khanji254/FYP_2025_Recovery/project_proposal/data/README.txt

DATA FOLDER
===========

Store research-related data and supporting materials:
- Survey data
- Experimental results
- Datasets (CSV, Excel files)
- Raw data files
- Analysis results
- Supporting documents

This folder helps keep your project organized and separate from the LaTeX source files.
