khanji254/FYP_2025_Recovery/interim_report/Files/Appendices.tex

% ============================================================
%  APPENDICES -- N4 Recovery System Final Report
% ============================================================
\appendix

% ------------------------------------------------------------
\section{CAD Drawings with Title Blocks}
\label{app:cad}

The engineering drawings below were produced in SolidWorks and include the
institution title block, part number, material specification, and revision level
required for fabrication. All dimensions are in millimetres.

\begin{figure}[H]
\centering

\caption{18650 battery case cover -- 2D manufacturing drawing with title block}
\label{fig:app_cad_case_cover}
\end{figure}

\begin{figure}[H]
\centering

\caption{18650 battery case body -- 2D manufacturing drawing with title block}
\label{fig:app_cad_case_body}
\end{figure}

\begin{figure}[H]
\centering

\caption{Edge battery support bracket -- 2D manufacturing drawing with title block}
\label{fig:app_cad_edge_batt}
\end{figure}

\begin{figure}[H]
\centering

\caption{Mid battery support bracket -- 2D manufacturing drawing with title block}
\label{fig:app_cad_mid_batt}
\end{figure}

% ------------------------------------------------------------
\section{Flight Computer and Base Station Circuit Design Reference}
\label{app:fc_schematic}

Figures~\ref{fig:app_fc_easyeda} and~\ref{fig:app_bs_easyeda} present the complete
EasyEDA schematics used as design references for PCB layout, component placement,
and trace routing.

\begin{figure}[H]
\centering

\caption{Flight computer EasyEDA schematic with ESP32, XBee, MOSFETs, and
  ADS1115 monitoring circuit.}
\label{fig:app_fc_easyeda}
\end{figure}

\begin{figure}[H]
\centering

\caption{Base station EasyEDA schematic with XBee UART and Bluetooth interface.}
\label{fig:app_bs_easyeda}
\end{figure}

% ------------------------------------------------------------
\section{Project Budget}
\label{app:budget}

\begin{table}[H]
\centering
\caption{Project Budget Breakdown}
\small
\begin{tabular}{@{}p{5.5cm}|c|c|p{2cm}|c@{}}
\toprule
\rowcolor{gray!22}\textbf{Item} & \textbf{Qty} & \textbf{Unit Cost (KES)} & \textbf{Total (KES)} & \textbf{Status} \\ \midrule
ESP32-WROOM-32              & 2  & 1{,}800 & 3{,}600  & Received    \\
XBee-PRO 900HP              & 2  & 4{,}500 & 9{,}000  & Received    \\
4S Lithium-ion batteries (30{,}000\,mAh) & 4 & 500 & 2{,}000 & Received \\
BMS Board (4S)              & 3  & 650     & 1{,}950  & Received    \\
IRLZ44N MOSFET              & 10 & 45      & 450      & Received    \\
Nichrome Wire (10\,m)       & 1  & 500     & 500      & Received    \\
PCB Fabrication (5\,pcs)    & 1  & 4{,}500 & 4{,}500  & Fabricated  \\
PCB Components (R, C, etc.) & 1  & 2{,}000 & 2{,}000  & Partial     \\
PETG Filament (1\,kg)       & 1  & 1{,}800 & 1{,}800  & Received    \\
Crimson Powder (100\,g)     & 1  & 500     & 500      & Pending     \\
Connectors (XT60, JST, etc.)& 1  & 1{,}200 & 1{,}200  & Received    \\
Fasteners and Hardware      & 1  & 800     & 800      & Partial     \\
Miscellaneous               & 1  & 1{,}500 & 1{,}500  & ---         \\ \midrule
\multicolumn{2}{r|}{\textbf{Total Estimated Cost:}} & & \textbf{29{,}800} & --- \\ \bottomrule
\end{tabular}
\end{table}

% ------------------------------------------------------------
\section{Production Plan}
\label{app:production_plan}

Table~\ref{tab:production_plan} presents the Semester~2 production plan for
the N-4 recovery system, covering all fabrication, integration, testing, and
documentation activities from March 2026 to June 2026.

\begin{longtable}{p{1cm}p{4.5cm}p{3cm}p{2.5cm}p{2.5cm}p{1.5cm}}
  \caption{Production Plan --- Final Year Project 2025/2026 (Semester 2: March--June 2026)}
  \label{tab:production_plan}\\
  \toprule
  \textbf{Wk} & \textbf{Tasks / Activities} & \textbf{Materials Required} & \textbf{Special Equipment} & \textbf{Sequential / Concurrent} & \textbf{Status}\\
  \midrule
  \endfirsthead
  \multicolumn{6}{l}{\small\textit{(Table~\ref{tab:production_plan} continued)}}\\
  \toprule
  \textbf{Wk} & \textbf{Tasks / Activities} & \textbf{Materials Required} & \textbf{Special Equipment} & \textbf{Sequential / Concurrent} & \textbf{Status}\\
  \midrule
  \endhead
  \midrule
  \multicolumn{6}{r}{\small\textit{Continued on next page}}\\
  \endfoot
  \bottomrule
  \endlastfoot

  1 &
  \textbf{1.\ FC Circuit Update:} Review FC PCB; source replacement components; re-etch board; re-solder and retest.
  \textbf{2.\ Software --- Battery/Chute Monitoring:} Merge ADS1115 monitoring FreeRTOS task into main FC firmware; confirm 14.9\,V nominal detection; confirm launch-inhibit triggers at $<$14.0\,V. &
  PCB copper clad; HCl + H$_2$O$_2$; solder, flux &
  Laptop + serial monitor; soldering iron; multimeter &
  Circuit update concurrent with SW integration &
  Done\\[4pt]

  2 &
  \textbf{1.\ 3D Printing --- FC Sled Holder:} Slice in Prusa Slicer (PETG, 0.2\,mm layer, 40\% infill); print; test-fit with FC PCB and brass column mounts.
  \textbf{2.\ Base Station Circuit --- Soldering:} Transfer schematic to perfboard; solder all components; test power rails and XBee UART. &
  PETG filament; perfboard; solder, flux; header pins &
  Prusa 3D printer; Prusa Slicer; callipers; soldering iron; multimeter; laptop &
  FC sled print after printer available; base station soldering concurrent &
  Done\\[4pt]

  3 &
  \textbf{1.\ Base Station 3D Print and Housing.}
  \textbf{2.\ Ejection Caps Reprint:} Revised geometry; test-fit nichrome wire and seal.
  \textbf{3.\ Dual Deployment Pop Test:} Safety clearance; load caps; trigger drogue at 70\% PWM; trigger main at 70\% PWM; confirm sequence; iterate if needed. &
  PETG filament; perfboard; solder; black powder; nichrome wire; all-weather container &
  Prusa 3D printer; soldering iron; multimeter; laptop; safety PPE; fire extinguisher &
  Sled print + BS solder concurrent; pop test after cap fit confirmed &
  Done\\[4pt]

  4 &
  \textbf{1.\ Full Avionics Integration --- Bench Test:} Mount FC PCB into PETG sled; connect battery, XBee, and deployment circuit; run FreeRTOS firmware; confirm launch inhibit, continuity detection, and fire logic.
  \textbf{2.\ Base Station Final Assembly.} &
  4S 18650 battery pack; full avionics assembly &
  Laptop + serial monitor; multimeter; soldering iron &
  Bench integration after FC sled + SW done; BS assembly concurrent &
  Done\\[4pt]

  5 &
  \textbf{Dual Deployment Pop Test} (repeat): Safety clearance; trigger drogue at 70\% PWM; trigger main at 70\% PWM; confirm sequence. &
  4S 18650 battery pack; full avionics assembly &
  Laptop + serial monitor; multimeter; soldering iron &
  BS assembly concurrent with bench integration &
  Done\\[4pt]

  6 &
  \textbf{Dual Deployment Pop Test} (verification): Confirm drogue and main fire at 70\% PWM; record results. &
  4S 18650 battery pack; full avionics assembly &
  Laptop + serial monitor; multimeter; soldering iron &
  After all bench integration passes &
  Done\\[4pt]

  7 &
  \textbf{1.\ XBee Range Test (Field):} Set up FC transmitter at ground level; walk base station to 1\,km, 3\,km, 5\,km; record RSSI vs.\ distance via XCTU; validate $\geq$5\,km link margin.
  \textbf{2.\ System Integration Refinement.}
  \textbf{3.\ Report \& Documentation Update.} &
  Both XBee modules; laptops; transport &
  Laptop + XCTU software &
  Range test after full bench integration; documentation concurrent &
  Done\\[4pt]

  8 &
  \textbf{1.\ Drone Test (Simulated Flight):} Mount integrated avionics onto drone; tethered low-altitude flight; verify XBee telemetry active during flight; confirm apogee detection and deployment sequence logic; record all telemetry.
  \textbf{2.\ Pre-Launch System Validation.} &
  Full avionics assembly; drone platform; tether line &
  Laptop + serial monitor; multimeter; drone &
  Drone test after Wk 7 refinement; system validation concurrent &
  Incomplete\\[4pt]

  9 &
  \textbf{1.\ Demonstration:} Prepare demonstration script and safety checklist; conduct supervised ground demonstration; document results.
  \textbf{2.\ Final Report:} Write Chapter 4 (fabrication, test results, discussion); write Chapter 5 (conclusions); compile appendices; supervisor review and submission.
  \textbf{3.\ Final Presentation:} Prepare and rehearse final slide deck; deliver to panel. &
  Full system assembly; test fixtures &
  Laptop; camera/recorder &
  Demonstration after system validation sign-off; final report concurrent; presentation concurrent with report &
  Pending\\
\end{longtable}

% ------------------------------------------------------------
\section{Labelled Assembly Reference Photographs}
\label{app:labeled}

The labelled images below serve as fabrication and assembly references,
identifying all physical components and their spatial relationships.

\begin{figure}[H]
\centering

\caption{Labelled cross-sectional avionics bay with component stacking and clearances}
\label{fig:app_cross_section}
\end{figure}

\begin{figure}[H]
\centering

\caption{Labelled assembly parts list with component identifications}
\label{fig:app_parts_list}
\end{figure}

\begin{figure}[H]
\centering
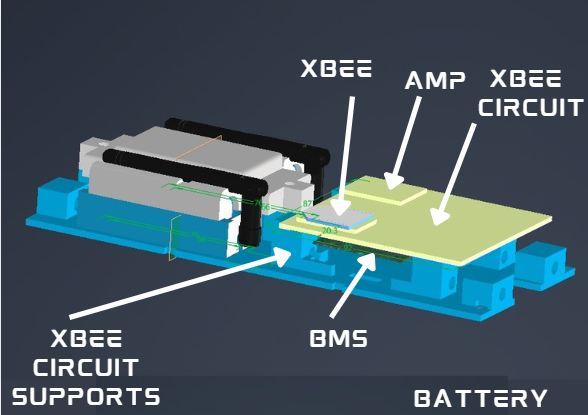
[picture p16: interim_report/images/Labeled/Avionics_Bay.PNG]

\caption{Labelled avionics bay showing battery pack, sled, and connectors}
\label{fig:app_avionics_bay}
\end{figure}

\begin{figure}[H]
\centering

\caption{Labelled flight-computer PCB with integrated electronic components}
\label{fig:app_soldered_fc}
\end{figure}

% ------------------------------------------------------------
\section{Firmware Code Snippets and Repository}
\label{app:firmware}

The N-4 flight software is version-controlled and publicly available at:
\begin{center}
  \url{https://github.com/nakujaproject/N4-Flight-Software} \cite{n4_github}
\end{center}

\subsection*{F.1\quad XBee UART Initialisation Task}
\begin{lstlisting}[language=C, caption={XBee UART initialisation and AT-command configuration (excerpt from \texttt{xbee\_task.c}) \cite{n4_github}}]
void xbee_init_task(void *pvParameters) {
    uart_config_t uart_cfg = {
        .baud_rate  = 115200,
        .data_bits  = UART_DATA_8_BITS,
        .parity     = UART_PARITY_DISABLE,
        .stop_bits  = UART_STOP_BITS_1,
        .flow_ctrl  = UART_HW_FLOWCTRL_DISABLE,
    };
    uart_param_config(UART_NUM_2, &uart_cfg);
    uart_set_pin(UART_NUM_2, TX2_PIN, RX2_PIN,
                 UART_PIN_NO_CHANGE, UART_PIN_NO_CHANGE);
    uart_driver_install(UART_NUM_2, BUF_SIZE, 0, 0, NULL, 0);

    /* Enter AT command mode and set destination address */
    xbee_send_at("+++");          vTaskDelay(pdMS_TO_TICKS(1200));
    xbee_send_at("ATDH 0013A200"); vTaskDelay(pdMS_TO_TICKS(100));
    xbee_send_at("ATDL 41B5C2F3"); vTaskDelay(pdMS_TO_TICKS(100));
    xbee_send_at("ATWR");         vTaskDelay(pdMS_TO_TICKS(200));
    xbee_send_at("ATCN");         /* Exit command mode */
    vTaskDelete(NULL);
}
\end{lstlisting}

\subsection*{F.2\quad ADS1115 Battery Monitoring Task}
\begin{lstlisting}[language=C, caption={ADS1115 I\textsuperscript{2}C voltage monitoring and launch-inhibit logic (excerpt from \texttt{power\_monitor.c}) \cite{n4_github}}]
void power_monitor_task(void *pvParameters) {
    ads1115_t ads = ads1115_init(I2C_NUM_0, ADS1115_ADDR_GND);
    while (1) {
        int16_t raw = ads1115_read_channel(&ads, ADS1115_MUX_AIN0);
        /* Reconstruct: Vbus = raw * (4.096/32768) * (R1+R2)/R2 */
        float v_sense = raw * (4.096f / 32768.0f);
        float v_bus   = v_sense * ((47000.0f + 10000.0f) / 10000.0f);

        if (v_bus < VBUS_MIN_V) {
            launch_inhibit_set(INHIBIT_LOW_BATT);
        } else {
            launch_inhibit_clear(INHIBIT_LOW_BATT);
        }
        telemetry_packet.battery_mv = (uint16_t)(v_bus * 1000.0f);
        vTaskDelay(pdMS_TO_TICKS(500));
    }
}
\end{lstlisting}

\subsection*{F.3\quad PWM Deployment Task}
\begin{lstlisting}[language=C, caption={IRLZ44N MOSFET PWM deployment channel control (excerpt from \texttt{pyro\_task.c}) \cite{n4_github}}]
#define LEDC_CHANNEL_DROGUE  LEDC_CHANNEL_0
#define LEDC_CHANNEL_MAIN    LEDC_CHANNEL_1
#define PWM_FREQ_HZ          1000
#define PWM_DUTY_PCT         70   /* 70% validated duty cycle */

void pyro_task(void *pvParameters) {
    ledc_timer_config_t timer = {
        .speed_mode      = LEDC_LOW_SPEED_MODE,
        .duty_resolution = LEDC_TIMER_8_BIT,
        .timer_num       = LEDC_TIMER_0,
        .freq_hz         = PWM_FREQ_HZ,
    };
    ledc_timer_config(&timer);
    uint32_t duty = (PWM_DUTY_PCT * 255) / 100;  /* = 178 */
    while (1) {
        EventBits_t ev = xEventGroupWaitBits(deploy_event_group,
            DEPLOY_DROGUE_BIT | DEPLOY_MAIN_BIT,
            pdFALSE, pdFALSE, portMAX_DELAY);
        if (ev & DEPLOY_DROGUE_BIT)
            ledc_set_duty_and_update(LEDC_LOW_SPEED_MODE,
                                     LEDC_CHANNEL_DROGUE, duty, 0);
        if (ev & DEPLOY_MAIN_BIT)
            ledc_set_duty_and_update(LEDC_LOW_SPEED_MODE,
                                     LEDC_CHANNEL_MAIN, duty, 0);
        vTaskDelay(pdMS_TO_TICKS(3000));  /* fire window */
        ledc_set_duty_and_update(LEDC_LOW_SPEED_MODE,
                                 LEDC_CHANNEL_DROGUE, 0, 0);
        ledc_set_duty_and_update(LEDC_LOW_SPEED_MODE,
                                 LEDC_CHANNEL_MAIN, 0, 0);
    }
}
\end{lstlisting}

\subsection*{F.4\quad Finite-State Machine Transition Logic}
\begin{lstlisting}[language=C, caption={FSM state transition logic for flight phase detection (excerpt from \texttt{state\_machine.c}) \cite{n4_github}}]
typedef enum {
    STATE_PAD, STATE_ARMED, STATE_BOOST,
    STATE_APOGEE, STATE_DROGUE, STATE_MAIN, STATE_LANDED
} flight_state_t;

flight_state_t fsm_update(flight_state_t current, sensor_data_t *s) {
    switch (current) {
        case STATE_PAD:
            return (s->armed_flag) ? STATE_ARMED : STATE_PAD;
        case STATE_ARMED:
            return (s->accel_z > LAUNCH_THRESH_G) ? STATE_BOOST
                                                   : STATE_ARMED;
        case STATE_BOOST:
            return (s->accel_z < BURNOUT_THRESH_G) ? STATE_APOGEE
                                                    : STATE_BOOST;
        case STATE_APOGEE:
            xEventGroupSetBits(deploy_event_group, DEPLOY_DROGUE_BIT);
            return STATE_DROGUE;
        case STATE_DROGUE:
            return (s->altitude_m < MAIN_DEPLOY_ALT_M) ? STATE_MAIN
                                                        : STATE_DROGUE;
        case STATE_MAIN:
            xEventGroupSetBits(deploy_event_group, DEPLOY_MAIN_BIT);
            return STATE_LANDED;
        default: return STATE_LANDED;
    }
}
\end{lstlisting}

\subsection*{F.5\quad Supporting Figures and Diagrams}

\begin{figure}[htbp]
\centering
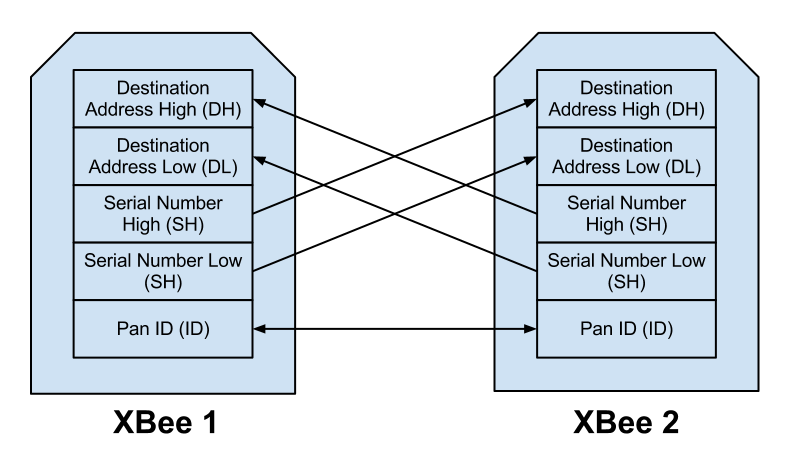
[picture p17: interim_report/images/XBeeDiagram.png]

\caption{N-4 XBee telemetry architecture for rocket-to-ground communication \cite{n4_xbee_integration,n4_comm_architecture}}
\label{fig:app_intro_xbee_architecture}
\end{figure}

\begin{figure}[htbp]
\centering
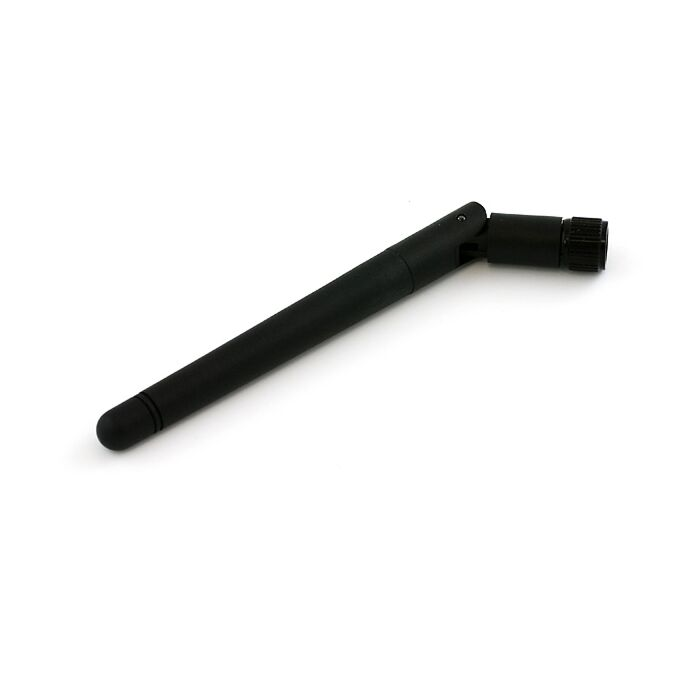
[picture p18: interim_report/images/duck_antenna.jpg]

\caption{900\,MHz duck antenna used in the N-4 telemetry configuration}
\label{fig:app_duck_antenna}
\end{figure}

\begin{figure}[htbp]
\centering
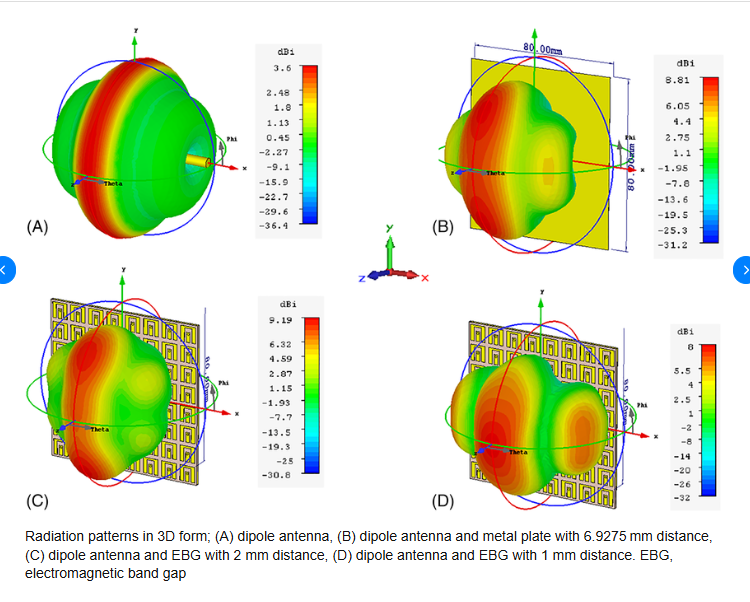
[picture p19: interim_report/images/donut_pattern.png]

\caption{Dipole radiation ``donut'' pattern illustrating nulls along the antenna axis}
\label{fig:app_donut_pattern}
\end{figure}

\begin{figure}[htbp]
\centering
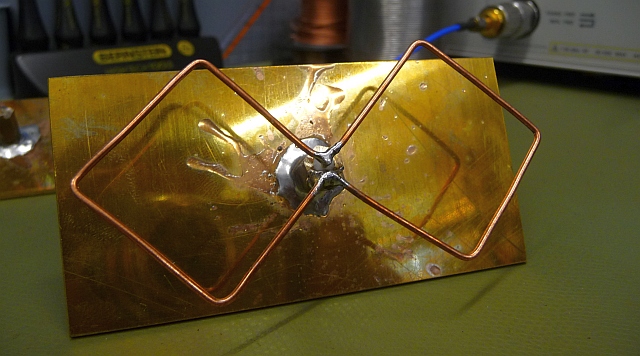
[picture p20: interim_report/images/BiQuadPic.jpg]

\caption{900\,MHz Bi-Quad ground-station antenna option}
\label{fig:app_biquad}
\end{figure}

\begin{figure}[htbp]
\centering
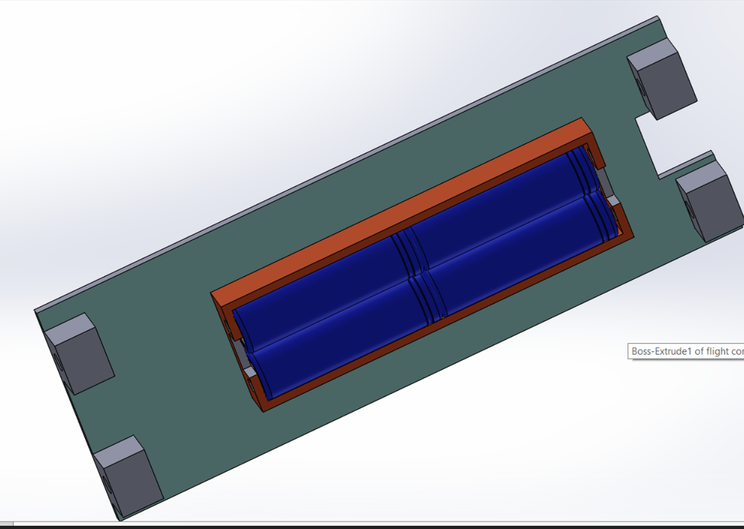
[picture p21: interim_report/images/Old_FC_Holder.png]

\caption{Old flight-computer holder failure after pop tests}
\label{fig:app_old_fc_holder_design}
\end{figure}

\begin{figure}[htbp]
\centering

\caption{Base-station interconnect layout (Fritzing schematic)}
\label{fig:app_fritzing_base}
\end{figure}

\begin{figure}[htbp]
\centering

\caption{Rocket XBee extension wiring layout (Fritzing schematic)}
\label{fig:app_fritzing_rocket}
\end{figure}

\begin{figure}[htbp]
\centering
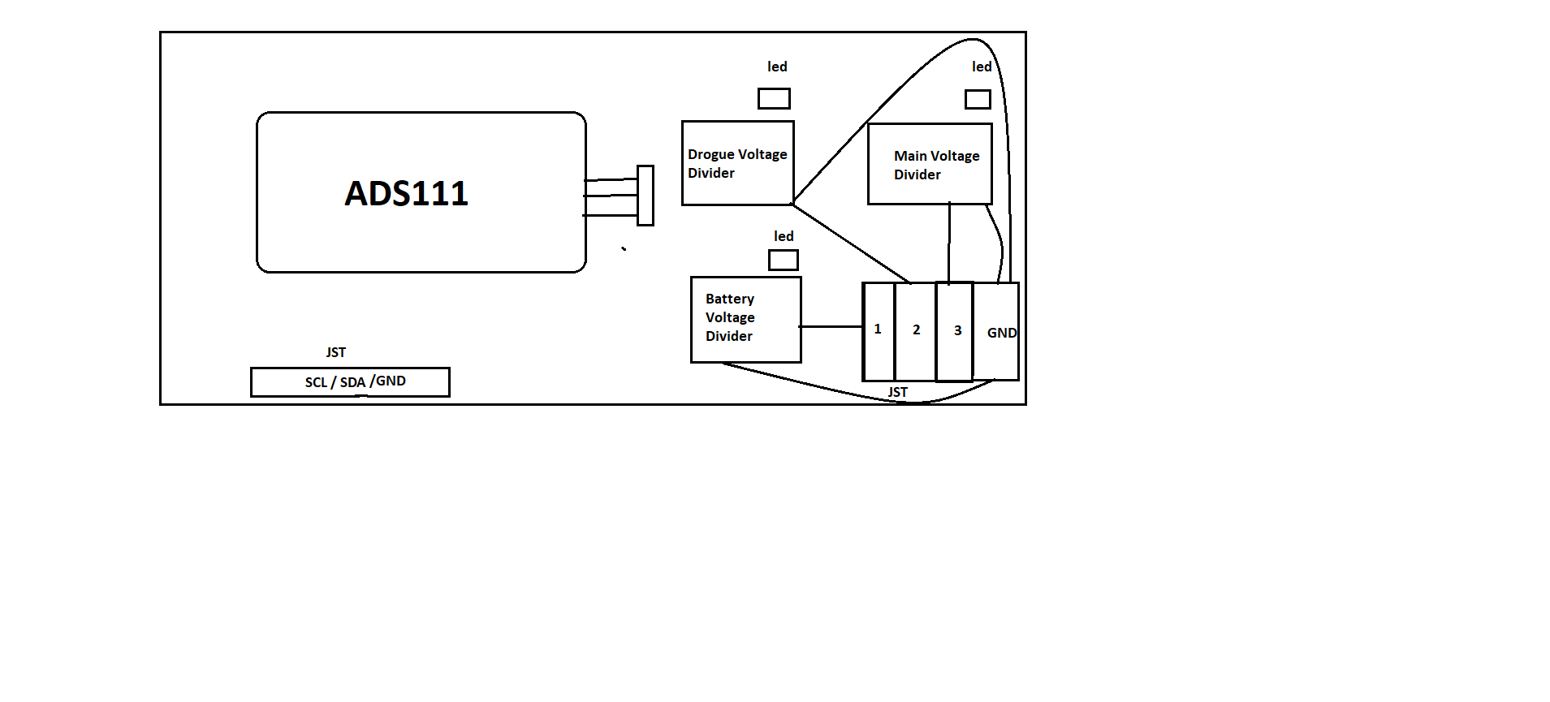
[picture p22: interim_report/images/Power_Monitoring_Design_Concept.png]

\caption{Power monitoring hardware concept with ADS1115 divider and launch inhibit path}
\label{fig:app_sw_power_concept}
\end{figure}

\begin{figure}[htbp]
\centering
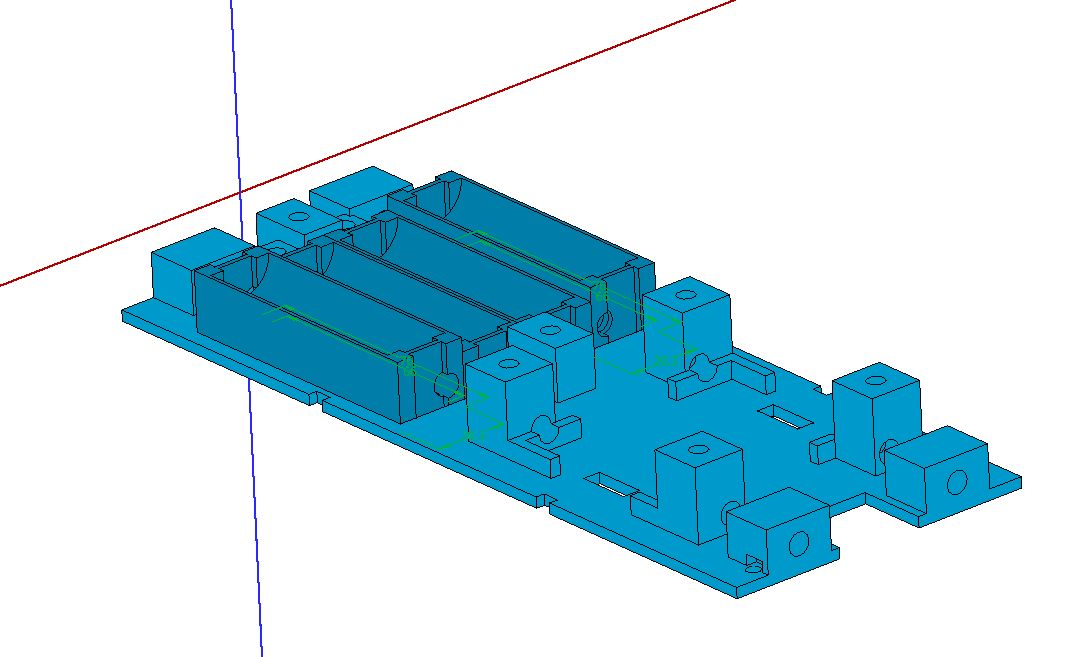
[picture p23: interim_report/images/mechanical/FC_Holder Cad.jpeg]
}
\caption{Flight-computer holder sled 3D CAD model}
\label{fig:app_res_fc_holder_3d}
\end{figure}

\begin{figure}[htbp]
\centering
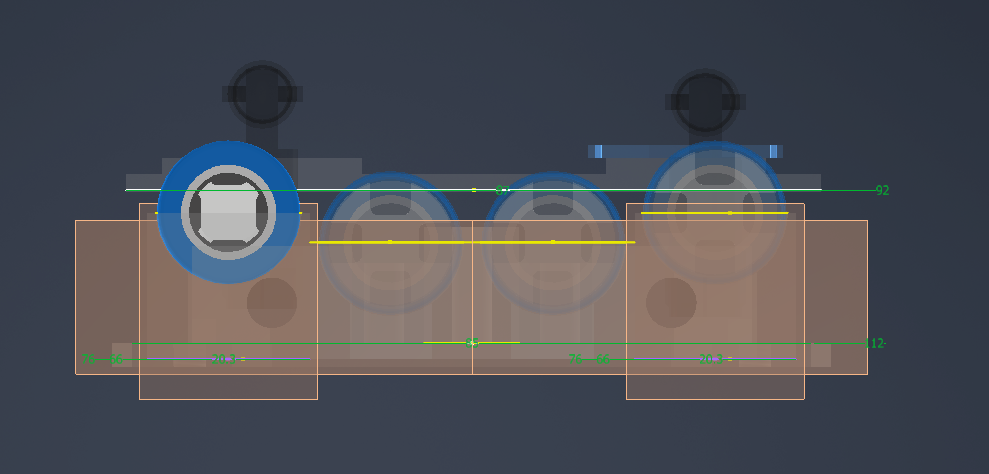
[picture p24: interim_report/images/mechanical/Threaded_Rod_Integration_showing raised battery cells to give way to threaded rods.PNG]
}
\caption{Threaded-rod integration showing raised battery cell clearance}
\label{fig:app_res_rod_integration}
\end{figure}

\begin{figure}[htbp]
\centering
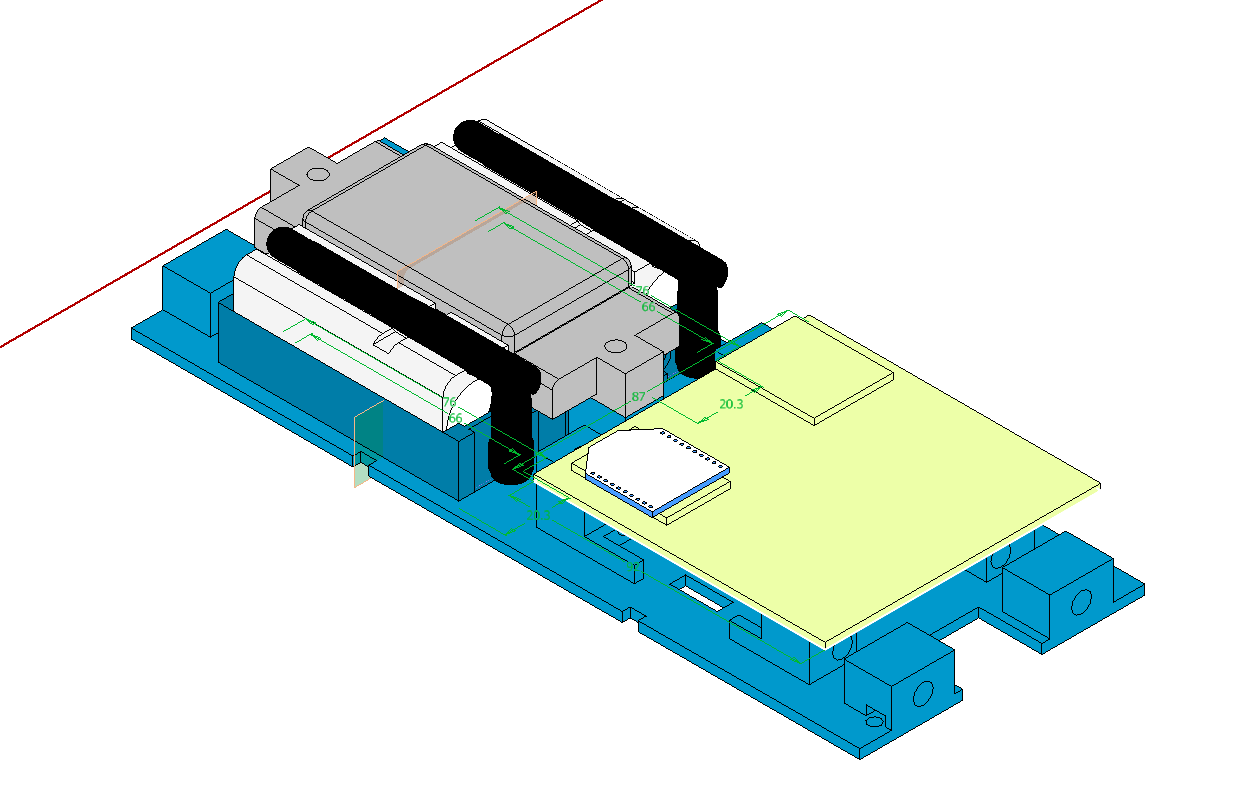
[picture p25: interim_report/images/mechanical/Avionics assembly.jpeg]
}
\caption{Avionics bay assembly showing battery, holder, and electronics integration}
\label{fig:app_res_avionics_assembly}
\end{figure}

% ============================================================
%  END OF APPENDICES
% ============================================================
