khanji254/FYP_2025_Recovery/interim_report/Files/Chapter2_LiteratureReview.tex

\section{Literature Review}
\label{sec:review}

\subsection{Recovery Systems in Student Rocketry}

Recovery systems preserve flight hardware and flight data and are therefore mission-critical in high-power student rocketry \cite{sutton_rocket, parachute_deployment}. A common practice is dual deployment: a drogue parachute at apogee for stability and reduced drift, then a main parachute at lower altitude for lower landing energy. Literature consistently shows that this staged strategy improves recovery reliability compared with single-deployment approaches in high-altitude missions \cite{parachute_deployment}.

The Nakuja Project's own mission progression illustrates this trend directly. N-1 (2021) and N-2 (2022) used basic single-deployment parachute ejection. N-3 (January 2024) introduced on-board flight logging and improved parachute reliability but retained a single-deployment architecture. N-3.5 (May 2024) advanced to a piston-based pyrotechnic ejection system but still deployed only a main parachute, with telemetry relying on a WiFi/MQTT link via a Ubiquiti NanoStation \cite{nakuja_website, n3p5_recovery_report}. The N-3.5 post-flight analysis documented thermal damage to the charge holder, nichrome wire burnout after repeated ground pop tests, and effective telemetry range constrained to WiFi coverage---all of which define requirements for the N-4 system \cite{n3p5_recovery_report, n4_poptest_internal}. Figures~\ref{fig:dual_deploy} and~\ref{fig:dual_deploy_flight} show the N-3 dual-deployment context.

\begin{figure}[htbp]
\centering

\caption{Nakuja N3 rocket with dual-deployment recovery configuration \cite{nakuja_website}}
\label{fig:dual_deploy}
\end{figure}

\begin{figure}[htbp]
\centering

\caption{Nakuja dual-deployment flight during ascent \cite{nakuja_website}}
\label{fig:dual_deploy_flight}
\end{figure}

\textbf{Gap 1 --- Dual-deployment adoption:} Prior Nakuja missions did not implement staged dual deployment. N-3.5 documented that single-deployment piston ejection provides no redundancy at apogee, and that the absence of a drogue parachute increases drift and descent-rate uncertainty at high altitudes. No mission-specific data linking charge mass, ejection effectiveness, and dual-deployment sequencing for the N-4 airframe geometry exists in the Nakuja record.

\subsection{Telemetry Systems Analysis}

Table~\ref{tab:telemetry} compares telemetry options reported in student rocketry and related field systems.

\begin{table}[htbp]
\centering
\caption{Telemetry System Comparison for Student Rocketry Applications}
\label{tab:telemetry}
\small
\renewcommand{\arraystretch}{1.1}
\begin{tabular}{@{}p{2.1cm}|p{1.8cm}|p{1.8cm}|p{2.8cm}|p{2.9cm}@{}}
\toprule
\rowcolor{gray!22}\textbf{Technology} & \textbf{Range} & \textbf{Data Cap} & \textbf{Strength} & \textbf{Limitation} \\ \midrule
433 MHz RF & 5--10 km & Very low & Simple, long range & No ACKs \\
Beacon & 4 km/0.8 km & Low--Med & Simple & Range drops \\
LoRa SX1278 & 2--15 km & Low & Low power & Low BW \\
XBee 2.4 GHz & $<$2 km & Medium & Easy integration & Short range \\
\textbf{XBee-PRO 900HP} & \textbf{5--28 km} & \textbf{Med--High} & \textbf{Reliable, ACKs} & \textbf{Higher power} \\
ESP-NOW & $<$1 km & Medium & Low latency & Not long-range \\
WiFi/MQTT & $<$0.8 km & High & Easy integration & Network dep.\ \\
Cellular LTE & Global & High & Unlimited range & Network dep.\ \\ \bottomrule
\end{tabular}
\end{table}

The N-3.5 system used WiFi/MQTT, which provides high data bandwidth but is limited to sub-kilometre range in open-field conditions without network infrastructure \cite{n3p5_recovery_report}. Range tests conducted during N-3.5 pre-flight preparations confirmed RSSI degradation beyond the NanoStation's effective beam, with intermittent packet loss at distances consistent with the N-4 expected recovery footprint \cite{n3p5_recovery_report}. Comparative studies show a tradeoff between range, bandwidth, protocol reliability, and implementation complexity \cite{telemetry_reliability}. 900~MHz-class links are favoured for long-range recovery because of better propagation under non-ideal field conditions compared with higher-frequency links \cite{xbee_manual}. Figures~\ref{fig:xbee_module} and~\ref{fig:rssi_decay} summarise representative hardware and field RSSI behaviour.

\begin{figure}[htbp]
\centering

\caption{XBee radio module used as the long-range telemetry transceiver platform \cite{xbee_manual}}
\label{fig:xbee_module}
\end{figure}

\begin{figure}[htbp]
\centering
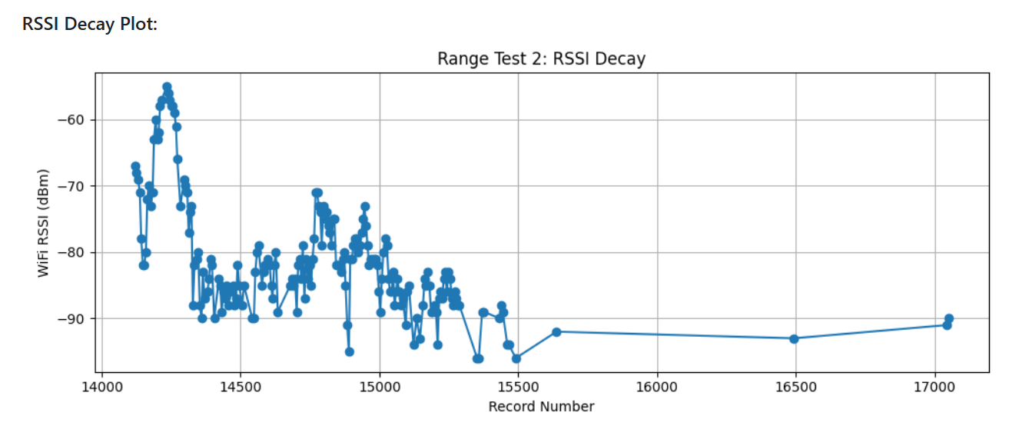
[picture p26: interim_report/images/Beacon_RSSI_Decay_Plot.PNG]

\caption{Beacon RSSI decay analysis showing signal degradation with distance and altitude. Project data.}
\label{fig:rssi_decay}
\end{figure}

\textbf{Gap 2 --- Telemetry range:} The N-3.5 WiFi/MQTT architecture achieved sub-kilometre effective range, which is insufficient for the N-4 competition mission requiring reliable data recovery beyond 5~km. No Nakuja mission has yet validated a 900~MHz long-range link (XBee-PRO 900HP) for rocket telemetry.

\subsubsection{Antenna Options in Recovery Telemetry}

Literature and field practice identify several antenna families for rocket telemetry ground/air links: dipole and whip (omnidirectional, low complexity), patch and Bi-Quad (moderate gain, directional), and Yagi arrays (higher gain, tighter pointing requirement) \cite{pozar_microwave, arrl_antenna_book}. For dynamic flight profiles, antenna pattern behaviour and polarisation stability are as important as nominal gain. See Appendix~\ref{app:firmware} for representative antenna hardware (Figures~\ref{fig:app_duck_antenna} and~\ref{fig:app_biquad}) and dipole radiation pattern (Figure~\ref{fig:app_donut_pattern}).

Published antenna fundamentals highlight two recurring operational issues in flight telemetry links: axis nulls in dipole-like radiation patterns and polarisation mismatch during vehicle attitude change \cite{arrl_antenna_book}. These effects can dominate link performance even when radio modules have adequate power margins.

\subsubsection{Comparative Review of XBee Antenna Form Factors}
The selection of an appropriate antenna form factor for the airborne XBee-PRO 900HP transceiver module is governed by mechanical volume constraints inside the avionics bay, structural shielding from the airframe, and RF radiation patterns \cite{xbee_manual, arrl_antenna_book}. Digi International offers four primary standard antenna configurations for the 900HP modules, outlined below:

\begin{enumerate}
    \item \textbf{Wire/Whip Antenna:} Consists of a pre-cut quarter-wave omnidirectional wire extending directly from the module PCB. It provides an isotropic, toroidal radiation pattern with a nominal gain of approximately 1.5 dBi to 2.1 dBi. Mechanically, it is lightweight but susceptible to bending or structural interference within tight airframe compartments, which can severely alter its matching impedance and resonance frequency \cite{xbee_manual}.
    
    \item \textbf{U.FL RF Connector:} A ultra-miniature surface-mount coaxial connector that allows an external coaxial pigtail cable to route the RF signal to an airframe-mounted external antenna (such as a ruggedized dipole or patch). This setup allows the transceiver to remain isolated inside a metallic or carbon shielding bay while routing radiation externally, minimizing insertion loss if high-quality, low-loss cables are used \cite{pozar_microwave}.
    
    \item \textbf{RPSMA Connector:} A reverse-polarity SMA female connector bulkhead integrated onto the module edge. It allows direct, threaded mechanical coupling of heavy-duty, external rubber-duck dipole antennas. While it offers excellent mechanical robustness and consistent impedance characteristics ($50\,\Omega$), its mass and physical volume are large, creating localized structural loading on 3D-printed avionics sleds during high-G launch acceleration \cite{high_g_electronics, xbee_manual}.
    
    \item \textbf{Chip Antenna:} Utilizes a high-permittivity surface-mount ceramic dielectric chip layout on the PCB. It offers the most compact mechanical footprint and zero vulnerability to shock or vibration. However, it exhibits a highly constrained, non-uniform radiation pattern with lower gain (typically $< 0\,\mathrm{dBi}$), rendering it highly sensitive to the surrounding PCB ground plane layout and insufficient for long-range, multi-kilometer telemetry applications \cite{pozar_microwave, xbee_manual}.
\end{enumerate}

\textbf{Gap 3 --- Antenna selection guidance:} Limited evidence-based antenna selection and orientation guidance exists for student recovery missions with dynamic vehicle attitude. No Nakuja documentation quantifies the performance difference between omnidirectional and directional ground antennas under real recovery descent scenarios, nor addresses polarisation mismatch during spin or tumble.

\subsection{Inter-Integrated Circuit (I2C) Communication Protocols}
Modern modular avionics bays rely heavily on synchronous, short-distance multi-master/multi-slave serial buses to interface master flight controllers with specialized telemetry nodes, environmental sensors, and external analog-to-digital converters \cite{esp32_datasheet, ads1115_datasheet}. The Inter-Integrated Circuit (I2C) protocol utilizes two bidirectional open-drain lines pulled up to the system logic voltage rail ($V_{DD}$): the Serial Data line (SDA) and the Serial Clock line (SCL) \cite{voltage_divider_theory}. 

In the N-4 recovery framework, the I2C bus acts as the primary hardware path linking the master ESP32 microcontroller to the 16-bit ADS1115 diagnostic ADC. Because I2C uses open-drain architecture, devices can only pull the lines down to a logic low state ($V_{SS}$); returning lines to a logic high state relies completely on external pull-up resistors ($R_P$). The selection of $R_P$ dictates a direct engineering tradeoff between bus speed, power consumption, and signal rise-time constraints, governed by total bus capacitance ($C_B$), which is a function of trace lengths, connector footprints, and pin capacitances \cite{voltage_divider_theory}. The maximum allowable rise time ($t_r$) for Standard Mode ($100\,\mathrm{kbps}$) is $1000\,\mathrm{ns}$, and for Fast Mode ($400\,\mathrm{kbps}$) is $3000\,\mathrm{ns}$, bounding the resistor limits via:
\begin{equation}
R_{P(\text{max})} = \frac{t_r}{0.8473 \cdot C_B}
\end{equation}
Conversely, the minimum resistor value is bounded by the maximum sink current capability of the driving microcontrollers (typically $3\,\mathrm{mA}$) to prevent logic-low voltage thresholds ($V_{OL}$) from creeping above acceptable noise margins ($0.4\,\mathrm{V}$), expressed as:
\begin{equation}
R_{P(\text{max})} = \frac{V_{DD} - V_{OL}}{I_{OL}}
\end{equation}

In rocket environments, high-G mechanical vibrations and thermal transitions can induce minor variations in bus capacitance and pull-up impedance, causing signal distortion, clock-stretching errors, or total I2C bus locks (where a device holds SDA low indefinitely) \cite{high_g_electronics, freertos_manual}. In a critical recovery architecture, I2C firmware implementations require non-blocking timeouts and hardware reset routines to prevent a bus lock from freezing flight-critical parachute deployment tasks.

\subsection{Pyrotechnic Deployment and Ignition Control}

Black-powder and crimson-powder deployment remain common separation/ejection methods in student rocketry, but reliability depends on predictable charge energy, containment, venting, and material thermal tolerance \cite{sutton_rocket, black_powder_characterization}. Literature distinguishes between commercial e-match igniters and custom nichrome approaches, with tradeoffs in repeatability, cost, and field test convenience \cite{nichrome_ignition}. Figures~\ref{fig:excessive_pop}--\ref{fig:cut_nichrome_wire} show recurring deployment and igniter issues documented in Nakuja N-3.5 pop tests.

\begin{figure}[htbp]
\centering
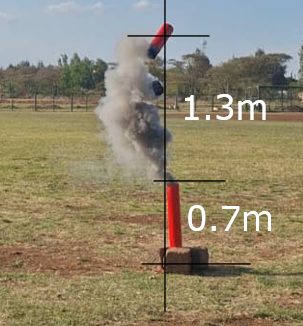
[picture p27: interim_report/images/The Crimson Powder Problem_Excessive_Pop.PNG]

\caption{Excessive crimson powder deployment during N-3.5 field pop test \cite{n4_poptest_internal}}
\label{fig:excessive_pop}
\end{figure}

\begin{figure}[htbp]
\centering

\caption{Thermal damage on charge holder after N-3.5 pop test \cite{n4_poptest_internal}}
\label{fig:thermal_damage}
\end{figure}

\begin{figure}[htbp]
\centering
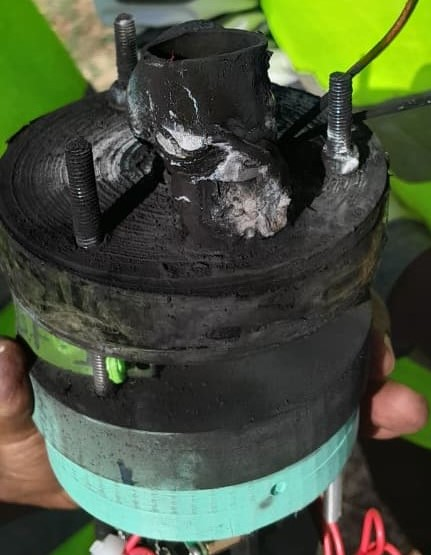
[picture p28: interim_report/images/Post_PopTest_Charring_And_Leak_Image.jpeg]

\caption{Post-deployment charring from containment leakage during N-3.5 ground test \cite{n4_poptest_internal}}
\label{fig:post_test_charring}
\end{figure}

\begin{figure}[htbp]
\centering

\caption{Cut nichrome wire after repeated pop tests, confirming single-use behaviour \cite{n4_poptest_internal}}
\label{fig:cut_nichrome_wire}
\end{figure}

The N-3.5 recovery report confirms that nichrome wire was consumed in each firing, requiring replacement before every test iteration \cite{n3p5_recovery_report}. For resistive igniters, literature reports that uncontrolled energy delivery causes premature wire failure or inconsistent ignition, while controlled-energy strategies---including PWM duty-cycle regulation---improve repeatability \cite{nichrome_ignition, pwm_heating, barr_pwm}.

Combustion literature shows that short-duration pyrotechnic events are modelled as near-adiabatic transients for first-order chamber estimates, making thermodynamic pressure-volume curves essential for validating containment assumptions and charge-holder thermal boundaries \cite{turns_combustion, glassman_combustion}. Figure~\ref{fig:adiabatic_curve} illustrates this relationship.

\begin{figure}[htbp]
\centering
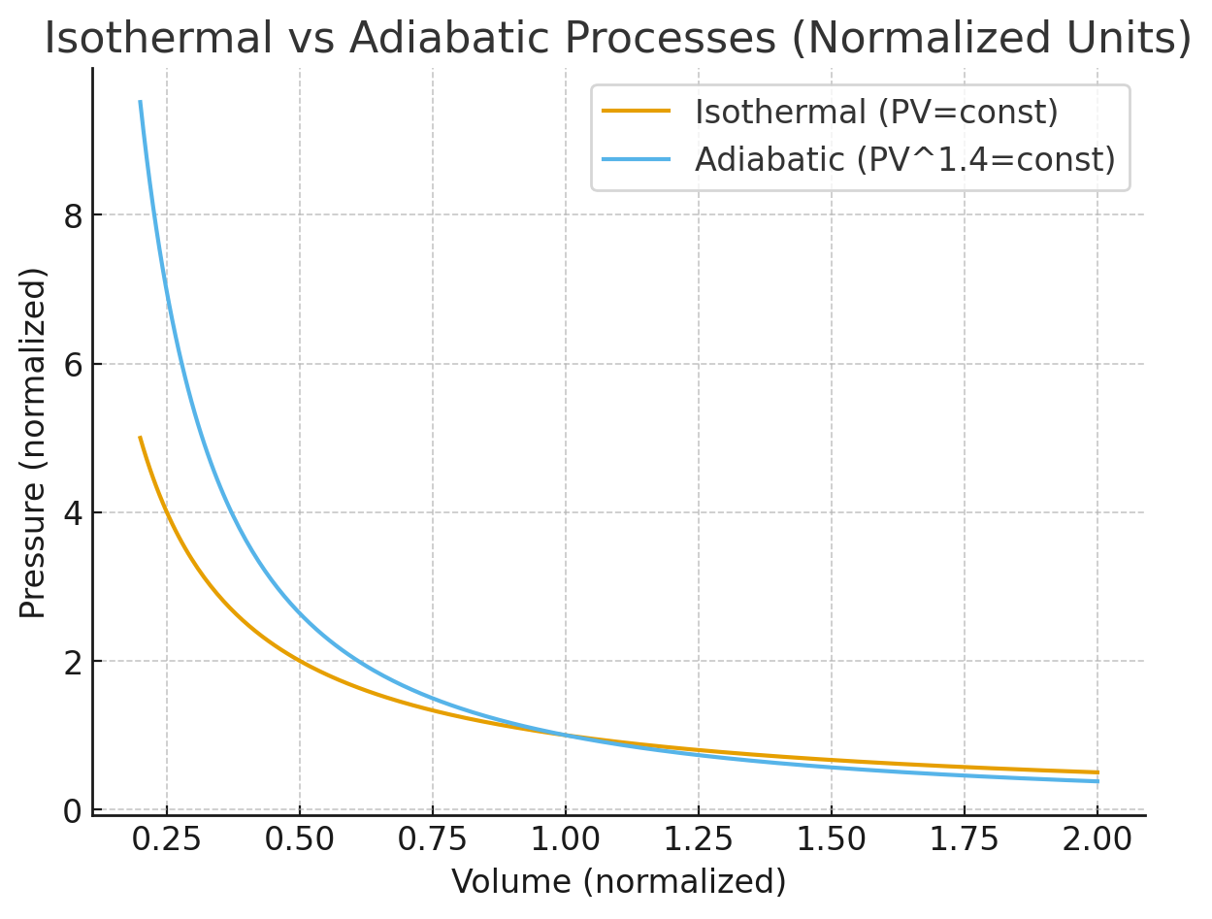
[picture p29: interim_report/images/adiabatic_curve.png]

\caption{Isothermal and adiabatic pressure-volume comparison \cite{turns_combustion, glassman_combustion}}
\label{fig:adiabatic_curve}
\end{figure}

\textbf{Gap 4 --- Pyrotechnic predictability:} Limited mission-specific data links crimson powder charge mass, chamber pressure behaviour, and repeatable ejection outcomes for the N-4 airframe geometry. No standardised chamber-seal verification procedure exists in the Nakuja record before live deployment tests.

\textbf{Gap 5 --- Ignition repeatability:} Limited comparative data exists on e-match versus nichrome-based systems under repeated pre-flight ground-test cycles. N-3.5 confirmed nichrome single-use behaviour but did not quantify ignition-energy thresholds or controlled-duty-cycle strategies.

\textbf{Gap 6 --- Containment validation:} Limited use of thermochemical adiabatic-curve evidence to justify contained explosion-cap deployment designs in Nakuja workflows. N-3.5 recorded a pressure transient consistent with 188~kPa during pop tests, but no charge holder was designed or validated against a derived burst/yield criterion \cite{n4_poptest_internal}.

\subsection{Power and Structural Integrity in High-G Flight}

Avionics for high-power rockets must survive sustained acceleration and impulsive shock during separation and deployment. Reported failure modes include connector intermittency, battery disconnect, solder fatigue, and sensor-noise coupling \cite{high_g_electronics, vibration_isolation}. Launch-load analysis for amateur rockets is framed from thrust-generated net force, where motor characteristics directly set structural loading during boost \cite{nakka_thrust, nakka_eqns}.

The N-3.5 avionics bay transitioned from a wood-and-zip-tie N-3 design to a laser-cut perspex enclosure with 3D-printed battery supports \cite{n3p5_recovery_report}. This iteration improved compactness and component retention but was designed for the N-3.5 aluminium airframe with a 78.6~mm outer diameter; it does not fit the N-4 fiberglass airframe with a 109~mm outer diameter. Post-pop-test records documented pressure transients on the order of 188~kPa, reinforcing the need for mechanically robust holder designs and distributed fastening during deployment events \cite{n4_poptest_internal}. Figure~\ref{fig:avionics_bay} shows the N-4 integrated avionics bay arrangement.

\begin{figure}[htbp]
\centering
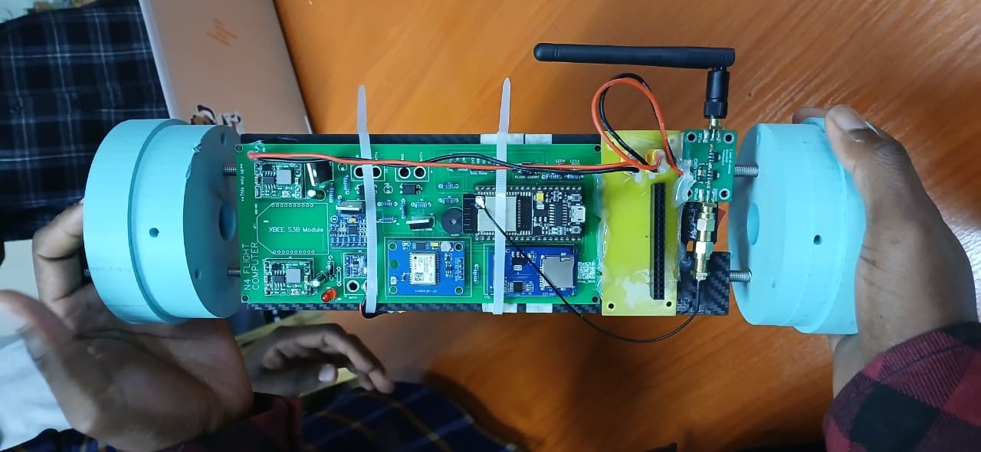
[picture p30: interim_report/images/Assembled_Avionics_Bay.jpeg]

\caption{Assembled N-4 avionics bay with integrated battery retention and vibration isolation. Project fabrication.}
\label{fig:avionics_bay}
\end{figure}

\subsubsection{PETG for Flight-Structure Components}

Recent additive-manufacturing studies show PETG as a practical compromise for functional aerospace support parts because it offers improved ductility and impact tolerance relative to more brittle alternatives while retaining practical printability \cite{petg_mechanical, petg_review_2020, petg_fdm_impact, petg_process_structure}. Structural integrity is strongly influenced by print orientation, infill strategy, and inter-layer bonding quality. This implies that material choice alone is insufficient; process quality and test validation are essential for reliable flight-support structures.

Battery-pack integration for common 18650-class cells contributes non-negligible mass at the module level, which increases inertial loading during launch and shock events and must therefore be included in holder-force calculations and mounting strategy design \cite{panasonic_cgr18650da_datasheet}.

\subsubsection{Flight-Computer Holder Design Progression}

Literature and project practice emphasise iterative fixture refinement for avionics survivability in high-shock environments \cite{high_g_electronics, vibration_isolation}. The N-3.5 perspex bay offered improved retention over the N-3 wood design, but the shift to N-4's larger-diameter fiberglass airframe and 18650-based battery pack requires a full redesign. See Appendix~\ref{app:firmware} (Figure~\ref{fig:app_old_fc_holder_design}) for the earlier holder failure observed after pop tests, which confirms the need for shock-tolerant fixture geometry.

\textbf{Gap 7 --- Structural verification:} PETG support structures and avionics sleds are commonly used in student rocketry but often lack launch and deployment shock validation for mission-specific loads. No validated PETG avionics holder exists for the N-4 109~mm airframe, 18650 battery configuration, or the 188~kPa pop-test pressure environment.

\subsection{Pre-flight Monitoring and System Diagnostics}

The N-3.5 flight computer included a buzzer that confirmed ESP32 WiFi connectivity and sensor detection at startup, but no real-time battery voltage or igniter-continuity telemetry was transmitted to the ground station \cite{n3p5_recovery_report}. Absence of such monitoring means operators cannot verify battery state-of-charge or continuity of the nichrome-wire circuit before committing to launch, introducing a direct path to deployment failure.

Industry guidance for high-power rocketry consistently recommends pre-launch continuity verification and launch-inhibit logic tied to power supply health as mandatory safety gates \cite{high_g_electronics}. The N-3.5 documentation acknowledges this gap in its recommendations section and explicitly calls for addition of battery voltage monitoring in the next flight computer iteration \cite{n3p5_recovery_report}.

\textbf{Gap 8 --- Pre-flight system monitoring:} No Nakuja mission has implemented real-time ground-visible battery voltage or igniter-continuity telemetry with automated launch-inhibit logic. This gap is explicitly identified in the N-3.5 recovery report recommendations.

\subsection{Summary of Research Gaps}

Table~\ref{tab:gaps} consolidates the eight gaps identified across the preceding subsections. Each gap is linked to the literature or project evidence from which it was derived and to the specific N-4 objective it motivates.

\begin{table}[htbp]
\centering
\caption{Summary of Research Gaps Identified from Literature and Nakuja Mission Evidence}
\label{tab:gaps}
\small
\renewcommand{\arraystretch}{1.2}
\begin{tabular}{@{}p{0.4cm}|p{3.4cm}|p{4.2cm}|p{3.6cm}@{}}
\toprule
\rowcolor{gray!22}\textbf{\#} & \textbf{Gap} & \textbf{Evidence Base} & \textbf{N-4 Objective Addressed} \\ \midrule
1 & Dual-deployment adoption & N-3.5 used single-deployment piston; no dual-stage data for Nakuja airframes \cite{n3p5_recovery_report} & Specific Objective 1 (dual deployment) \\ \hline
2 & Telemetry range & N-3.5 WiFi/MQTT limited to sub-km range; insufficient for 5~km+ competition recovery \cite{n3p5_recovery_report} & Specific Objective 1 (XBee 900HP link) \\ \hline
3 & Antenna selection guidance & No evidence-based antenna selection for dynamic vehicle attitude in Nakuja missions \cite{arrl_antenna_book} & Specific Objective 1 (antenna design) \\ \hline
4 & Pyrotechnic predictability & No mission-specific charge-mass vs.\ ejection-effectiveness data for N-4 geometry \cite{n4_poptest_internal} & Specific Objective 2 (controlled ignition) \\ \hline
5 & Ignition repeatability & N-3.5 confirmed nichrome single-use burnout; no controlled-duty-cycle evaluation \cite{n3p5_recovery_report, nichrome_ignition} & Specific Objective 2 (PWM ignition) \\ \hline
6 & Containment validation & No burst/yield analysis for charge holder; 188~kPa transient undocumented against material limit \cite{n4_poptest_internal} & Specific Objective 2 (holder design) \\ \hline
7 & Structural verification & No shock-validated PETG avionics holder for N-4 109~mm airframe and 18650 pack \cite{petg_mechanical, n4_poptest_internal} & Specific Objective 3 (avionics holder) \\ \hline
8 & Pre-flight monitoring & N-3.5 lacked battery voltage and continuity telemetry; explicitly flagged for N-4 \cite{n3p5_recovery_report} & Specific Objective 3 (system diagnostics) \\ \bottomrule
\end{tabular}
\end{table}
