khanji254/FYP_2025_Recovery/interim_report/Files/Declaration.tex

\section*{Declaration}
\addcontentsline{toc}{section}{Declaration}

We declare that this final report is our original work and has not been presented
for examination in any other institution.
We confirm that all sources of information, data, and published material used
in preparing this report have been appropriately acknowledged and referenced in
accordance with university academic standards.
We further affirm that this report reflects the complete work carried out in our
Final Year Project and is a true account of all activities completed.

\vspace{1.5cm}
\noindent\textbf{Students:}

\vspace{1cm}
\noindent Name: Glenn Gatiba \hfill Date: \underline{\hspace{4cm}}\\
Registration Number: ENM221-0149/2021

\vspace{0.8cm}
\noindent Name: Ian Joseph \hfill Date: \underline{\hspace{4cm}}\\
Registration Number: ENM221-0249/2021

\vspace{1.2cm}
\noindent\textbf{Supervisors:}

\vspace{0.8cm}
\noindent Name: Dr Shohei Aoki \hfill Date: \underline{\hspace{4cm}}\\
Department of Mechatronic Engineering
