khanji254/FYP_2025_Recovery/interim_report/Files/title_page.tex

\begin{titlepage}
	\begin{center}
			\vspace*{-4.0cm}
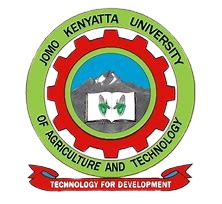
[picture p31: interim_report/Figures/logo.png]
		\\[0.5cm]
	 \large{Jomo Kenyatta University of Agriculture and Technology}\\
		\large{College of Engineering and Technology}\\
		\large{School of Mechanical, Materials, and Manufacturing Engineering}\\
	 \large{Department of Mechatronic Engineering}\\

		------------------------------------------------------------------------------------------------\\[0.5cm]
			\LARGE{\textbf{Design and Fabrication of a Reliable Dual Recovery System for the N4 Rocket with Extended Telemetry Range}}\\[0.3cm]
			\large{(FYP22-4)}\\[0.6cm]
  
				\large{ Project Report}\\[1.0cm]

	 \textbf{Glenn Gatiba (ENM221-0149/2021)
						}\\
		\textbf{Ian Joseph (ENM221-0249/2021)
						}\\[0.6cm]
		 \large{\textbf{Supervisors}}\\
		\large{Dr Shohei Aoki}\\
		\large{\today}\\
		------------------------------------------------------------------------------------------------\\[0.5cm]
	\end{center}
\end{titlepage}
