khanji254/FYP_2025_Recovery/project_proposal/Files/Declaration.tex

\section*{Declaration}
\addcontentsline{toc}{section}{Declaration}

We declare that this project proposal is our original work and has not been presented for examination in any other institution.

\vspace{2cm}

\textbf{Students:}

\vspace{1cm}

\noindent
\rule{5cm}{0.4pt} \hfill \rule{3cm}{0.4pt}\\
Name: Glenn Gatiba \hfill Date\\
Registration Number: ENM221-0149/2021\\

\vspace{1cm}

\noindent
\rule{5cm}{0.4pt} \hfill \rule{3cm}{0.4pt}\\
Name: Ian Joseph \hfill Date\\
Registration Number: ENM221-0249/2021\\

\vspace{2cm}
