khanji254/FYP_2025_Recovery/project_proposal/Files/Chapter5.tex

\section{Expected Outcomes}
\label{sec:outcomes}

\subsection{Technical Performance}

\begin{itemize}
    \item \textbf{Telemetry}: Continuous data up to 5 km altitude, <5\% packet loss \cite{xbee_pro_datasheet}
    \item \textbf{Recovery}: Zero thermal damage to parachute, controlled descent (<5 m/s landing) \cite{descent_dynamics}
    \item \textbf{Electronics}: Reliable PCB withstanding 15G+ vibration \cite{avionics_vibration}
    \item \textbf{Mechanical}: Vibration-proof avionics holder, no component displacement
    \item \textbf{Safety}: Launch inhibit at <14.0V, dual-redundant ignition circuits
\end{itemize}

\subsection{Project Timeline}

15-week implementation: Planning/Design (Weeks 1-5), Procurement/Fabrication (Weeks 4-8), Integration/Testing (Weeks 9-12), Validation (Weeks 13-15). Detailed timeline in Appendix B.

\subsection{Knowledge Contribution}

Project documentation will provide:
\begin{itemize}
    \item XBee-PRO 900HP performance validation in African high-altitude context
    \item PWM ignition characterization for student rockets
    \item Explosion cap design specifications
    \item Lessons learned for Nakuja Project and broader community
\end{itemize}
