khanji254/FYP_2025_Recovery/project_proposal/context/Latex_Template-2022/Latex_Template/Files/app1.tex

\section*{Time plan}
Insert Gantt chart here
\newpage
\section*{Budget}
Insert table here
