khanji254/FYP_2025_Recovery/project_proposal/context/Latex_Template-2022/Latex_Template/Files/Declaration.tex

\addcontentsline{toc}{section}{Declaration}
\section*{Declaration}

We hereby declare that the work contained in this report is original; researched and documented by the undersigned students. It has not been used or presented elsewhere in any form for award of any academic qualification or otherwise. Any material obtained from other parties have been duly acknowledged. We have ensured that no violation of copyright or intellectual property rights have been committed.
\begin{enumerate}
	\item Theodore Kamau\vspace*{.2cm}\\
	Signature\ldots\ldots\ldots\ldots\ldots\ldots\ldots\ldots\ldots\ldots Date\ldots\ldots\ldots\ldots\ldots\ldots\ldots\ldots\ldots\ldots
	\item Lisa Kimondo\vspace*{.2cm}\\
	Signature\ldots\ldots\ldots\ldots\ldots\ldots\ldots\ldots\ldots\ldots Date\ldots\ldots\ldots\ldots\ldots\ldots\ldots\ldots\ldots\ldots
\end{enumerate}

\vspace*{.5cm}
Approved by supervisors:
\begin{enumerate}
	\item Dr.-Ing. Jackson G. Njiri\vspace*{.2cm}\\
	Signature\ldots\ldots\ldots\ldots\ldots\ldots\ldots\ldots\ldots\ldots Date\ldots\ldots\ldots\ldots\ldots\ldots\ldots\ldots\ldots\ldots
	\item Prof. George N. Nyakoe\vspace*{.2cm}\\
	Signature\ldots\ldots\ldots\ldots\ldots\ldots\ldots\ldots\ldots\ldots Date\ldots\ldots\ldots\ldots\ldots\ldots\ldots\ldots\ldots\ldots
	\item Ms. Lucy W. Kariuki\vspace*{.2cm}\\
	Signature\ldots\ldots\ldots\ldots\ldots\ldots\ldots\ldots\ldots\ldots Date\ldots\ldots\ldots\ldots\ldots\ldots\ldots\ldots\ldots\ldots
\end{enumerate}
