khanji254/FYP_2025_Recovery/project_proposal/context/Latex_Template-2022/Latex_Template/Files/title_page.tex

\begin{titlepage}
  \begin{center}
      \vspace*{-4.0cm}
    \begin{figure}[!h]
\centering

\end{figure}
   \large{Jomo Kenyatta University of Agriculture and Technology}\\
    \large{College of Engineering and Technology}\\
    \large{School of Mechanical, Materials, and Manufacturing Engineering}\\
   \large{Department of Mechatronic Engineering}\\

    ------------------------------------------------------------------------------------------------\\[0.5cm]
      \LARGE{\textbf{Design and Fabrication of a Digital Stethoscope\\(FYP 17-11)}}\\[0.6cm]
    %\large{by}\\[0.6cm
  
		\large{Project Proposal 
        }\\[1.0cm]

   \textbf{Theodore Kamau (EN292-9123/2012)
            }\\
    \textbf{Lisa Kimondo~(EN292-9456/2012)
            }\\[0.6cm]
     \large{\textbf{Supervisors}}\\
    \large{Dr.-Ing.~Jackson G. Njiri}\\
    \large{Prof. George N. Nyakoe}\\ [0.2cm]\vfill
    \large{May 2021}\\
    ------------------------------------------------------------------------------------------------\\[0.5cm]
  \end{center}
\end{titlepage}
