khanji254/FYP_2025_Recovery/project_proposal/context/recovery _Report.pptx

## Slide 2

Presentation Outline

- Background of Study
- Problem Statement
- Objectives
- Key Literature Review
- Proposed Methodology
- (Mechanical & Electrical)
- Expected Outcomes
- Project Time Plan
- Budget


## Slide 3

Background

- Rocket Recovery: The most critical subsystem for preserving flight data and hardware.
- Evolution of Systems:
- Single Deployment: Parachute at apogee. Risk:
High drift radius.
- Dual Deployment: Drogue at apogee (stability), Main at low altitude (soft landing). Standard for high-power rocketry .
- Nakuja Context:
- Previous N3.5 mission used a basic
single-deployment piston based system.
- Current Uses Dual Deployment
- Challenges faced: Reliability of ejection and
telemetry signal loss .

[http://www.effectofglobalwarming.com/]

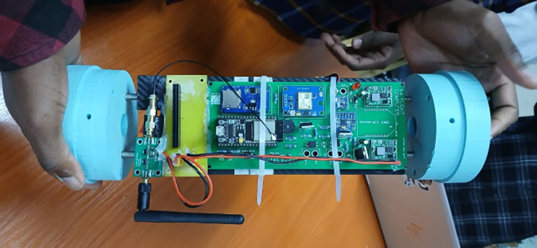
[picture p44: figure]

[http://www.iea.org/]

Image of N4 Recovery tsaken by student

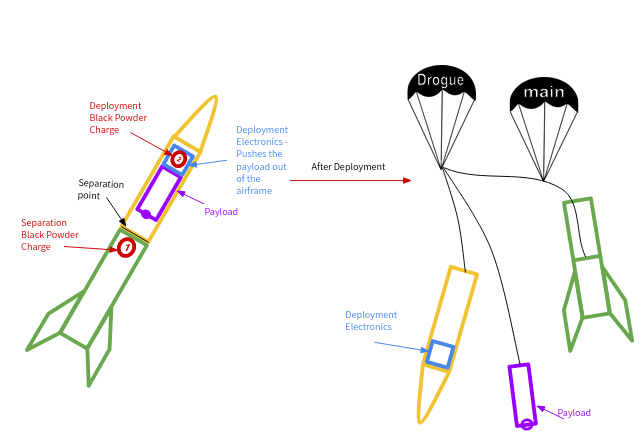
[picture p45: figure]

Dual recovery system from

## Slide 4

Problem Statement

The N4 mission faces three critical reliability challenges. First, the telemetry system's current protocol suffers from significant range limitations, leading to signal loss and high risk of vehicle loss. Second, the "DC dump" ignition method for nichrome wire generates uncontrolled heat 1000 degrees, which makes the deployment a one use case. Finally, the lack of real-time pre-flight feedback on battery voltage and igniter continuity leaves ground operators blind to potential power failures, increasing the risk of aborts or deployment malfunctions.

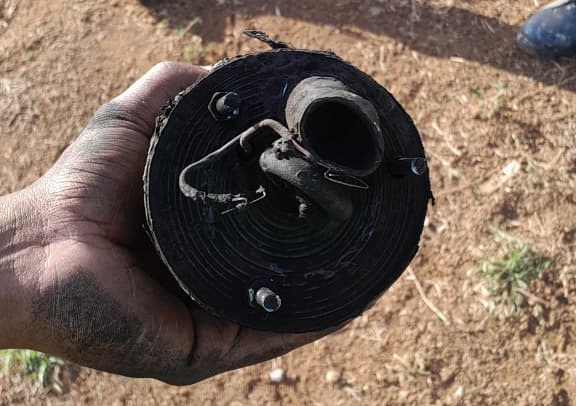
[picture p46: figure]

Image of N4 charge holder taken by student


RSSI data from range test

## Slide 5

Objectives

Main Objective: To design and fabricate a reliable dual recovery system for the N4 rocket with extended telemetry range.
Specific Objectives:
- To implement the Digi XBee-PRO 900HP telemetry system for robust long-range data transmission (>5km).
- To design a PWM-controlled ignition system to regulate Nichrome wire temperature and prevent burnout and one shot use.
- To develop a feedback monitoring system that transmits real-time battery percentage and deployment pin continuity to the ground station.
- To implement an Explosion cup reliably so as to have consistent and reliable deployment.

## Slide 6

Literature Review: Telemetry

Technology | Typical Use | Range (LOS) | Data Capability | Key Strength | Key Limitation
433 MHz RF Beacons | DIY recovery | 5–10 km* | Very low | Simple, long theoretical range | No reliability, no ACKs
Beacon Telemetry (This Work) | N4 Recovery | 4 km (75 B) 0.8 km (207 B) | Low–Medium | Simple, no infrastructure | Range drops with packet size
LoRa (SX1278) | Student rockets, CanSat | 2–15 km | Low | High sensitivity, low power | Low bandwidth, high latency
XBee 2.4 GHz | UAVs, small rockets | <2 km | Medium | Easy integration | Short range, interference
XBee-PRO 900HP | Advanced student rockets | 5–15 km | Medium–High | High power, reliable protocol | Higher power usage
ESP-NOW | Command & control | <1 km | Medium | Very low latency | Not long-range
Cellular (LTE / NB-IoT) | High-budget projects | Global | High | Unlimited range | Network dependent

## Slide 7

Literature Review: Deployment

Igniter Types:
- Commercial E-Matches: Reliable and fast, but expensive and single-use.
- Nichrome Wire (DIY): Reusable and cheap. Used by Nakuja.
Nakuja N4 Analysis:
- Method: Direct DC Drive (14.8V dumped into wire)⁴.
- Failure Mode: Wire reached 1000+ degrees instantly. Result: "Popped" wires
Gap:
- No Reusability of the nichrome deployment system making it difficult for tests and adds risks in deployment.
- No Battery Monitoring or Continuity Feedback to ground control.

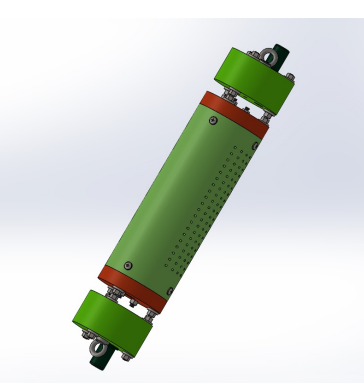
[picture p47: figure]

Avionics bay from FYP-20-1

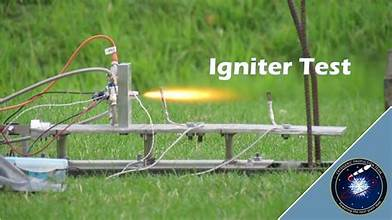
[picture p48: figure]

Commercial E-Match igniter Test

## Slide 8

Literature Review: The Crimson Powder Problem

From pop tests it was observed that there is unpredictable pressurization of the explosion chamber leading to unforeseen issues.

- Structural & Power Failures:
  - Battery Holders: Standard spring-loaded holders suffer mechanical resonance and breakage under high shock loads, leading to momentary power loss (MCU Reset).
  - FC Mounting: Rigid mounting transmits high-frequency vibrations directly to the PCB, causing solder fatigue and sensor noise.
- Identified Research Gaps:
  1. Quantifiable Charge Energy: Lack of empirical data correlating Charge Mass (g) to Ejection Force (N) for the N4 airframe volume.
  2. Ruggedized Avionics Structure: Absence of a shock-isolated Flight Computer (FC) Holder designed specifically to withstand the high-impact forces of pyrotechnic deployment.

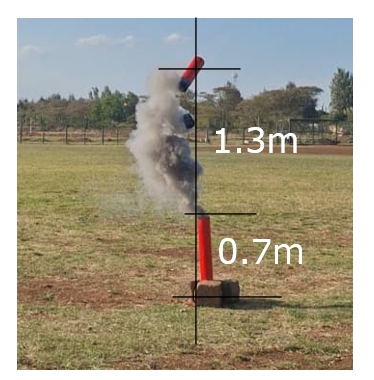
[picture p49: figure]

First N4 Poptest Image

## Slide 9

Methodology

Mechanical

Deployment Mechanism (The "Explosion Cap"):
- Implementation of a Sealed Explosion Cap to house the Crimson Powder charge.
- Function: Contains the combustion flame to prevent parachute burning while directing the pressure wave to shear pins for reliable ejection.
Avionics Bay Structure:
- Design of a custom 3D-printed Sled/Holder to secure the Flight Computer, LiPo Batteries, and BMS.
- Key Feature: Engineered to provide mechanical isolation and vibration dampening against high-G launch forces ¹.

## Slide 10

Methodology

Electrical

Hardware Architecture:
- MCU: ESP32 (Selected for high processing speed).
- Telemetry: Integration of Digi XBee-PRO 900HP for robust long-range communication (>5km).
- Fabrication: Custom PCB Design and Fabrication to miniaturize the circuit and eliminate loose wire failures.
Smart Ignition Control (PWM):
- Driver: Low-side MOSFET controlled by Pulse Width Modulation (PWM).
- Logic: precise heating profile
Power & Feedback:
- BMS Integration: Active battery management for safety.
- Feedback Loop: Real-time monitoring of Battery Voltage and Igniter Continuity transmitted to Ground Station.

## Slide 11

Expected Outcomes

Operational Reliability:
Telemetry: Continuous data stream up to 5 km altitude with <5% packet loss using XBee-PRO 900HP.
Safe Recovery: Successful parachute deployment with zero thermal damage to the canopy, achieved via the Sealed Explosion Cap and PWM Ignition.
System Integrity:
Electronics: A custom-fabricated PCB that eliminates wire fatigue and ensures reliable connections under vibration.
Mechanical: A vibration-proof, 3D-printed avionics holder that maintains Center of Gravity (CG) stability.
User Feedback (Ground Station):
Real-time monitoring of Battery Voltage, Igniter Continuity, and GPS Position.
Automatic "Launch Inhibit" safety protocol if main battery voltage drops below 14.0V.

## Slide 12

Expected Outcomes

Budget

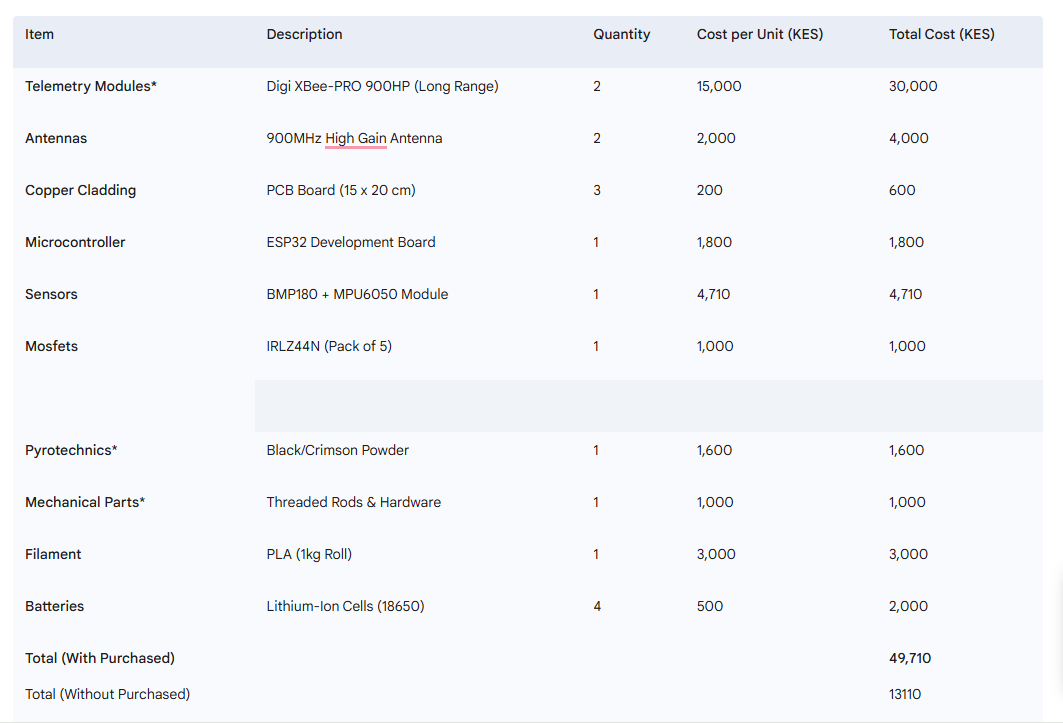
[picture p50: figure]

Items with * Are already Purchased

## Slide 13

Expected Outcomes

Time plan


## Slide 14

Thank you for your attention.
