khanji254/FYP_2025_Recovery/interim_report/Nakuja_N4_Presentation.pdf

## N4 Rocket Recovery System

Continuous Assessment Presentation

Glenn Omondi

March 2026

Nakuja Project — Final Year Project

Outline

1. Introduction & Background
2. Problem Statement
3. Objectives
4. Literature Review (tabulated)
5. Gaps & Proposed Approach
6. Methodology

Design Approach (4 modules) Telemetry Module
Pyrotechnic Module
Mechanical / Structural
Electronics & Circuit Design Firmware Architecture
7. Results

Mechanical design outputs Electronics & integration

8. Budget
9. Conclusion & Way Forward
10. Time Plan

Introduction & Background

Context:

The Nakuja Project is JKUAT’s student rocketry programme, targeting altitude records with successive N-series rockets.

The N4 rocket uses a dual-deployment recovery system â¿” a drogue parachute at apogee stabilises descent; a main parachute deploys at low altitude for safe landing.

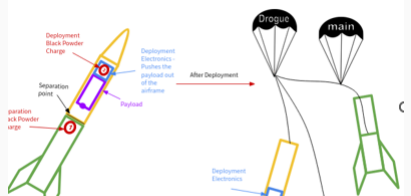
[picture p75: figure]

Recovery depends on three tightly coupled systems: telemetry (track the rocket after separation), pyrotechnic deployment (eject the parachutes reliably), and pre-flight monitoring

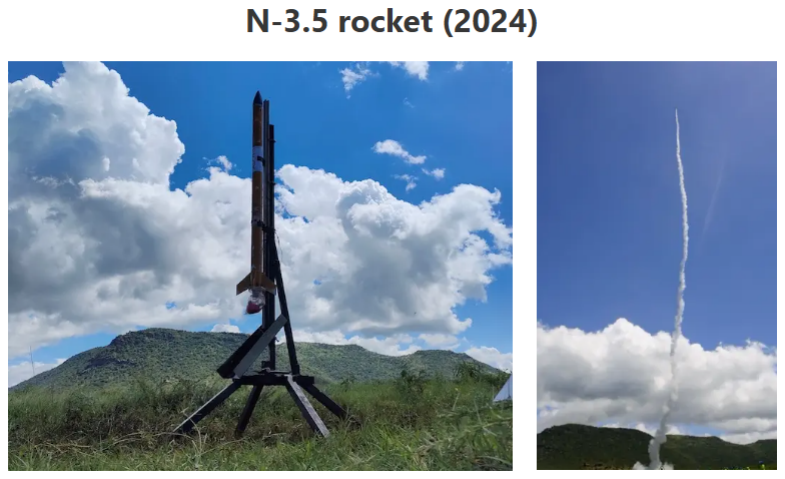
[picture p76: figure]

Nakuja N3 rocket â¿” dual-deployment

configuration

Problem Statement

Three failure modes identified from N3 field experience:

Problem Area | Consequence

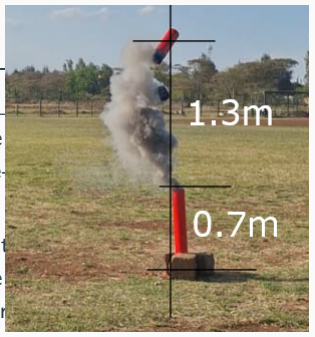
[picture p77: figure]

Short telemetry range | Signal lost after apogee;
rocket unrecoverable beyond ≈1 km

DC pyro dump (no control) Nichrome wire burns out in ∼2 s; reuse impossible; thermal damage to holder

No pre-flight diagnostics | Battery state and igniter
continuity | unknown | at
launch; deployment failure undetectable
| | Excessive crimson powder deployment
from uncontrolled charge

Objectives

Main Objective
To design, fabricate, and validate a reliable dual-deployment recovery system for the N4 rocket, achieving telemetry coverage beyond 5 km, controlled pyrotechnic deployment, and real-time pre-flight system diagnostics.

Specific Objectives:

1. Telemetry range: Design and configure a 900 MHz XBee-PRO 900HP radio link with a verified link margin ≥20 dB at 5 km range to ensure post-apogee rocket tracking and telemetry reception.
2. Controlled deployment: Implement a PWM-based ignition controller driving an IRLZ44N MOSFET at a calibrated duty cycle to eliminate nichrome burnout and provide safe, repeatable pyrotechnic ejection charge activation.
3. Structural design & in-flight monitoring: Design a 3D-printed PETG avionics holder satisfying the 95 mm bay envelope constraint; integrate an ADS1115 16-bit

Literature Review â¿” Telemetry, Deployment & Monitoring

Source | Key Contribution | Limitation / Gap
Digi International (2019) â¿” XBee- PRO 900HP User Guide | 900 MHz FHSS, +24 dBm Tx, −110 dBm Rx sensitivity; trans-
| parent UART mode for direct microcontroller integration | No application-level link- budget study for rocket at- titude variation
Pozar | (2011);
ARRL | Antenna
Book (2019) | Free-space path loss model; dipole radiation pattern â¿”
| omnidirectional main lobe with axis nulls | Null zones along dipole axis require tilt margin allocation

Nakka, R. (2021)
â¿” | Pyrotechnic
igniter design | PWM duty-cycle control lim- its peak current and prevents nichrome burnout; repeatability validated | Study uses bench test only; no in-rocket deployment validation
Martinez & Chen (2018) â¿” PWM for resistive heating | Confirmed PWM at 1 kHz as effective thermal control for nichrome wire | Focus on industrial heaters; not validated for pyrotech- nic ignition pulses

Literature Review â¿” Structures, Firmware & Recovery

Source | Key Contribution | Limitation / Gap

Santana & Alves
(2021) â¿” PETG
FDM properties
PETG | tensile | strength
≈50 MPa, | chemical resis-
tance, low warping vs PLA; viable for avionics enclosures
High-shock | load | data
(>20 g) absent; vibration
fatigue not characterised

Real Time Engineers Ltd (2023)
â¿” FreeRTOS
Manual

Task scheduling, priority inversion, and inter-task communication for embedded systems

No | rocket-specific | FSM
reference | architecture
provided
Knacke, | T.W.
(1991) | â¿”
Parachute Recovery Systems
Drogue | + | main | dual-
deployment | principles; | de-
ployment force and timing
criteria

Pre-digital; no embedded
trigger logic or apogee-
detection | algorithms
discussed

Rodriguez, C.
(2020) â¿” MOS-FET Gate Drive

IRLZ44N logic-level enhancement at 3.3 V; RDS(on) =
22 mΩ; 40 µs turn-on

Switching characterisation at low-side solenoid load; ignition-specific testing

Gaps Identified & Proposed Approach

Gaps in existing solutions:

No verified 5 km link budget for N4 attitude uncertainty â¿” literature gives theory only; no field-proven margin for this specific flight profile.

DC pyrotechnic dump is single-use and thermally destructive â¿” no study combines PWM ignition with a logic-level MOSFET on an ESP32 platform.

No integrated launch-inhibit system combining battery voltage monitoring and continuity detection on a single flight computer.

Proposed approach:

1. XBee-PRO 900HP â¿” 900 MHz, +24 dBm; calculated link margin +32 dB at 5 km.
2. PWM ignition at 1 kHz, D = 0.40; IRLZ44N MOSFET driven directly from 3.3 V ESP32 GPIO.
3. ADS1115 I²C ADC â¿”

47 kΩ/10 kΩ divider; launch inhibit if Vbat < 14.0 V or continuity absent.

4. Stepped PETG battery carrier â¿” raised edge cells clear threaded rods; dual-rod retention for

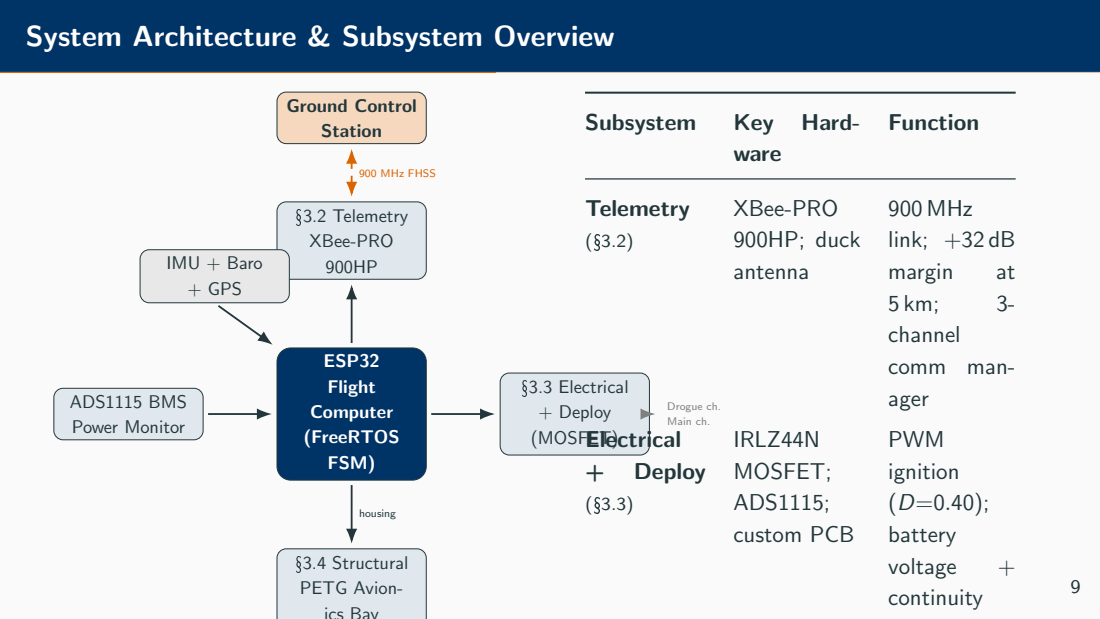
[picture p78: page 9]
ESP32; Flight; Computer; (FreeRTOS; FSM); §3.2 Telemetry; XBee-PRO; §3.3 Electrical; + Deploy; (MOSFET); §3.4 Structural; PETG Avion-; ics Bay; ADS1115 BMS; Power Monitor; IMU + Baro; + GPS; Ground Control; Station; 900 MHz FHSS; housing; Drogue ch.; Main ch.; Subsystem; Key; Hard-; ware; Function; Telemetry; 900HP; duck; antenna; 900 MHz; link; +32 dB; margin; channel; comm man-; ager; Electrical; Deploy; IRLZ44N; MOSFET;; ADS1115;; custom PCB; PWM; ignition (D=0.40);; battery; voltage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

System Architecture & Subsystem Overview

Methodology â¿” Design Approach

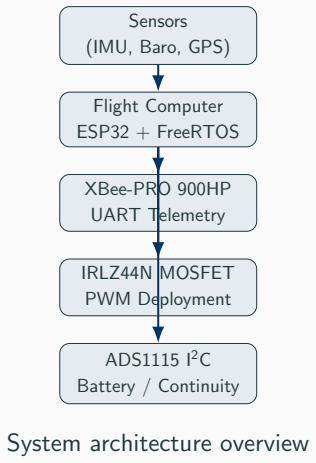
[picture p79: figure]
Sensors; (IMU, Baro, GPS); Flight Computer; ESP32 + FreeRTOS; XBee-PRO 900HP; UART Telemetry; IRLZ44N; MOSFET; PWM Deployment; ADS1115 I²C; Battery / Continuity; System architecture overview

4-module design structure:

# | Module | Purpose

1 | Telemetry | Long-range | rocket
tracking & data downlink post-apogee
2 | Pyrotechnic | Controlled | ejection
charge activation for
dual deployment
3 | Power Monitor | Pre-flight safety: bat-
tery state + igniter
| | continuity
4 | Mechanical | Structural | contain-
ment within 95 mm
bay; vibration isolation

Methodology â¿” Telemetry Module

Design Considerations:

Must maintain link over 5 km with rocket tumbling (attitude variation ±60Â°)

Must survive 20 g launch shock without connector failure

Direct UART to ESP32 (no packet overhead)

Options evaluated:

Option | Freq. | Margin@5km

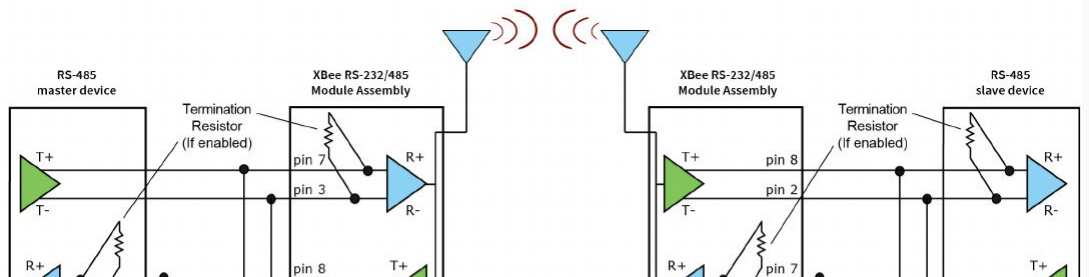
[picture p80: figure]

LoRa SX1276 | 433 MHz | +8 dB
433 MHz OOK | 433 MHz | −2 dB (fail)
XBee-PRO 900HP | 900 MHz | +32 dB


XBee-PRO 900HP module

Methodology â¿” Pyrotechnic Deployment Module

Design Considerations:

Must fire reliably, but not burn out the
igniter

Logic-level control from 3.3 V ESP32 GPIO

Inductive flyback protection for solenoid-type loads

DC dump vs PWM trade study:

Criterion | DC Dump | PWM
Wire re-use | No | Yes
Current con- trol | None | ✓
Holder dam- | High risk | Mitigated


Cut nichrome wire after DC-dump burn-out — single use


Charring from uncontrolled pop test â¿”

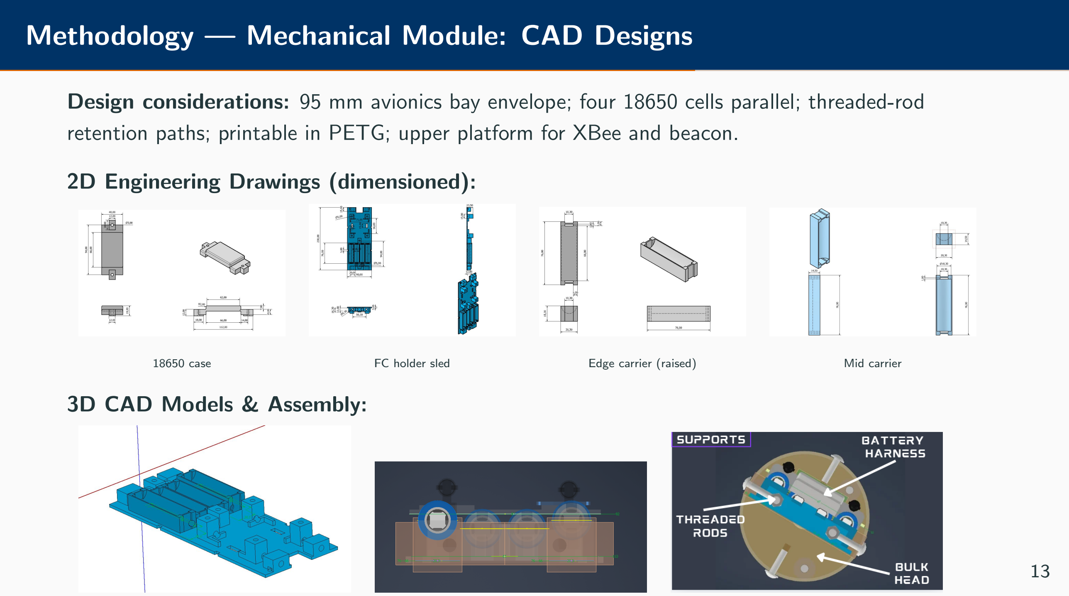
[picture p81: page 13]

Methodology — Mechanical Module: CAD Designs

Design considerations: 95 mm avionics bay envelope; four 18650 cells parallel; threaded-rod retention paths; printable in PETG; upper platform for XBee and beacon.

2D Engineering Drawings (dimensioned):

18650 case | FC holder sled | Edge carrier (raised) | Mid carrier

3D CAD Models & Assembly:

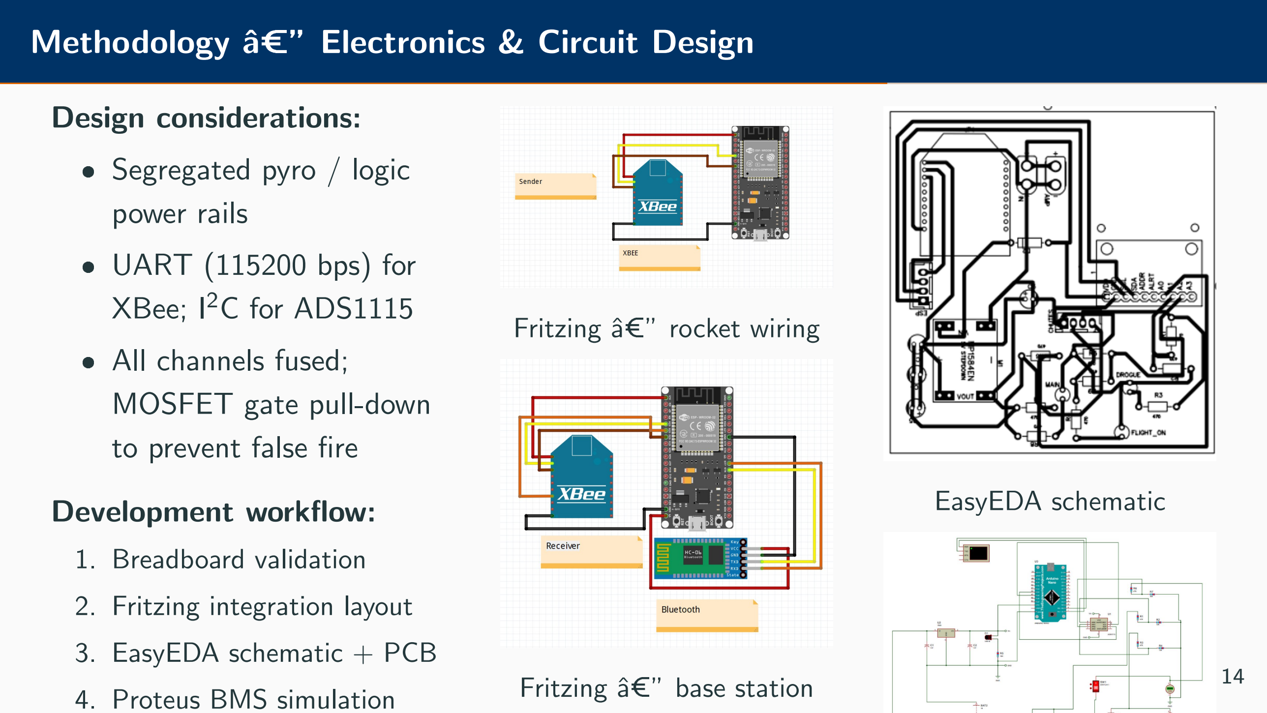
[picture p82: page 14]

Methodology â¿” Electronics & Circuit Design

Design considerations:

Segregated pyro / logic
power rails

UART (115200 bps) for
XBee; I²C for ADS1115

All channels fused;
MOSFET gate pull-down
to prevent false fire

Development workflow:

1. Breadboard validation
2. Fritzing integration layout
3. EasyEDA schematic + PCB
4. Proteus BMS simulation

Fritzing â¿” rocket wiring

Fritzing â¿” base station

EasyEDA schematic

Methodology â¿” Firmware & Software Architecture

FreeRTOS task structure:
Task | Rate
Sensor fusion (IMU, baro) | 10 Hz
XBee UART telemetry TX | 10 Hz
FSM state machine | 20 Hz
ADS1115 voltage monitor | 1 Hz
Deployment (event-driven) ISR

Deployment arm conditions:

Battery >14.0 V AND continuity >1000 counts

FSM state = APOGEE or
RECOVERY

Inhibit flag clear

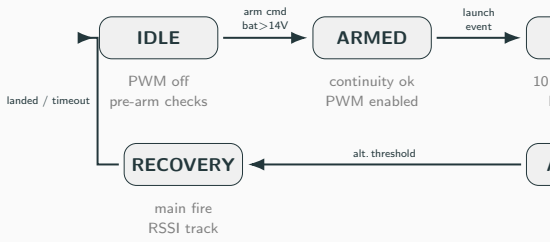
[picture p83: figure]
IDLE; ARMED; FLIGHT; RECOVERY; APOGEE; arm cmd bat>14V; launch event; alt. threshold; landed / timeout; PWM off; pre-arm checks; continuity ok; PWM enabled; 10 Hz telemetry; IMU + baro; main fire; RSSI track

N4 firmware state machine

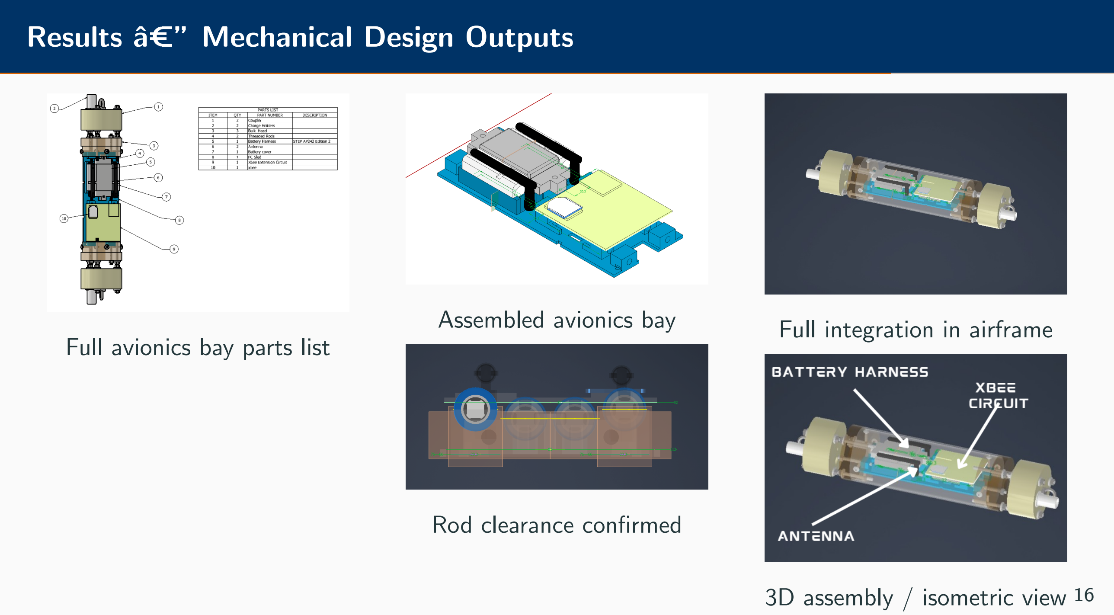
[picture p84: page 16]

Results â¿” Mechanical Design Outputs

Full avionics bay parts list

Assembled avionics bay

Rod clearance confirmed

Full integration in airframe

3D assembly / isometric view 16

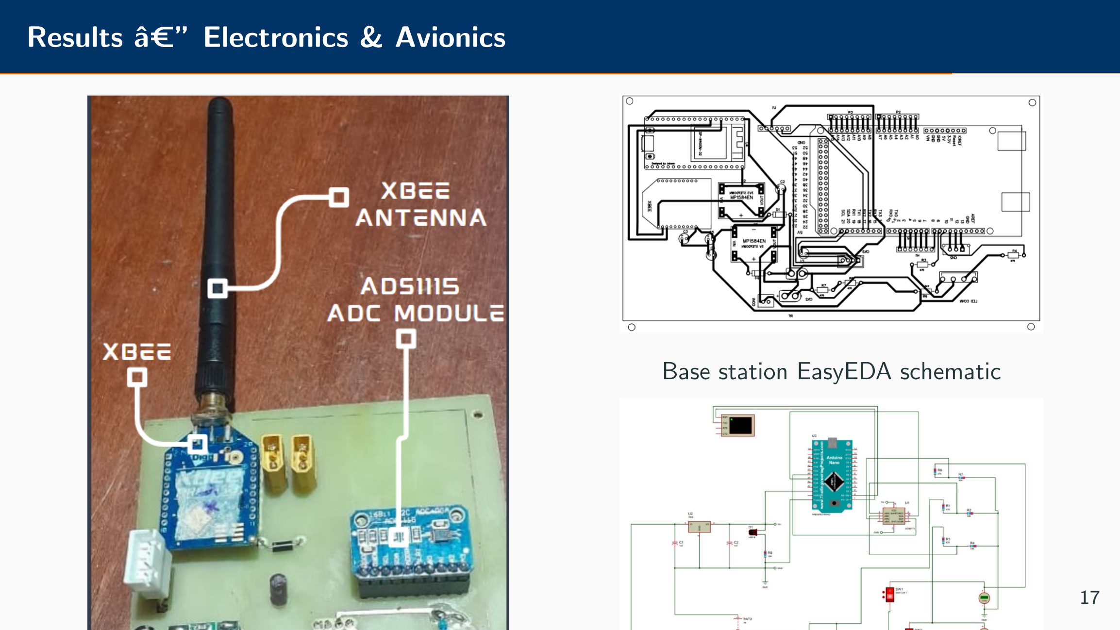
[picture p85: page 17]

Results â¿” Electronics & Avionics

Base station EasyEDA schematic

Budget

Item | Qty | Est. Cost (KES)
XBee-PRO | 900HP | modules
(A—2) ˜
2 | 12,000
ESP32 DevKit (flight + GCS) | 2 | 1,200
PCB fabrication (chemical etch) | 1 | 800
IRLZ44N MOSFETs + passives | – | 400
ADS1115 ADC module | 1 | 300
18650 battery cells (A—4) | 4 | 2,400 ˜
PETG filament (structural parts) | – | 1,500
900 MHz duck antennas (A—2) | 2 | 800 ˜
Nichrome wire + connectors | – | 600
Pop-test black powder charges | – | 1,500
Miscellaneous (solder, PCB stock) | – | 1,000
Total | 22,500

All costs in Kenyan Shillings (KES). Procurement partially complete.

Conclusion & Way Forward

Progress summary:

XBee-PRO 900HP configured; link budget verified (+32 dB at 5 km)

PWM ignition validated: controlled firing without burnout at D = 0.40

ADS1115 Proteus simulation confirms distinct ADC codes for launch-inhibit logic

PETG structural CAD complete; stepped battery carrier resolves rod interference

Custom PCB chemically etched and soldered (88 mm × 93 mm)

FreeRTOS firmware modules bench-integrated; FSM tested

Objective Progress:

Objective | Status | %
Telemetry range | In progress | 70%
PWM deployment | In progress | 65%
BMS / structural | In progress | 60%
System integration | Planned | 0%

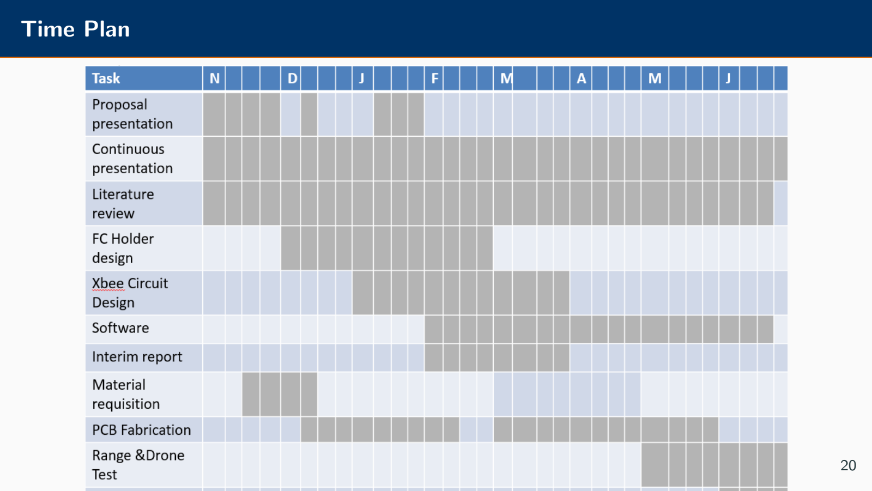
[picture p86: page 20]

Time Plan

## Thank you

Questions?
