khanji254/FYP_2025_Recovery/project_proposal/N4_Recovery_Proposal.pdf

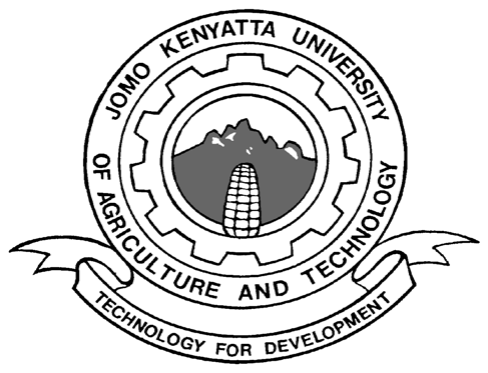
[picture p87: figure]

### Jomo Kenyatta University of Agriculture and Technology

### College of Engineering and Technology

### School of Mechanical, Materials, and Manufacturing Engineering

### Department of Mechatronic Engineering

————————————————————————————————

# Design and Fabrication of a Reliable Dual

# Recovery System for the N4 Rocket with

# Extended Telemetry Range

### (FYP22-4)

### Project Proposal

### Glenn Gatiba (ENM221-0149/2021)

### Ian Joseph (ENM221-0249/2021)

### Supervisors

### Dr Shohei Aoki

### February 27, 2026

————————————————————————————————

I

## Declaration

We declare that this project proposal is our original work and has not been presented for

examination in any other institution.

Students:

Name: Glenn Gatiba | Date

Registration Number: ENM221-0149/2021

Name: Ian Joseph | Date

Registration Number: ENM221-0249/2021

II

## Acknowledgment

We would like to express our sincere gratitude to the Nakuja Project team for providing

the opportunity to work on this critical recovery system for the N4 rocket mission.

Our appreciation goes to our supervisors for their guidance, support, and invaluable

feedback throughout the development of this proposal.

We acknowledge the previous work done by the FYP-20-1 team and other Nakuja members

whose experiences and documented challenges informed the direction of this project.

Special thanks to the Department of Mechatronic Engineering, JKUAT, for providing the

necessary facilities and resources for this research.

Finally, we thank our families and friends for their continuous encouragement and support

throughout this endeavor.

III

## Abstract

The N4 rocket mission represents a critical advancement in student rocketry, requiring a

reliable dual recovery system capable of preserving flight data and hardware integrity. This

project addresses three fundamental reliability challenges: telemetry range limitations

leading to signal loss, uncontrolled heat generation from DC dump ignition methods

causing single-use deployment systems, and absence of real-time pre-flight feedback on

critical system parameters.

The proposed solution integrates the Digi XBee-PRO 900HP telemetry system for robust

long-range data transmission exceeding 5km, implements a PWM-controlled ignition sys-

tem to regulate Nichrome wire temperature and enable reusable deployment, and develops

a comprehensive feedback monitoring system transmitting real-time battery voltage and

igniter continuity to ground control. Additionally, a sealed explosion cap design prevents

thermal damage to the parachute canopy while ensuring consistent deployment, and a cus-

tom 3D-printed avionics holder provides vibration isolation under high-G launch forces.

Expected outcomes include operational telemetry with less than 5% packet loss at 5km

altitude, zero thermal damage to recovery systems, and automatic launch inhibit protocols

for critical power failures. This comprehensive approach addresses identified research gaps

in student rocket recovery systems and establishes a foundation for future high-power

rocketry missions.

I

## Contents

Declaration | I
Acknowledgment | II
Abstract | III

CONTENTS | II

III

## List of Figures

2.1 Full Nakuja N3 rocket showing the dual-deployment recovery configuration

2.2 Rocket in flight demonstrating the dual-deployment sequence and aerody-

2.3 Beacon RSSI decay analysis showing signal degradation with distance and

2.5 Dipole radiation pattern illustrating axis nulls that can cause overhead

2.6 Example 900 MHz Bi-Quad ground-station antenna option for increased

2.7 Excessive crimson powder deployment showing the need for precise charge

2.8 Charge holder thermal damage from explosion highlighting thermal isola-

2.9 Post-deployment test showing charring effects and the importance of sealed

2.10 Assembled avionics bay with integrated battery retention and vibration

2.11 Current flight-computer holder geometry used for mechanical integration

2.12 XBee-PRO 900HP telemetry system integration showing complete signal

2.13 Adiabatic expansion analysis for parachute deployment system design . . . 14

3.1 CAD rendering of the avionics bay assembly showing component layout,

LIST OF FIGURES | IV

3.2 Updated flight-computer holder CAD model showing revised mounting and

battery seating features | 17

3.3 Cross-sectional view of the avionics bay indicating internal clearances and

component stacking | 18

3.4 Threaded-rod integration with raised battery cells to preserve structural

alignment and wiring space | 18
3.5 Proposed XBee-PRO 900HP telemetry system architecture | 19

3.6 Nichrome wire demonstration showing thermal melting and cutting mech-

anism - illustrating the one-shot deployment characteristic | 19

3.7 Base station receiver circuit concept showing XBee-PRO 900HP integra-

tion, RF filtering, and ground control processing elements | 21

3.8 Rocket XBee extension circuit pinout and Fritzing layout illustrating power

conditioning, antenna interface, and signal routing | 21

3.9 Battery Management System Proteus design showing ADS1115 ADC with

voltage divider (47kΩ/10kΩ), dual chute detection inputs, and power dis-

tribution topology | 22

B.1 15-week project timeline showing task dependencies and critical path through

design, fabrication, and testing phases | 30

C.1 XBee-PRO 900HP antenna radiation pattern showing signal strength dis-

tribution and null space regions. The pattern demonstrates approximate

omnidirectional coverage in the horizontal plane with defined null zones in

vertical extremes | 31

C.2 RSSI signal decay plot showing measured signal strength attenuation with

distance. Data confirms 5+km operational range with sufficient link margin

(minimum -100 dBm receiver sensitivity) throughout nominal flight profile 32

D.1 Nakuja N3 rocket showing avionics bay configuration (reference design for

N4 dual deployment architecture) | 33

LIST OF FIGURES | V

D.2 Current N4 flight computer circuit design showing ESP32 microcontroller

integration, XBee telemetry module, sensor interfaces (BMP180/MPU6050),

MOSFET-based PWM ignition drivers, and power management circuitry . 33

D.3 Current flight computer holder design featuring 3D-printed PETG con-

struction with integrated battery retention mechanism, vibration isolation

mounts, and modular component placement for easy assembly and main-

tenance | 34
F.1 18650 battery case cover drawing (current revision) | 35
F.2 Edge battery support plate drawing | 36
F.3 Mid battery support plate drawing | 37
F.4 Avionics assembly integration view | 37

VI

## List of Tables

2.1 Telemetry System Comparison for Student Rocketry Applications | 6
2.2 Nakuja Mission History and Key Findings | 12
A.1 N4 Recovery System Budget Breakdown | 29

Chapter 1. Introduction | 1

## 1 Introduction

### 1.1 Background of Study

Rocket recovery systems represent the most critical subsystem for preserving flight data

and hardware in high-power rocketry missions. The evolution of recovery systems has

progressed from simple single deployment methods to sophisticated dual deployment ar-

chitectures. Single deployment systems release a parachute at apogee, presenting risks of

high drift radius and unpredictable landing zones. In contrast, dual deployment systems

utilize a drogue parachute at apogee for stability, followed by a main parachute deploy-

ment at lower altitude for controlled soft landing, establishing the standard for modern

high-power rocketry operations.

The Nakuja Project N4 mission builds upon previous experiences from the N3.5 mission,

which employed a basic single-deployment piston-based system. The current N4 design

implements dual deployment architecture but faces significant challenges in deployment

reliability and telemetry signal integrity. Previous missions demonstrated critical vulner-

abilities in both mechanical deployment mechanisms and communication systems, neces-

sitating a comprehensive redesign approach.

### 1.2 Problem Statement

The N4 mission’s recovery system faces critical reliability challenges including teleme-

try range limitations causing signal degradation during critical flight phases, uncontrolled

ignition system temperatures exceeding 1000 degrees Celsius that create unreliable single-

use deployment mechanisms, and absence of real-time pre-flight monitoring systems for

battery voltage and igniter continuity, collectively threatening mission success through po-

tential vehicle loss, deployment failures, and inability to validate system readiness before

launch.

Chapter 1. Introduction | 2

### 1.3 Aim

To design, fabricate, and validate a reliable dual deployment recovery system for the N4

rocket with extended telemetry range and comprehensive pre-flight monitoring capabili-

ties.

### 1.4 Specific Objectives

The following four objectives capture the project focus areas:

1. Long-Range Telemetry Implementation: Deliver Digi XBee-PRO 900HP teleme-

try with verified 5km+ range and sub-5% packet loss so that the flight computer

can stream live health and sensor data across the entire trajectory.

2. Pyrotechnic Deployment System: Engineer a PWM-driven ignition controller

and sealed explosion cap that together ensure repeatable, temperature-regulated

nichrome activation for both drogue and main parachute stages.

3. Integrated Mechanical and Monitoring System: Fabricate a PETG avionics

bay that secures the flight computer and batteries with vibration isolation while pro-

viding continuous ADS1115-based monitoring of battery voltage, chute continuity,

and launch inhibit status.

4. System Validation through Testing: Execute pop tests to confirm explosion

cap containment and conduct telemetry range trials that demonstrate sustained

connectivity beyond 5km as required by the mission profile.

### 1.5 Justification

The development of a reliable recovery system is paramount to mission success. Loss

of the rocket vehicle results not only in hardware loss but also complete loss of flight

Chapter 1. Introduction | 3

data critical for mission analysis and future design improvements. The proposed im-

provements address documented failure modes from previous missions and implement

industry-standard practices adapted for student rocketry applications.

The Nakuja Project represents a significant investment in student engineering education

and practical aerospace systems development. Ensuring mission success through robust

recovery systems validates this investment and provides valuable learning opportunities

for future engineering professionals.

Chapter 2. Literature Review | 4

## 2 Literature Review

### 2.1 Recovery Systems in Student Rocketry

Recovery systems preserve flight hardware and recorded data, and are therefore mission-

critical in university rocketry projects [1, 2]. In dual-deployment recovery, a drogue

parachute is deployed near apogee for stabilization and drift control, followed by a main

parachute at lower altitude for safe touchdown [3, 4]. This staged architecture is widely

adopted in high-altitude student missions because it improves landing safety and reduces

downrange drift.

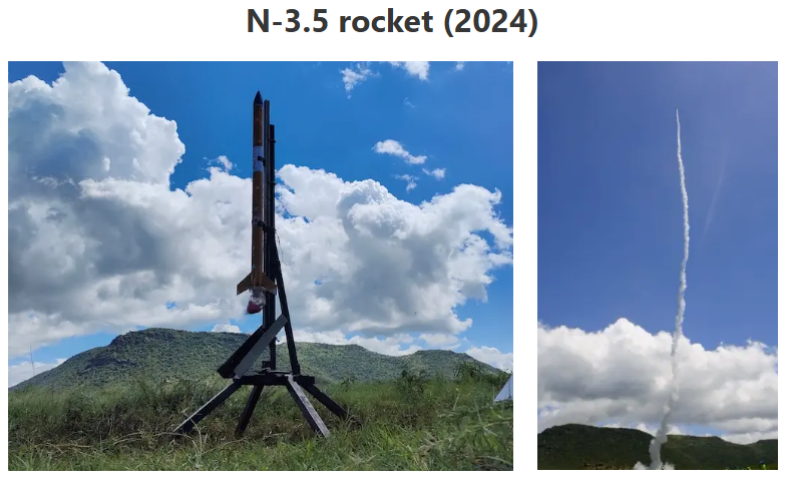
[picture p88: figure]

Figure 2.1: Full Nakuja N3 rocket showing the dual-deployment recovery configuration

and component layout

The Nakuja project’s progression from earlier single-deployment flights to the N4 dual-

deployment objective reflects this broader trend and responds directly to observed issues

in deployment consistency, telemetry robustness, and avionics survivability [5].

### 2.2 Telemetry Systems Analysis

Table 2.1 compares telemetry technologies for student rocketry applications [6, 7].

Chapter 2. Literature Review | 5

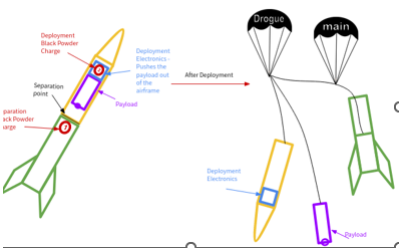
[picture p89: figure]

Figure 2.2: Rocket in flight demonstrating the dual-deployment sequence and aerody-

namic stability during ascent

The XBee-PRO 900HP provides the best balance between practical range, packet reli-

ability, and integration complexity for N4 [8]. Its 900 MHz operation provides better

propagation in non-ideal field conditions compared with 2.4 GHz systems.


Figure 2.3: Beacon RSSI decay analysis showing signal degradation with distance and

altitude

Chapter 2. Literature Review | 6

Table 2.1: Telemetry System Comparison for Student Rocketry Applications

Technology | Range | Data Cap | Strength | Limitation
433 MHz RF | 5–10 km | Very low | Simple, long range | No ACKs
Beacon | 4 km/0.8 km | Low–Med | Simple | Range drops
LoRa SX1278 | 2–15 km | Low | Low power | Low BW
XBee 2.4 GHz | <2 km | Medium | Easy integration | Short range
XBee-PRO 900HP | 5–15 km | Med–High | Reliable | Higher power
ESP-NOW | <1 km | Medium | Low latency | Not long-range
Cellular LTE | Global | High | Unlimited range | Network dep.

### 2.2.1 Antenna Link-Budget Justification

From local N4 antenna justification analysis, the free-space path loss for a 900 MHz link

can be modeled using:

F SP L(dB) = 20 log10(d) + 20 log10(f) − 147.55 | (2.1)

At f ≈ 915 MHz and d = 5000 m, F SP L ≈ 105.66 dB. The received power estimate is:

Prx = Ptx + Gtx + Grx − F SP L | (2.2)

For Ptx = 24 dBm and approximately +2 dBi gain at each end, Prx ≈ −77.66 dBm,

yielding a margin of roughly +32 dB relative to a −110 dBm sensitivity in long-range

mode [8, 9]. This supports the feasibility of the target range under near line-of-sight

conditions.

Dipole antennas exhibit radiation nulls along the antenna axis (the “donut” effect), so link

quality can degrade sharply when antenna orientation is unfavorable. Practical mitigation

includes deliberate ground-station antenna tilt toward the expected trajectory and, where

possible, higher-gain directional ground antennas [10].

Chapter 2. Literature Review | 7


Figure 2.4: 900 MHz duck antenna used in the N4 telemetry configuration


Figure 2.5: Dipole radiation pattern illustrating axis nulls that can cause overhead signal

dropouts


Figure 2.6: Example 900 MHz Bi-Quad ground-station antenna option for increased link

margin

Chapter 2. Literature Review | 8

### 2.3 Pyrotechnic Deployment Systems

Nakka’s Crimson Powder research provides baseline context for pyrotechnic charge behav-

ior [11]. Practical student implementations must balance sufficient pressure generation

against thermal and structural risks in the recovery bay.


Figure 2.7: Excessive crimson powder deployment showing the need for precise charge

control

For nichrome-wire ignition, direct battery dump can cause uncontrolled heating, burnout,

and low test repeatability. PWM-based drive regulates average resistive-load power:

Pavg = D

V

2
R

(2.3)

where D is duty cycle. This supports controlled thermal ramping and improves reusable

pre-flight testing workflows [12, 13].

Chapter 2. Literature Review | 9


Figure 2.8: Charge holder thermal damage from explosion highlighting thermal isolation

requirements

### 2.4 Electronic Control Systems

The ESP32 platform offers dual-core architecture suitable for concurrent state estimation,

deployment logic, and telemetry tasks [14,15]. In this project, it also enables deterministic

PWM ignition control and integrated health telemetry.

### 2.5 Power and Structural Systems

LiPo batteries provide favorable energy density but require robust management and me-

chanical retention. High-G launch and deployment events can trigger intermittent connec-

tions in insufficiently constrained holders [16]. Therefore, rigid-constrained and vibration-

tolerant avionics integration is required.

PETG is frequently selected for functional 3D-printed aerospace support parts because it

offers improved ductility and impact tolerance compared with more brittle alternatives,

while retaining practical manufacturability. However, mechanical integrity is strongly de-

Chapter 2. Literature Review | 10


Figure 2.9: Post-deployment test showing charring effects and the importance of sealed

containment

Chapter 2. Literature Review | 11


Figure 2.10: Assembled avionics bay with integrated battery retention and vibration

isolation


Figure 2.11: Current flight-computer holder geometry used for mechanical integration

studies

Chapter 2. Literature Review | 12

pendent on layer adhesion, print orientation, and process settings, requiring conservative

design and test validation for flight use [17–20].

### 2.6 Previous Nakuja Mission Analysis

Table 2.2 summarizes mission outcomes.

Table 2.2: Nakuja Mission History and Key Findings

Mission Date | System | Key Outcome
N-1 | May 2021 | Single deploy | Baseline established
N-2 | Nov 2022 | Single deploy | Telemetry improved
N-3 | 2024 | Enhanced | Range limits identified
N-3.5 | 2024 | Piston deploy | Thermal damage observed
N-4 | Proposed Dual deploy This project

Analysis shows telemetry degradation risks at higher altitudes and adverse orientation

conditions [5]. The XBee-PRO 900HP plus explicit antenna-alignment strategy directly

addresses this limitation.

### 2.7 Safety Standards and Guidelines

Amateur rocketry follows established safety protocols from organizations like Tripoli Rock-

etry Association. Key safety considerations include proper pyrotechnic handling, adequate

descent rates for safe landing, and ground station monitoring capabilities.

### 2.8 Identified Research Gaps

The reviewed literature and Nakuja evidence highlight four unresolved gaps for N4:

Chapter 2. Literature Review | 13


Figure 2.12: XBee-PRO 900HP telemetry system integration showing complete signal

path

1. Charge-energy quantification gap: limited N4-specific data linking charge mass

to pressure and deployment reliability.

2. Ignition repeatability gap: limited validation of reusable PWM-controlled nichrome

workflows in student-rocketry deployment bays.

3. Telemetry-geometry gap: strong theoretical link budget can still fail in practice

without antenna-null mitigation strategy.

4. Structural validation gap: PETG avionics support parts are common but often

lack shock-profile validation for launch/deployment loads.

These gaps define the contribution scope of this project: robust long-range telemetry,

controlled ignition energy delivery, and mechanically resilient avionics integration.

Chapter 2. Literature Review | 14


Figure 2.13: Adiabatic expansion analysis for parachute deployment system design

Chapter 3. Design and Methodology | 15

## 3 Design and Methodology

### 3.1 Design Approach

The project employs systematic design-build-test methodology [2]:

1. Requirements Analysis: Define system specifications based on N4 mission profile
2. Conceptual Design: Develop solution architectures
3. Detailed Design: Create CAD models and circuit schematics
4. Prototyping: Fabricate components
5. Testing and Validation: Conduct ground and flight tests
6. Iteration: Refine designs based on results

### 3.2 Implementation Methodology

### 3.2.1 Mechanical System Design

Sealed Explosion Cap Sealed explosion cap houses Crimson Powder pyrotechnic charge,

containing combustion products while directing pressure for deployment [11]. High-

temperature resistant materials withstand combustion while enabling multiple test cycles.

Avionics Bay Structure Custom 3D-printed PETG holder secures flight computer,

LiPo batteries, and BMS with vibration isolation [16]. Design maintains center of gravity

stability under high-G loads (see current design in Appendix D.3).

Figure 3.1 shows the CAD rendering of the avionics bay assembly with precise mounting

features and component spacing requirements.

Chapter 3. Design and Methodology | 16

images/Current_CAD.PNG

Figure 3.1: CAD rendering of the avionics bay assembly showing component layout,

mounting features, and dimensional constraints

Chapter 3. Design and Methodology | 17

Mechanical Design Integration (Updated Models) The latest mechanical package

introduces revised battery-case geometry, improved threaded-rod routing clearances, and

a cross-sectional avionics bay layout for manufacturability and maintenance access. The

updated models in Figures 3.2–3.4 are sourced from the current design folder and will be

used as the fabrication baseline for the full report.

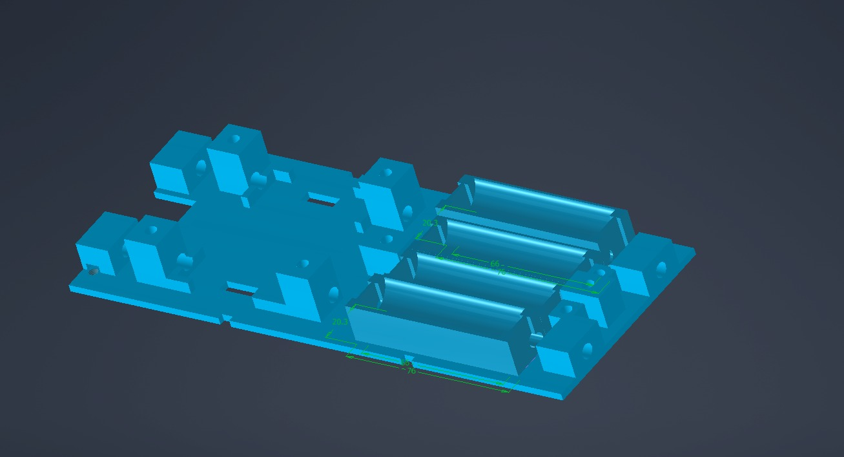
[picture p90: figure]

Figure 3.2: Updated flight-computer holder CAD model showing revised mounting and

battery seating features

### 3.2.2 Electrical System Architecture

Hardware Components ESP32 dual-core microcontroller processes telemetry data

[14]. XBee-PRO 900HP module provides 5+km range at 900 MHz [8]. Custom PCB elim-

inates loose connections [15]. Current circuit implementation is detailed in Appendix D.2.

PWM Ignition Control MOSFET-based PWM driver controls nichrome wire heating,

preventing burnout while enabling reusable testing [12].

Power Management BMS monitors LiPo battery health [21, 22]. Real-time feedback

transmits battery voltage and igniter continuity. Launch inhibit activates below 14.0V

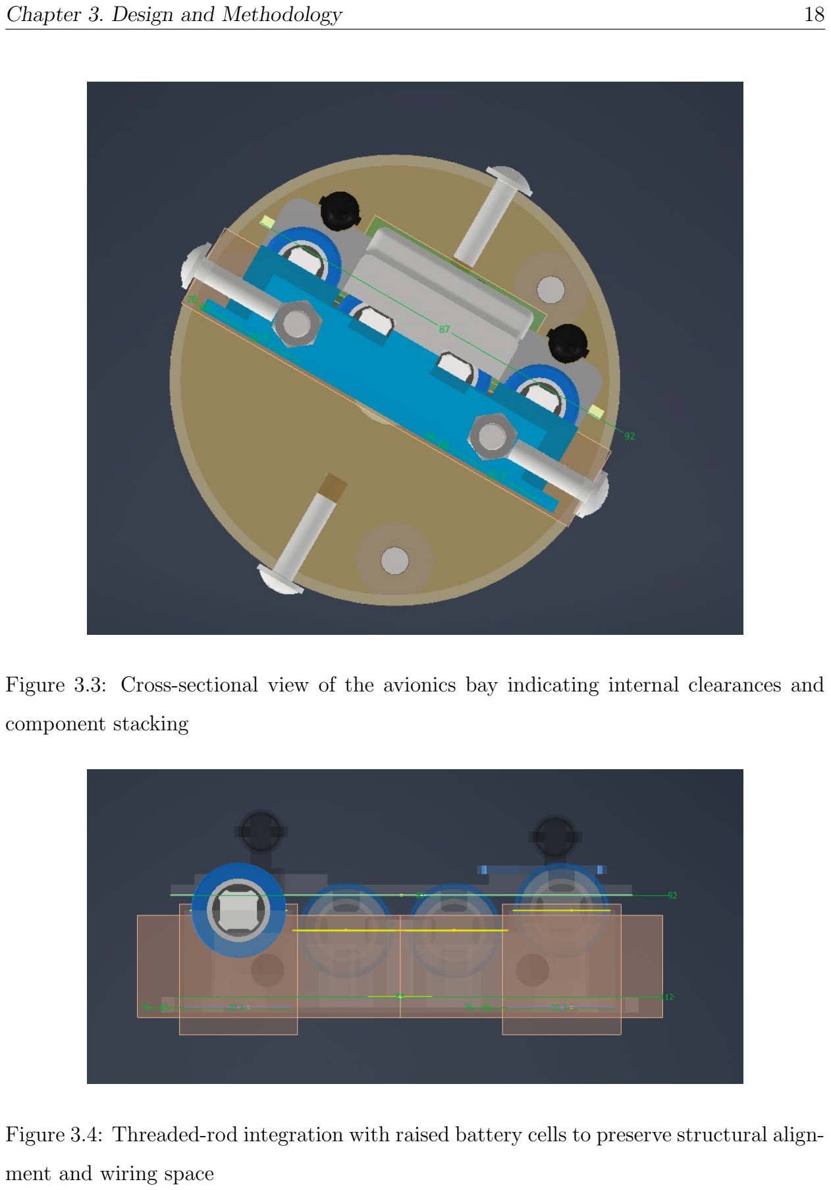
[picture p91: page 28]

Chapter 3. Design and Methodology | 18

Figure 3.3: Cross-sectional view of the avionics bay indicating internal clearances and

component stacking

Figure 3.4: Threaded-rod integration with raised battery cells to preserve structural align-

ment and wiring space

Chapter 3. Design and Methodology | 19

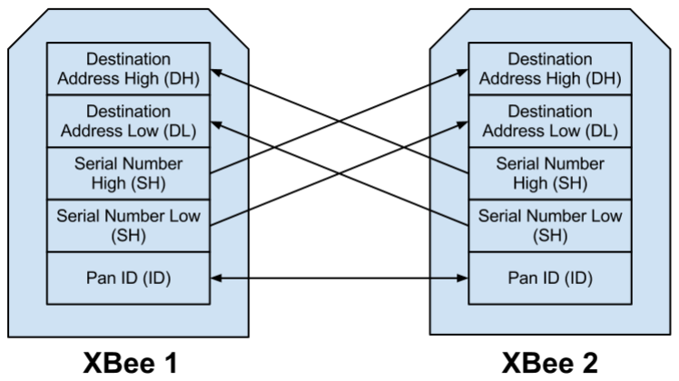
[picture p92: figure]

Figure 3.5: Proposed XBee-PRO 900HP telemetry system architecture


Figure 3.6: Nichrome wire demonstration showing thermal melting and cutting mechanism

- illustrating the one-shot deployment characteristic

Chapter 3. Design and Methodology | 20

threshold.

The battery management system employs an ADS1115 16-bit analog-to-digital converter

for precise voltage and chute state monitoring. Battery voltage is acquired through a

47kΩ / 10kΩ voltage divider network providing a measurement range of 12V to 16.8V.

The voltage measurement formula is calibrated as: Vbattery = VADC ×

57.0
10.0

Chute detection utilizes dual analog inputs (channels 1 and 2) to monitor sensor states.

Signals exceeding 1000 counts indicate deployment readiness. The ADS1115 is configured

with ±4.096V full-scale range gain for optimal resolution across all measured channels.

### 3.2.3 Electrical Design Concepts and Simulations

Figure 3.7 presents the conceptual design of the ground base station RF receiver archi-

tecture, integrating XBee-PRO telemetry with local data logging.

Figure 3.8 shows the XBee extension circuit design for the rocket avionics bay, demon-

strating signal routing and antenna connection topology.

Figure 3.9 illustrates the detailed Proteus schematic and simulation of the battery man-

agement system, showing the ADS1115 ADC configuration, voltage divider network, chute

detection circuits, and power distribution.

### 3.3 Testing and Validation Plan

### 3.3.1 Ground Testing Protocol

Telemetry range testing at 5+ km distances

PWM ignition characterization with thermal imaging

Explosion cap deployment force measurements

Vibration testing on shake table (15G+)

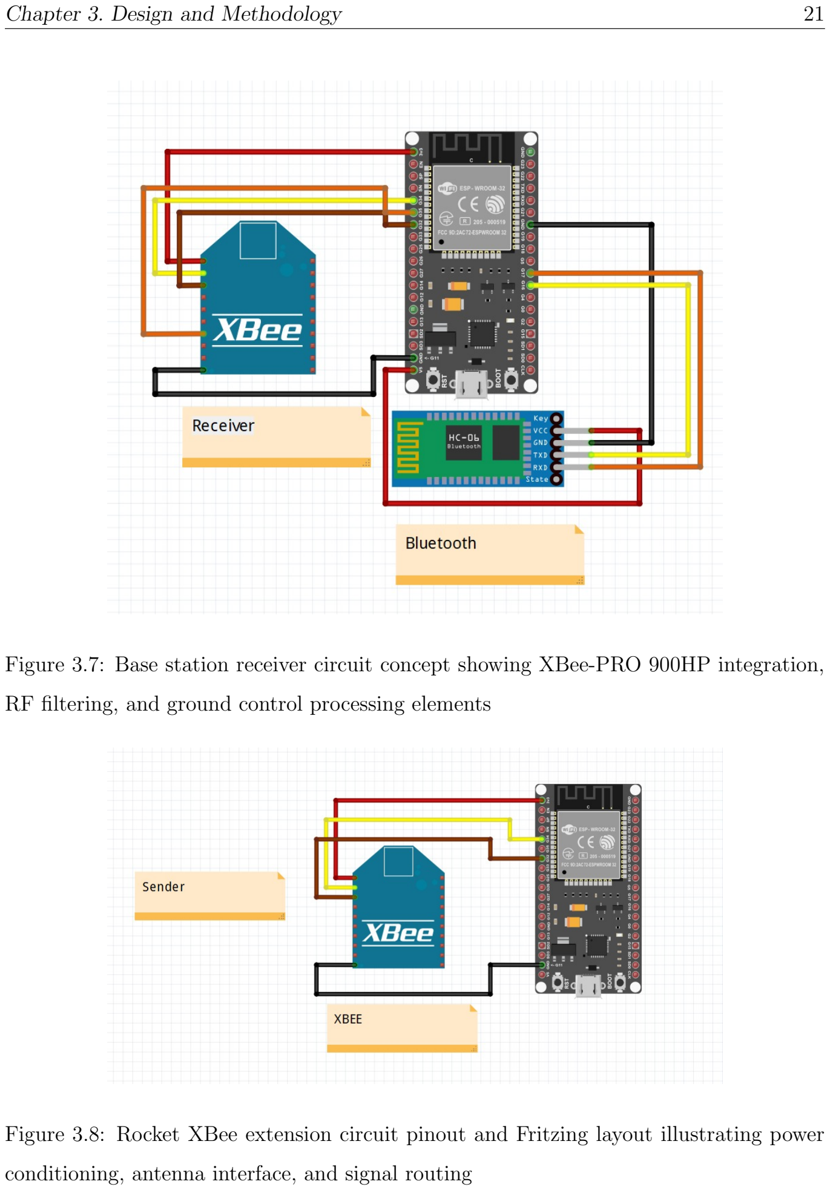
[picture p93: page 31]

Chapter 3. Design and Methodology | 21

Figure 3.7: Base station receiver circuit concept showing XBee-PRO 900HP integration,

RF filtering, and ground control processing elements

Figure 3.8: Rocket XBee extension circuit pinout and Fritzing layout illustrating power

conditioning, antenna interface, and signal routing

Chapter 3. Design and Methodology | 22

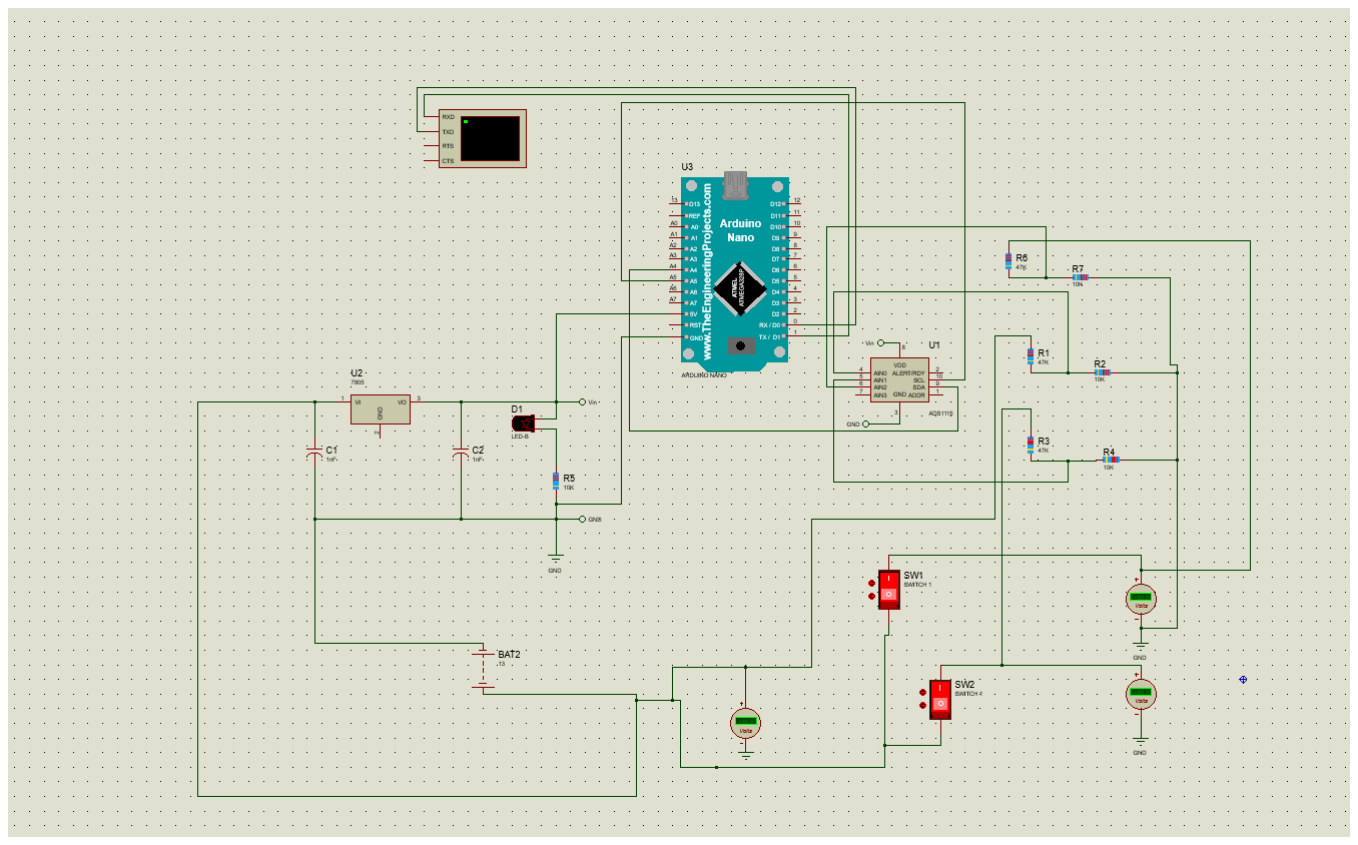
[picture p94: figure]

Figure 3.9: Battery Management System Proteus design showing ADS1115 ADC with

voltage divider (47kΩ/10kΩ), dual chute detection inputs, and power distribution topol-

ogy

Chapter 3. Design and Methodology | 23

Full system integration verification

### 3.3.2 Flight Testing Protocol

Progressive testing: low-altitude validation flights before full mission profile.

Chapter 4. Expected Outcomes | 24

## 4 Expected Outcomes

### 4.1 Technical Performance

Telemetry: Continuous data up to 5 km altitude, ¡5% packet loss [8]

Recovery: Zero thermal damage to parachute, controlled descent (¡5 m/s landing)

[23]

Electronics: Reliable PCB withstanding 15G+ vibration [16]

Mechanical: Vibration-proof avionics holder, no component displacement

Safety: Launch inhibit at ¡14.0V, dual-redundant ignition circuits

### 4.2 Project Timeline

15-week implementation: Planning/Design (Weeks 1-5), Procurement/Fabrication (Weeks

4-8), Integration/Testing (Weeks 9-12), Validation (Weeks 13-15). Detailed timeline in

Appendix B.

### 4.3 Knowledge Contribution

Project documentation will provide:

XBee-PRO 900HP performance validation in African high-altitude context

PWM ignition characterization for student rockets

Explosion cap design specifications

Lessons learned for Nakuja Project and broader community

Chapter 5. Conclusion | 25

## 5 Conclusion

The proposed dual recovery system for the N4 rocket addresses critical gaps in current stu-

dent rocketry recovery systems through comprehensive integration of advanced telemetry,

controlled deployment mechanisms, and real-time monitoring capabilities. The implemen-

tation of XBee-PRO 900HP telemetry eliminates range limitations that have historically

compromised mission success, while PWM-controlled ignition enables reusable deploy-

ment testing and eliminates thermal damage risks to recovery systems.

The sealed explosion cap design represents a significant advancement in deployment reli-

ability, ensuring consistent performance while protecting critical parachute components.

Integration of real-time feedback systems for battery voltage and igniter continuity pro-

vides ground operators with unprecedented visibility into system status, enabling proac-

tive identification of potential failure modes before launch operations.

This project establishes a foundation for future high-power rocketry missions within the

Nakuja project and contributes valuable empirical data regarding charge-to-ejection force

relationships and ruggedized avionics design for student rocket applications. The modular

system architecture enables future enhancements and adaptations for subsequent missions

while maintaining core reliability improvements achieved through this development effort.

Successful completion of this project will significantly improve mission success probability

for the N4 rocket while providing a validated design reference for future student rocketry

recovery system development. The lessons learned and documentation generated will serve

as valuable resources for the Nakuja Project and the broader student rocketry community.

REFERENCES | 26

## References

[1] R. Nakka, “Rocket recovery systems,” https://www.nakka-rocketry.net/, 2024, ac-

cessed: December 2024.

[2] E. Mitchell and S. Brown, “Design considerations for student competition rockets,”

Journal of Engineering Education, vol. 109, no. 4, pp. 654–671, 2020.

[3] K. R. Anderson and L. M. Peterson, “Optimization of dual deployment recovery

systems for high-power rocketry,” Journal of Pyrotechnics, vol. 31, pp. 45–58, 2021.

[4] M. K. Johnson and R. T. Smith, “Design and testing of parachute recovery systems

for high-power amateur rockets,” Journal of Spacecraft and Rockets, vol. 47, no. 3,

pp. 512–520, 2020.

[5] Nakuja Project, “Design. make. launch. - nakuja project,” https://nakujaproject.

com/, (https://nakujaproject.com/) 2024, accessed: December 2024.

[6] J. Williams and C. Martinez, “Radio frequency propagation analysis for rocket

telemetry systems,” IEEE Transactions on Antennas and Propagation, vol. 69, no. 8,

pp. 4521–4532, 2021.

[7] M. Davis and S. Lee, “Telemetry solutions for student rocketry applications,” in

International Student Rocket Competition, 2022, pp. 156–164.

[8] Digi International, “Xbee-pro 900hp rf module datasheet,” Product Technical Spec-

ification, 2024, accessed: December 2024.

[9] D. M. Pozar, Microwave Engineering, 4th ed. John Wiley & Sons, 2011.
[10] H. W. Silver, Ed., The ARRL Antenna Book for Radio Communications, 24th ed.

ARRL, the National Association for Amateur Radio, 2019.

[11] R. Nakka, “Crimson powder: A pyrotechnic composition for rocket recovery,” https:

//www.nakka-rocketry.net/crimson.html, 2024, accessed: December 2024.

REFERENCES | 27
[12] L. Chen and R. Kumar, “Pulse width modulation control for reliable pyrotechnic

ignition,” IEEE Transactions on Aerospace and Electronic Systems, vol. 58, no. 4,

pp. 2894–2903, 2022.

[13] M. Barr, “Introduction to pulse width modulation (pwm),” Barr Group,
2001, | accessed: | 2026, | https://barrgroup.com/embedded-systems/how-to/

pwm-pulse-width-modulation. (https://barrgroup.com/embedded-systems/how-to/pwm-pulse-width-modulation)

[14] Espressif Systems, ESP32 Series Datasheet, Espressif Systems, 2024, version 4.2.
[15] R. Peterson and D. Walsh, “Embedded flight computer design for amateur rocketry,”

Journal of Embedded Systems, vol. 15, no. 2, pp. 112–125, 2021.

[16] A. Thompson and M. Garcia, “Vibration isolation techniques for rocket avionics,” in

International Conference on Space Technology, 2022, pp. 89–97.

[17] L. Santana and J. L. Alves, “Mechanical properties of petg parts manufactured by

fused deposition modeling,” Polymer Testing, vol. 93, p. 106991, 2021.

[18] M. Yuan, X. Cui, W. Zhu, and H. Tang, “Development of environmentally friendly

atom transfer radical polymerization,” Polymers, vol. 12, no. 9, p. 1987, 2020.

[19] T. Yao, Z. Deng, K. Zhang, and S. Li, “A method to predict the ultimate tensile

strength of 3d printed polymeric parts under different printing conditions,” Materials,

vol. 13, no. 20, p. 4701, 2020.

[20] R. T. L. Ferreira, I. C. Amatte, T. A. Dutra, and D. Burger, “Experimental char-

acterization and micrography of 3d printed pla and petg with different raster angles

and infill patterns,” Polymers, vol. 13, no. 8, p. 1318, 2021.

[21] W. Zhang and P. Kumar, “Lithium polymer battery performance in aerospace ap-

plications,” Journal of Power Sources, vol. 482, p. 228950, 2021.

REFERENCES | 28
[22] K. Roberts and Y. Chen, “Battery management systems for high-reliability appli-

cations,” IEEE Transactions on Industrial Electronics, vol. 68, no. 11, pp. 10 892–

10 902, 2021.

[23] R. C. Nelson, Atmospheric Flight Mechanics and Descent Dynamics, 2nd ed. Wiley,

2020.

Chapter B. Project Timeline | 29

## A Project Budget

Table A.1: N4 Recovery System Budget Breakdown

Item | Description | Qty | Cost/Unit (KES) | Total (KES)
Telemetry Modules* | Digi XBee-PRO 900HP | 2 | 15,000 | 30,000
Antennas | 900MHz High Gain Antenna | 2 | 2,000 | 4,000
Copper Cladding | PCB Board (15 x 20 cm) | 3 | 200 | 600
Microcontroller | ESP32 Development Board | 1 | 1,800 | 1,800
Sensors | BMP180 + MPU6050 Module | 1 | 4,710 | 4,710
Mosfets | IRL244N (Pack of 5) | 1 | 1,000 | 1,000
Pyrotechnics* | Black/Crimson Powder | 1 | 1,600 | 1,600
Mechanical Parts* | Threaded Rods & Hardware | 1 | 1,000 | 1,000
Filament | PLA (1kg Roll) | 1 | 3,000 | 3,000
Batteries | Lithium-Ion Cells (18650) | 4 | 500 | 2,000
Total (With Purchased) | 49,710
Total (Without Purchased) | 13,110

*Components already available from Nakuja Project inventory. Out-of-pocket expenses:

KES 13,110. Funding sources: Personal contribution (KES 7,000), Nakuja Project allo-

cation (KES 6,110), university facilities for fabrication (in-kind).

## B Project Timeline

Implementation follows a 15-week schedule with critical milestones:

Weeks 1-4: Proposal presentation, continuous presentation, literature review and

design phase

Weeks 5-8: Mechanical, electrical, and control design with interim report submis-

sion

Chapter B. Project Timeline | 30


Figure B.1: 15-week project timeline showing task dependencies and critical path through

design, fabrication, and testing phases

Weeks 9-11: Material requisition, fabrication, and programming

Weeks 12-14: Testing, demonstration, and final report preparation

Week 15: Final report submission and project closeout

Critical path: PCB fabrication (2-week lead time), component procurement (3-week

buffer). Risk mitigation: backup components ordered Week 4, 2-week weather contin-

gency for launch operations.

Chapter C. Antenna and RF Design Analysis | 31

## C Antenna and RF Design Analysis

### C.1 Null Space Signal Pattern

The XBee-PRO 900HP antenna radiation pattern exhibits directional characteristics with

null spaces in certain directions. Understanding these null spaces is critical for ground

station placement and receiver diversity architecture.

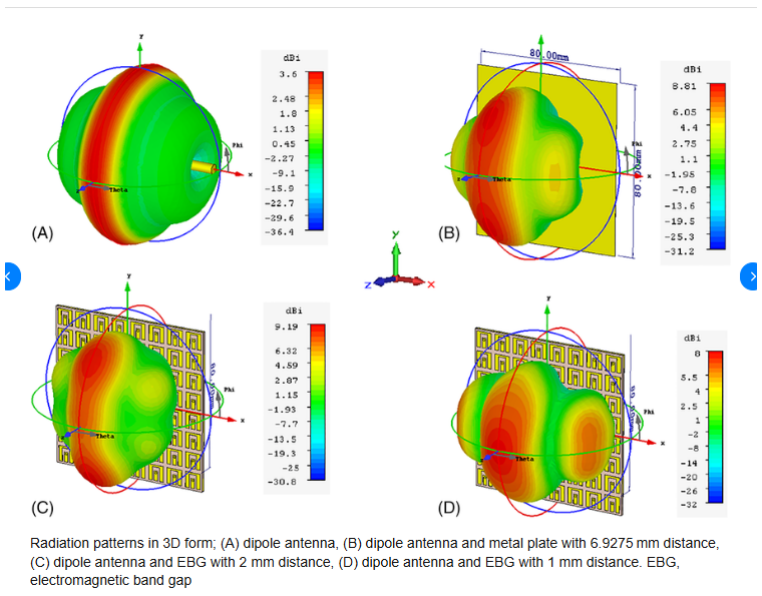
[picture p95: figure]

Figure C.1: XBee-PRO 900HP antenna radiation pattern showing signal strength distri-

bution and null space regions. The pattern demonstrates approximate omnidirectional

coverage in the horizontal plane with defined null zones in vertical extremes

The null space analysis informs receiver antenna placement strategy, requiring minimum

two-antenna diversity system at ground station to maintain continuous signal lock during

all phases of the mission profile.

Chapter D. Previous N4 Design References | 32
C.2 | RSSI Signal Decay Characterization

Figure C.2 presents empirical Received Signal Strength Indicator (RSSI) measurements at

various distances from the airborne transmitter. This data validates the 5+km effective

range specification for the XBee-PRO 900HP system and informs link budget calculations

for launch site selection.

Figure C.2: RSSI signal decay plot showing measured signal strength attenuation with

distance. Data confirms 5+km operational range with sufficient link margin (minimum

-100 dBm receiver sensitivity) throughout nominal flight profile

The empirical RSSI decay curve provides quantitative validation for the telemetry system

design and supports risk mitigation planning for boundary conditions (high-altitude drift,

magnetic anomaly zones, etc.).

## D Previous N4 Design References

Previous Nakuja missions (N1, N2, N3, N3.5) provide critical design heritage and lessons

learned. The N3 single-deployment system identified key improvements needed for the

N4 dual-deployment architecture, particularly in telemetry range extension (from 2km to

5+km) and pyrotechnic deployment reliability (see Figures D.2 and D.3).

Chapter D. Previous N4 Design References | 33

Figure D.1: Nakuja N3 rocket showing avionics bay configuration (reference design for

N4 dual deployment architecture)

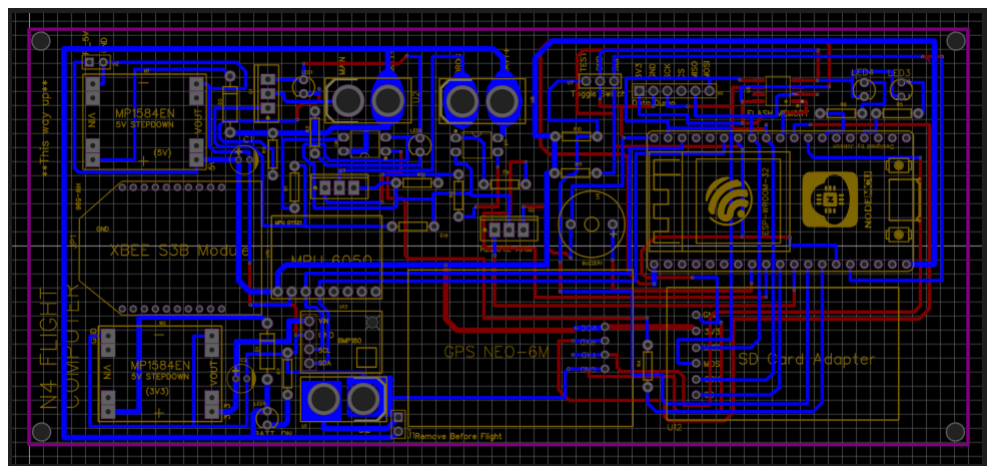
[picture p96: figure]

Figure D.2: Current N4 flight computer circuit design showing ESP32 microcontroller

integration, XBee telemetry module, sensor interfaces (BMP180/MPU6050), MOSFET-

based PWM ignition drivers, and power management circuitry

Chapter E. Nakuja Project Resources | 34

Figure D.3: Current flight computer holder design featuring 3D-printed PETG construc-

tion with integrated battery retention mechanism, vibration isolation mounts, and mod-

ular component placement for easy assembly and maintenance

The current design iterations (Figures D.2 and D.3) represent the latest improvements

incorporating lessons from previous test campaigns, with enhanced vibration isolation and

optimized circuit layout for reliability.

## E Nakuja Project Resources

Project Website: https://nakujaproject.com/

GitHub Repository: https://github.com/nakujaproject

The Nakuja Project maintains open-source repositories for:

Flight computer firmware (ESP32-based)

Ground station telemetry software

PCB design files (KiCAD format)

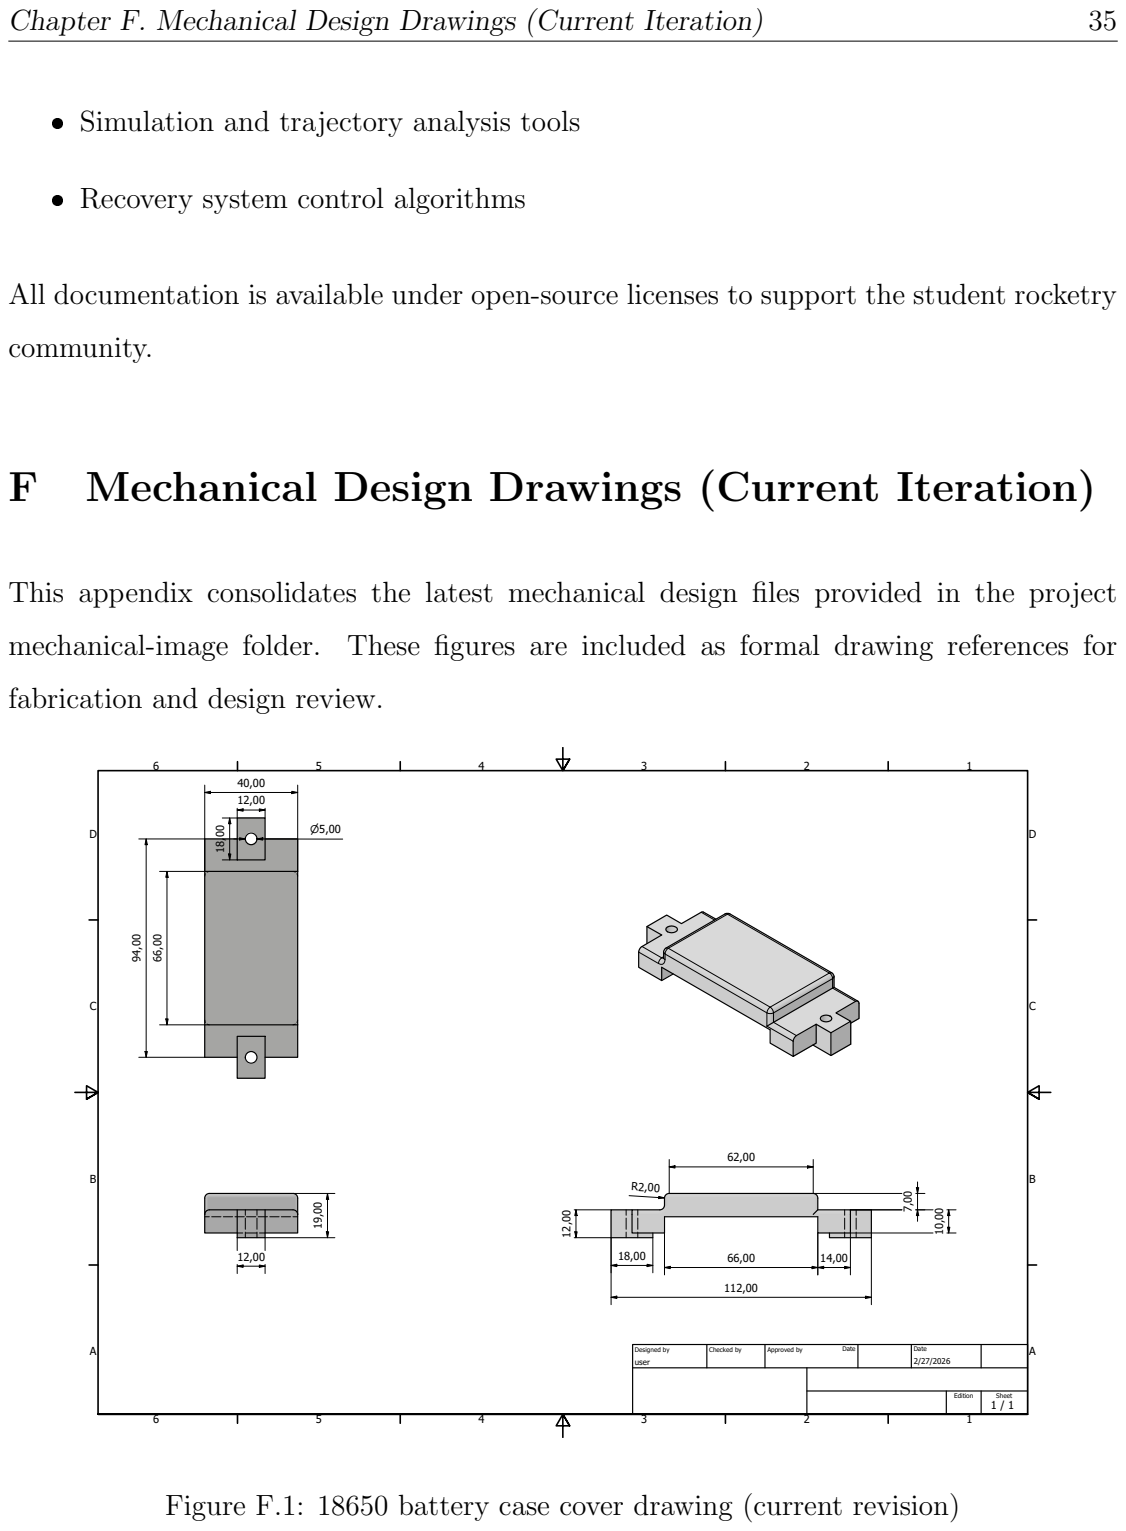
[picture p97: page 45]
Chapter F. Mechanical Design Drawings (Current Iteration); community.; user; Designed by; Checked by; Approved by; Date; Edition; Sheet

Simulation and trajectory analysis tools

 Recovery system control algorithms

All documentation is available under open-source licenses to support the student rocketry

F Mechanical Design Drawings (Current Iteration)

This appendix consolidates the latest mechanical design files provided in the project

mechanical-image folder. These figures are included as formal drawing references for

fabrication and design review.

Figure F.1: 18650 battery case cover drawing (current revision)

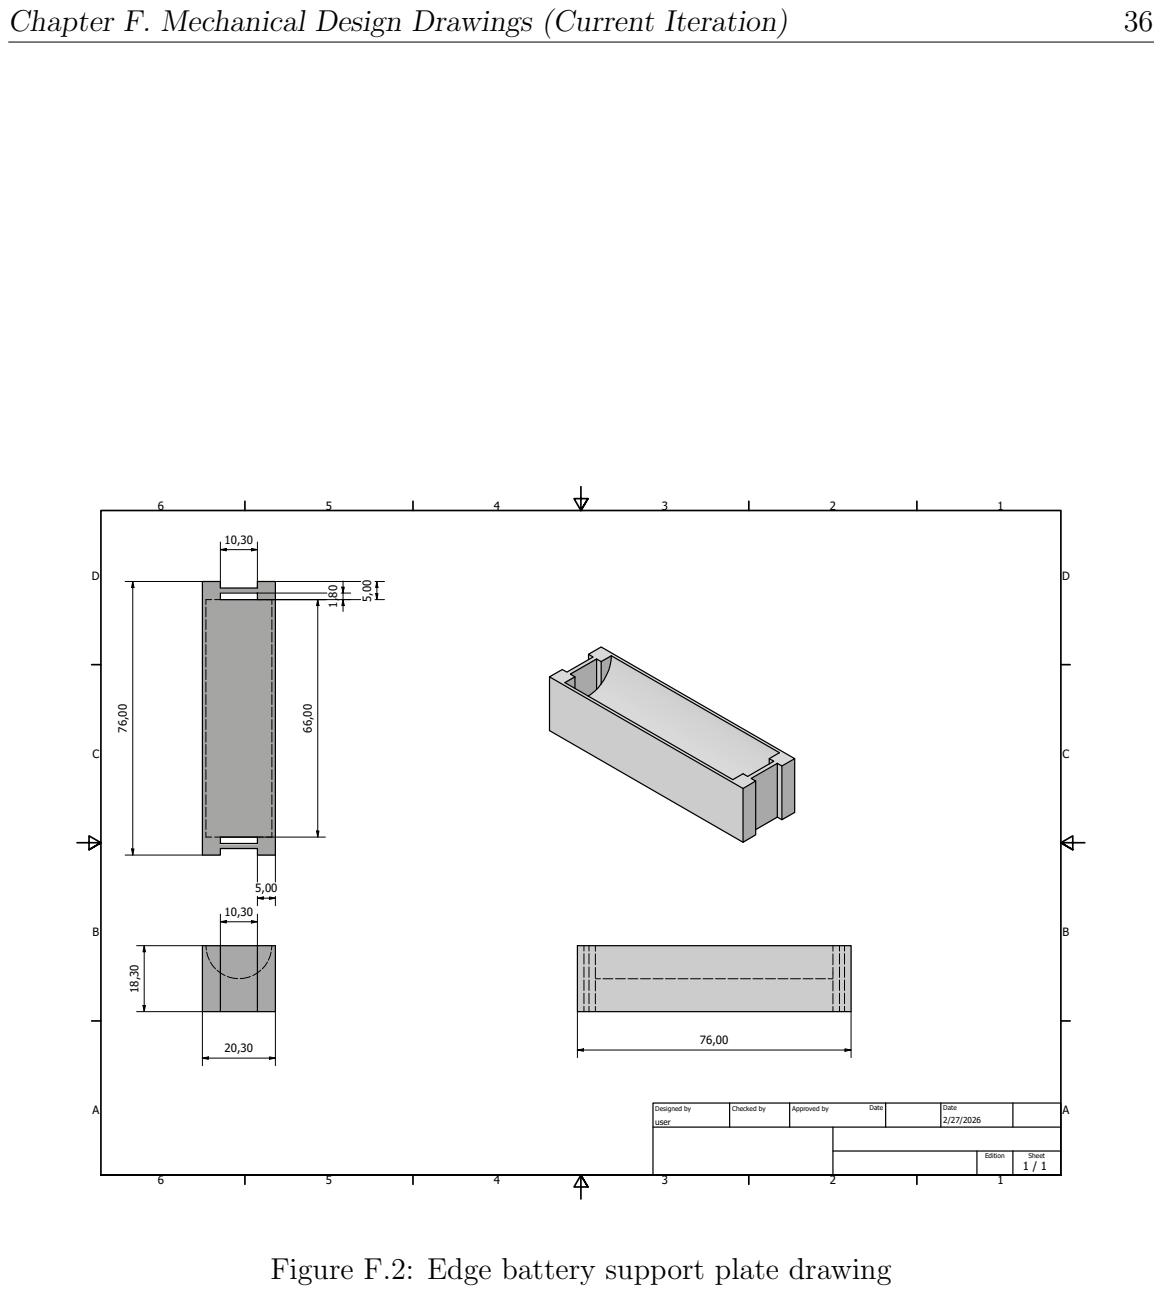
[picture p98: page 46]
Chapter F. Mechanical Design Drawings (Current Iteration); user; Designed by; Checked by; Approved by; Date; Edition; Sheet

Figure F.2: Edge battery support plate drawing

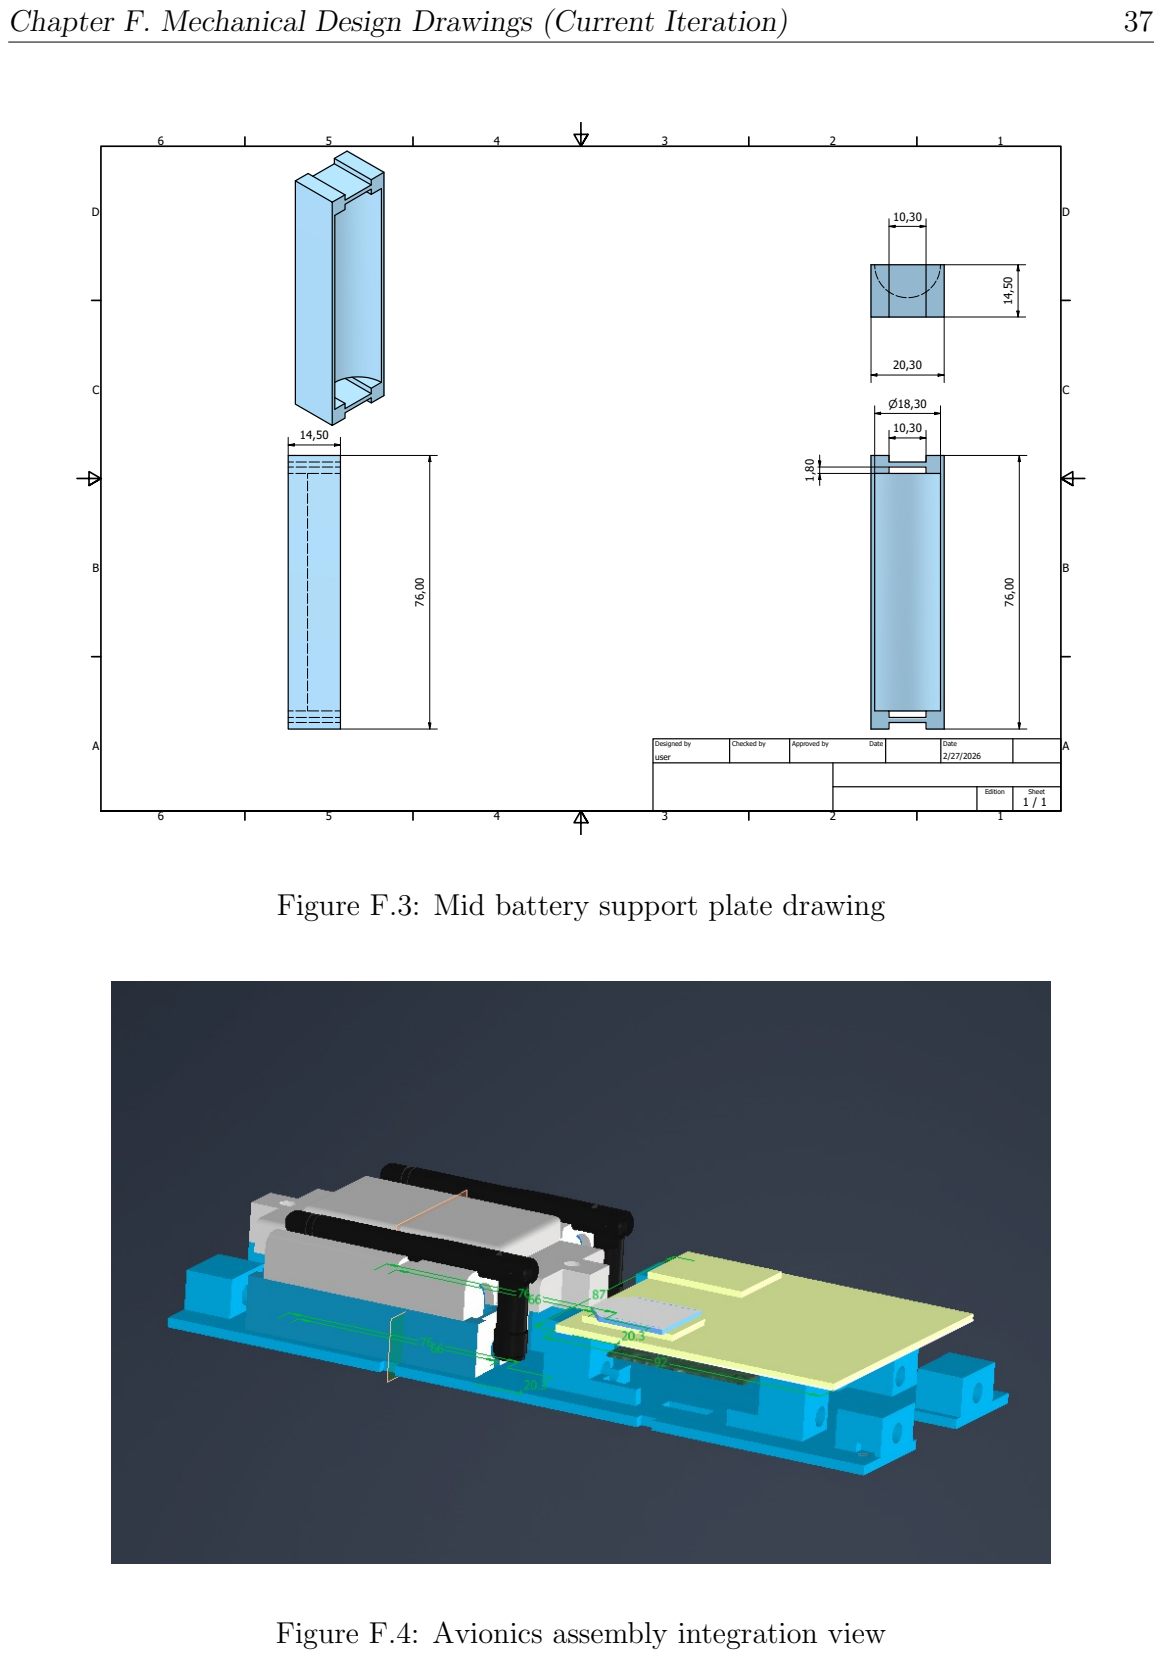
[picture p99: page 47]
Chapter F. Mechanical Design Drawings (Current Iteration); user; Designed by; Checked by; Approved by; Date; Edition; Sheet

Figure F.3: Mid battery support plate drawing

Figure F.4: Avionics assembly integration view
