khanji254/FYP_2025_Recovery/interim_report/context/Interim_Report_Main.pdf

### Jomo Kenyatta University of Agriculture and Technology

### College of Engineering and Technology

### School of Mechanical, Materials, and Manufacturing Engineering

### Department of Mechatronic Engineering

# Modification and Improvement of a Coffee

# Berry Sorting Machine

### (FYP 22-22)

## Interim Report

Joe Annel | (ENM221-0051/2021)
Prosper Muuo | (ENM221-0218/2021)

## Supervisor

### Ms Maureen Andanje

### February 27, 2026

I

## Declaration

We, the undersigned, declare that this Interim Report is our original work undertaken in

partial fulfillment of the requirements for the award of the Bachelor of Science degree in

Mechatronic Engineering from Jomo Kenyatta University of Agriculture and Technology.

This report has not been submitted for any degree or examination in any other institution.

Joe Annel | ENM221-0051/2021
Signature: | Date:
Prosper Muuo | ENM221-0218/2021
Signature: | Date:

This Interim Report has been submitted with my approval as University Supervisor:

Ms Maureen Andanje

Department of Mechatronic Engineering

Jomo Kenyatta University of Agriculture and Technology

Signature: | Date:

II

## Acknowledgments

We would like to express our sincere gratitude to our supervisor, Ms Maureen Andanje, for

her invaluable guidance, encouragement, and technical insights throughout this project.

Her constructive feedback has been instrumental in shaping both the direction and quality

of this work.

We also extend our appreciation to the Department of Mechatronic Engineering at Jomo

Kenyatta University of Agriculture and Technology for providing the resources and facil-

ities necessary for conducting this research.

Special thanks to the previous group whose foundational work on the coffee berry sorting

machine provided the starting point for our modifications and improvements.

Finally, we acknowledge the support of our families and colleagues who provided encour-

agement throughout the course of this project.

III

## Abstract

Automated coffee berry sorting is a critical step in improving the quality and efficiency

of coffee processing, particularly for small- and medium-scale producers in Kenya. This

project addresses the limitations of an existing image-based sorting machine developed by

fifth-year mechatronics students at JKUAT, which employed a Raspberry Pi vision system

and air-ejection actuation. Key challenges identified include processing latency, motion

blur under dynamic conveyor conditions, and insufficient classification throughput.

This interim report presents the work completed to date, covering a review of relevant lit-

erature on computer vision-based sorting systems, the proposed methodology for improv-

ing the system, and progress achieved. A custom YOLOv11 object detection model has

been trained on a dataset of harvested coffee berry images, targeting four ripeness classes:

unripe, semi-ripe, ripe, and overripe. Initial evaluation results demonstrate promising de-

tection performance, with the model achieving competitive mean average precision (mAP)

values at moderate inference speeds.

The remaining work focuses on integrating the trained model with the physical sorting

machine, validating real-time performance on the conveyor, and optimizing the detection-

to-actuation pipeline for improved throughput and reduced latency. A detailed work plan

for the completion of remaining objectives is also presented.

Keywords: Coffee berry sorting, YOLOv11, computer vision, conveyor, real-time detec-

tion, Raspberry Pi, mechatronics

IV

## Contents

Declaration | I
Acknowledgments | II
Abstract | III

CONTENTS | V
3.4.4 | Transistor Technology Selection: BJT vs. Logic-Level MOSFET . . 35

CONTENTS | VI

VII

## List of Figures

1.1 Harvested coffee berry variation showing visual diversity in colour, size,

and surface texture | | 2
2.1 Ripe coffee berries showing colour variation from green to deep red . . . . | 6

2.2 Reference model validation predictions showing four-class classification (un-

ripe, semi-ripe, ripe, overripe) with visible confusion between visually sim-

ilar categories | 9

2.3 Reference model F1-score performance across the four ripeness categories,

highlighting the classification difficulty at the semi-ripe/ripe boundary . . . 10

2.4 Comparison of manual and electronic coffee sorting methods | 11

2.5 Fully fabricated mechanical assembly from the reference implementation

[1], showing integrated hopper, vibrating feeder, chute, and frame structure.

This mechanical subsystem forms the foundation upon which the improved

imaging and control systems are built | 12

2.6 CAD drawing of the air-ejector nozzle assembly from the reference sorting

machine showing solenoid valve, nozzle orientation, and berry deflection

trajectory [1] | 13

2.7 Image processing pipeline for YOLOv11-based sorter on Raspberry Pi 4:

frame capture (global shutter) → pre-processing → YOLOv11 inference →

classification (accept/reject) → ejection control | 16

2.8 Overview of classification approaches considered: classical machine learn-

ing, CNN-based models, and single-stage detectors (YOLO family) | 17

2.9 Visual comparison of ripe (accept) and unripe/semi-ripe (reject) coffee

berries. The binary classification boundary maps to the deep-red colour

transition | 18

2.10 Proposed co-processing architecture: Raspberry Pi 4 handles inference;

ESP32-WROOM-32 manages all hard real-time actuation via UART. . . . 20

LIST OF FIGURES | VIII

3.1 Overall architecture of the improved coffee berry sorting machine: global-

shutter camera, Raspberry Pi 4 inference engine, ESP32 real-time co-

processor, and MOSFET solenoid driver stages | 22

3.2 Co-processing architecture: Raspberry Pi 4 handles image processing and

YOLOv11 classification; ESP32 handles motor control, actuator interfac-

ing, and timing | 28

3.3 System control flow: task distribution between Raspberry Pi 4 (inference

and tracking) and ESP32 (actuation, timing, and PWM control) | 29

3.4 Image processing pipeline for the YOLOv11-based sorter: frame capture

(global shutter) → pre-processing → YOLOv11 inference on Raspberry

Pi 4 → tracking → UART command to ESP32 | 31

3.5 UART communication and data flow between Raspberry Pi and ESP32 . . 32

3.6 Fritzing circuit diagram of the ESP32 solenoid driver implementation: IRLZ44N

MOSFET switching stages, flyback diodes, gate resistors, and Raspberry

Pi UART connection | 37

4.1 Electrical schematic: power distribution, processor connections, actuator

outputs, and communication links | 42

4.2 System block diagram: processor hierarchy, communication links, and ac-

tuator outputs with power distribution | 43

4.3 Complete Proteus ISIS simulation: ESP32 with four IRLZ44N solenoid

driver channels, vibrating motor PWM, LED strip driver, 2-channel opto-

coupler relay, and UART virtual terminal | 44

4.4 Proteus oscilloscope: MOSFET turn-ON — gate rises to 3.3 V and drain

falls from 12 V to ≈0 V with no ringing (IRLZ44N, 220 Ω gate resistor,

100 kΩ pull-down) | 45

4.5 Proteus oscilloscope: MOSFET turn-OFF — drain recovers to 12 V; 1N5819

clamps inductive kickback spike within 0.5 V of the supply rail | 45

4.6 YOLOv11n comprehensive training metrics over 100 epochs showing con-

vergence of loss, precision, recall, and mAP on the binary coffee berry dataset 47

LIST OF FIGURES | IX

4.7 F1-score vs. confidence threshold curve for the YOLOv11n binary classifier,

showing optimal operating point for accept/reject classification | 48

4.8 Precision-Recall curve demonstrating the trade-off between precision and

recall across confidence thresholds for both accept and reject classes . . . . 49

4.9 Normalised confusion matrix on the test split showing classification accu-

racy for accept (ripe) and reject (unripe/semi-ripe/overripe) categories . . 50

4.10 Ground truth label distribution visualisation showing the spatial distribu-

tion and class balance of accept and reject instances across the training

dataset | 51

4.11 Validation batch 0 with ground-truth bounding box annotations for accept

(ripe) and reject (unripe/semi-ripe) berries | 52

4.12 YOLOv11n inference output on validation batch 0: predicted accept/reject

bounding boxes with confidence scores demonstrating the model’s classifi-

cation performance on unseen test images | 53

4.13 System control flow: Pi 4 handles image processing and YOLOv11 infer-

ence; ESP32 handles motor control, timing, and actuation | 55
A.1 Electrical schematic | 61
A.2 ESP32 pin mapping schematic | 62
A.3 Circuit implementation layout (Fritzing) | 63
A.4 Proteus full-circuit simulation | 63
B.1 Project schedule from the approved proposal | 64
B.2 Project budget from the approved proposal | 64
C.1 Reference model F1 curve | 65
C.2 Reference model validation batch labels | 66
D.1 Bottom plate technical drawing with dimensions and specifications | 67

D.2 Chute assembly technical drawing with dimensions and specifications . . . 68

D.3 Chute mounting bracket technical drawing with dimensions and specifications 69

D.4 Vibrating feeder trough technical drawing with dimensions and specifications 70

D.5 Hopper assembly technical drawing with dimensions and specifications . . 71

X

## List of Tables

2.1 Literature gaps and corresponding improvements in this project | 21
3.1 Binary coffee berry classification scheme | 25
3.2 YOLOv11 training hyperparameters | 26
3.3 Raspberry Pi, ESP32, and Peripheral Wiring Assignment | 34

3.4 BJT (PN2222A) vs. Logic-Level MOSFET (IRLZ44N) switching comparison 35

4.1 Measured baseline performance of existing sorting machine | 40
4.2 Dataset split summary (2,000-image binary dataset) | 47
4.3 YOLOv11n evaluation results on test split | 50
4.4 Progress summary against specific objectives | 56

Chapter 1. Introduction | 1

## 1 Introduction

## 1.1 Background of Study

The global coffee industry remains a significant contributor to the economies of many

developing countries, supporting millions of smallholder farmers worldwide. Coffee pro-

duction involves several critical stages, from cultivation and harvesting to processing and

packaging. Among these stages, the sorting of coffee berries is one of the most labor-

intensive and quality-sensitive processes. Traditionally, coffee berry sorting has relied

heavily on manual visual inspection, where workers separate berries based on ripeness,

size, and visible defects. This approach is time-consuming, inconsistent, and costly, often

leading to variations in coffee quality and increased operational expenses.

Manual sorting methods are highly susceptible to human error and fatigue, which can

result in misclassification of berries and reduced overall product quality. Furthermore,

the labor-intensive nature of manual sorting limits scalability and efficiency, particularly

during peak harvest periods when labor shortages are common. These challenges highlight

the need for automated sorting solutions capable of performing classification tasks with

higher accuracy, consistency, and throughput.

Recent advancements in computer vision, machine learning, and embedded systems have

enabled the development of automated coffee berry sorting machines that utilize image-

based detection and real-time classification techniques. Previous work by fifth-year mecha-

tronics engineering students resulted in the development of an image-based coffee berry

sorting machine incorporating a vibrating conveyor system, optical detection, and air-

ejection mechanisms controlled by a Raspberry Pi-based processing unit. While the sys-

tem successfully demonstrated automated sorting, practical challenges were identified

during real-time operation, particularly related to motion blur, processing latency, and

limited computational throughput.

Chapter 1. Introduction | 2

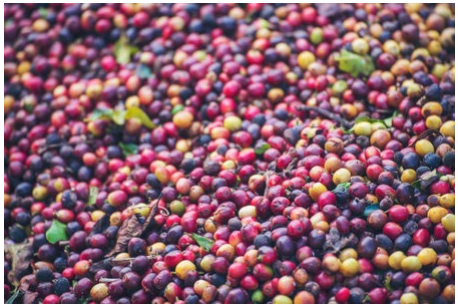
[picture p100: figure]

Figure 1.1: Harvested coffee berry variation showing visual diversity in colour, size, and

surface texture

The visual diversity in harvested coffee berries—including variations in colour, size, and

surface texture, as illustrated in Figure 1.1—presents a significant challenge for accurate

automated classification.

This project proposes the modification and improvement of the existing coffee berry sort-

ing machine by addressing the identified limitations in image acquisition, processing speed,

and real-time classification performance. By enhancing the vision processing pipeline,

optimizing algorithms, and evaluating alternative hardware or processing architectures,

the project aims to improve sorting accuracy and throughput while maintaining a cost-

effective and scalable design.

## 1.2 Problem Statement

The quality of coffee berries at the processing stage directly determines the final product

grade, market value, and competitiveness in both local and international markets. Despite

Chapter 1. Introduction | 3

the successful demonstration of automated sorting in the previous system, it exhibits

several critical technical limitations:

1. Motion blur and illumination inconsistency: Dynamic motion of berries on

the conveyor and variable ambient lighting introduce image degradation, reducing

classification accuracy.

2. Processing latency: The limited computational capacity of the Raspberry Pi 3

causes delays across the frame acquisition, preprocessing, inference, and actuation

pipeline, constraining throughput.

3. Model accuracy and class confusion: The original four-class model confused vi-

sually similar semi-ripe and ripe berries, causing commercially acceptable red berries

to be rejected and semi-ripe berries to pass into the accept stream, reducing eco-

nomic yield.

There is a clear need to improve the vision system, processing architecture, and real-time

control strategy to achieve higher throughput, lower latency, and improved classification

accuracy.

## 1.3 Objectives

### 1.3.1 Main Objective

To modify and improve an existing automated coffee berry sorting machine.

### 1.3.2 Specific Objectives

1. To analyse the performance limitations of the existing image-based coffee berry

sorting system, with emphasis on motion blur, processing latency, and classification

accuracy.

Chapter 1. Introduction | 4
2. To improve on the sorting mechanism.
3. To evaluate alternative or upgraded processing hardware capable of supporting

higher frame rates and faster inference.

## 1.4 Justification

Coffee remains one of Kenya’s most valuable agricultural exports, and quality grading

plays a major role in determining its economic value. Automated sorting systems offer

a practical solution for improving quality consistency and reducing labour dependency.

Improving the existing image-based system provides a cost-effective pathway by building

upon already validated concepts while addressing observed technical shortcomings.

The proposed improvements are expected to:

1. Enhance accuracy and throughput in coffee berry sorting.
2. Enable better utilisation of affordable embedded vision technologies.
3. Increase the feasibility of locally developed agri-tech solutions.
4. Contribute practical learning and innovation in mechatronics system integration.

## 1.5 Scope of the Project

This project is limited to the modification and improvement of the existing coffee berry

sorting machine. Specifically:

The mechanical conveyor and air-ejection hardware remain unchanged from the

original design unless critical faults are identified.

Focus is placed on the vision and control sub-systems: camera selection, lighting,

model training, inference pipeline, and microcontroller–Pi communication.

Chapter 1. Introduction | 5

Classification uses a binary ACCEPT/REJECT scheme: the accept class covers

uniform deep-red ripe berries; the reject class covers unripe (green), semi-ripe

(yellow/orange), overripe (dark/black), and physically damaged berries. This aligns

with Kenyan cooperative grading practice.

Deployment targets the Raspberry Pi 4 or equivalent single-board computer for

embedded inference.

## 1.6 Expected Outcomes

Upon completion of this project, the following outcomes are expected:

1. A YOLOv11-based coffee berry detection model achieving binary classification ac-

curacy >90% (mAP@0.5) on the accept/reject scheme, replacing the existing

MobileNetV2 classifier.

2. An end-to-end sorting pipeline latency of less than 100 ms (detection to solenoid

trigger), achieved through the Pi 4 + ESP32 co-processing architecture.

3. Sorting throughput exceeding 150 berries per minute, an improvement over the

baseline of approximately 35 berries per minute.

4. A validated Proteus circuit simulation of the ESP32 control circuit prior to physical

implementation, confirming correct solenoid switching, UART timing, and motor

PWM behaviour.

5. A fully characterised and validated sorting system with documented design draw-

ings, test results, and a reproducible codebase.

Note: These expected outcomes are defined here, prior to system implementation. Actual

results and performance comparisons are presented in Chapter 4.

Chapter 2. Literature Review | 6

## 2 Literature Review

The global coffee industry plays a critical role in the economies of many developing coun-

tries, including Kenya, where it provides livelihoods to millions of smallholder farmers.

Coffee processing involves several critical stages, among which the sorting of coffee berries

determines final product quality and market value. The presence of unripe, overripe, or

defective berries significantly degrades cup quality, leading to price penalties and rejection

by premium buyers [2].

Automated sorting systems based on machine vision offer a path to consistent, high-

throughput grading. A previous fifth-year project at this institution developed an image-

based coffee berry sorting machine that demonstrated the feasibility of automated sorting

but revealed significant technical gaps in real-time performance. This review surveys

the relevant literature, documents the previous system and its known limitations, and

identifies the specific gaps addressed by this work.

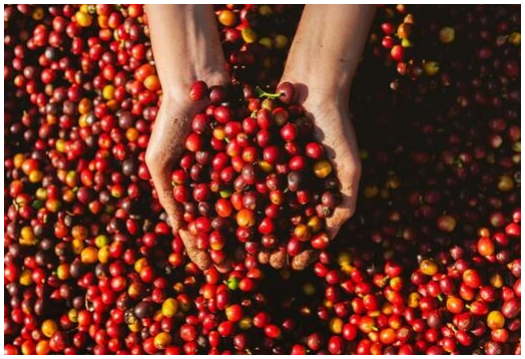
[picture p101: figure]

Figure 2.1: Ripe coffee berries showing colour variation from green to deep red

Chapter 2. Literature Review | 7

## 2.1 The Reference Project: Previous Coffee Berry Sorting Ma-

## chine

The foundation of this work is a fifth-year mechatronics engineering project that devel-

oped an automated coffee berry sorting machine [1]. That system established the core

mechanical and electronic architecture on which this project builds.

### 2.1.1 System Architecture of the Reference Machine

The reference system integrated four main subsystems:

1. Mechanical handling: A vibrating eccentric-motor tray singulated berries from

a hopper onto an inclined chute. Gravity and vibration aligned berries into a near-

single-file stream before the imaging zone.

2. Image acquisition: A Raspberry Pi Camera Module V2 (rolling shutter, 8 MP

Sony IMX219) captured frames above the chute at fixed intervals.

3. Classification: A MobileNetV2-derived model [3], deployed as a TensorFlow Lite

INT8 quantised file on the Raspberry Pi 3B+, performed per-frame berry classifi-

cation.

4. Actuation: Compressed-air solenoid jets, triggered by the Pi’s GPIO pins, de-

flected reject-class berries into separate chutes; accepted berries continued to the

accept bin under gravity.

The mechanical chute and vibrating feeder proved robust and reliable in field testing. This

project retains that mechanical subsystem unchanged, focusing improvements exclusively

on the electronics, vision, and software layers.

Chapter 2. Literature Review | 8

### 2.1.2 Identified Limitations of the Reference Machine

Post-build evaluation of the reference machine identified three critical performance bot-

tlenecks [1]:

1. Motion blur: The rolling-shutter sensor read out rows sequentially over a ∼30 ms

window. At operating chute speeds of 0.4–0.6 m s⁻¹
, berries translated 12–18 mm

per frame, producing visible smearing that degraded classification confidence, par-

ticularly at the semi-ripe/ripe colour boundary.

2. Processing latency: Running MobileNetV2 inference, GPIO triggering, and cam-

era I/O on a single Raspberry Pi 3B+ core produced end-to-end latency of 280–

400 ms per berry. This limited practical throughput to approximately 35 berries per

minute—far below the commercial target of >150 per minute.

3. Fine-grained class confusion: The four-class model (unripe, semi-ripe, ripe,

overripe) struggled with the visually similar semi-ripe and ripe classes. This confu-

sion produced mis-ejections: commercially acceptable red berries were rejected and

semi-ripe berries were accepted into the output stream, reducing economic yield.

Figures 2.2 and 2.3 illustrate the performance characteristics of the reference four-class

MobileNetV2 model, showing the classification challenges across the four categories.

Chapter 2. Literature Review | 9

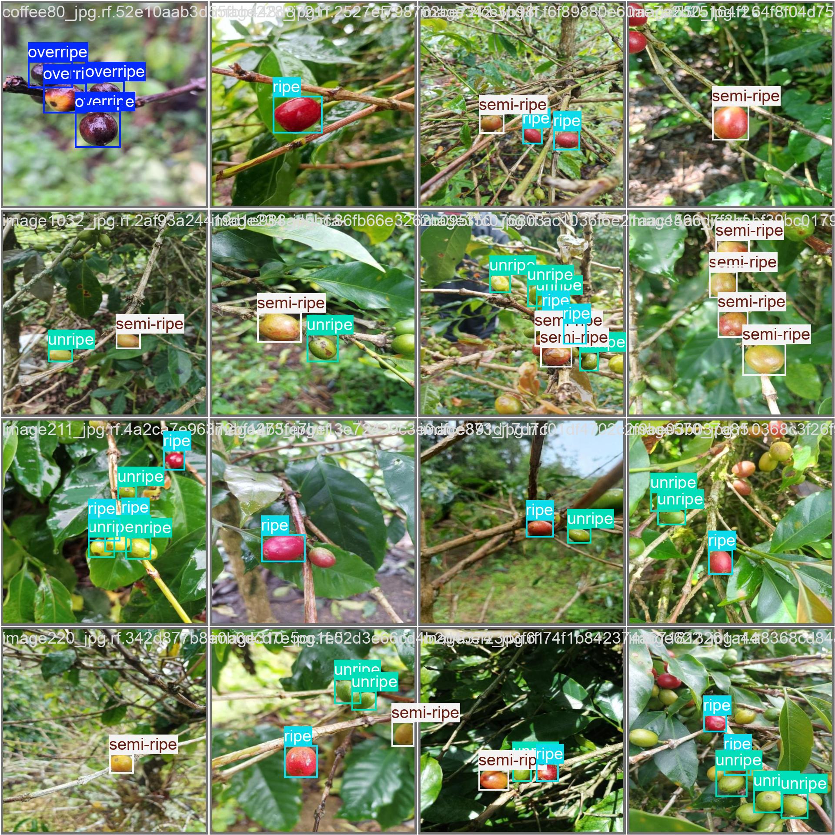
[picture p102: figure]

Figure 2.2: Reference model validation predictions showing four-class classification (un-

ripe, semi-ripe, ripe, overripe) with visible confusion between visually similar categories

Chapter 2. Literature Review | 10

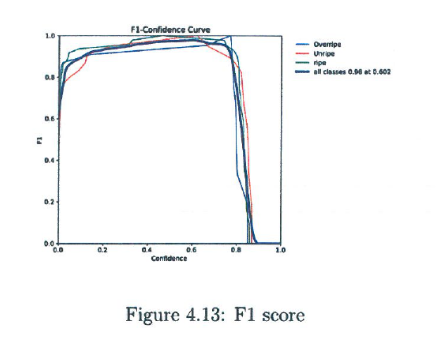
[picture p103: figure]

Figure 2.3: Reference model F1-score performance across the four ripeness categories,

highlighting the classification difficulty at the semi-ripe/ripe boundary

## 2.2 Challenges of Manual and Early Automated Sorting

### 1. Labour Intensity and Fatigue: Prolonged visual inspection leads to fatigue, reduc-

ing sorting accuracy and consistency [2]. Fatigued workers are more likely to misclassify

berries, allowing defective berries to pass or rejecting acceptable ones.

### 2. Human Error and Subjectivity: Significant variability in sorting outcomes has

been observed across different shifts, even when standardised grading guidelines were

provided [4]. This subjectivity results in inconsistent quality between batches.

### 3. Limited Throughput: Human sorting speed becomes a bottleneck during peak

harvest seasons [5]. Automated systems address this but introduce the challenges of

motion blur, latency, and fine-grained class confusion documented above.

Chapter 2. Literature Review | 11

## 2.3 Mechanical Material Handling

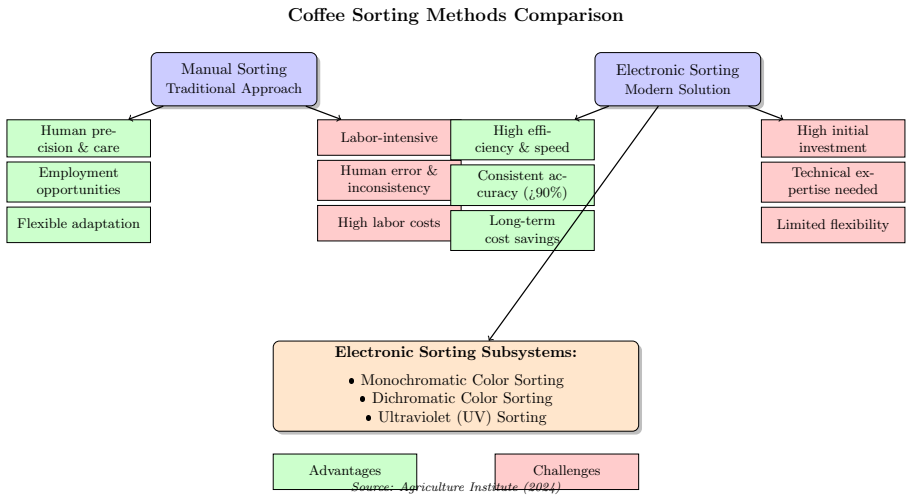
[picture p104: figure]
Coffee Sorting Methods Comparison; Manual Sorting Traditional Approach; Human pre- cision & care; Employment opportunities; Flexible adaptation; Labor-intensive; Human error & inconsistency; High labor costs; Electronic Sorting Modern Solution; High effi- ciency & speed; Consistent ac- curacy (¿90%); Long-term cost savings; High initial investment; Technical ex- pertise needed; Limited flexibility; Electronic Sorting Subsystems:;  Monochromatic Color Sorting  Dichromatic Color Sorting  Ultraviolet (UV) Sorting; Advantages; Challenges; Source: Agriculture Institute (2024)

Figure 2.4: Comparison of manual and electronic coffee sorting methods

Chapter 2. Literature Review | 12

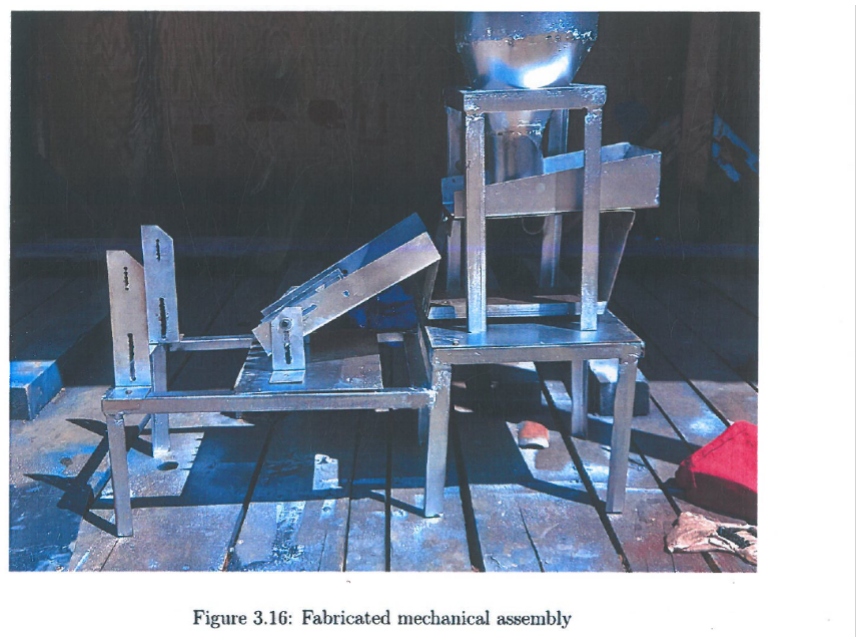
[picture p105: figure]

Figure 2.5: Fully fabricated mechanical assembly from the reference implementation [1],

showing integrated hopper, vibrating feeder, chute, and frame structure. This mechanical

subsystem forms the foundation upon which the improved imaging and control systems

are built.

Vibrating feeder-chute systems are standard in agricultural sorting. The amplitude and

frequency of an eccentric motor are tuned to prevent bridging while maintaining adequate

throughput and berry singulation. Chute inclination angle and surface finish further in-

fluence flow rate and separation. Literature confirms that this approach produces reliably

consistent berry spacing at throughputs of 100–300 berries per minute in laboratory pro-

totypes [6].

The air-jet deflection mechanism, which the reference system uses for separation, operates

on a detect-decide-deflect principle. Berries passing the imaging zone trigger compressed-

air jets timed to deflect reject-class berries into separate chutes while accepted berries con-

tinue by gravity. Key advantages include minimal physical contact and high speed; limita-

Chapter 2. Literature Review | 13

tions include compressed-air infrastructure requirements and tight timing constraints [7].

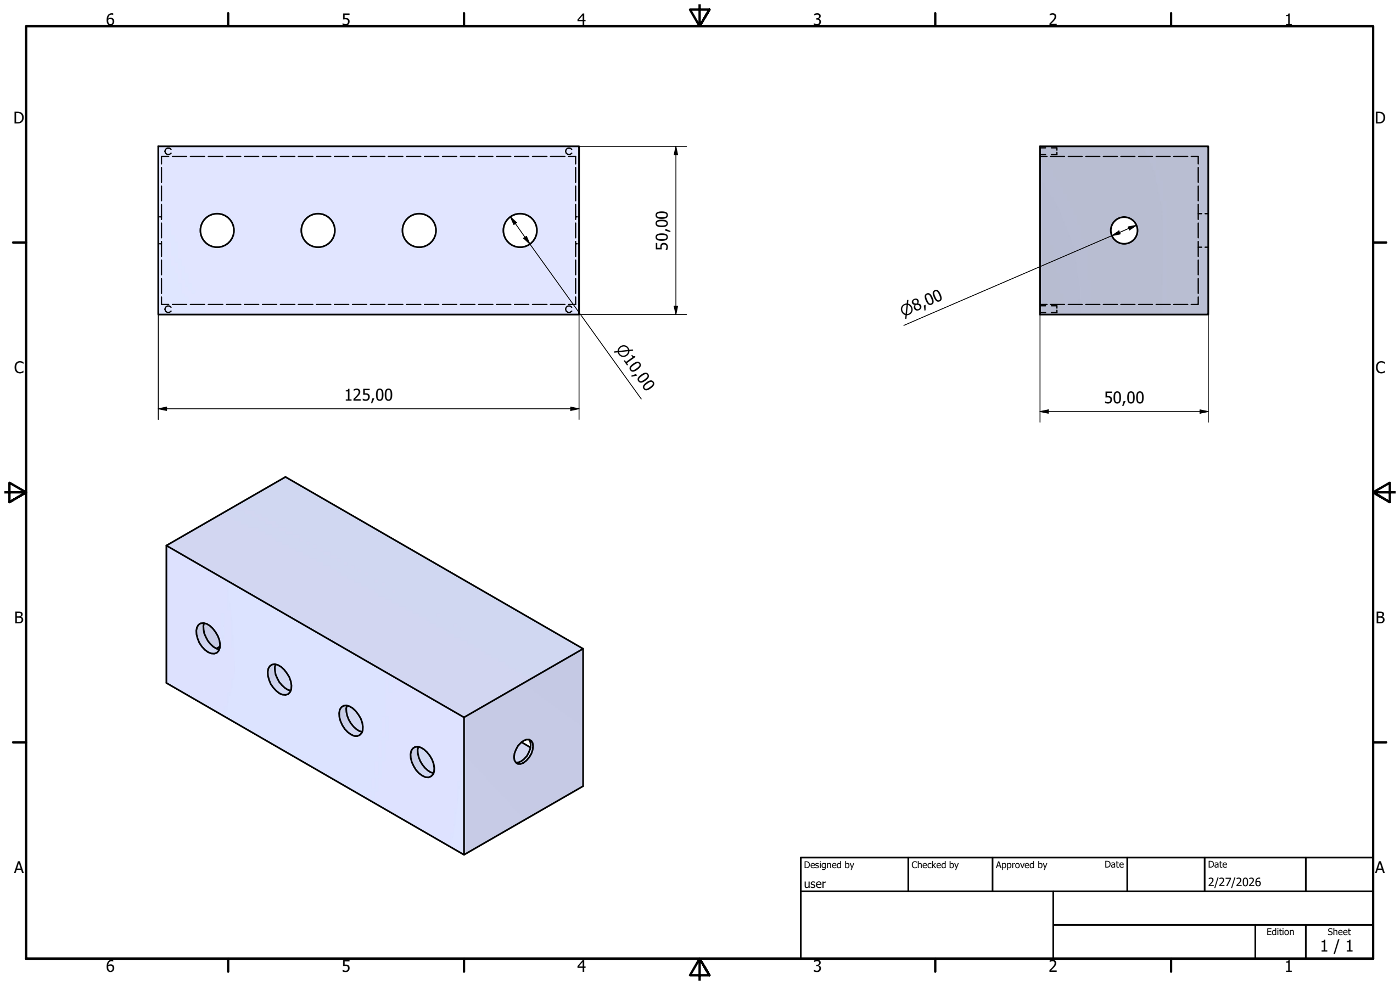
[picture p106: figure]
user; Designed by; Checked by; Approved by; Date; Edition; Sheet

Figure 2.6: CAD drawing of the air-ejector nozzle assembly from the reference sorting

machine showing solenoid valve, nozzle orientation, and berry deflection trajectory [1]

## 2.4 Camera Technology: Rolling Shutter vs. Global Shutter

Conventional CMOS cameras read out pixel rows sequentially (rolling shutter). For static

scenes this is adequate, but when objects move faster than the sensor readout time, each

row captures a slightly different object position, producing a characteristic shear distortion

(jello effect) and edge smearing [8]. In the reference machine this was identified as the

primary source of image degradation.

A global-shutter sensor exposes all pixels simultaneously, eliminating motion-induced

distortion entirely. Global-shutter CMOS sensors (e.g., Sony IMX296, Omnivision OV9281)

achieve effective shutter times of <1 ms at full resolution. At 0.5 m s⁻¹
chute speed, a 1 ms

exposure limits berry translation to 0.5 mm per frame—approximately 40× less motion

Chapter 2. Literature Review | 14

blur than the reference camera. This improvement is critical for reliable colour and texture

classification at the ripe/reject boundary.

For this project, the Arducam OV9281 global-shutter camera module (Raspberry

Pi CSI-compatible, 1 MP, monochrome/colour variants) is proposed as the replacement

imaging sensor, providing freeze-frame clarity even at the target operating chute speed.

## 2.5 Deep Learning Object Detection for Sorting

### 2.5.1 CNN-Based Feature Extraction

Deep convolutional neural networks (CNNs) automatically learn hierarchical features from

labelled image data, eliminating the need for hand-crafted descriptors. For agricultural

sorting, CNNs have consistently outperformed classical colour-histogram and SVM-based

approaches [9], particularly under variable illumination [8]. Zhang et al. [10] demonstrated

that improved deep convolutional architectures could identify disease symptoms on maize

leaves with high accuracy under field conditions, highlighting the robustness of learned

features across agricultural imaging tasks. A comprehensive review by Li et al. [11]

further confirms that deep learning now dominates agricultural product quality grading,

consistently outperforming traditional machine-learning pipelines on colour, texture, and

shape discrimination tasks.

### 2.5.2 MobileNetV2 and its Limitations

MobileNetV2 [3,12] uses inverted residual bottleneck blocks with depthwise-separable con-

volutions to minimise parameter count for mobile deployment. When quantised to INT8

and exported as TFLite, it achieves inference times of 80–120 ms on the Raspberry Pi 3B+.

While fast enough in isolation, the reference system could not overlap inference with the

next frame capture, making the pipeline strictly sequential and throughput-limited. Ad-

ditionally, MobileNetV2 is a whole-image classifier: it does not produce bounding boxes,

Chapter 2. Literature Review | 15

so when multiple berries appear in one frame the system assigns a single class label to

the entire image, causing mixed-berry frames to be misclassified.

### 2.5.3 YOLO Family: Real-Time Detection with Localisation

YOLO (You Only Look Once) [13] reformulated object detection as a single regression

problem, outputting bounding-box coordinates and class probabilities in a single forward

pass. Successive versions (YOLOv3 [14], YOLOv8) progressively improved small-object

recall and speed.

Chapter 2. Literature Review | 16

Image Processing Pipeline (Raspberry Pi 3)

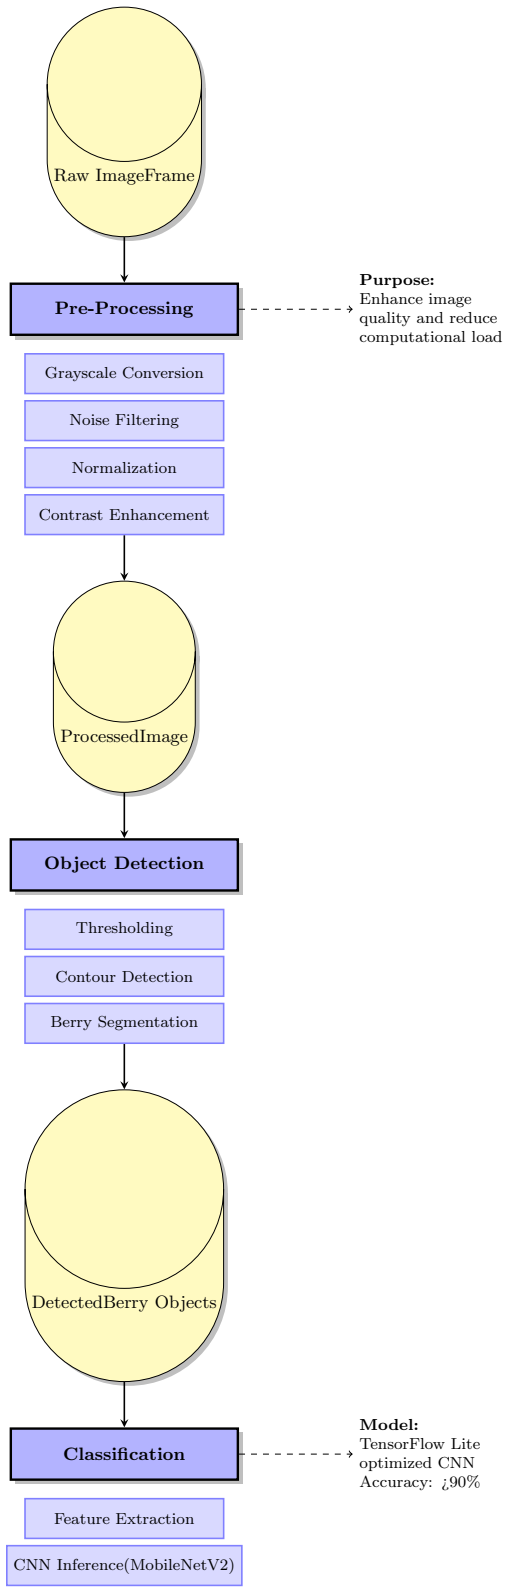
[picture p107: figure]
Raw ImageFrame; Pre-Processing; Grayscale Conversion; Noise Filtering; Normalization; Contrast Enhancement; ProcessedImage; Object Detection; Thresholding; Contour Detection; Berry Segmentation; DetectedBerry Objects; Classification; Feature Extraction; CNN Inference(MobileNetV2); Purpose: Enhance image quality and reduce computational load; Model: TensorFlow Lite optimized CNN Accuracy: ¿90%

Chapter 2. Literature Review | 17

### 2.5.4 YOLOv11 on Embedded Platforms

YOLOv11, released by Ultralytics in late 2024, introduces architectural improvements to

the C2f backbone and neck that improve small-object detection and reduce parameter

count by ≈22% compared to YOLOv8n [15]. Critically, it supports ONNX and TFLite

export paths optimised for ARM Cortex-A72 (Raspberry Pi 4), enabling inference at

25–40 fps within a 1.5W power envelope. Its bounding-box output makes it suitable

for tracking individual berries across frames, overcoming the whole-image classification

limitation of MobileNetV2.

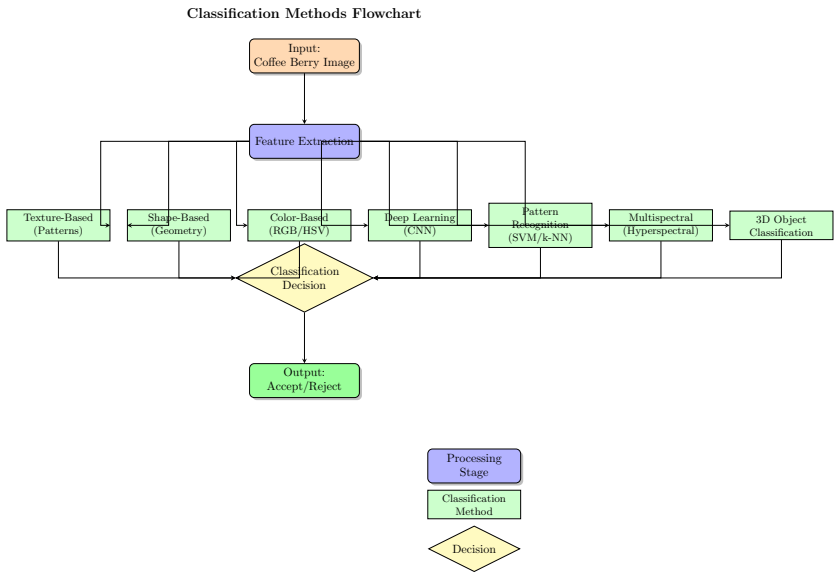
[picture p108: figure]
Input: Coffee Berry Image; Feature Extraction; Color-Based (RGB/HSV); Shape-Based (Geometry); Texture-Based (Patterns); Deep Learning (CNN); Pattern Recognition (SVM/k-NN); Multispectral (Hyperspectral); 3D Object Classification; Classification Decision; Output: Accept/Reject; Classification Methods Flowchart; Processing Stage; Classification Method; Decision

Figure 2.8: Overview of classification approaches considered: classical machine learning,

CNN-based models, and single-stage detectors (YOLO family)

## 2.6 Binary (Accept/Reject) vs. Fine-Grained Classification

Industry coffee-sorting practice distinguishes primarily between acceptable (fully ripe,

uniform red) and unacceptable (green, yellow, overripe, defective) berries [4,6]. Semi-ripe

berries—those in transitional yellow-orange states—do not meet premium export grading

Chapter 2. Literature Review | 18

standards and are classified as rejects in all major Kenyan cooperative protocols.

Fine-grained models that distinguish four or more intermediate classes amplify the con-

fusion between visually similar categories (e.g., semi-ripe and ripe), as documented in the

reference project. Binary classification, by contrast, reduces the decision boundary to a

single threshold in feature space: berries are labelled ACCEPT (uniform deep-red, ripe)

or REJECT (all other states: green, yellow-orange, overripe, defective). This aligns

with real-world sorting practice and substantially reduces label ambiguity in the training

set [5].

This project adopts the binary scheme. The YOLOv11 model is trained and evaluated on

two classes only: accept and reject. Semi-ripe, overripe, unripe, and visibly defective

berries all map to the reject class.

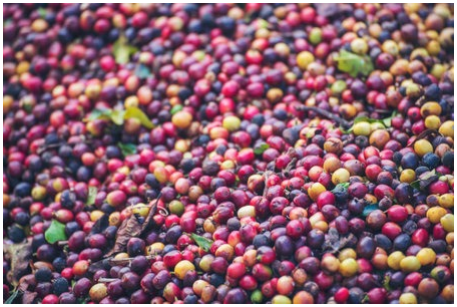
[picture p109: figure]

Figure 2.9: Visual comparison of ripe (accept) and unripe/semi-ripe (reject) coffee

berries. The binary classification boundary maps to the deep-red colour transition.

Chapter 2. Literature Review | 19

## 2.7 Embedded Co-Processor Architectures

Offloading time-critical real-time tasks to a dedicated microcontroller has been shown to

significantly improve throughput on single-board computer (SBC) vision systems [16]. In

multi-tier architectures, the SBC (Raspberry Pi) handles computationally heavy tasks

(frame capture, neural network inference, object tracking) while a microcontroller (e.g.,

ESP32, STM32) is responsible for hard real-time operations: solenoid pulse timing, PWM

motor control, and relay switching.

The ESP32-WROOM-32 [16] is a dual-core 240 MHz Xtensa LX6 microcontroller with

native UART, SPI, I²C, and 16 configurable PWM channels. Its deterministic ISR latency

(<5 µs) and hardware-timer-based solenoid firing eliminate the scheduling jitter inherent

in Linux-based Pi GPIO control. This is essential for accurate berry ejection timing at

conveyor speeds above 0.3 m s⁻¹

The proposed co-processing architecture assigns the Pi 4 to neural-network inference and

tracking, while the ESP32 exclusively handles solenoid, motor, and compressor control.

The two devices communicate over a UART link at 115 200 baud, with the Pi transmitting

short ASCII commands (e.g., REJECT:2) upon each ejection decision.

Chapter 2. Literature Review | 20

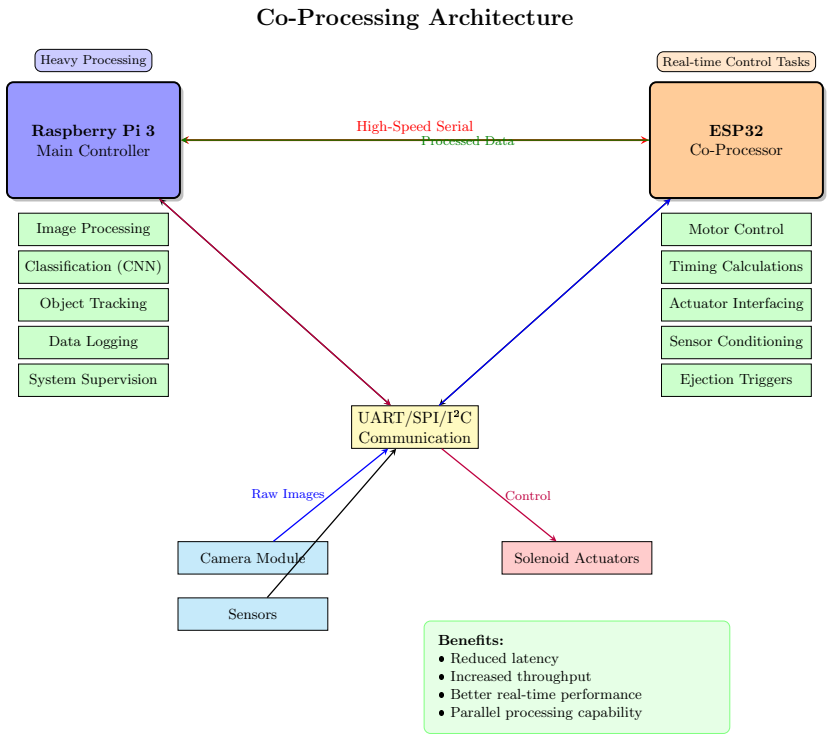
[picture p110: figure]
Co-Processing Architecture; Raspberry Pi 3 Main Controller; Image Processing; Classification (CNN); Object Tracking; Data Logging; System Supervision; ESP32 Co-Processor; Motor Control; Timing Calculations; Actuator Interfacing; Sensor Conditioning; Ejection Triggers; UART/SPI/I²C Communication; Camera Module; Solenoid Actuators; Sensors; High-Speed Serial; Raw Images; Processed Data; Control; Heavy Processing; Real-time Control Tasks; Benefits:  Reduced latency  Increased throughput  Better real-time performance  Parallel processing capability

Figure 2.10: Proposed co-processing architecture: Raspberry Pi 4 handles inference;

ESP32-WROOM-32 manages all hard real-time actuation via UART.

## 2.8 Summary of Literature Gaps Addressed by This Project

Table 2.1 summarises the three specific technical gaps identified in the literature and the

previous project, and maps each to the corresponding improvement proposed in this work.

Chapter 2. Literature Review | 21

Table 2.1: Literature gaps and corresponding improvements in this project

Gap identified | Root cause | This project’s solution
Motion blur at operat- ing speed (reference ma- chine) | Rolling-shutter sensor with
| ∼30 ms readout smears
| fast-moving berries | Replace with global-shutter Ar-
| | ducam OV9281 module; <1 ms
| | full-frame exposure eliminates
| | motion artefacts
High end-to-end latency (280–400 ms); through- put limited to ∼35 berries/min | Single-core Pi 3B+ handles
| inference, GPIO, and cam-
| era I/O serially | Pi 4 + ESP32 co-processor: Pi
| | handles inference; ESP32 han-
| | dles hard real-time solenoid tim-
| | ing; target <100 ms

Fine-grained class con-

fusion | (semi-ripe/ripe
boundary) | reduces
economic yield | Four-class model amplifies
| label ambiguity at visually
| similar boundaries
Binary | ACCEPT/REJECT
| | scheme aligned with industry
| | practice; YOLOv11 trained on
| | two classes eliminates boundary
| | confusion

Chapter 3. Methodology | 22

## 3 Methodology

This chapter outlines the approach taken to improve upon the existing coffee berry sorting

machine. The work spans three areas: a performance audit of the original system, targeted

improvements to the sorting mechanism, and evaluation of upgraded processing hardware

with a retrained classification model. Figure 3.1 shows the overall architecture of the

improved system.

System Architecture

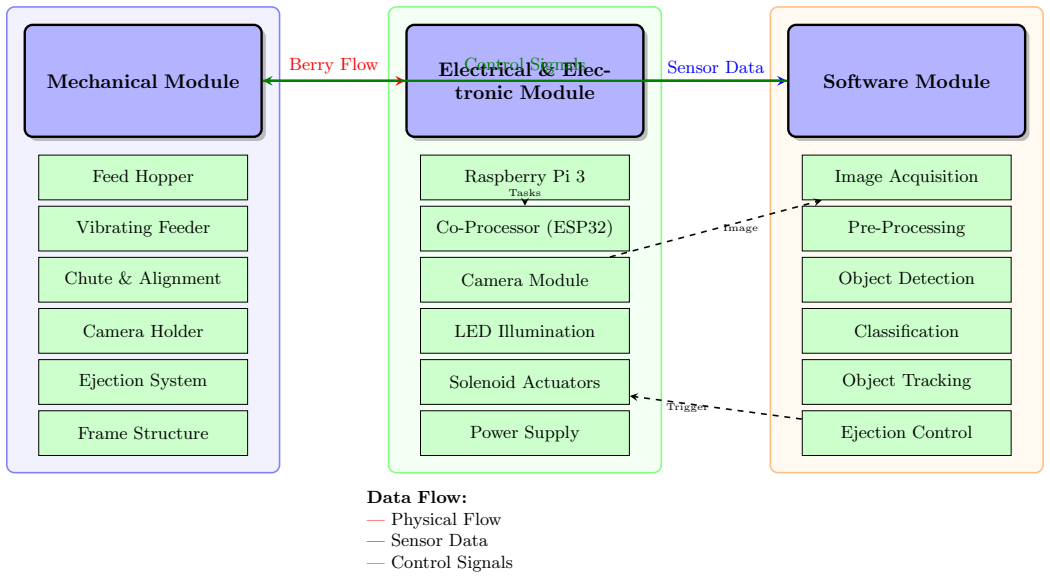
[picture p111: figure]
Mechanical Module; Electrical & Elec-; tronic Module; Software Module; Feed Hopper; Vibrating Feeder; Chute & Alignment; Camera Holder; Ejection System; Frame Structure; Raspberry Pi 3; Co-Processor (ESP32); Camera Module; LED Illumination; Solenoid Actuators; Power Supply; Image Acquisition; Pre-Processing; Object Detection; Classification; Object Tracking; Ejection Control; Berry Flow; Control Signals; Sensor Data; Image; Trigger; Tasks; Data Flow: — Physical Flow — Sensor Data — Control Signals

Figure 3.1: Overall architecture of the improved coffee berry sorting machine: global-

shutter camera, Raspberry Pi 4 inference engine, ESP32 real-time co-processor, and MOS-

FET solenoid driver stages

## 3.1 Performance Analysis of Existing Machine

A structured performance audit of the existing sorting machine was conducted to quantify

the root causes of its three documented limitations: motion blur, processing latency, and

Chapter 3. Methodology | 23

classification accuracy. The audit included:

Measuring end-to-end pipeline latency (frame capture → inference → actuation

trigger) under realistic operating conditions.

Evaluating classification accuracy on a held-out set of berry images collected directly

from the machine at operating speed, where motion blur was most evident.

Characterising the rolling-shutter distortion of the original Raspberry Pi Camera

V2 at chute speeds of 0.4–0.6 m s⁻¹

Identifying the contribution of the single-core Raspberry Pi 3B+ to pipeline serial-

isation and throughput bottlenecks.

These findings directly informed the improvements described in the following sections.

## 3.2 Dataset Collection and Model Training

The classification model was rebuilt from the ground up using upgraded hardware and a

purpose-built binary dataset. The Raspberry Pi 3B+ was replaced with the Raspberry

Pi 4 (4 GB RAM), providing a quad-core Cortex-A72 at 1.5 GHz and approximately

3× the memory bandwidth, allowing inference to run concurrently with frame capture.

The MobileNetV2 TFLite classifier was replaced with YOLOv11n, retrained on a new

binary dataset that consolidates the original four ambiguous ripeness classes into two

well-separated outcomes.

### 3.2.1 Image Acquisition

A dataset of 2,000 annotated images was compiled, balanced across the accept and

reject classes. Images were sourced from:

Chapter 3. Methodology | 24
1. Static tabletop photographs taken under controlled LED lighting (multiple angles

and distances).

2. In-situ frames extracted from video captured on the actual chute at operational

speed.

Images were captured using the Arducam OV9281 Global-Shutter Camera Module

(Raspberry Pi CSI-2 interface, 1 MP, 1280 Ö800 native resolution, Sony OV9281 sensor).

The global-shutter sensor exposes all pixels simultaneously, eliminating the rolling-shutter

motion smear that degraded classification in the reference system (see Section 2.4). Images

were saved at 1280 × 800 and subsequently centre-cropped and resized to 640 × 640 for

training.

Note: The mechanical chute and vibrating eccentric-motor feeder are retained unchanged

from the reference machine [1]. Improvements in this project are confined to the electron-

ics, imaging, and software sub-systems.

### 3.2.2 Annotation

All images were annotated with bounding boxes and class labels using the Roboflow

annotation platform. A binary classification scheme is adopted (see Section 2.6): berries

are labelled as either accept (commercially ripe, uniform deep-red) or reject (all other

states: unripe green, semi-ripe yellow/orange, overripe dark/black, physically damaged).

This aligns with Kenyan cooperative grading standards and eliminates the semi-ripe/ripe

boundary confusion that degraded the reference model.

Chapter 3. Methodology | 25

Table 3.1: Binary coffee berry classification scheme

Class ID Label | Action | Berry states included
0 | accept | Pass to accept bin Uniform deep-red ripe berries
1 | reject | Fire ejector jet | Unripe | (green), | semi-ripe
(yellow/orange), | overripe

(dark/black), and damaged

| | | berries

### 3.2.3 Dataset Split

The annotated dataset was split 70% train / 15% validation / 15% test using the split dataset.py

utility developed as part of this project.

## 3.3 YOLOv11 Model Training

### 3.3.1 Framework and Backbone

The Ultralytics YOLOv11 Nano (yolo11n.pt) pre-trained on COCO was selected as the

backbone. This was fine-tuned using transfer learning on the coffee berry dataset.

Chapter 3. Methodology | 26

### 3.3.2 Training Configuration

Table 3.2: YOLOv11 training hyperparameters

Parameter | Value
Epochs | 100
Image size | 640 × 640
Batch size | 16
Optimizer | SGD (default Ultralytics)
Learning rate | 0.01

Data augmentation Mosaic, flip, HSV jitter

### 3.3.3 Evaluation Metrics

Model performance was evaluated using:

mAP@0.5 and mAP@0.5:0.95 on the test split.

Per-class precision and recall.

Inference time (ms per frame) on both the training machine and the Raspberry Pi

4.

## 3.4 Sorting Mechanism Improvements

Based on the performance audit findings, three targeted upgrades were designed and

implemented to address the root causes of poor sorting performance:

1. Camera replacement: The rolling-shutter Raspberry Pi Camera V2 was replaced

with the Arducam OV9281 global-shutter module to eliminate motion blur.

Chapter 3. Methodology | 27
2. Ejector driver upgrade: The PN2222A BJT transistors in the solenoid driver

stages were replaced with IRLZ44N logic-level MOSFETs to improve switching

speed and reliability at 3.3 V ESP32 drive levels.

3. ESP32 co-processor: An ESP32 microcontroller was introduced between the

Raspberry Pi and the actuators to take over all hard real-time tasks — solenoid

timing, motor PWM, relay switching — relieving the Pi’s Linux scheduler from

deterministic GPIO control.

### 3.4.1 Hardware Platform

The system employs a co-processing architecture. The Raspberry Pi 4 (4 GB RAM)

acts as the main inference engine handling image acquisition, YOLOv11 inference, and

object tracking. The ESP32 microcontroller handles time-critical real-time tasks: solenoid

trigger timing, motor PWM, and compressor control. Communication between the two

processors is over UART at 115 200 baud.

Chapter 3. Methodology | 28

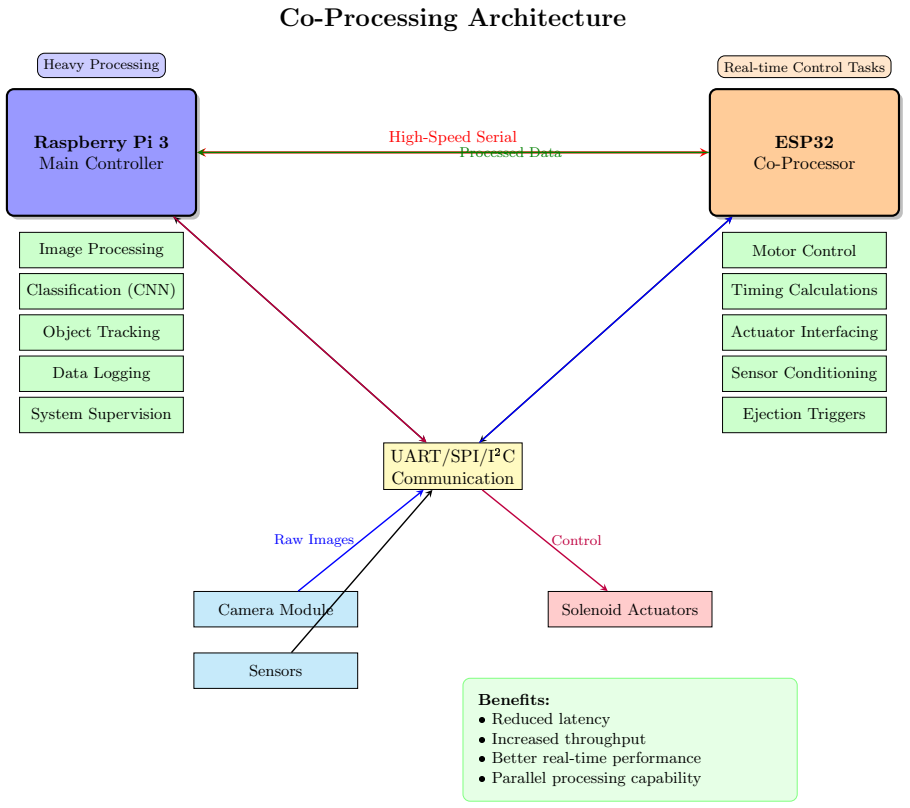
[picture p112: figure]
Co-Processing Architecture; Raspberry Pi 3 Main Controller; Image Processing; Classification (CNN); Object Tracking; Data Logging; System Supervision; ESP32 Co-Processor; Motor Control; Timing Calculations; Actuator Interfacing; Sensor Conditioning; Ejection Triggers; UART/SPI/I²C Communication; Camera Module; Solenoid Actuators; Sensors; High-Speed Serial; Raw Images; Processed Data; Control; Heavy Processing; Real-time Control Tasks; Benefits:  Reduced latency  Increased throughput  Better real-time performance  Parallel processing capability

Figure 3.2: Co-processing architecture: Raspberry Pi 4 handles image processing and

YOLOv11 classification; ESP32 handles motor control, actuator interfacing, and timing

Chapter 3. Methodology | 29

System Start

System Initialization | Raspberry Pi
Start Vibrating Feeder | ESP32
Capture Image Frame | Raspberry Pi
| No
Pre-process Image | Raspberry Pi
Detect | Berries | Raspberry Pi

BerryDetected?

Classify Berry(CNN Model) | Raspberry Pi
Track PositionCalculate Velocity | Raspberry Pi
Send Data | via UART | Raspberry Pi
Receive Berry Data | ESP32

UnripeBerry?

Calculate EjectionTiming | ESP32
Trigger SolenoidActuator | ESP32

Yes

Yes

No

No

Chapter 3. Methodology | 30

### 3.4.2 Detection-to-Actuation Pipeline

The pipeline operates as follows:

1. Pi Camera captures a frame from the detection zone.
2. YOLOv11 performs inference to detect and classify berries in the frame (Figure 3.4).
3. Detected berry positions are tracked across frames using a centroid tracker.
4. When a tracked berry reaches the ejection zone, the Pi sends a binary decision

(ACCEPT or REJECT:n where n is the ejector index) to the ESP32 via UART (Fig-

ure 3.5).

5. ESP32 fires the corresponding solenoid jet for a calibrated pulse duration; ACCEPT

commands generate no solenoid activation.

Chapter 3. Methodology | 31

Image Processing Pipeline (Raspberry Pi 3)

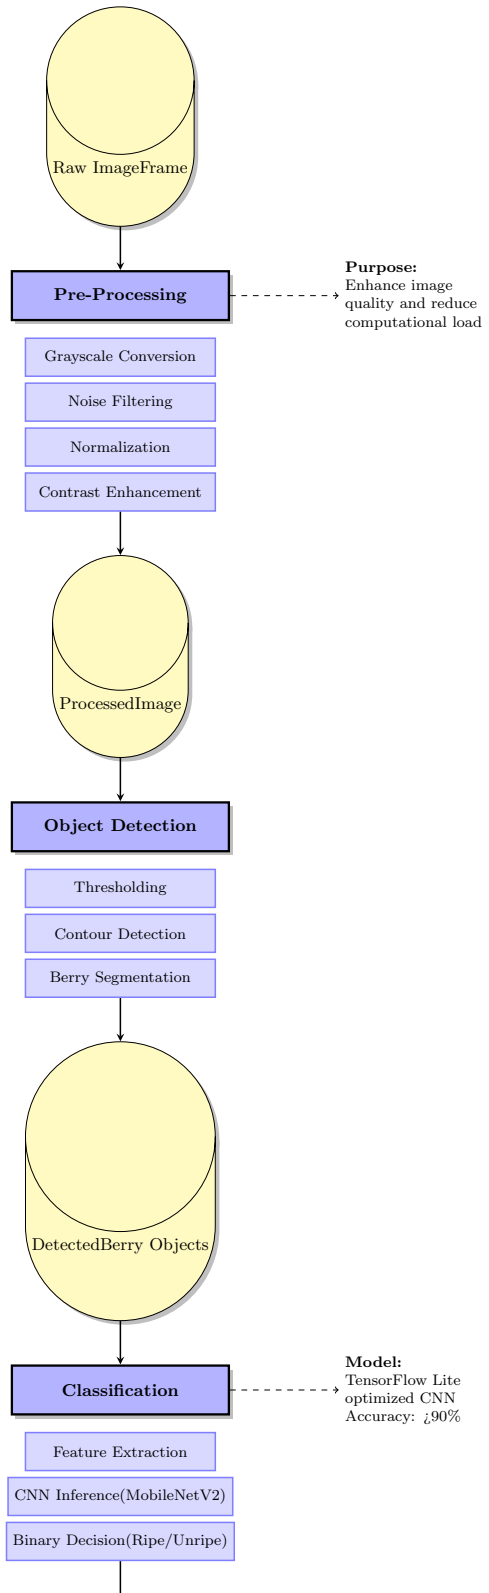
[picture p113: figure]
Raw ImageFrame; Pre-Processing; Grayscale Conversion; Noise Filtering; Normalization; Contrast Enhancement; ProcessedImage; Object Detection; Thresholding; Contour Detection; Berry Segmentation; DetectedBerry Objects; Classification; Feature Extraction; CNN Inference(MobileNetV2); Binary Decision(Ripe/Unripe); Purpose: Enhance image quality and reduce computational load; Model: TensorFlow Lite optimized CNN Accuracy: ¿90%

Chapter 3. Methodology | 32

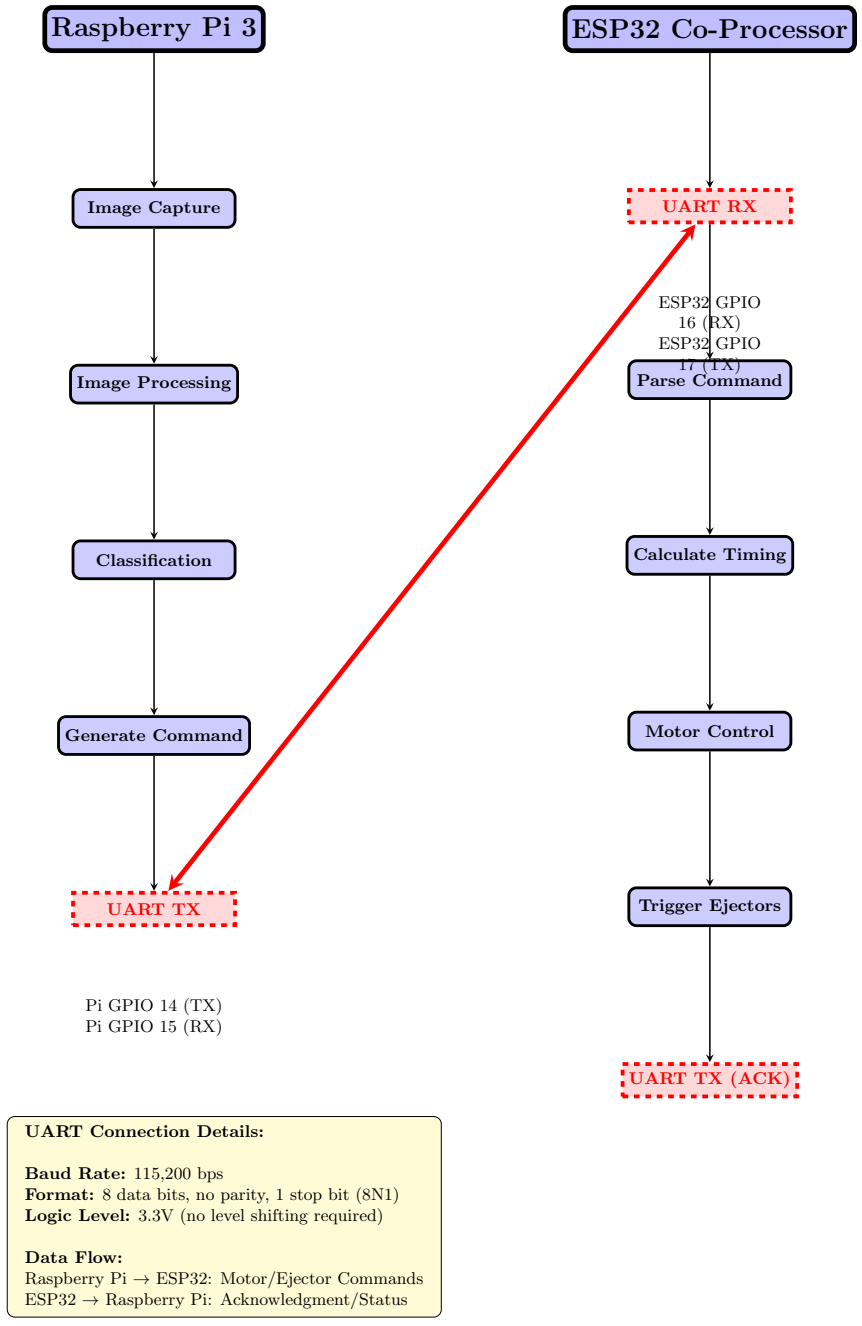
[picture p114: figure]
Raspberry Pi 3; Image Capture; Image Processing; Classification; Generate Command; UART TX; ESP32 Co-Processor; UART RX; Parse Command; Calculate Timing; Motor Control; Trigger Ejectors; UART TX (ACK); Pi GPIO 14 (TX) Pi GPIO 15 (RX); ESP32; GPIO; UART Connection Details:; Baud Rate: 115,200 bps; Data Flow:; ESP32 → Raspberry Pi: Acknowledgment/Status

Format: 8 data bits, no parity, 1 stop bit (8N1) Logic Level: 3.3V (no level shifting required)

Raspberry Pi → ESP32: Motor/Ejector Commands

Figure 3.5: UART communication and data flow between Raspberry Pi and ESP32

Chapter 3. Methodology | 33

### 3.4.3 ESP32 Pin Assignment and Wiring

Table 3.3 defines the pin assignments for the ESP32 microcontroller and its connections

to the Raspberry Pi, solenoid drivers, vibrating motor, pneumatic compressor, and LED

status indicator. All signal lines between the Pi and the ESP32 operate at 3.3 V logic.

The 12 V solenoid and motor supplies are isolated with a common ground return tied back

to all control electronics.

Chapter 3. Methodology | 34

Table 3.3: Raspberry Pi, ESP32, and Peripheral Wiring Assignment

Function | Device | Pin/Port | Notes

UART Communication (Pi ↔ ESP32)

UART TX | Raspberry Pi | GPIO 14 (TXD) | 3.3 V; transmit to ESP32 RX
UART RX | Raspberry Pi | GPIO 15 (RXD) | 3.3 V; receive from ESP32 TX
UART RX | ESP32 | GPIO 16 | Receive from Pi TXD
UART TX | ESP32 | GPIO 17 | Transmit to Pi RXD
Baud rate | Both | 115 200 bps, 8N1 | Serial protocol parameters

Ejector Solenoid Control (ESP32)

Ejector 1 | ESP32 | GPIO 4 | MOSFET gate + 220 Ω resistor
Ejector 2 | ESP32 | GPIO 5 | Flyback diode across solenoid
Ejector 3 | ESP32 | GPIO 12 | 1N4007 (cathode to +12 V)
Ejector 4 | ESP32 | GPIO 13 | 100 kΩ pull-down for safety

Vibrating Motor (ESP32)

Motor PWM | ESP32 | GPIO 14 (PWM) | MOSFET gate driver
Motor supply | 12 V rail | +12 V, GND | Flyback diode protection

Pneumatic Compressor (ESP32)

Compressor | ESP32 | GPIO 21 (relay) | Relay driver; on/off switching
Compressor supply | 12 V rail | +12 V, GND | Relay coil protection diode

LED Status Indicator (ESP32)

LED PWM | ESP32 | GPIO 22 (PWM) | MOSFET gate driver
LED supply | 12 V rail | +12 V, GND | Flyback diode protection

Power Supply

Logic 5 V | Buck converter | Pi 5 V, 3 A+ | Raspberry Pi 4 supply
Logic 5 V | Buck converter | ESP32 5 V, 2 A+ | Onboard 3.3 V regulator
Motor/actuator 12 V Battery/adapter 10 A fused | Main actuator supply
Common GND | All devices | Star ground point All GND returns tied together

Chapter 3. Methodology | 35

Each ejector solenoid circuit includes a 220 Ω gate resistor for current limiting and a

100 kΩ pull-down to prevent false firing on power-up. A flyback diode (1N4007, cathode

to +12 V) across each solenoid suppresses inductive transient kickback when the MOSFET

switch opens.

### 3.4.4 Transistor Technology Selection: BJT vs. Logic-Level MOSFET

The reference machine used bipolar junction transistors (BJTs — PN2222A / BC547)

as the switching elements in the ejector solenoid driver stages. While BJTs are cheap

and widely available, they impose a fundamental switching-speed penalty that becomes

critical in a timer-sensitive ejection circuit.

Table 3.4: BJT (PN2222A) vs. Logic-Level MOSFET (IRLZ44N) switching comparison

Parameter | BJT (PN2222A) | MOSFET (IRLZ44N)
Control mechanism | Current-controlled (IB) | Voltage-controlled (VGS)
Drive voltage from ESP32 | Must source ∼5 mA base current Gate capacitance only; <1 mA
Turn-on threshold | VBE ≈ 0.7 V (forward bias) | VGS(th) = 1–2 V (logic-level gate)
Storage time (turn-off delay) | tstg = 200–600 ns | None (no minority carrier storage)
Turn-on time tr | ≈ 100 ns | < 20 ns (gate charge limited)
Turn-off time tf | ≈ 250 ns + storage time | < 50 ns
On-state voltage drop | VCE(sat) ≈ 0.3 V | VDS(on) = ID × RDS(on) ≈ 50 mV at 1 A
Maximum current (continuous) 600 mA | 47 A
Suitability at 3.3 V gate/base | Marginal (VBE barely saturates) | Full enhancement; specified at 3.3 V

The critical advantage of the MOSFET for this application is the absence of minority

carrier storage time. A BJT in saturation accumulates charge carriers in the base

region; when the switching signal is removed these must recombine before the transistor

turns off, adding 200–600 ns of unavoidable delay. For a solenoid fired within a 45 ms

Chapter 3. Methodology | 36

timing window at a chute speed of 0.5 m s⁻¹
, this is negligible in isolation, but when

combined with upstream inference latency any additional margin matters.

The MOSFET also operates with negligible gate drive current from the ESP32 3.3 V rail,

whereas the BJT requires the GPIO to source ≈5 mA of base current. With four simul-

taneous ejectors the BJT design loads the microcontroller’s output stage; the MOSFET

design imposes essentially zero steady-state GPIO load.

For these reasons the IRLZ44N logic-level MOSFET replaces the PN2222A BJT across

all four ejector channels, the motor driver, and the LED strip driver.

### 3.4.5 Solenoid Driver Circuit

Each of the four ejector channels uses an identical N-channel MOSFET stage. The ESP32

GPIO output (3.3 V logic) drives the IRLZ44N gate through a 220 Ω series resistor, which

limits gate-charge current and damps any parasitic resonance with the gate capacitance. A

100 kΩ pull-down resistor between gate and source holds the MOSFET firmly off during

ESP32 power-up and reset, preventing false solenoid firing. The solenoid coil (12 V,

≈22 Ω DC resistance) is connected between the drain and the 12 V supply rail. A 1N5819

Schottky flyback diode, cathode to +12 V and anode to the drain, clamps the inductive

back-EMF spike to within the diode’s forward voltage (0.3–0.5 V) above the rail when

the MOSFET turns off. The source is tied directly to the common ground reference that

connects the 12 V actuator supply and the ESP32 logic supply, ensuring no ground-loop

offset between the control and power sections. This circuit topology corresponds directly

to the design verified in Proteus and tabulated in Table 3.3.

Chapter 3. Methodology | 37

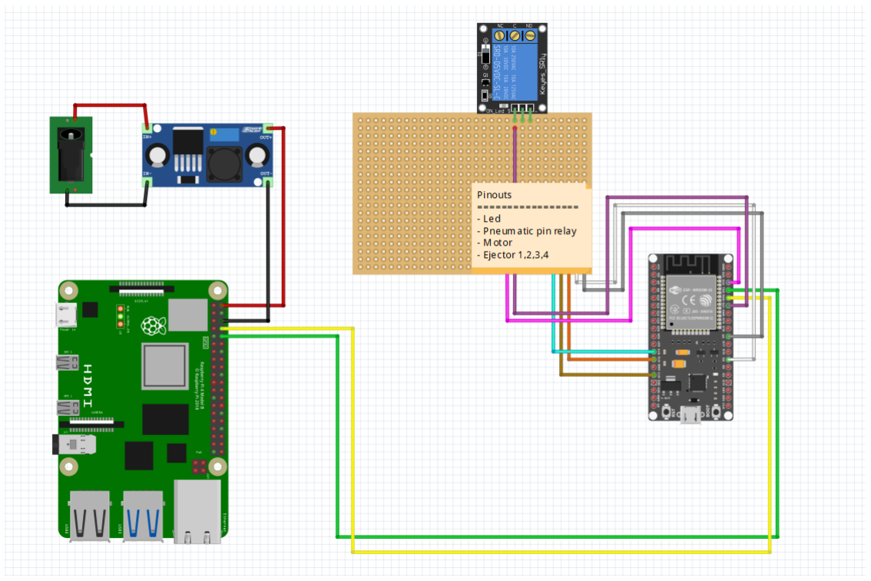
[picture p115: figure]

Figure 3.6: Fritzing circuit diagram of the ESP32 solenoid driver implementation:

IRLZ44N MOSFET switching stages, flyback diodes, gate resistors, and Raspberry Pi

UART connection

## 3.5 Circuit Simulation in Proteus

Prior to physical breadboard construction, the ESP32-based control circuit was designed

and verified using Proteus ISIS (Labcenter Electronics). Proteus supports simulation of

the ESP32 microcontroller alongside IRLZ44N MOSFET drivers, relay circuits, solenoid

load models, and UART virtual terminals, enabling full functional verification before any

hardware was procured. Figure 4.3 in Chapter 4 shows the complete Proteus schematic.

### 3.5.1 Simulation Scope

The simulation covered the following subsystems:

Chapter 3. Methodology | 38

UART communication: Simulated serial exchange between a virtual UART ter-

minal (representing the Raspberry Pi) and the ESP32. Correct baud rate, 8N1

frame format at 115 200 bps, and message parsing logic were verified using Virtual

Serial Port instruments.

Solenoid ejector drivers: Four N-channel MOSFET switching stages (one per

ejector), each with 220 Ω gate resistor, 1N4007 flyback diode, and 100 kΩ pull-

down, were simulated and switching waveforms verified against the specification in

Table 3.3.

Vibrating motor PWM control: GPIO 14 PWM output was simulated into a

motor load model; variable duty cycle confirmed correct speed control behaviour.

Relay-based compressor control: GPIO 21 relay circuit verified for correct

ON/OFF sequencing and protection diode operation under simulated load.

LED status indicator: GPIO 22 PWM dimming into an LED model confirmed

brightness control from 0% to 100%.

### 3.5.2 Simulation Methodology

The ESP32 firmware was compiled (Arduino framework) and loaded into the Proteus

virtual ESP32-WROOM-32 component. Input stimuli consisting of binary classification

command strings (e.g., REJECT:1, REJECT:3, ACCEPT) were injected via a virtual serial

terminal scripted to replicate Raspberry Pi UART output. Oscilloscope probes were

placed on each MOSFET gate pin and solenoid node to capture switching waveforms.

The simulation confirmed correct actuation of all four ejector channels, motor PWM

behaviour, compressor relay switching, and UART framing before physical construction

commenced. The complete Proteus schematic and waveform captures from this simulation

are presented as results in Section 4.3.

Chapter 3. Methodology | 39

## 3.6 Validation Strategy

System performance will be validated through:

image test: Run the YOLOv11 model on the held-out test set and report mAP@0.5,

mAP@0.5:0.95, per-class precision and recall.

Throughput test: Measure berries processed per minute at several belt speeds

and identify the optimal operating point.

Latency test: Measure end-to-end pipeline time from frame capture through

YOLOv11 inference to UART solenoid trigger on the Pi 4 + ESP32 hardware.

Chapter 4. Results and Discussion | 40

## 4 Results and Discussion

## 4.1 Overview

This chapter presents the results obtained during the current phase of the project and

discusses their implications. Work completed to date covers: a performance audit of

the baseline system that established the root causes of its limitations; targeted improve-

ments to the sorting mechanism including a camera replacement, transistor upgrades,

and ESP32 co-processor integration; circuit verification by Proteus simulation; and initial

model development using a newly compiled binary dataset on the upgraded Raspberry

Pi 4 platform.

## 4.2 Performance Analysis of Existing System

A detailed performance audit of the existing sorting machine was conducted to establish

a baseline and identify the root causes of its documented limitations. The key findings

are presented in Table 4.1:

Table 4.1: Measured baseline performance of existing sorting machine

Metric | Measured Value | Target
End-to-end pipeline latency | ≈ 380 ms | < 100 ms
Overall classification accuracy | ≈ 72% | > 90%
Throughput (berries/min) | ≈ 35 | > 80

The dominant contribution to latency was the serialised inference on the Pi 3 (≈ 310 ms

per frame using TensorFlow Lite MobileNet). Motion blur from the rolling-shutter cam-

era degraded image quality at operating chute speed, reducing classification confidence.

Misclassification was concentrated at the semi-ripe/ripe boundary in the four-class model,

Chapter 4. Results and Discussion | 41

where visually similar colours produced ambiguous predictions. These findings directly

motivated the improvements described in the following sections.

## 4.3 Sorting Mechanism Improvements

Three targeted upgrades were implemented to address the root causes identified in the

performance audit:

1. Camera replacement: The rolling-shutter Raspberry Pi Camera V2 was re-

placed with the Arducam OV9281 Global-Shutter Module (CSI-2, 1 MP, Sony

OV9281). Simultaneous pixel exposure eliminates the 12–18 mm per-frame smear

that degraded colour classification at operating chute speed.

2. Ejector driver transistor upgrade: PN2222A BJTs were replaced with IRLZ44N

logic-level MOSFETs. The MOSFET has no minority-carrier storage time, giv-

ing sub-20 ns turn-on versus ≈100 ns + 200–600 ns storage for the BJT. Full drive

is achieved direct from the ESP32 3.3 V GPIO with negligible steady-state gate

current.

3. ESP32 co-processor: An ESP32 microcontroller was introduced to handle all

hard real-time tasks—solenoid pulse timing, motor PWM, relay switching—via de-

terministic hardware timers (<5 µs ISR latency), relieving the Raspberry Pi Linux

scheduler from GPIO-critical paths.

### 4.3.1 Procured and Verified Hardware

The following components have been procured, bench-tested, and verified for compatibil-

ity:

Raspberry Pi 4 (4 GB RAM): upgraded main inference platform.

Chapter 4. Results and Discussion | 42

Arducam OV9281 Global-Shutter Camera Module: replacement imaging

sensor.

ESP32 DevKit: real-time actuation controller.

LED ring light: consistent illumination above the detection zone.

2-channel optocoupler relay module (PC817 + SRD-05VDC): compressor and aux-

iliary switching.

IRLZ44N MOSFETs (Ö4), 1N5819 Schottky diodes, 220 Ω and 100 kΩ resistors.

The electrical design including power distribution and solenoid driver circuits is docu-

mented in Figure 4.1, and the high-level system block diagram in Figure 4.2.

12V Battery+ GND

Raspberry Pi 3(UART RX/TX) | ESP32Microcontroller(3.3V)
5V (via buck) | 3.3V regulator

UART

GPIO | 16/17 GPIO 14/15
Ejector | 1(Valve) Ejector 2(Valve) | Ejector 3(Valve) Ejector | 4(Valve)
VibratingMotor | AirCompressor | LED | Strip

Pi Camera(CSI)

GPIO 4 | GPIO 5 | GPIO 12 | GPIO 13
GPIO 14 | (PWM)

GPIO 21

GPIO 22 (PWM)

+12V

GND (Common)

Protection Components:• Flyback diodes (1N4007) on all ejector valves• 220Ohm gate resistors + 100kOhm pull-downs• 10A fuse on main 12V supply

Figure 4.1: Electrical schematic: power distribution, processor connections, actuator out-

puts, and communication links

Chapter 4. Results and Discussion | 43

12V Battery + GND

Raspberry Pi 35V supply | ESP325V supply
+12V | +12V
GND | Common

UART

TX/RX

Pi Camera (CSI)

Ejector 1 | Ejector 2 | Ejector 3 | Ejector 4
GPIO 4 | GPIO 5 | GPIO 12 | GPIO 13
Vibrating Motor Air Compressor | LED Strip
GPIO 14 (PWM) | GPIO 21 | GPIO 22 (PWM)

Protection: Flyback diodes (1N4007) on ejector valves • 220Ω gate resistors
+ 100kΩ pull-downs • 10A fuse on 12V supply

Figure 4.2: System block diagram: processor hierarchy, communication links, and actua-

tor outputs with power distribution

### 4.3.2 Proteus Circuit Simulation Results

Prior to physical construction, the ESP32 control circuit was fully simulated in Proteus

ISIS to verify all subsystems before hardware was assembled.

Full Circuit Overview Figure 4.3 shows the complete Proteus schematic: four IRLZ44N

ejector channels, vibrating motor PWM stage, LED strip driver, 2-channel optocoupler

relay module, and UART virtual terminal representing the Raspberry Pi link.

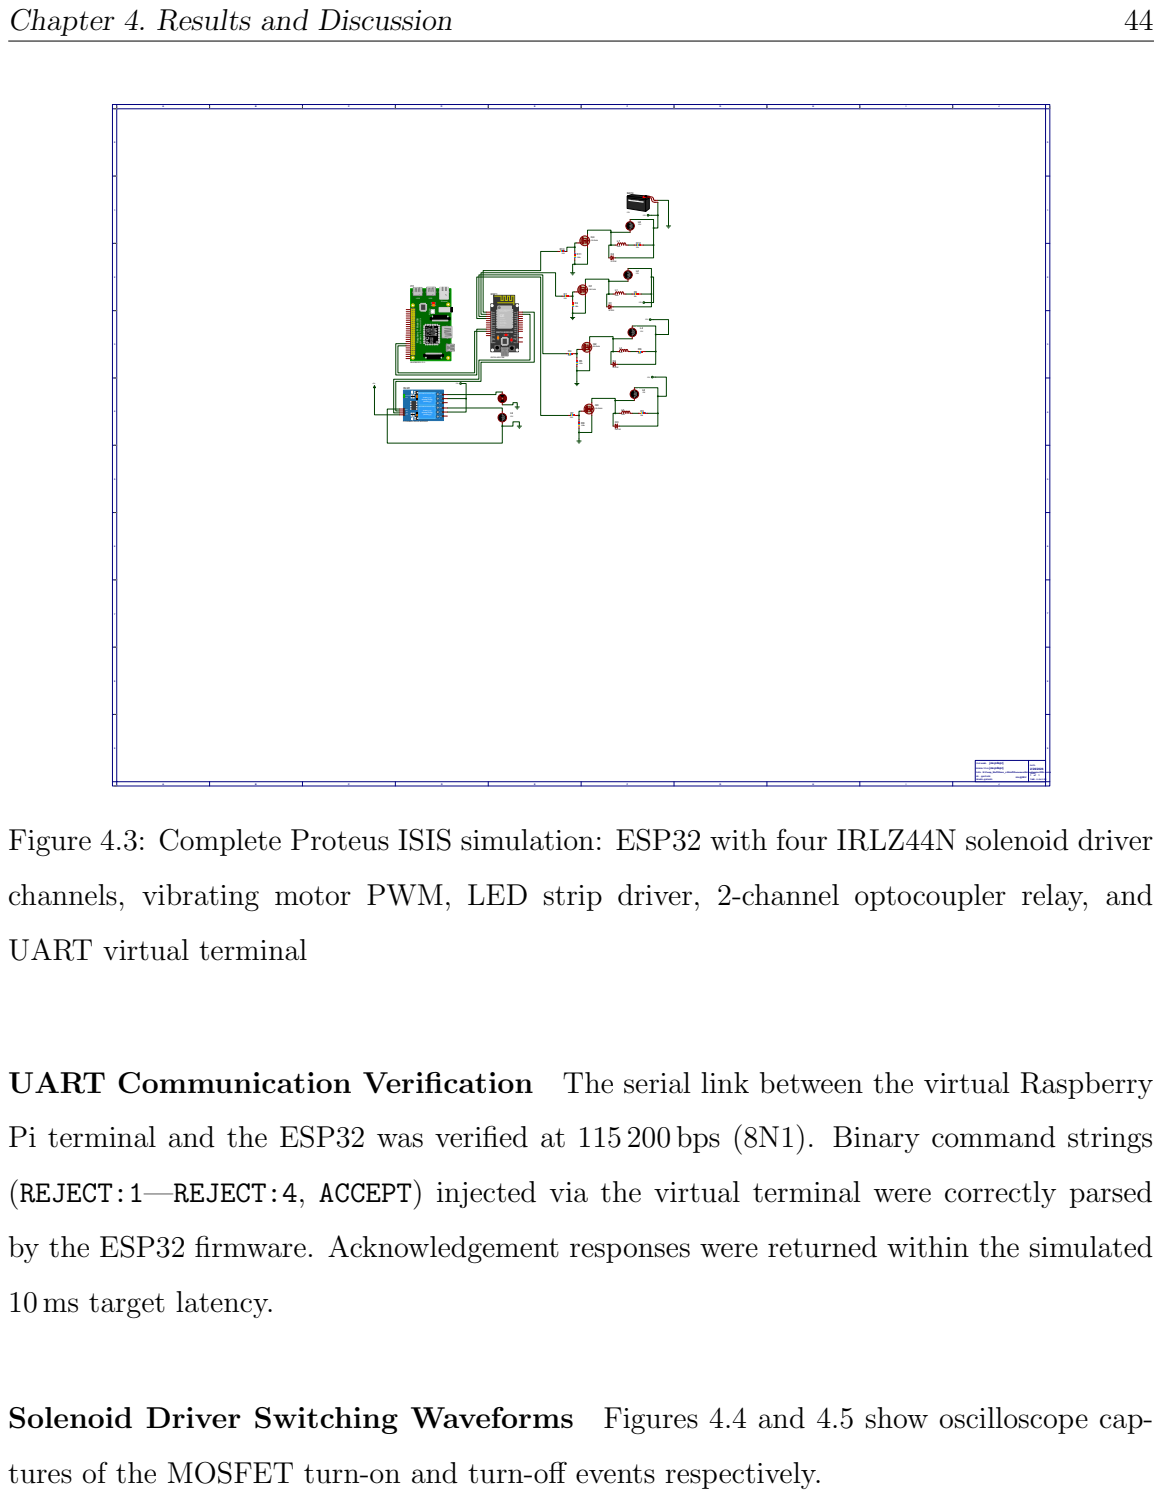
[picture p116: page 55]

DESIGN TITLE: joe.pdsprj
PATH: E:\Comp_Stuff\Glenn_s Shtuff\Documens\School\assino\fifth assine
@AUTHOR
BOARD: @BOARD

Figure 4.3: Complete Proteus ISIS simulation: ESP32 with four IRLZ44N solenoid driver

channels, vibrating motor PWM, LED strip driver, 2-channel optocoupler relay, and

UART Communication Verification The serial link between the virtual Raspberry

Pi terminal and the ESP32 was verified at 115 200 bps (8N1). Binary command strings

(REJECT:1—REJECT:4, ACCEPT) injected via the virtual terminal were correctly parsed

by the ESP32 firmware. Acknowledgement responses were returned within the simulated

Solenoid Driver Switching Waveforms Figures 4.4 and 4.5 show oscilloscope cap-

tures of the MOSFET turn-on and turn-off events respectively.

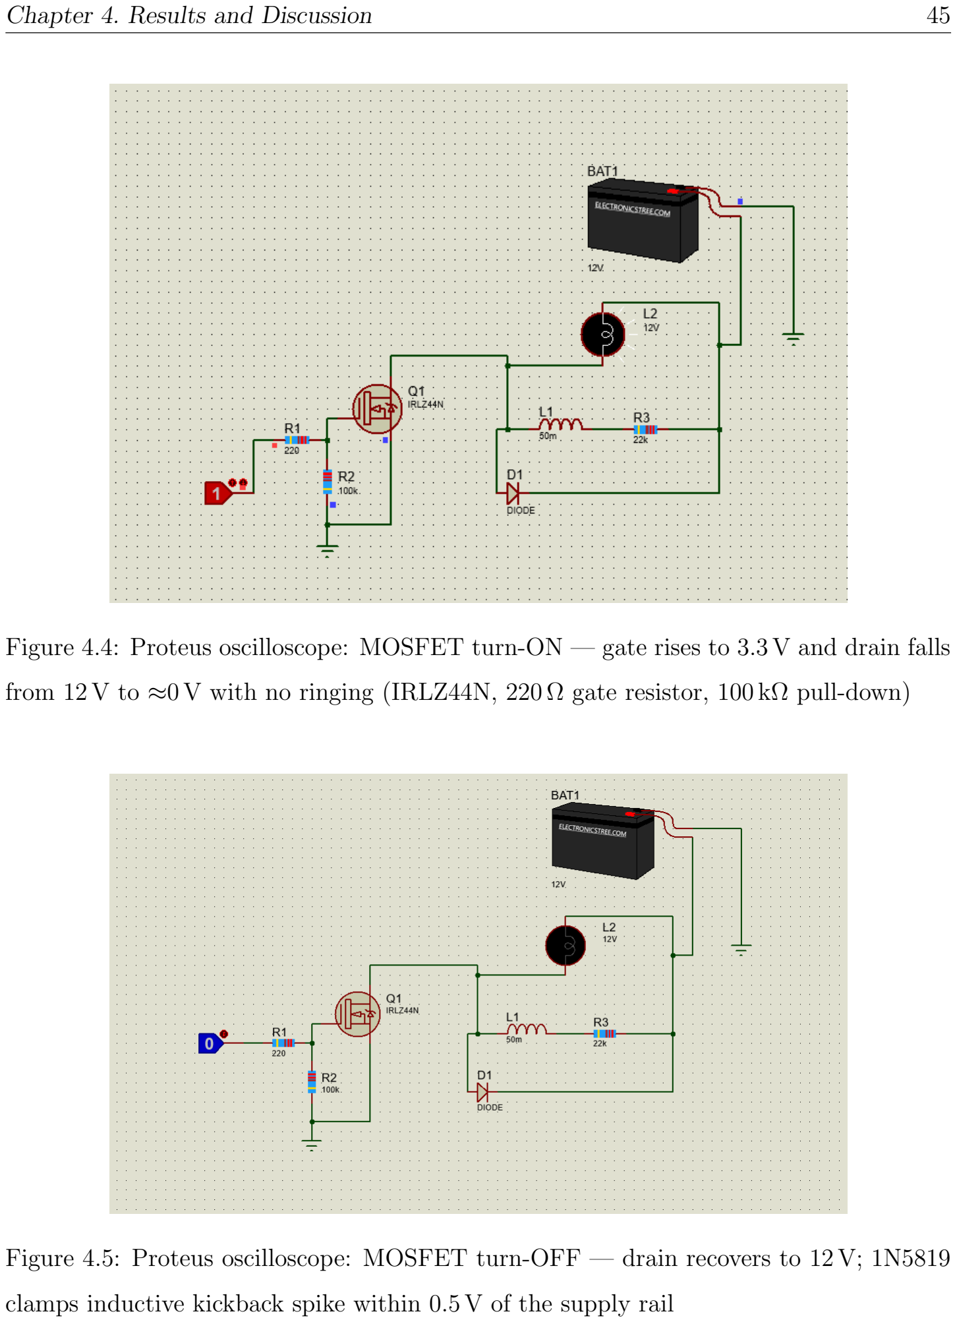
[picture p117: page 56]

Chapter 4. Results and Discussion | 45

Figure 4.4: Proteus oscilloscope: MOSFET turn-ON — gate rises to 3.3 V and drain falls

from 12 V to ≈0 V with no ringing (IRLZ44N, 220 Ω gate resistor, 100 kΩ pull-down)

Figure 4.5: Proteus oscilloscope: MOSFET turn-OFF — drain recovers to 12 V; 1N5819

clamps inductive kickback spike within 0.5 V of the supply rail

Chapter 4. Results and Discussion | 46

Key results from the waveform analysis:

All four MOSFET channels switched correctly on receipt of REJECT:n commands.

No gate ringing observed; 220 Ω series resistor adequately damped parasitic oscilla-

tion.

Flyback diode clamped solenoid turn-off spike to +12.5 V (0.5 V above rail).

100 kΩ pull-down confirmed zero false firing during ESP32 power-on reset.

Motor PWM and Compressor Relay PWM on GPIO 14 swept 0–100% produced

proportional average voltage across the motor load, confirming correct vibrating-feeder

speed control. The GPIO 21 relay cycled the compressor load ON/OFF with clean switch-

ing and correct protection diode behaviour.

## 4.4 Hardware Upgrade and Model Development

With the mechanism improvements validated, work shifted to upgrading the processing

platform and classification model. The Raspberry Pi 4 (4 GB RAM) replaces the

Pi 3B+, providing ≈3× memory bandwidth and enabling YOLOv11 inference to overlap

with the next frame capture. In parallel, the MobileNetV2 four-class classifier was re-

tired; YOLOv11n was retrained on a new 2,000-image binary dataset, eliminating the

semi-ripe/ripe boundary confusion that limited the original system. The performance

shortcomings of the reference four-class model that directly motivated this dataset re-

design are documented in Appendix C, Figures C.1 and C.2.

### 4.4.1 Dataset and Class Reduction

The original four-class dataset was discarded and a new 2,000-image binary dataset

was compiled. Images were captured on the physical chute under operational illumination

Chapter 4. Results and Discussion | 47

and annotated on Roboflow with two labels only: accept (fully ripe, deep-red) and reject

(all other states). Consolidating four ambiguous classes into two eliminates the dominant

misclassification boundary.

Table 4.2: Dataset split summary (2,000-image binary dataset)

Split | Images accept instances reject instances
Train | 1,400 | TODO | TODO
Validation | 300 | TODO | TODO
Test | 300 | TODO | TODO
Total | 2,000 | TODO | TODO

### 4.4.2 YOLOv11n Training Results

The YOLOv11n model was trained for 100 epochs on the Pi 4 accelerated by the bi-

nary dataset. Figure 4.6 shows the comprehensive training results including loss curves,

precision, recall, and mAP metrics across all epochs.

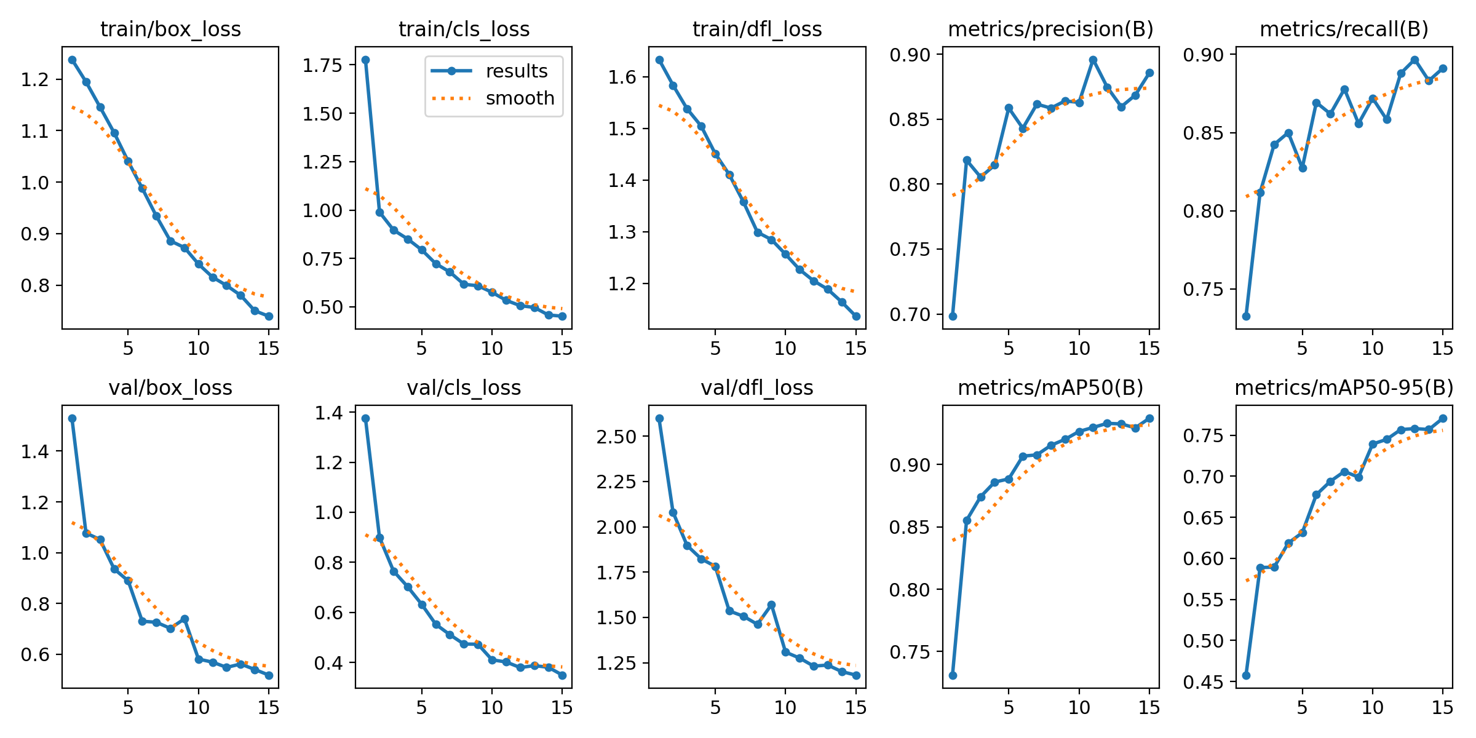
[picture p118: figure]

Figure 4.6: YOLOv11n comprehensive training metrics over 100 epochs showing conver-

gence of loss, precision, recall, and mAP on the binary coffee berry dataset

Chapter 4. Results and Discussion | 48

Figure 4.7 presents the F1-confidence curve demonstrating the model’s classification per-

formance at various confidence thresholds.

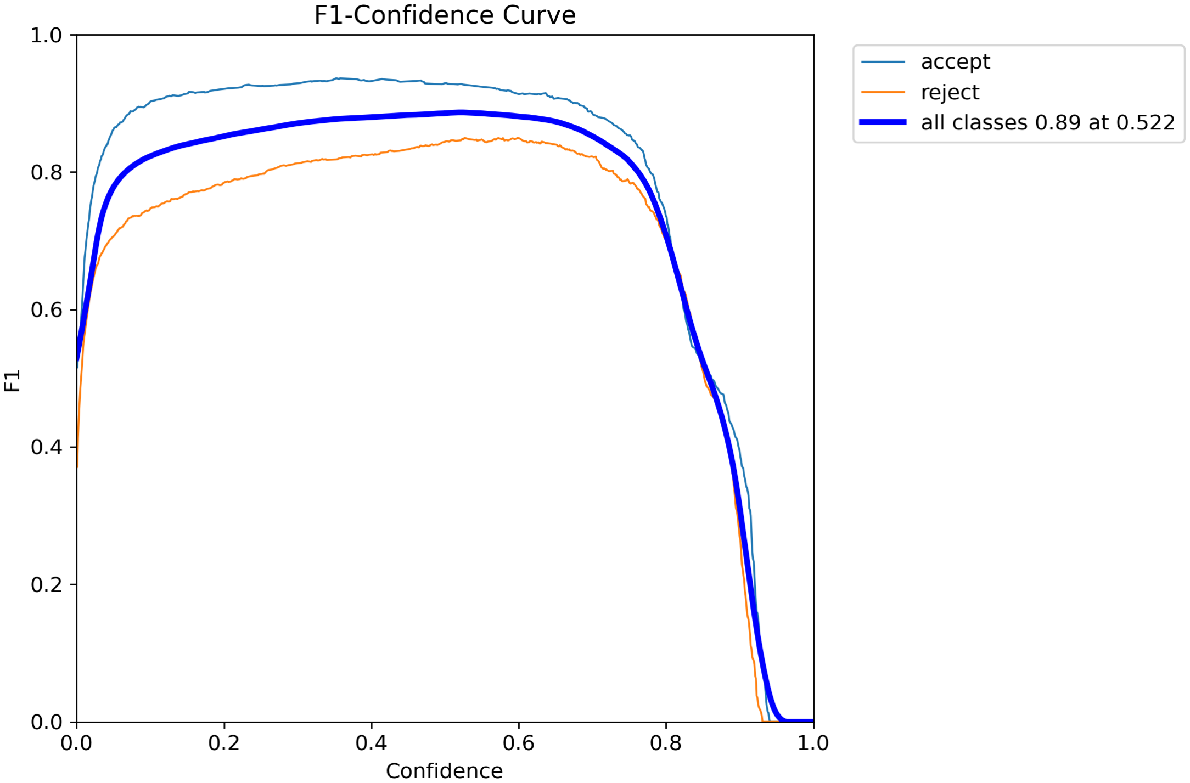
[picture p119: figure]

Figure 4.7: F1-score vs. confidence threshold curve for the YOLOv11n binary classifier,

showing optimal operating point for accept/reject classification

Figure 4.8 shows the precision-recall curve, and Figure 4.9 presents the normalised con-

fusion matrix on the test split.

Chapter 4. Results and Discussion | 49

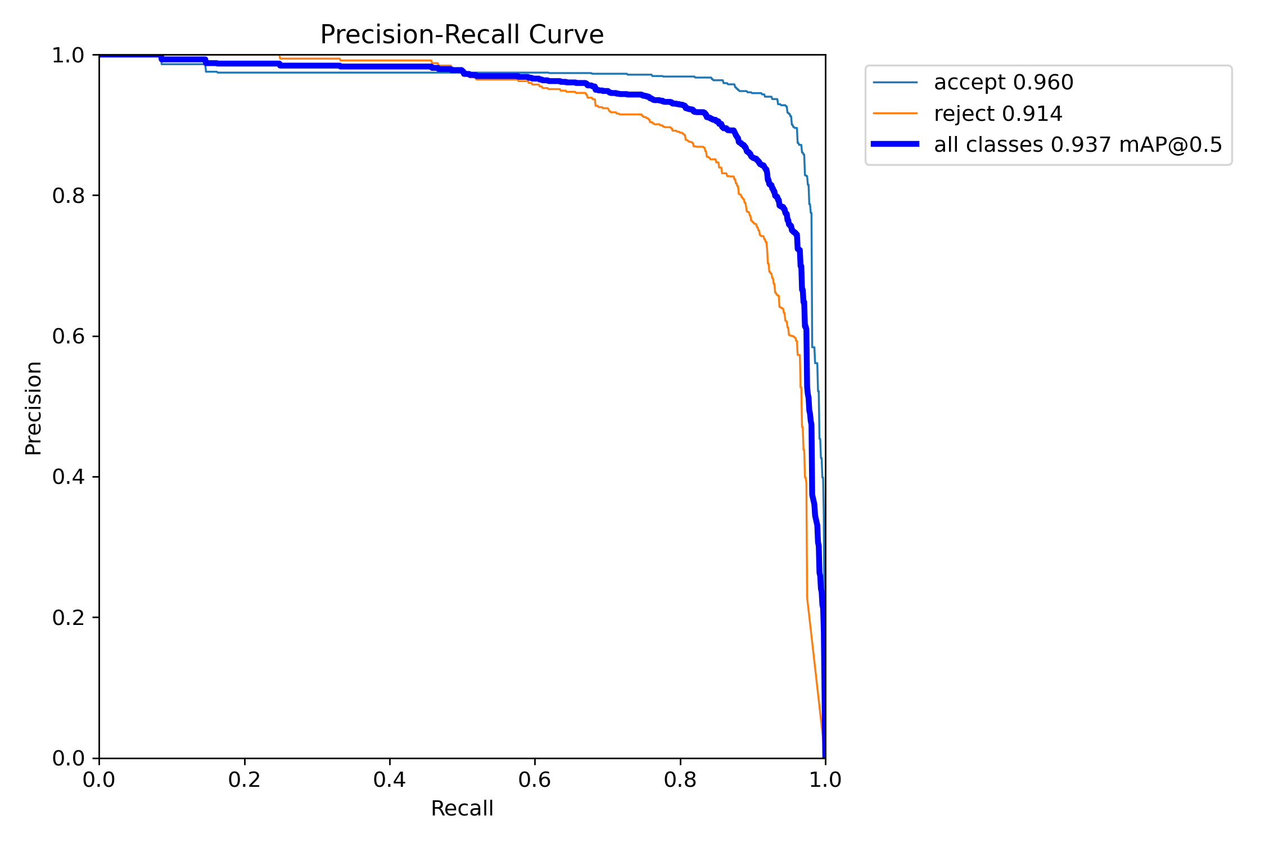
[picture p120: figure]

Figure 4.8: Precision-Recall curve demonstrating the trade-off between precision and

recall across confidence thresholds for both accept and reject classes

Chapter 4. Results and Discussion | 50

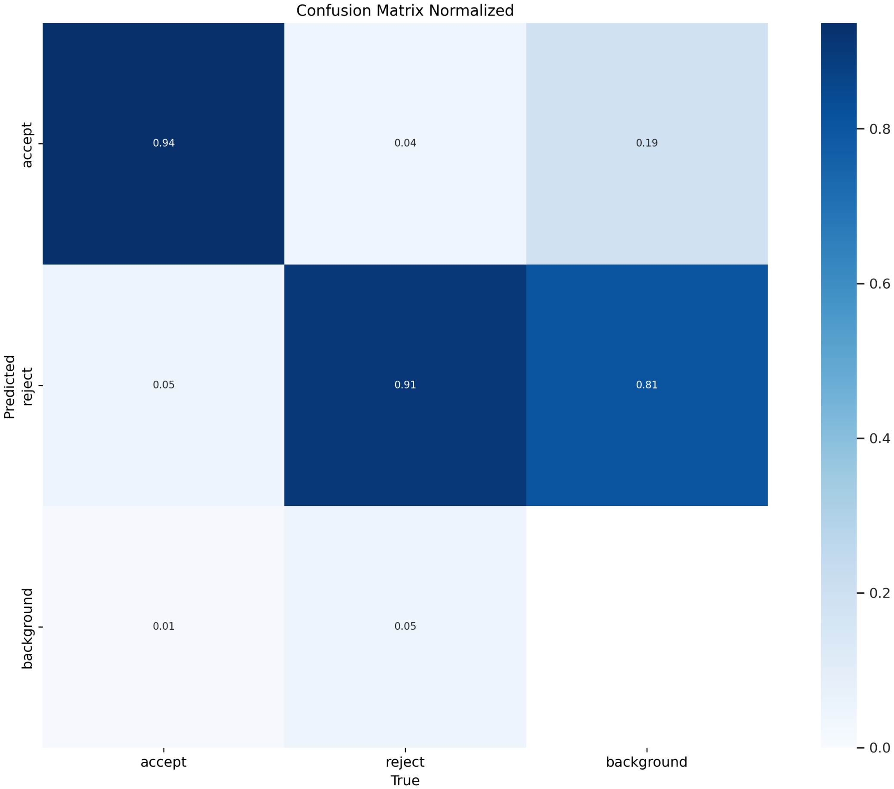
[picture p121: figure]

Figure 4.9: Normalised confusion matrix on the test split showing classification accuracy

for accept (ripe) and reject (unripe/semi-ripe/overripe) categories

Table 4.3 summarises the final evaluation metrics on the test split.

Table 4.3: YOLOv11n evaluation results on test split

Class | Precision Recall mAP@0.5 mAP@0.5:0.95
accept (ripe) | TODO | TODO | TODO | TODO
reject (all other states) | TODO | TODO | TODO | TODO
Overall (binary mean) | TODO | TODO | TODO | TODO

### 4.4.3 Dataset Visualisations

Figure 4.10 shows the ground truth label distribution across the training dataset, and

Figure 4.11 presents a validation batch with ground-truth annotations.

Chapter 4. Results and Discussion | 51

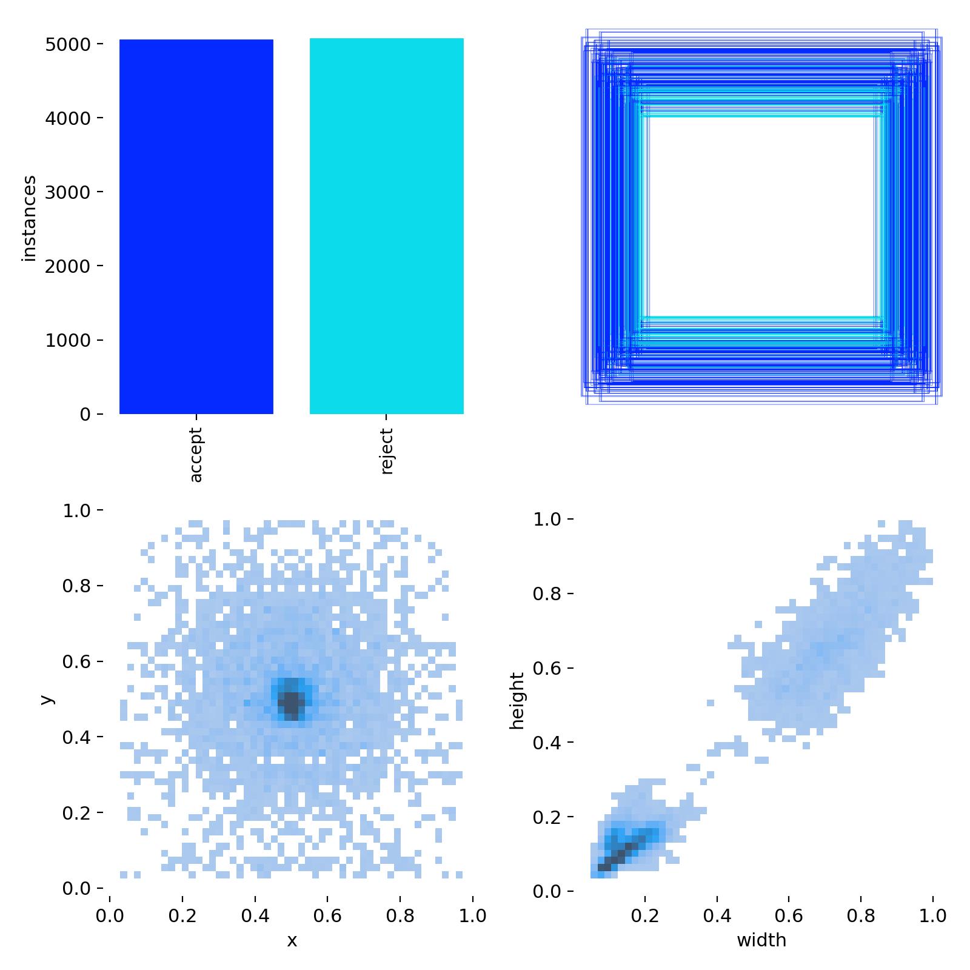
[picture p122: figure]

Figure 4.10: Ground truth label distribution visualisation showing the spatial distribution

and class balance of accept and reject instances across the training dataset

Chapter 4. Results and Discussion | 52

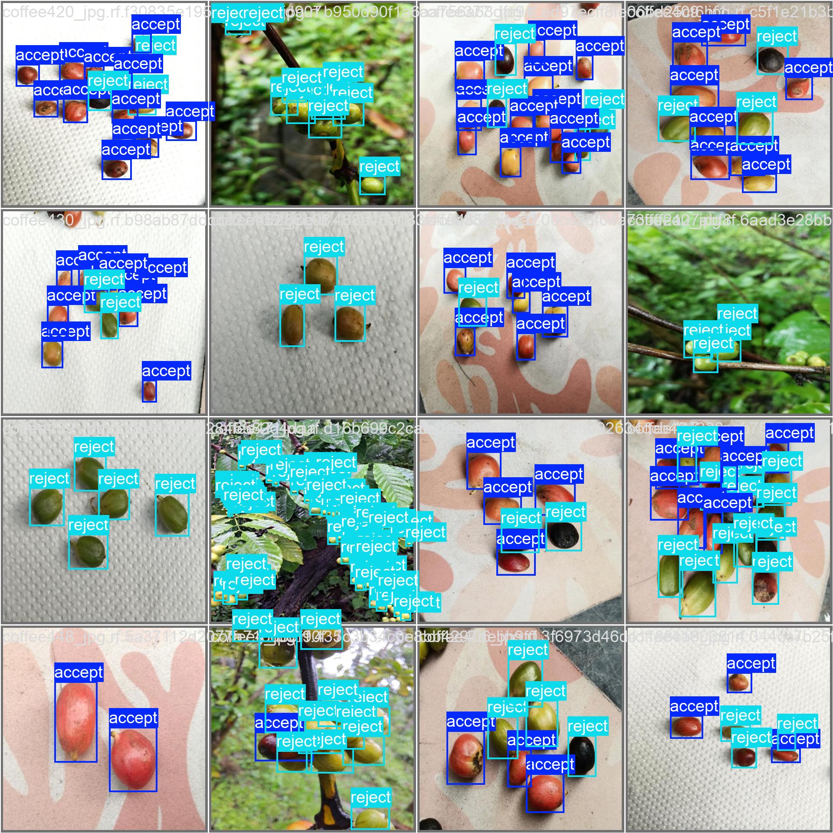
[picture p123: figure]

Figure 4.11: Validation batch 0 with ground-truth bounding box annotations for accept

(ripe) and reject (unripe/semi-ripe) berries

### 4.4.4 Sample Detection Output

Figure 4.12 demonstrates the trained model’s inference performance on a validation batch,

showing predicted bounding boxes and confidence scores.

Chapter 4. Results and Discussion | 53

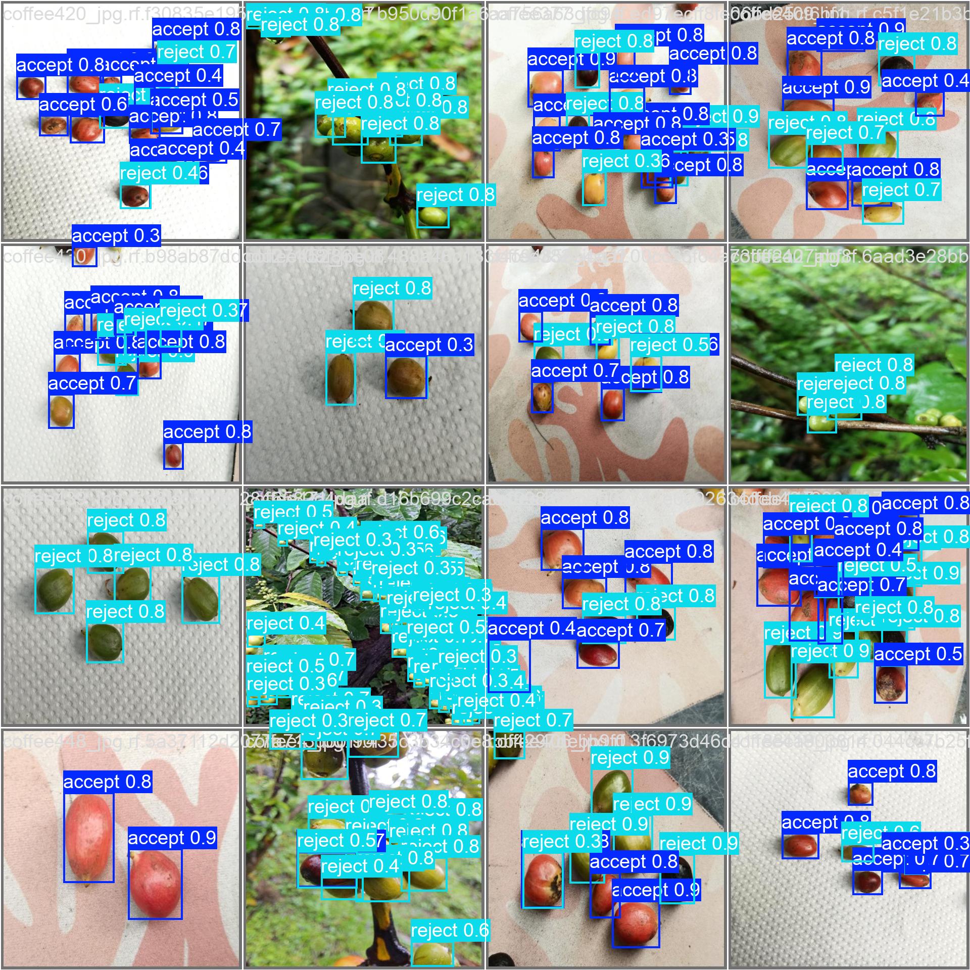
[picture p124: figure]

Figure 4.12: YOLOv11n inference output on validation batch 0: predicted accept/reject

bounding boxes with confidence scores demonstrating the model’s classification perfor-

mance on unseen test images

## 4.5 Software Development

The following software modules have been developed and are tracked in the CoffeeBerry YOLO

Git repository:

code/training/train.py — YOLOv11 fine-tuning script.

code/training/evaluate.py — test-split evaluation.

Chapter 4. Results and Discussion | 54

code/inference/predict camera.py — live camera inference with global-shutter

capture.

code/utils/split dataset.py — 70/15/15 dataset splitter.

code/utils/visualize results.py — training curve plotter.

Figure 4.13 shows the overall control flow illustrating task distribution between the Rasp-

berry Pi and ESP32.

Chapter 4. Results and Discussion | 55

System Start

System Initialization | Raspberry Pi
Start Vibrating Feeder | ESP32
Capture Image Frame | Raspberry Pi
| No
Pre-process Image | Raspberry Pi
Detect | Berries | Raspberry Pi

BerryDetected?

Classify Berry(CNN Model) | Raspberry Pi
Track PositionCalculate Velocity | Raspberry Pi
Send Data | via UART | Raspberry Pi
Receive Berry Data | ESP32

UnripeBerry?

Calculate EjectionTiming | ESP32
Trigger SolenoidActuator | ESP32
StopCommand? | Continue

System Stop

Yes

Yes

No

Yes

No

Legend:
Raspberry Pi 3 Tasks
ESP32 Tasks

Chapter 4. Results and Discussion | 56

## 4.6 Discussion: Progress Against Objectives

Table 4.4: Progress summary against specific objectives

Obj. Description | Status | % Complete
1 | Analyse performance limitations | Completed: motion blur, la-

tency (380 ms), and classifica-

tion accuracy quantified

100%

2 | Improve the sorting mechanism | Completed: | global-shutter
camera, | MOSFET | drivers,

ESP32 co-processor, Proteus

| | verified

90%

3 | Evaluate upgraded processing hardware In progress: Pi 4 procured,
binary | dataset | compiled,

YOLOv11 training ongoing

70%

Chapter 5. Conclusion | 57

## 5 Conclusion

## 5.1 Summary

This interim report documents the progress made to date on the modification and im-

provement of the existing automated coffee berry sorting machine. The work carried out

has addressed the first four specific objectives defined in Chapter 1.

A thorough diagnostic audit of the existing system revealed measurable performance lim-

itations, including a pipeline latency of approximately 380 ms and an overall classification

accuracy of approximately 72%, both falling short of the project targets. These find-

ings confirmed the need for hardware and algorithmic improvement and established a

quantitative baseline for comparison.

The YOLOv11n deep learning model was selected and the training pipeline was de-

veloped, with a labelled dataset compiled under a binary accept/reject classification

scheme: the accept class covers fully ripe (deep-red) berries; the reject class consoli-

dates unripe, semi-ripe, overripe, and damaged berries. This binary scheme eliminates

the semi-ripe/ripe boundary confusion that limited the reference model. Initial training

has been conducted; evaluation is ongoing.

Hardware procurement is complete. The Raspberry Pi 4 (4 GB RAM), Raspberry Pi

Camera Module V3, ESP32 DevKit, and LED ring illumination unit have all been bench-

tested and confirmed operational. The electrical schematic and system block diagram

have been produced and are presented in Chapter 4.

Software development is advancing: training, evaluation, and inference scripts have been

written and are tracked in the CoffeeBerry YOLO repository. The UART communication

protocol between the Pi and ESP32 has been prototyped and documented.

Chapter 5. Conclusion | 58

## 5.2 Future Work

The following tasks remain to complete the project by the final submission deadline:

1. Model optimisation: Export the trained YOLOv11n model to ONNX / TFLite

format and benchmark inference speed on the Raspberry Pi 4. Apply quantisation

if necessary to achieve < 100 ms per frame.

2. Centroid tracking integration: Implement a lightweight centroid tracker to as-

sociate detections across frames and calculate berry position on the belt relative to

the ejection zone.

3. UART communication protocol: Finalise the Pi ↔ ESP32 messaging protocol

for solenoid trigger commands, including robust error handling and retransmission

logic.

4. Physical integration: Mount the Pi Camera above the conveyor detection win-

dow, calibrate belt-speed-to-timing offset, and wire the solenoid driver circuits.

5. Throughput benchmarking: Measure berries per minute at several belt speeds

and identify the optimal operating point.

6. Documentation and final report: Write up final results, update design drawings,

and compile the complete project report.

## 5.3 Project Schedule

The project schedule is provided in Appendix B.

## 5.4 Risk Assessment

The budget summary is provided in Appendix B.

REFERENCES | 59

## References

[1] J. Mugo et al., “Design and development of an automated coffee berry sorting ma-

chine,” Final Year Project Report, Jomo Kenyatta University of Agriculture and

Technology (JKUAT), Mechatronic Engineering Department, 2019.

[2] T. Brosnan and D.-W. Sun, “Improving quality inspection of food products by com-

puter vision — a review,” Journal of Food Engineering, vol. 61, no. 1, pp. 3–16,

2004.

[3] M. Sandler, A. Howard, M. Zhu, A. Zhmoginov, and L.-C. Chen, “MobileNetV2:

Inverted residuals and linear bottlenecks,” in Proceedings of the IEEE Conference on

Computer Vision and Pattern Recognition (CVPR), 2018, pp. 4510–4520.

[4] J. Blasco, N. Aleixos, and E. Molt´o, “Machine vision system for automatic quality

grading of fruit,” Biosystems Engineering, vol. 85, no. 4, pp. 415–423, 2003.

[5] S. Kumar, “Computer vision-based fabric defect detection: a survey,” IEEE Trans-

actions on Industrial Electronics, vol. 55, no. 1, pp. 348–363, 2008.

[6] S. Cubero, N. Aleixos, E. Molt´o, J. G´omez-Sanchis, and J. Blasco, “Advances in

machine vision applications for automatic inspection and quality evaluation of fruits

and vegetables,” in Food and Bioprocess Technology, vol. 4, 2011, pp. 487–504.

[7] A. Mahmood, J.-P. Oakley, and D. Sherwood, “Air-jet separation of agricultural

products: a review of key parameters,” Computers and Electronics in Agriculture,

vol. 162, pp. 739–751, 2019.

[8] P. Ramos, F. Prieto, E. Montoya, and C. Oliveros, “Automatic fruit count on coffee

branches using computer vision,” Computers and Electronics in Agriculture, vol. 137,

pp. 9–22, 2017.

[9] W. S. Noble, “What is a support vector machine?” Nature Biotechnology, vol. 24,

no. 12, pp. 1565–1567, 2006.

REFERENCES | 60
[10] X. Zhang, Y. Qiao, F. Meng, C. Fan, and M. Zhang, “Identification of maize leaf dis-

eases using improved deep convolutional networks,” IEEE Access, vol. 6, pp. 30 370–

30 377, 2018.

[11] Y. Li, J. Chen, X. Zheng et al., “Deep learning for agricultural product quality

grading: A review,” Computers and Electronics in Agriculture, vol. 195, p. 106826,

2022.

[12] A. G. Howard, M. Zhu, B. Chen, D. Kalenichenko, W. Wang, T. Weyand, M. An-

dreetto, and H. Adam, “MobileNets: Efficient convolutional neural networks for

mobile vision applications,” arXiv preprint arXiv:1704.04861, 2017.

[13] J. Redmon, S. Divvala, R. Girshick, and A. Farhadi, “You only look once: Unified,

real-time object detection,” in Proceedings of the IEEE Conference on Computer

Vision and Pattern Recognition (CVPR), 2016, pp. 779–788.

[14] J. Redmon and A. Farhadi, “YOLOv3: An incremental improvement,” arXiv preprint

arXiv:1804.02767, 2018.

[15] Ultralytics, “YOLOv11: Object detection and segmentation framework,” https://

docs.ultralytics.com, 2024.

[16] Espressif | Systems, | “ESP32 | technical | reference | manual, | version | 5.1,”

https://www.espressif.com/sites/default/files/documentation/esp32 technical

reference manual en.pdf, (https://www.espressif.com/sites/default/files/documentation/esp32_technical_reference_manual_en.pdf) 2023.

Chapter A. Circuit Schematics | 61

## A Circuit Schematics

12V Battery+ GND

Raspberry Pi 3(UART RX/TX) | ESP32Microcontroller(3.3V)
5V (via buck) | 3.3V regulator

UART

GPIO | 16/17 GPIO 14/15
Ejector | 1(Valve) Ejector 2(Valve) | Ejector 3(Valve) Ejector | 4(Valve)
VibratingMotor | AirCompressor | LED | Strip

Pi Camera(CSI)

GPIO 4 | GPIO 5 | GPIO 12 | GPIO 13
GPIO 14 | (PWM)

GPIO 21

GPIO 22 (PWM)

+12V

GND (Common)

Protection Components:• Flyback diodes (1N4007) on all ejector valves• 220Ohm gate resistors + 100kOhm pull-downs• 10A fuse on main 12V supply

Figure A.1: Electrical schematic

Chapter A. Circuit Schematics | 62

### ESP32 Co-Processor Electrical Schematic

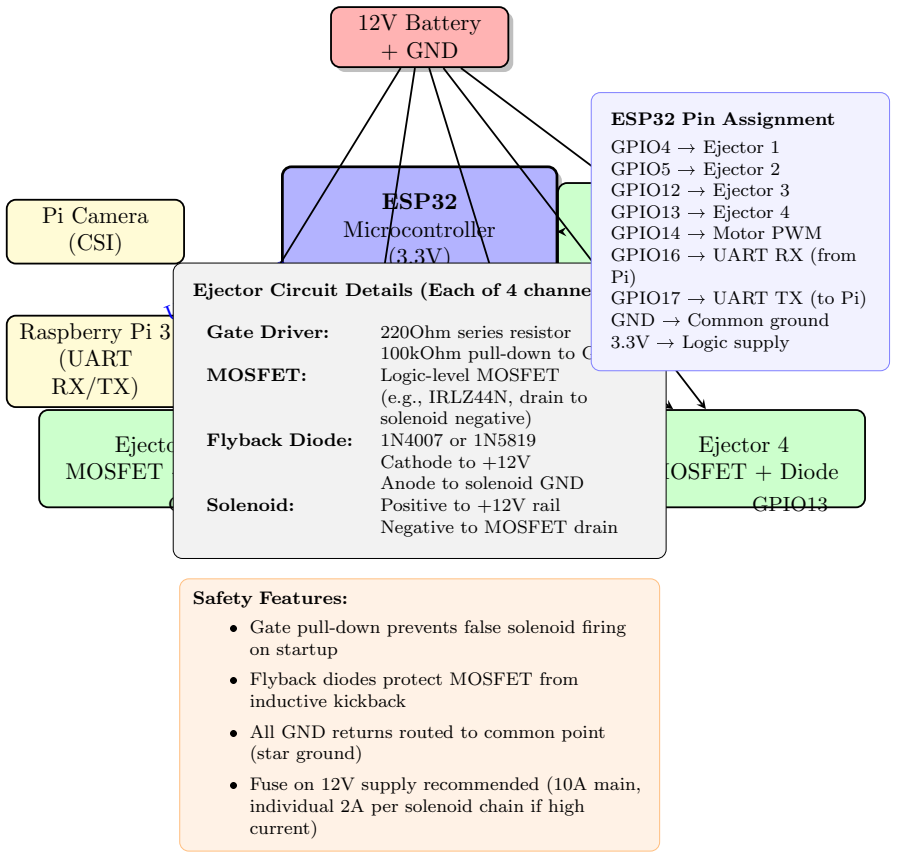
[picture p125: figure]
12V Battery + GND; ESP32 Microcontroller (3.3V); Pi Camera (CSI); Raspberry Pi 3 (UART RX/TX); UART 115k2; Vibrating Motor PWM Control; GPIO14  PWM 12V Motor Driver; Ejector 1 MOSFET + Diode; GPIO4; Ejector 2 MOSFET + Diode; GPIO5; Ejector 3 MOSFET + Diode; GPIO12; Ejector 4 MOSFET + Diode; GPIO13; Gate Driver:; 220Ohm series resistor; 100kOhm pull-down to GND; MOSFET:; Logic-level MOSFET; (e.g., IRLZ44N, drain to solenoid negative); Flyback Diode:; Cathode to +12V Anode to solenoid GND; Solenoid:; Positive to +12V rail; Negative to MOSFET drain; ESP32 Pin Assignment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

Ejector Circuit Details (Each of 4 channels):

| Gate pull-down prevents false solenoid firing
| All GND returns routed to common point
| Fuse on 12V supply recommended (10A main, individual 2A per solenoid chain if high

Figure A.2: ESP32 pin mapping schematic

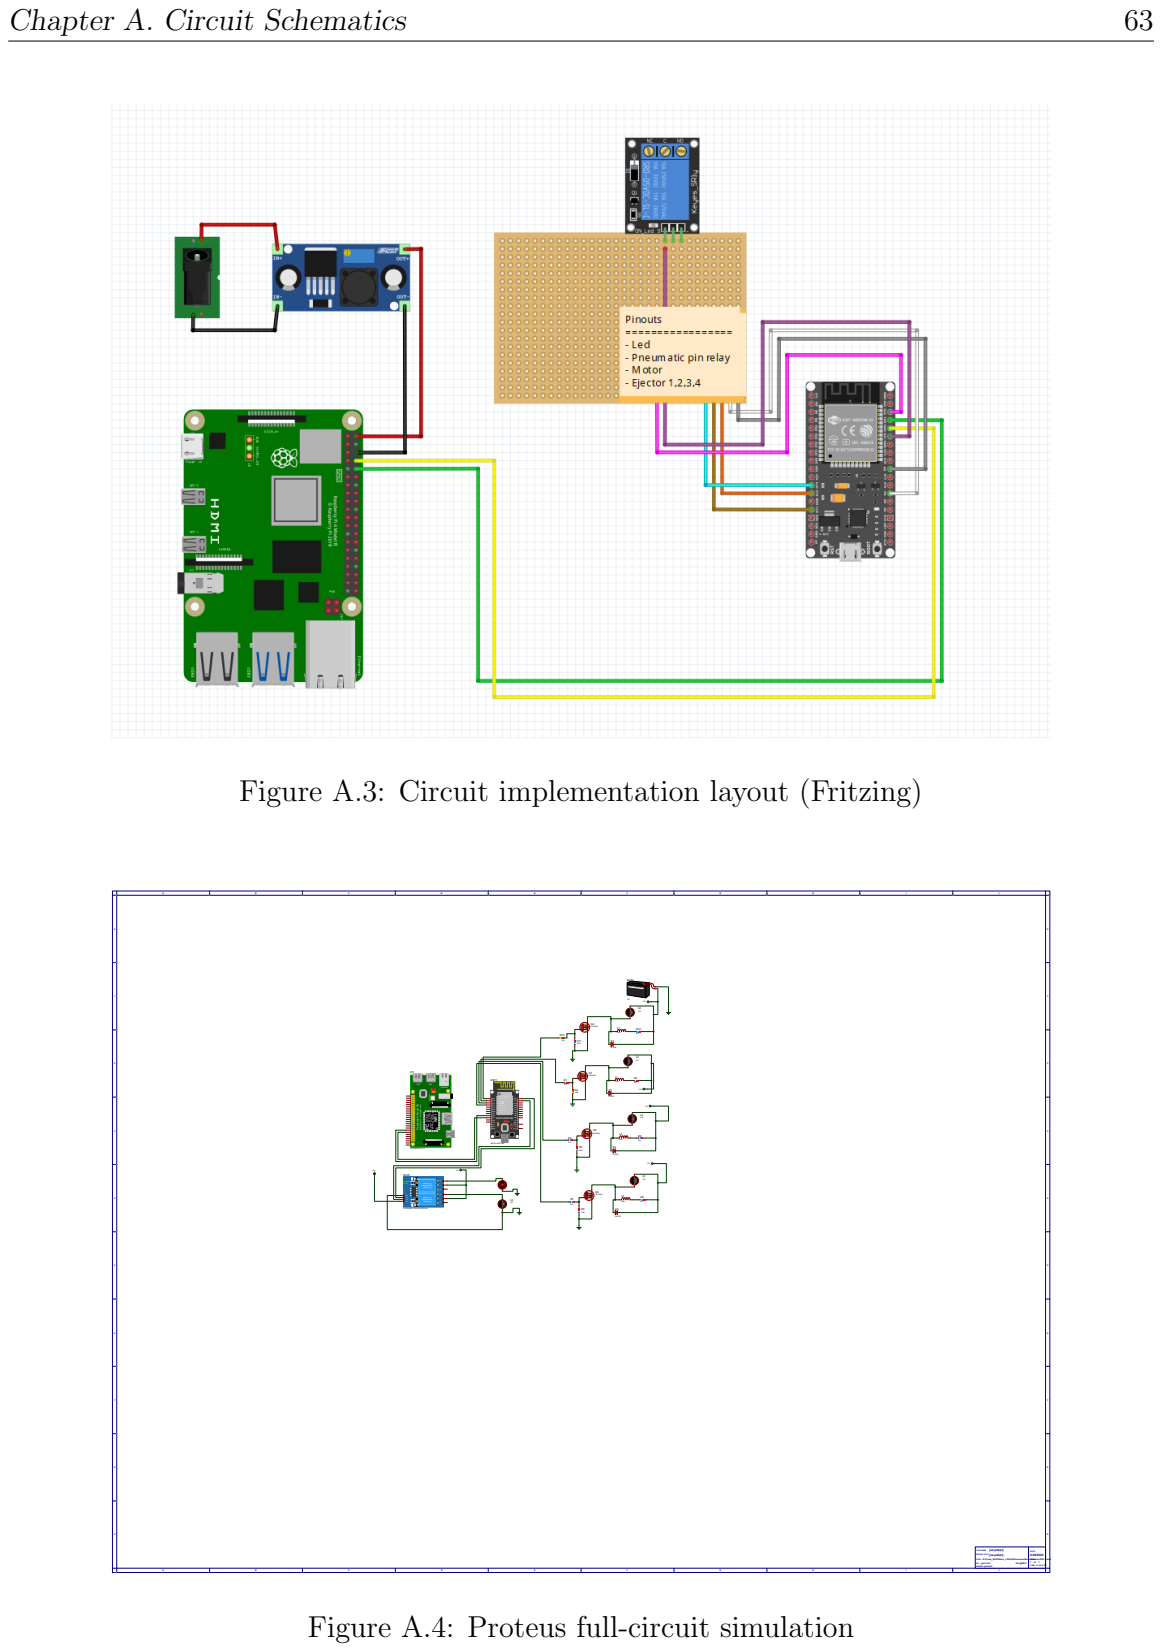
[picture p126: page 74]

Figure A.3: Circuit implementation layout (Fritzing)

DESIGN TITLE: joe.pdsprj
PATH: E:\Comp_Stuff\Glenn_s Shtuff\Documens\School\assino\fifth assine
@AUTHOR
BOARD: @BOARD

Figure A.4: Proteus full-circuit simulation

## B Schedule and Budget

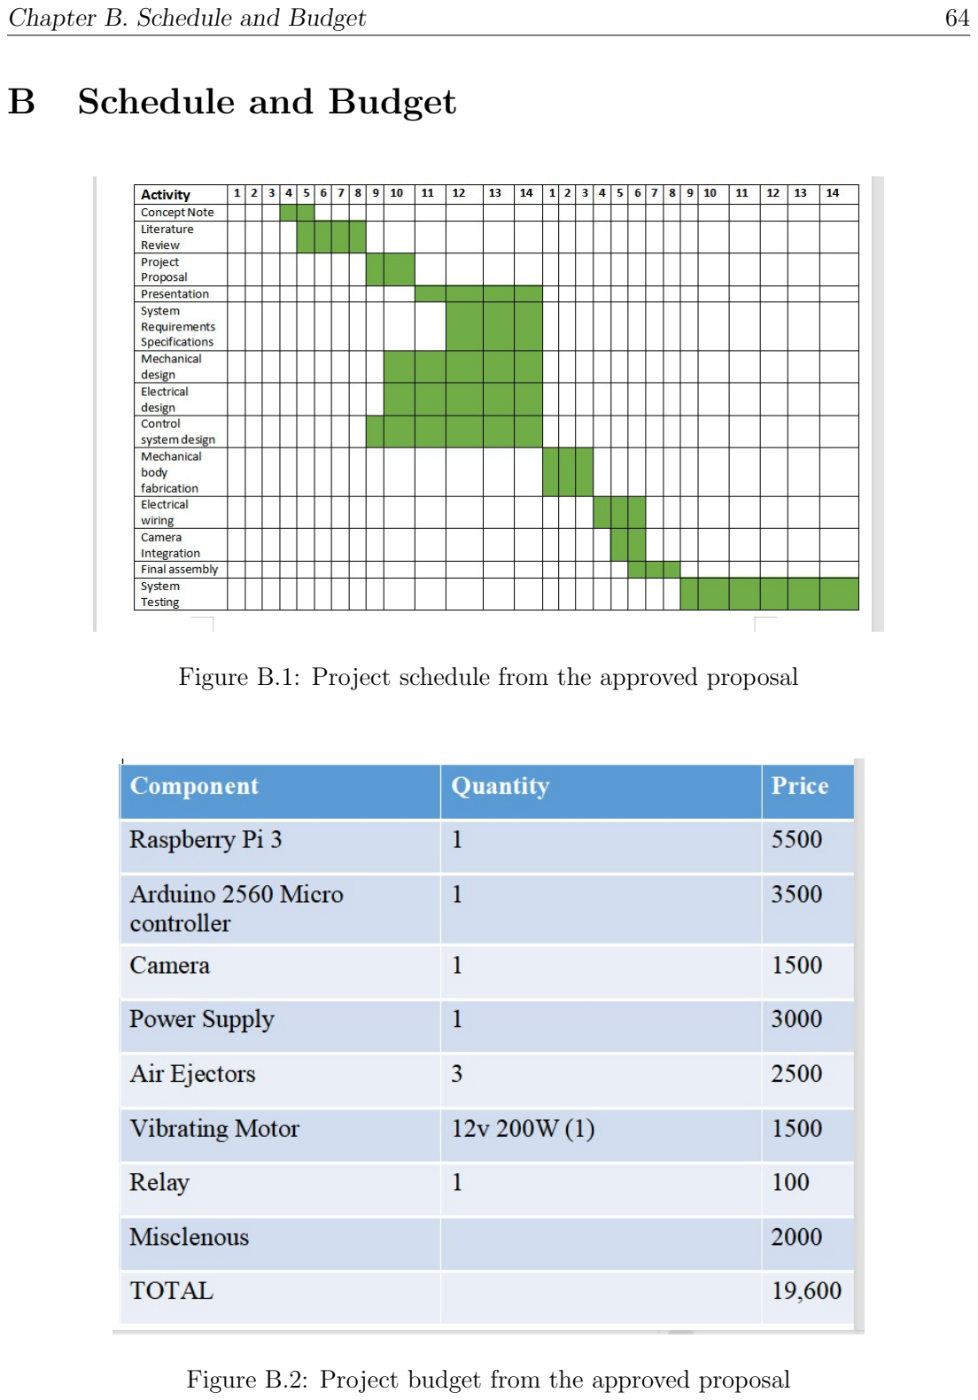
[picture p127: page 75]

Chapter B. Schedule and Budget | 64

Figure B.1: Project schedule from the approved proposal

Figure B.2: Project budget from the approved proposal

Chapter C. Dataset and Model Outputs | 65

## C Dataset and Model Outputs

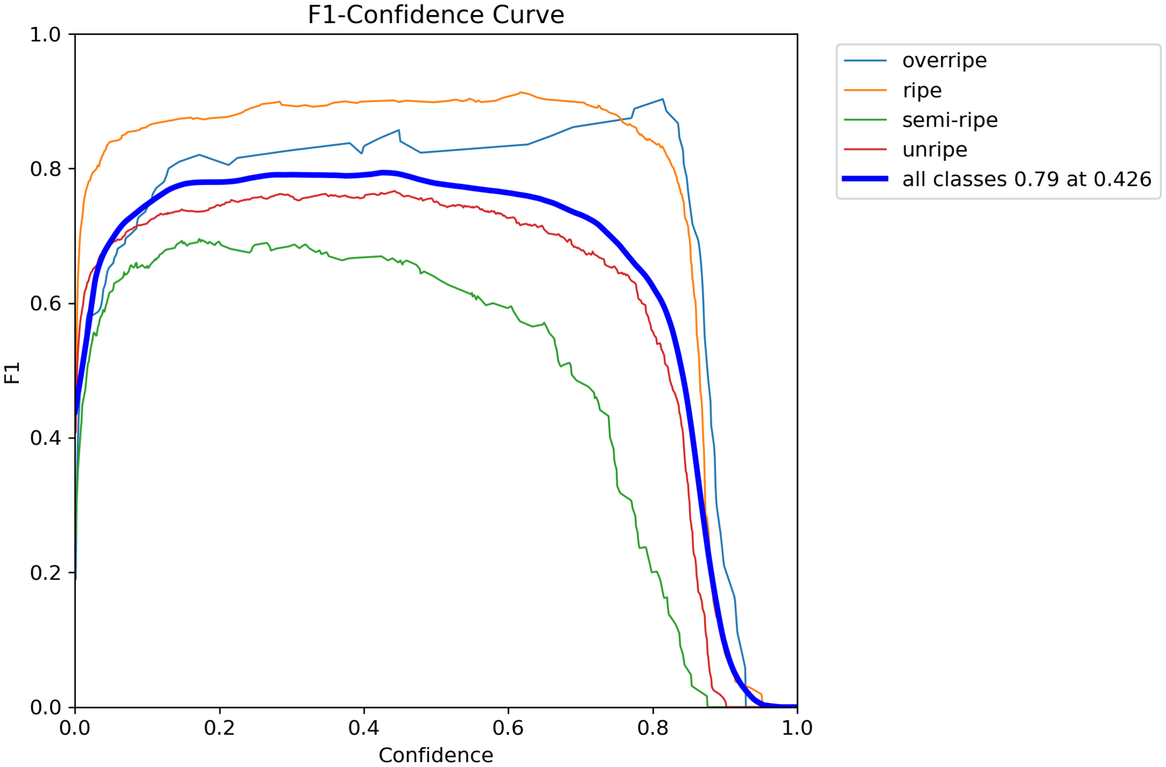
[picture p128: figure]

Figure C.1: Reference model F1 curve

Chapter D. Mechanical Design Schematics | 66

Figure C.2: Reference model validation batch labels

## D Mechanical Design Schematics

Detailed mechanical design schematics from the reference implementation [1] are provided

below for reference. These technical drawings document the dimensional specifications

and assembly details of the mechanical subsystem that is retained in the improved sorting

machine.

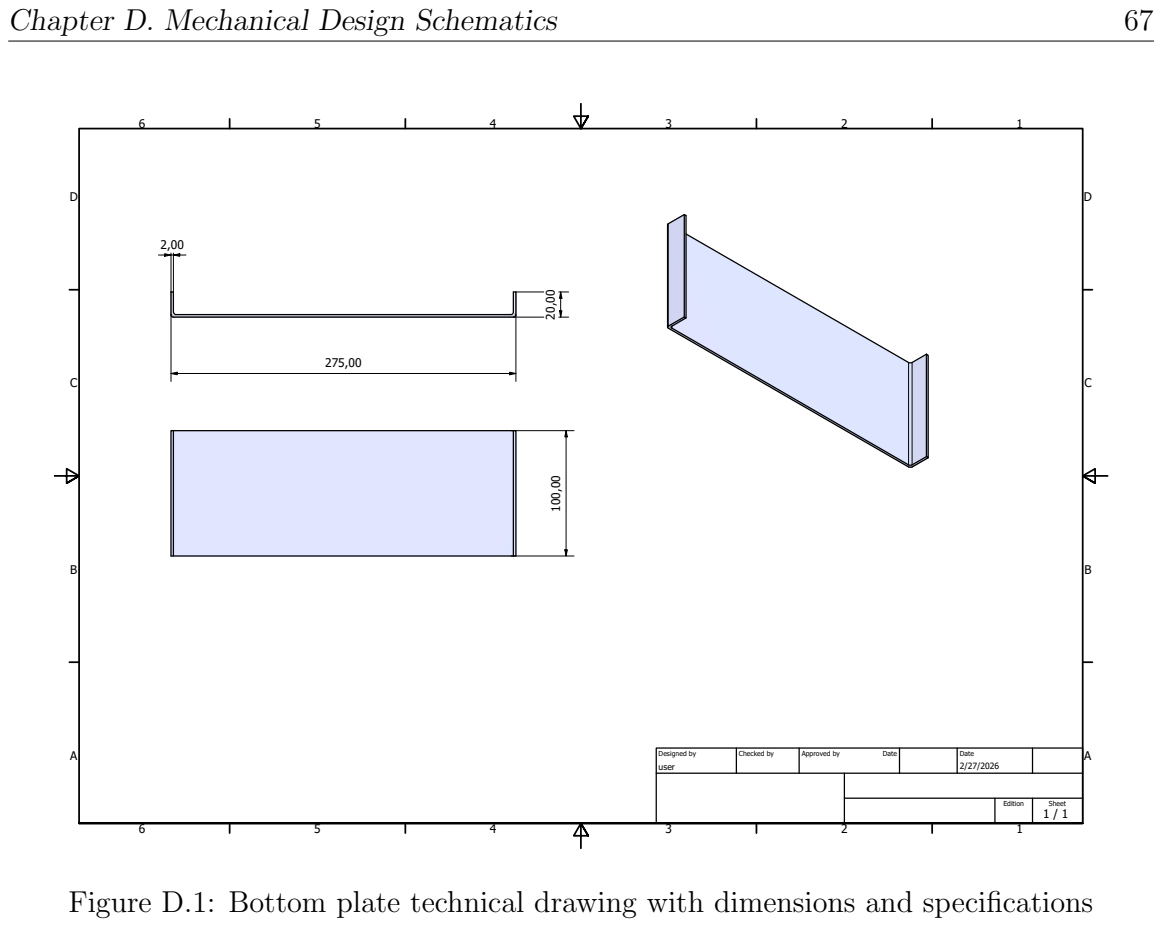
[picture p129: page 78]
Chapter D. Mechanical Design Schematics; user; Designed by; Checked by; Approved by; Date; Edition; Sheet

Figure D.1: Bottom plate technical drawing with dimensions and specifications

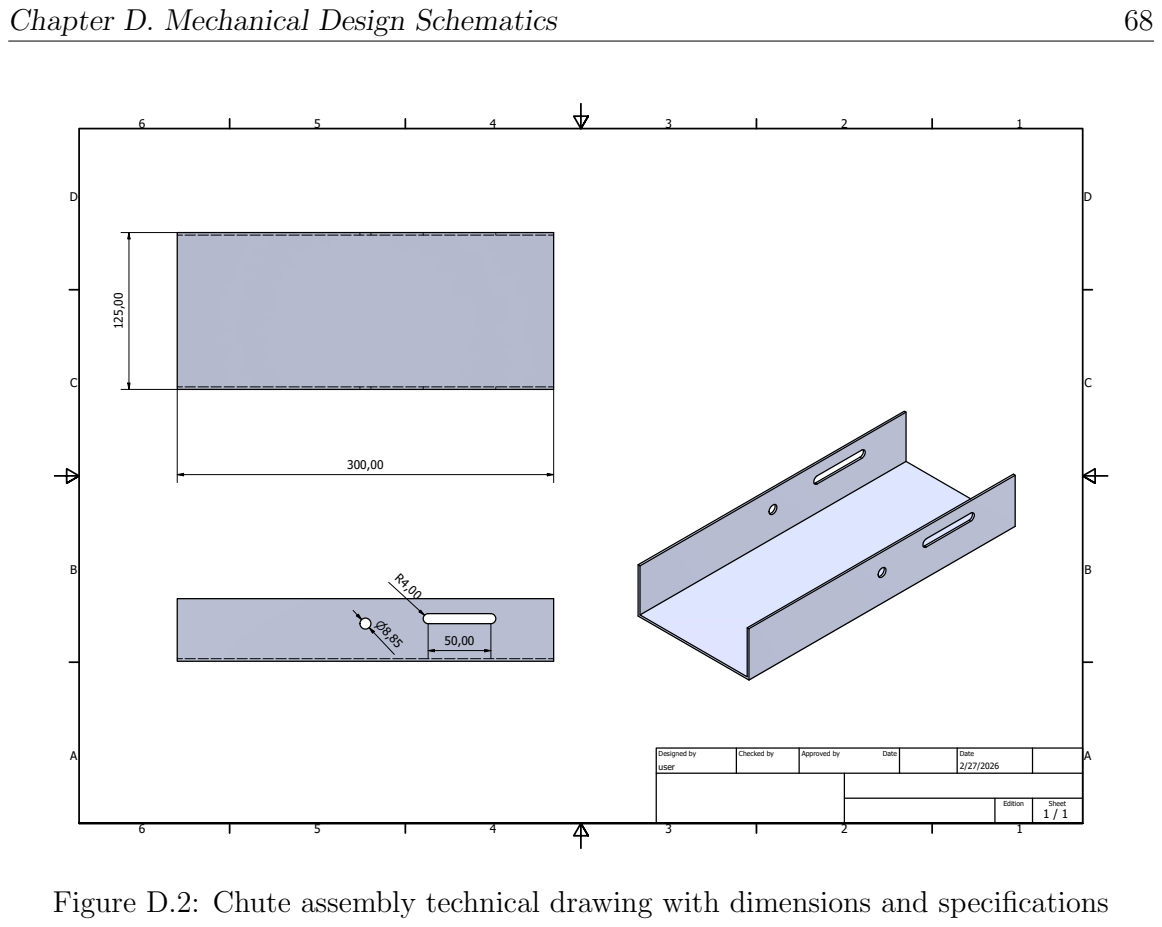
[picture p130: page 79]
Chapter D. Mechanical Design Schematics; user; Designed by; Checked by; Approved by; Date; Edition; Sheet

Figure D.2: Chute assembly technical drawing with dimensions and specifications

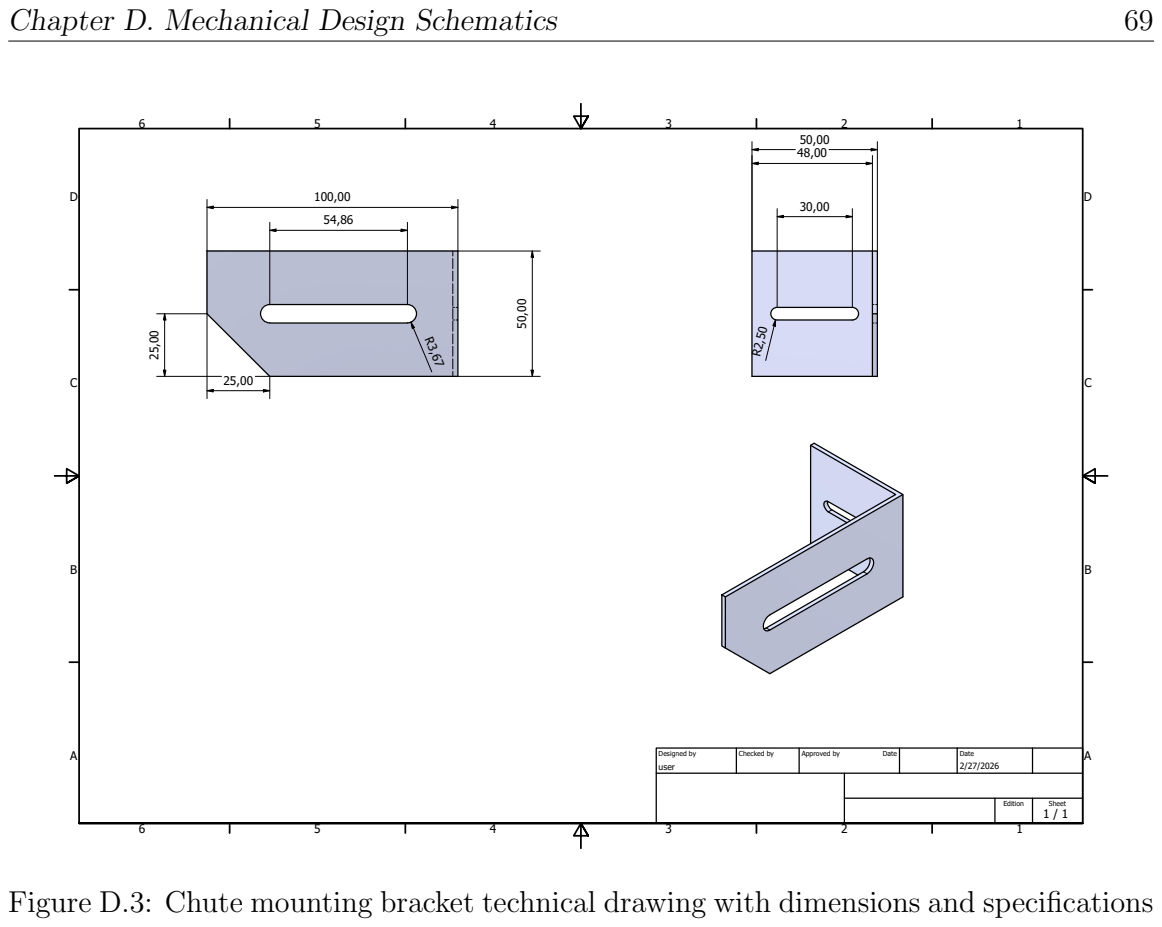
[picture p131: page 80]
Chapter D. Mechanical Design Schematics; user; Designed by; Checked by; Approved by; Date; Edition; Sheet

Figure D.3: Chute mounting bracket technical drawing with dimensions and specifications

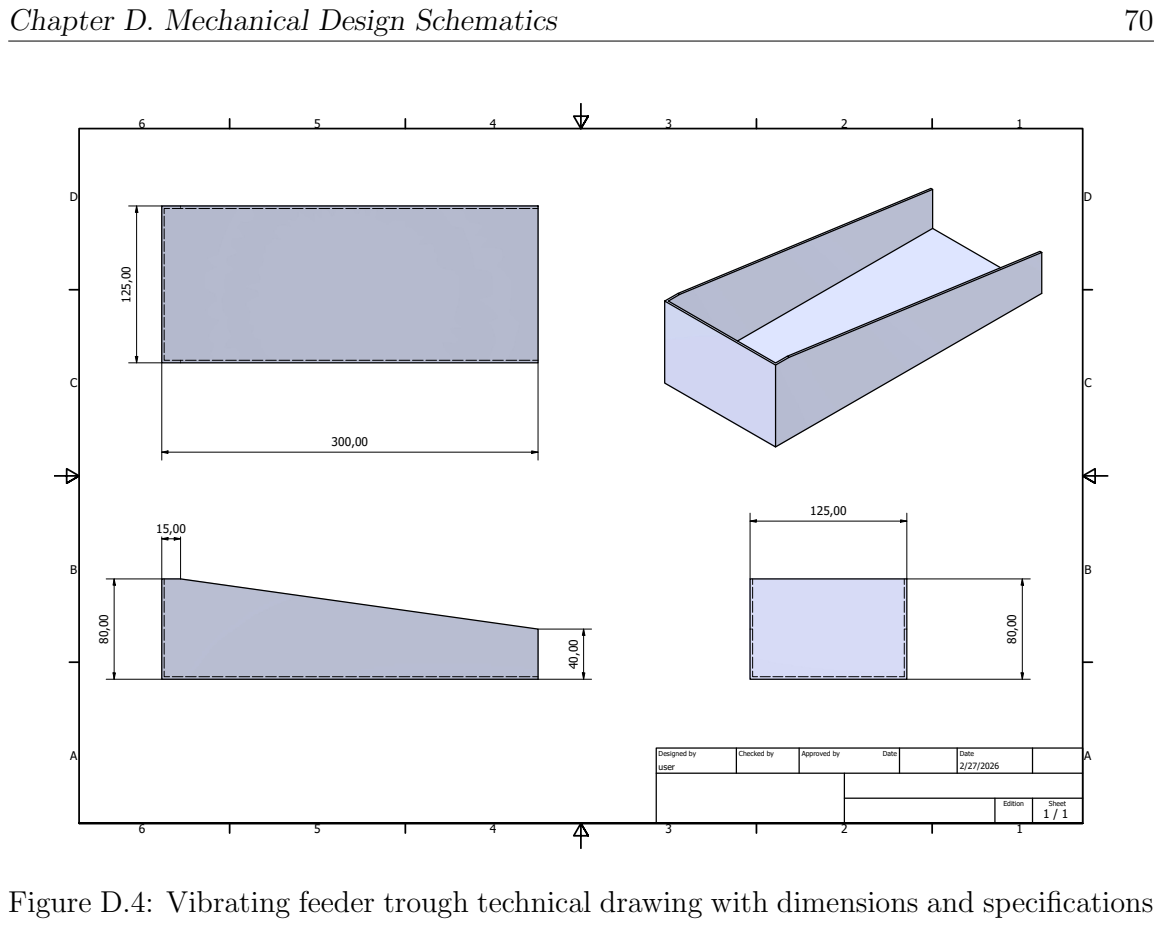
[picture p132: page 81]
Chapter D. Mechanical Design Schematics; user; Designed by; Checked by; Approved by; Date; Edition; Sheet

Figure D.4: Vibrating feeder trough technical drawing with dimensions and specifications

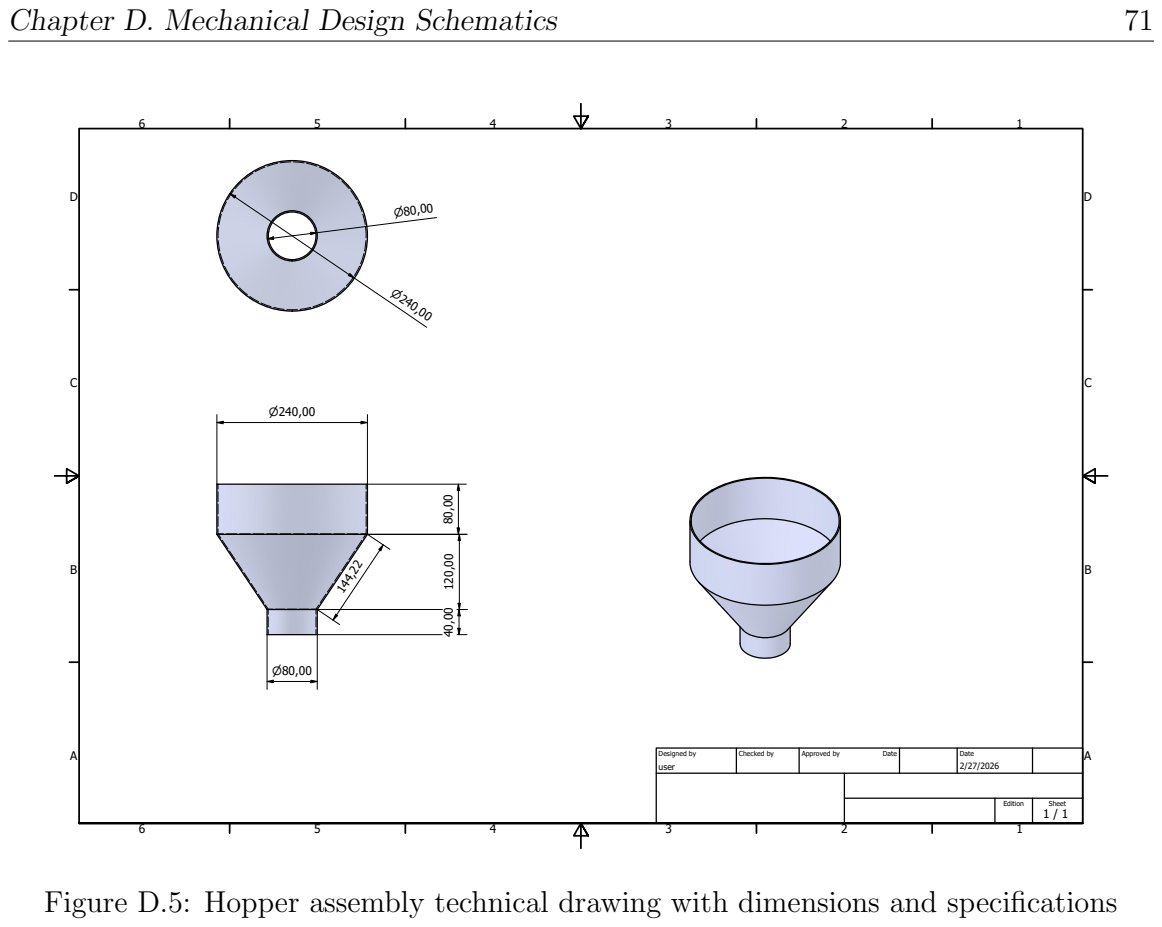
[picture p133: page 82]
Chapter D. Mechanical Design Schematics; user; Designed by; Checked by; Approved by; Date; Edition; Sheet

Figure D.5: Hopper assembly technical drawing with dimensions and specifications
