khanji254/FYP_2025_Recovery/project_proposal/context/Nakuja_Concept (1).pdf

# Design and Development of a Reliable Dual Recovery System with Extended Range Telemetry for the Nakuja N4 Rocket

### Glenn Kanyi – ENM221-0149/2021

### Ian Joseph – ENM221-0249/2021

### Emails: glenngatiba@gmail.com, josephian1810@gmail.com Contacts: 0705 589 973 / 0768 395 187

### September 23, 2025

## 1. Problem Statement

The Nakuja N4 rocket’s current parachute deployment mechanism uses nichrome wire to burn through retaining cords. However, it can be harmful to parachute deployment because the nichrome wire frequently heats up too quickly and may melt before achieving dependable ignition. The telemetry range of the current avionics is restricted, resulting in communication blackouts during recovery operations. The mission’s success and payload recovery are seriously jeopardized by these
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
