khanji254/FYP_2025_Recovery/images/all/etched FC circuit.jpeg

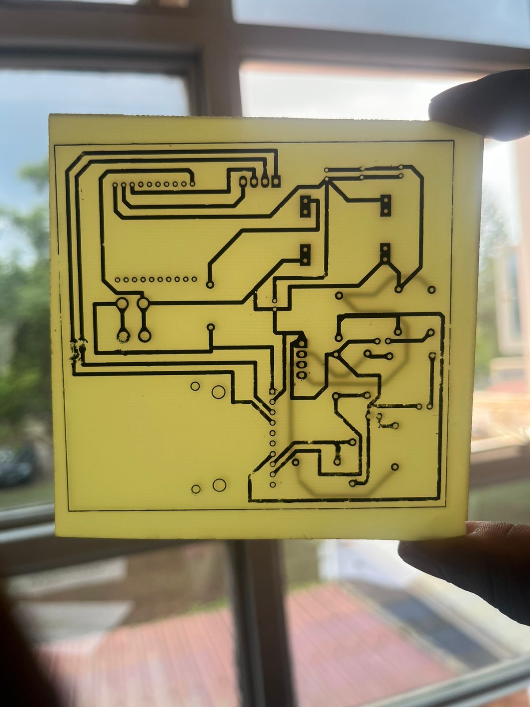
images/all/etched FC circuit.jpeg
