khanji254/FYP_2025_Recovery/images/all/mechanical/18650_case_without title block.JPG

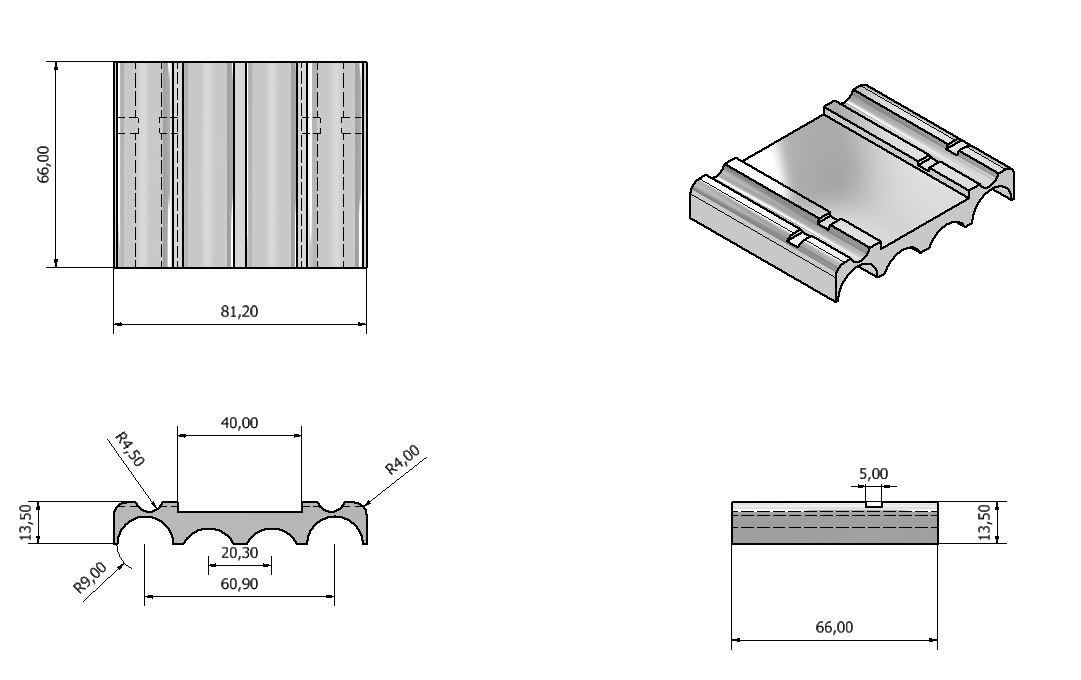
images/all/mechanical/18650_case_without title block.JPG
