khanji254/FYP_2025_Recovery/images/all/mechanical/Cross_sectional view of avionics bay .jpeg

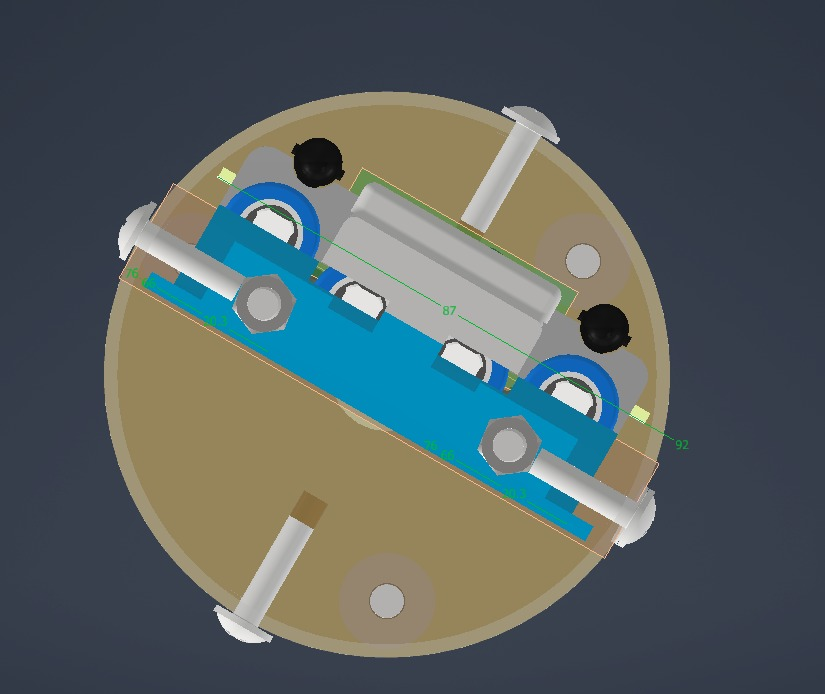
images/all/mechanical/Cross_sectional view of avionics bay .jpeg
