khanji254/FYP_2025_Recovery/images/all/mechanical/Edge_batt_without title block.JPG

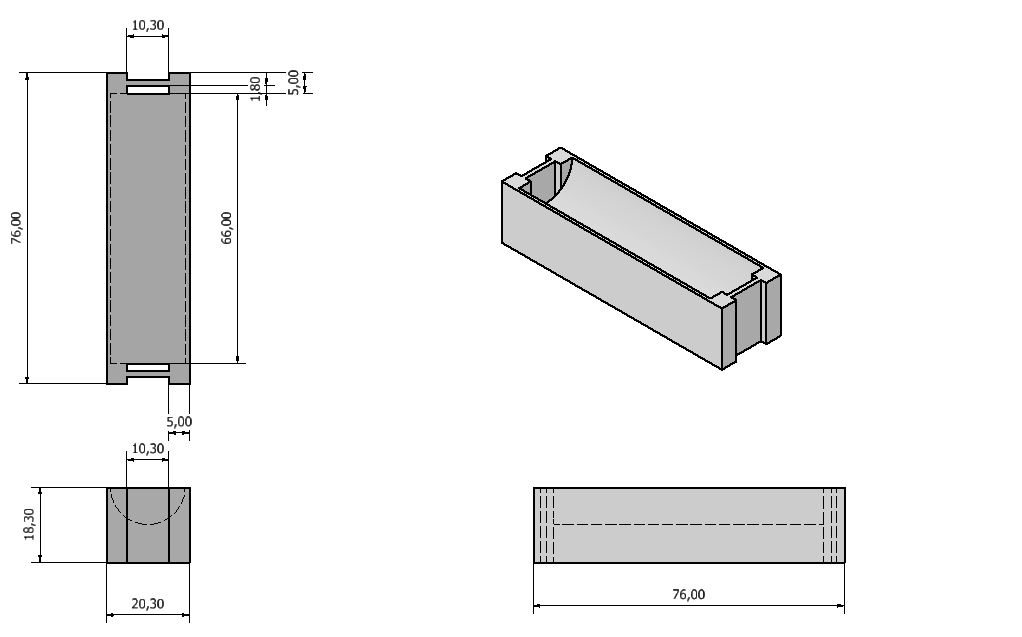
images/all/mechanical/Edge_batt_without title block.JPG
