khanji254/FYP_2025_Recovery/images/all/mechanical/FC_Holder_without title block.JPG

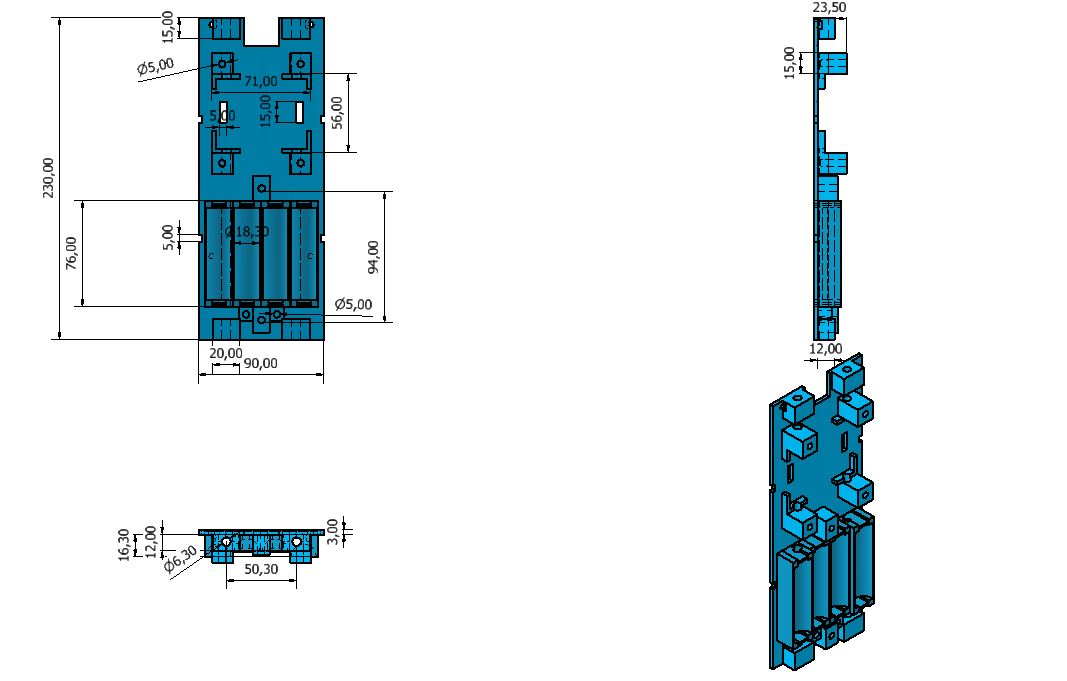
images/all/mechanical/FC_Holder_without title block.JPG
