khanji254/FYP_2025_Recovery/images/all/mechanical/Mid_batt_without title block.JPG

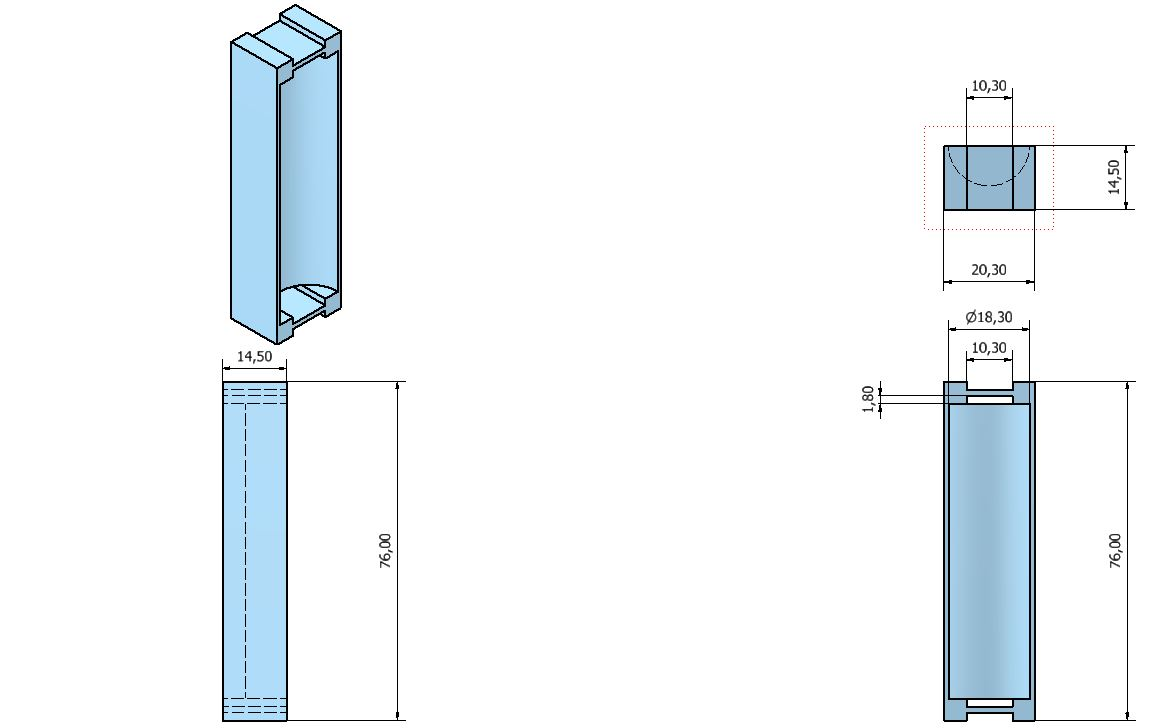
images/all/mechanical/Mid_batt_without title block.JPG
