khanji254/FYP_2025_Recovery/images/all/mechanical/WhatsApp Image 2026-02-25 at 14.30.18.jpeg

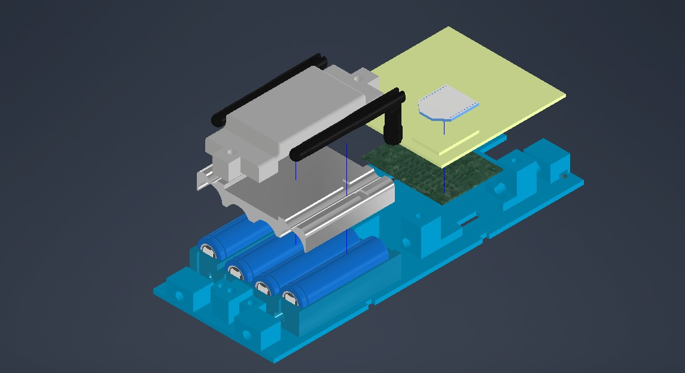
images/all/mechanical/WhatsApp Image 2026-02-25 at 14.30.18.jpeg
