khanji254/FYP_2025_Recovery/images/all/Sketch_FC_circuit.jpeg

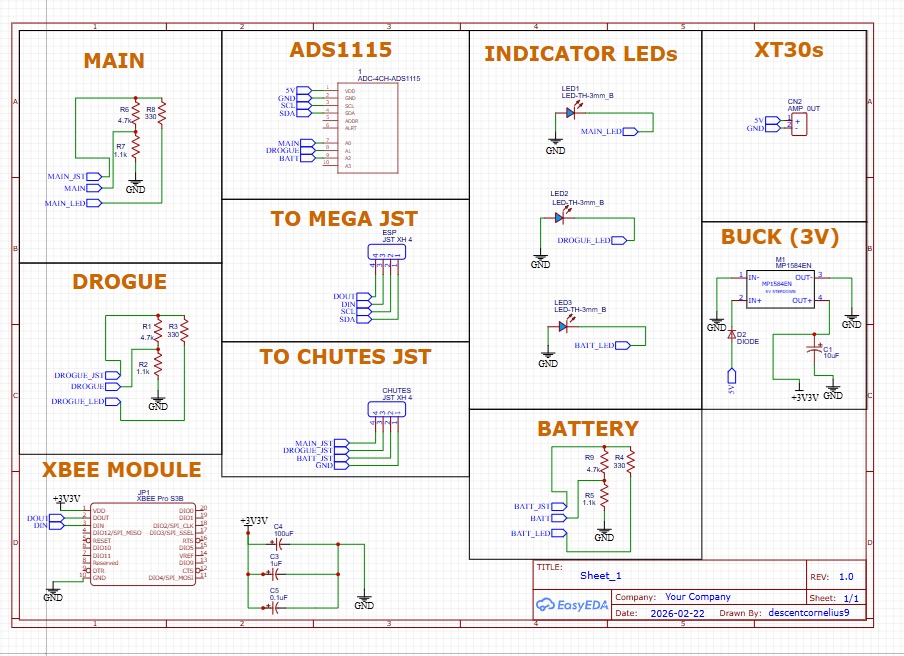
images/all/Sketch_FC_circuit.jpeg
