khanji254/FYP_2025_Recovery/images/all/WhatsApp Image 2026-02-24 at 14.29.40.jpeg

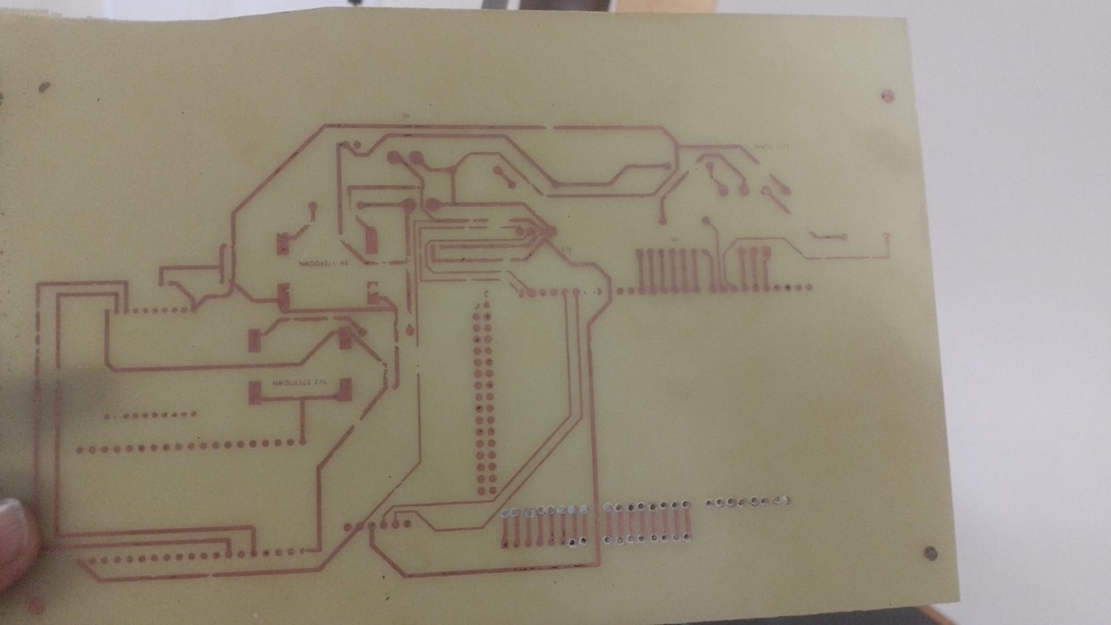
images/all/WhatsApp Image 2026-02-24 at 14.29.40.jpeg
