khanji254/FYP_2025_Recovery/images/all/WhatsApp Image 2026-02-25 at 14.21.57 (3).jpeg

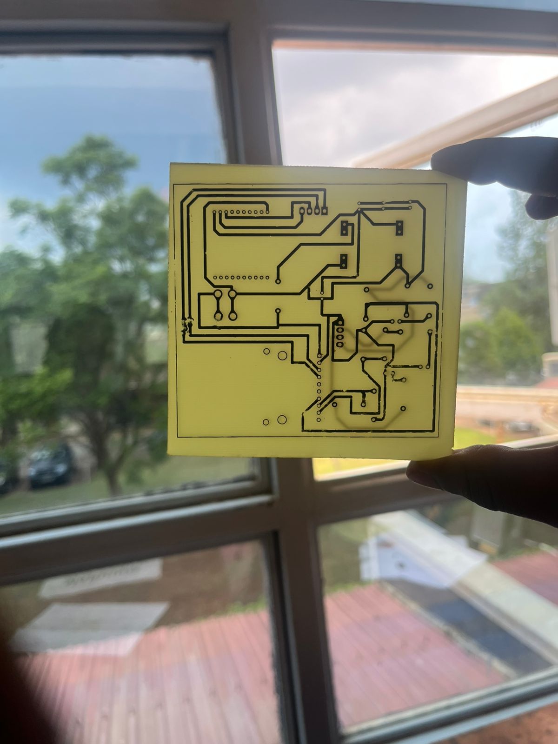
images/all/WhatsApp Image 2026-02-25 at 14.21.57 (3).jpeg
