khanji254/FYP_2025_Recovery/interim_report/images/all/Dimension_BS_.png

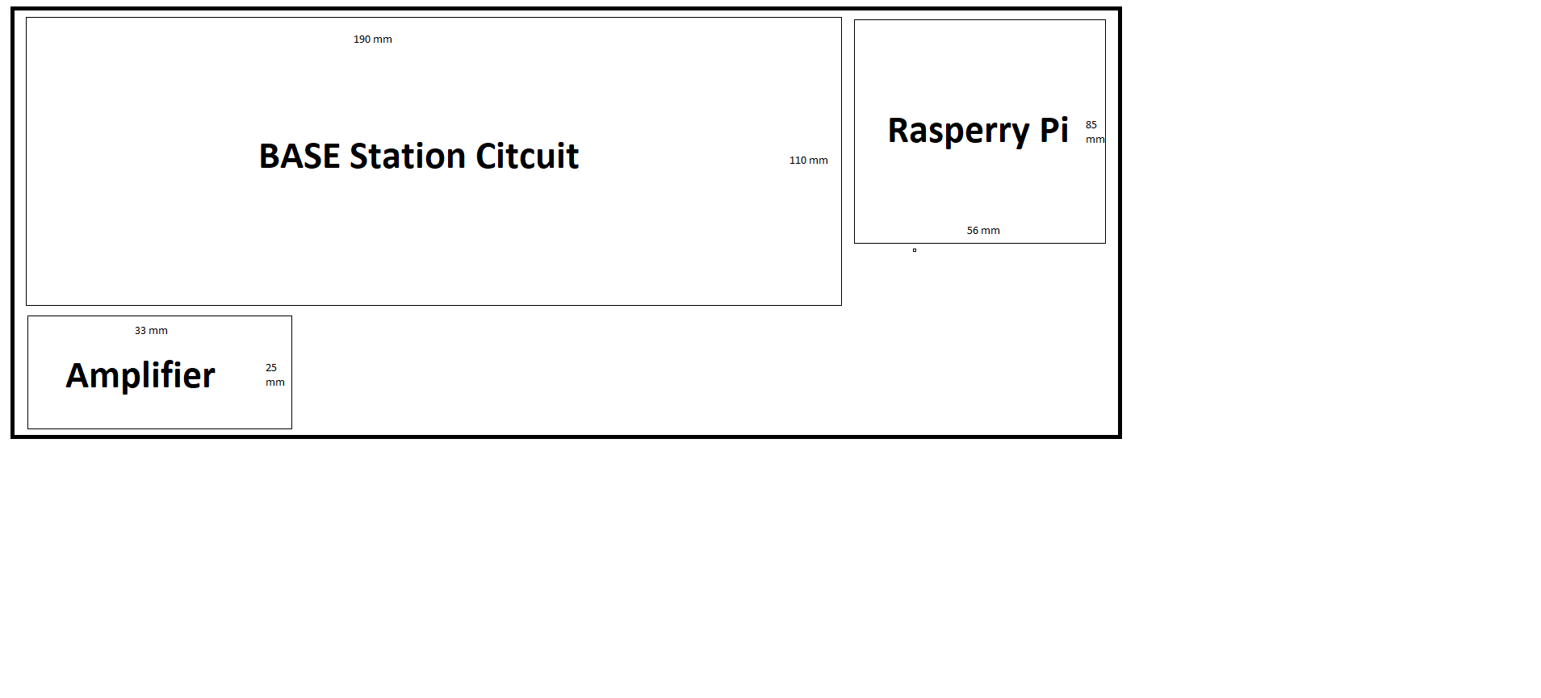
interim_report/images/all/Dimension_BS_.png
