khanji254/FYP_2025_Recovery/interim_report/images/all/dipole.PNG

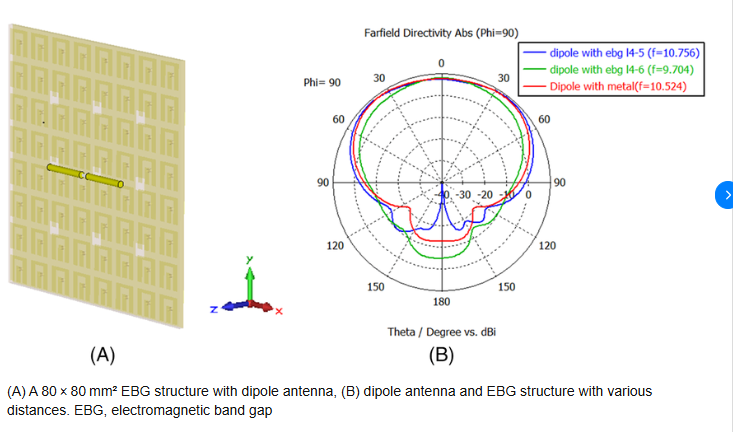
interim_report/images/all/dipole.PNG
