khanji254/FYP_2025_Recovery/interim_report/images/all/FC_Design.png

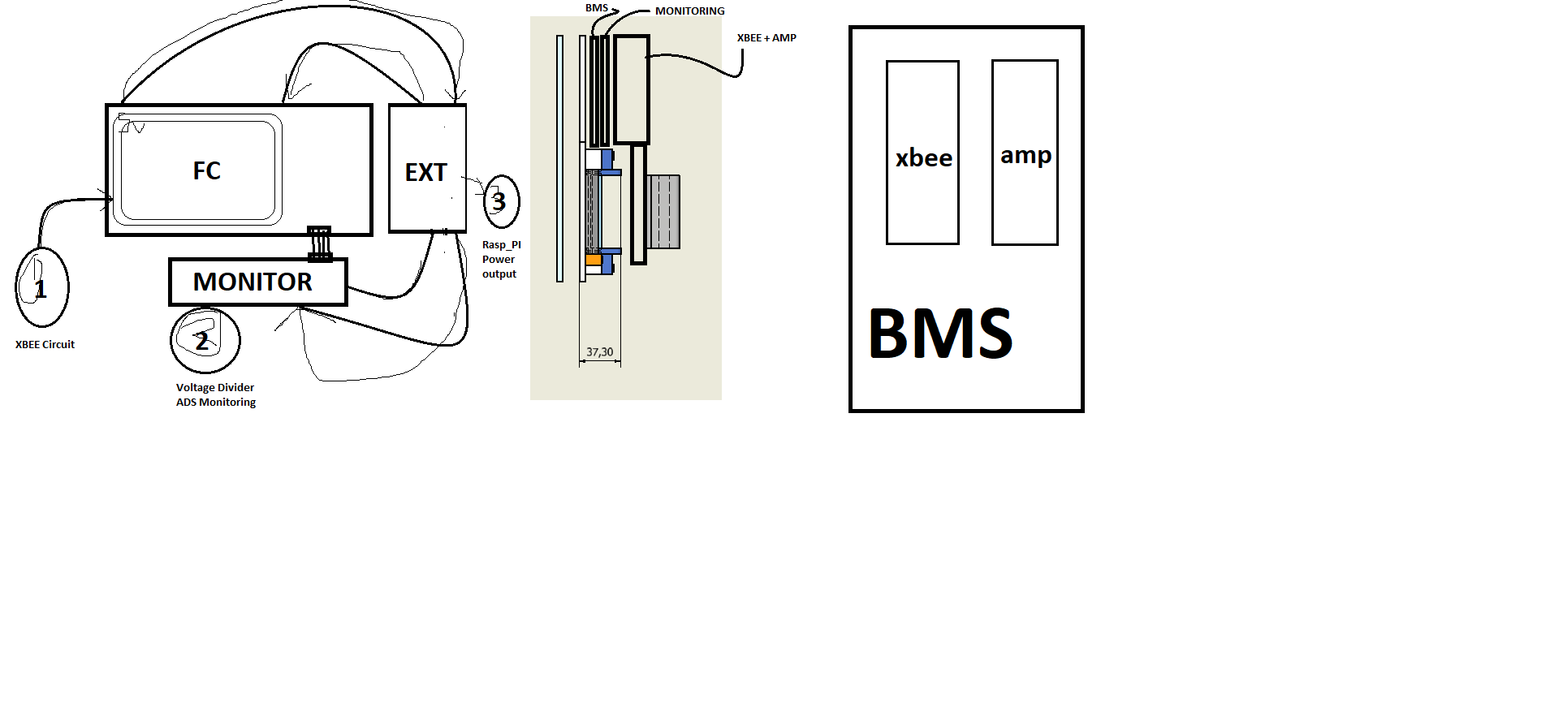
interim_report/images/all/FC_Design.png
