khanji254/FYP_2025_Recovery/interim_report/images/all/GCS_XBEE.png

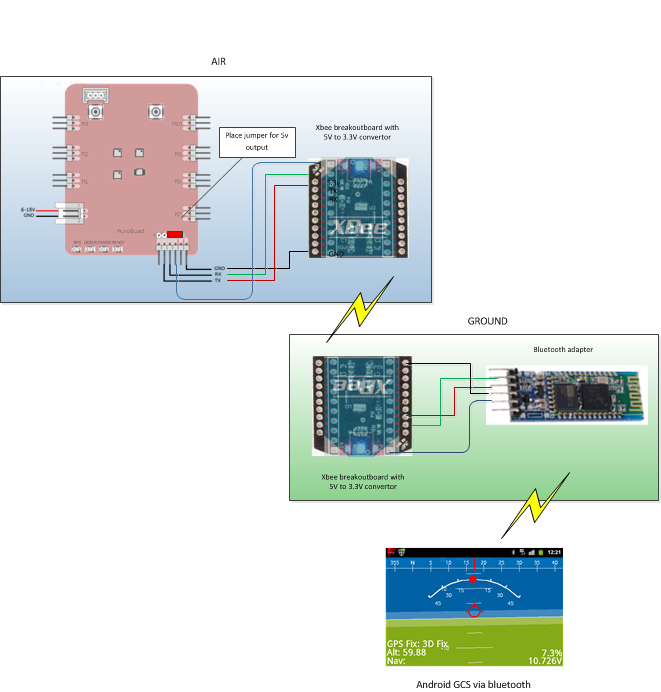
interim_report/images/all/GCS_XBEE.png
