khanji254/FYP_2025_Recovery/interim_report/images/all/Labeled/Battery_Allowance.PNG

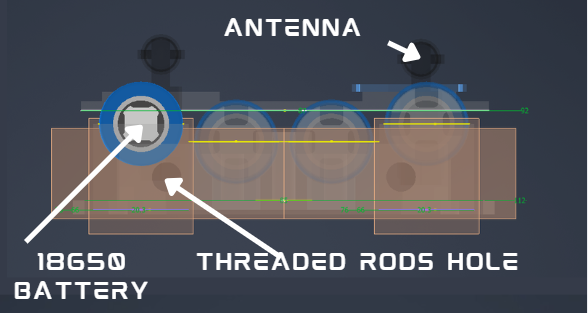
interim_report/images/all/Labeled/Battery_Allowance.PNG
