khanji254/FYP_2025_Recovery/interim_report/images/all/mechanical/Cross_sectional view of avionics bay .jpeg

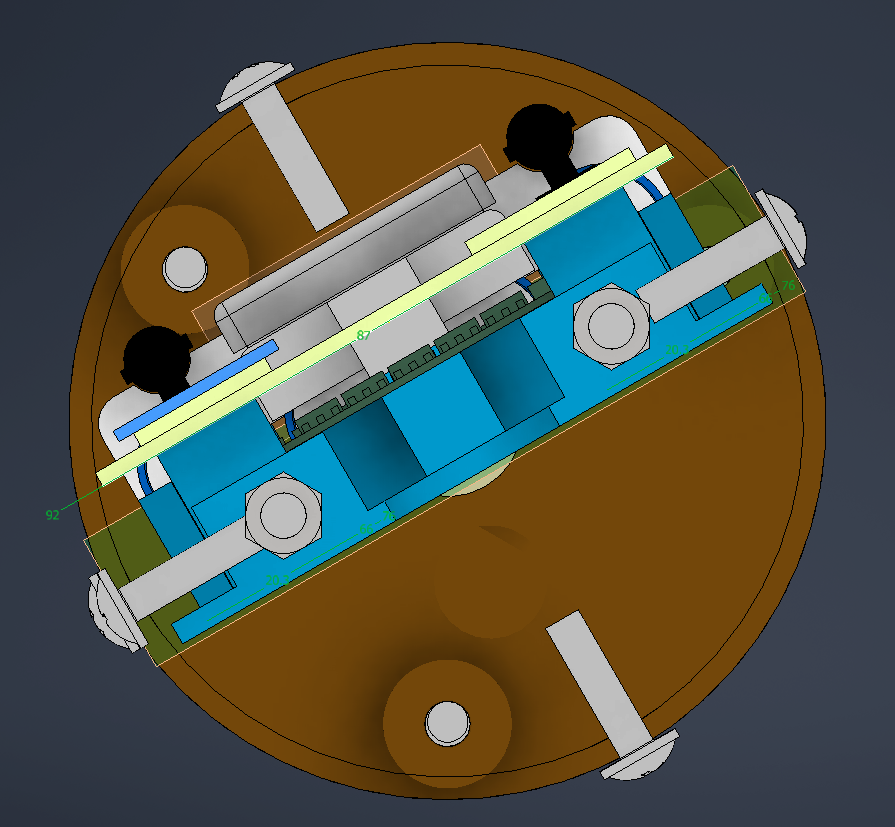
interim_report/images/all/mechanical/Cross_sectional view of avionics bay .jpeg
