khanji254/FYP_2025_Recovery/interim_report/images/all/WhatsApp Image 2026-02-25 at 14.21.57 (1).jpeg

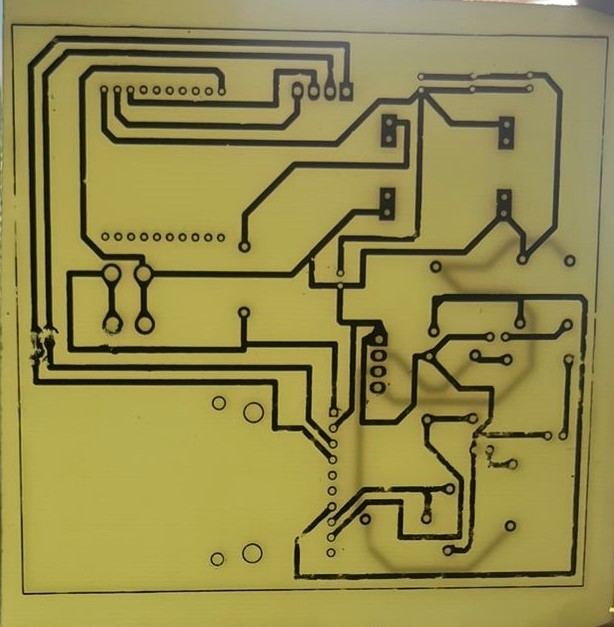
interim_report/images/all/WhatsApp Image 2026-02-25 at 14.21.57 (1).jpeg
