khanji254/FYP_2025_Recovery/interim_report/images/Detecting_Norminal_VoltagePNG.PNG

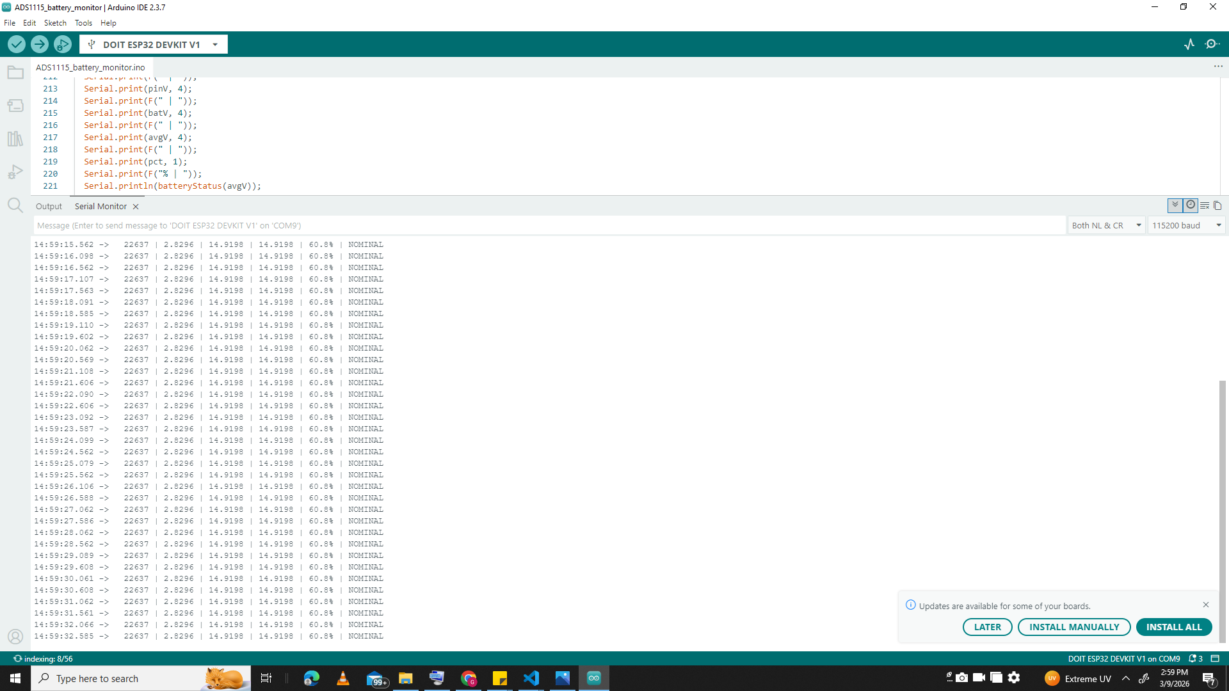
interim_report/images/Detecting_Norminal_VoltagePNG.PNG
