khanji254/FYP_2025_Recovery/interim_report/images/mechanical/Capture1.PNG

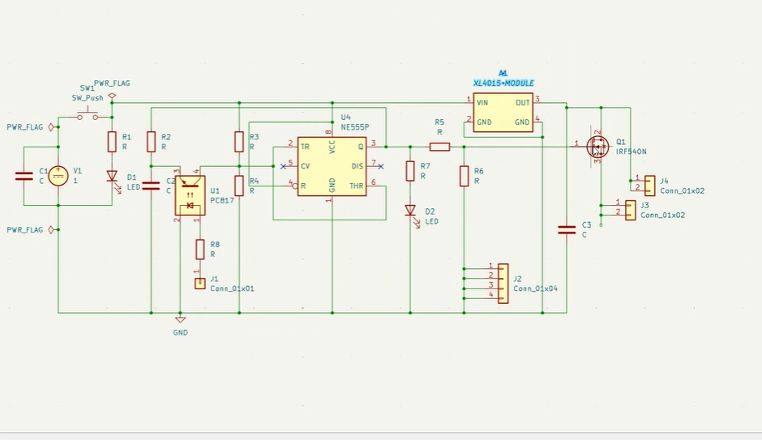
interim_report/images/mechanical/Capture1.PNG
