khanji254/FYP_2025_Recovery/interim_report/images/Newly_Updated_Basestation_Code.PNG

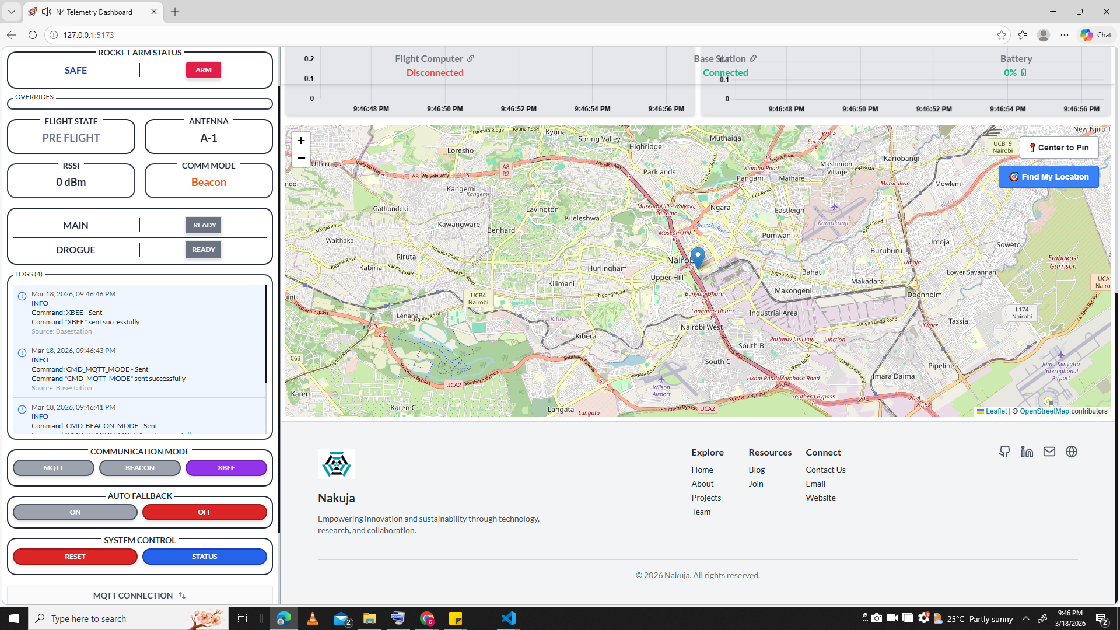
interim_report/images/Newly_Updated_Basestation_Code.PNG
