khanji254/FYP_2025_Recovery/project_proposal/images/WhatsApp Unknown 2026-02-27 at 18.25.51/Distortion_Of_Bot_Signals_dual telemetry.jpeg

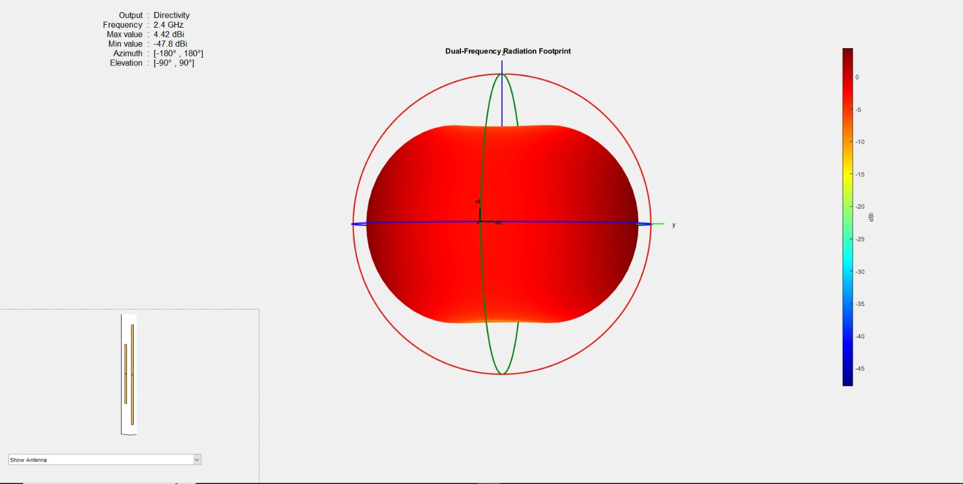
project_proposal/images/WhatsApp Unknown 2026-02-27 at 18.25.51/Distortion_Of_Bot_Signals_dual telemetry.jpeg
