khanji254/FYP_2025_Recovery/project_proposal/images/WhatsApp Unknown 2026-02-27 at 18.25.51/Signal distortion power against frequency.jpeg

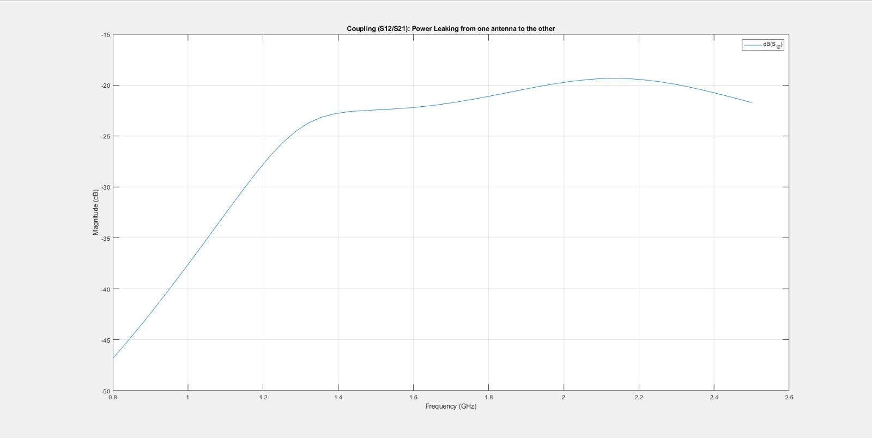
project_proposal/images/WhatsApp Unknown 2026-02-27 at 18.25.51/Signal distortion power against frequency.jpeg
