khanji254/FYP_2025_Recovery/project_proposal/images/WhatsApp Unknown 2026-02-27 at 18.25.51/WhatsApp Image 2026-02-25 at 14.35.17.jpeg

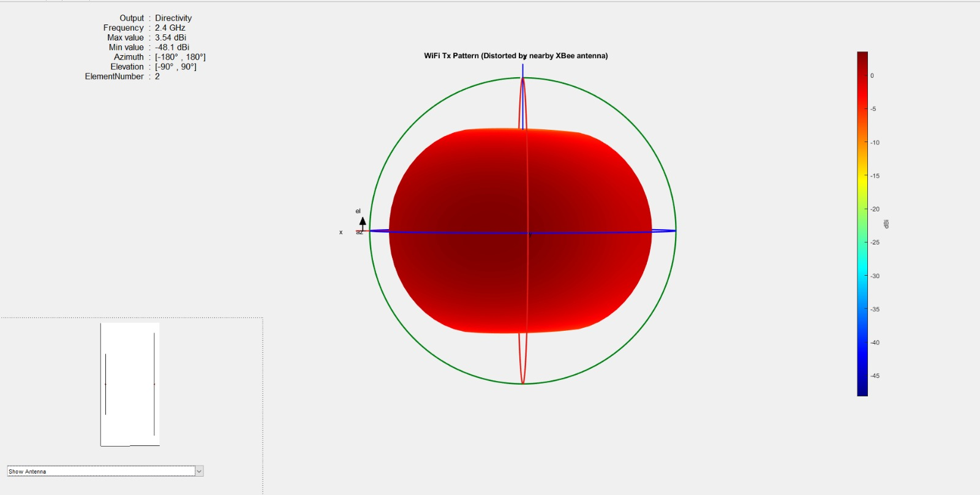
project_proposal/images/WhatsApp Unknown 2026-02-27 at 18.25.51/WhatsApp Image 2026-02-25 at 14.35.17.jpeg
