khanji254/FYP_2025_Recovery/project_proposal/images/WhatsApp Unknown 2026-02-27 at 18.25.51/xbee_Tx_Distorted_y_WIFI_Antenna.jpeg

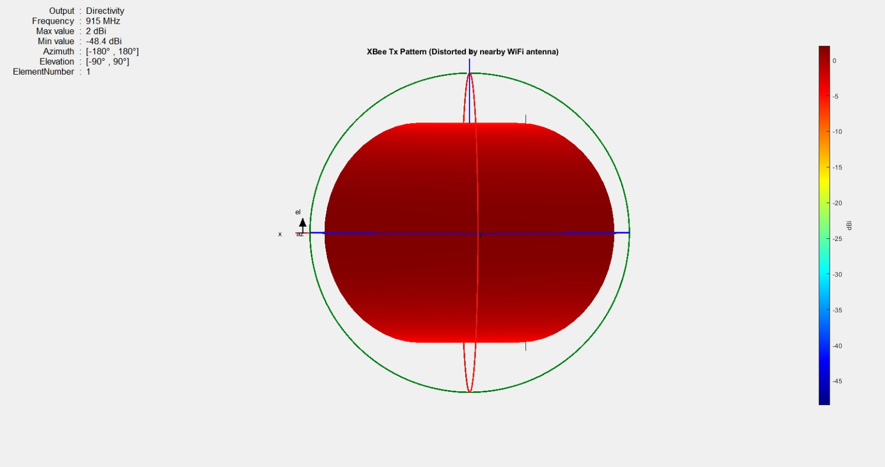
project_proposal/images/WhatsApp Unknown 2026-02-27 at 18.25.51/xbee_Tx_Distorted_y_WIFI_Antenna.jpeg
