khanji254/FYP_2025_Recovery/(list of files, cad)

Other CAD files:
images/all/full avionics bay.dwg
images/all/mechanical/FC_Holder_Print.dwg
interim_report/images/all/mid_Batt.dwg
images/all/mid_Batt.dwg
images/all/18650_case.dwg
images/all/OldVersions/full avionics bay.0002.dwg
interim_report/images/Labeled/full avionics bay.ipn
project_proposal/images/cad/FC_Holder.iam
