khanji254/FYP_2025_Recovery/images/all/mechanical/Avionics assembly.jpeg

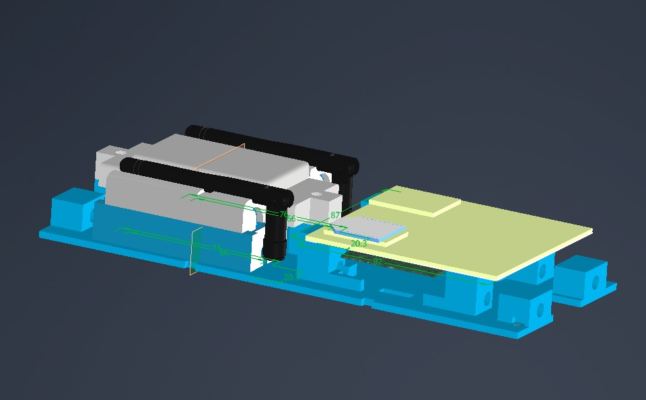
images/all/mechanical/Avionics assembly.jpeg
