khanji254/FYP_2025_Recovery/interim_report/images/3d_printing/print_settings.PNG

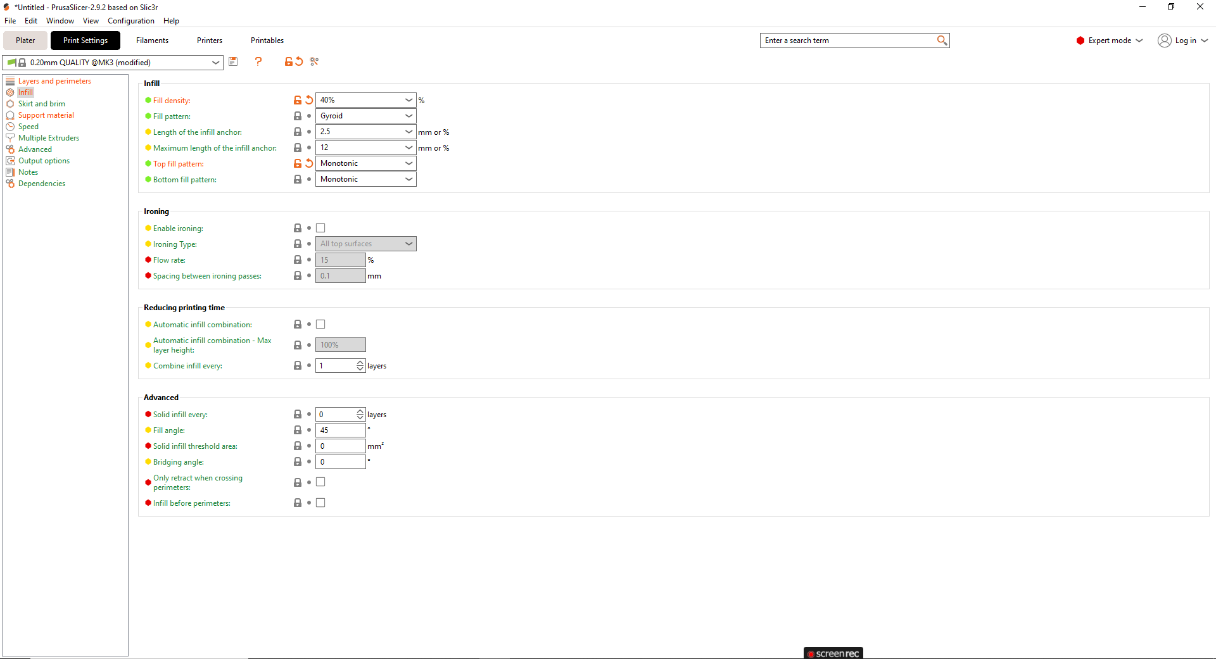
interim_report/images/3d_printing/print_settings.PNG
