khanji254/FYP_2025_Recovery/interim_report/images/3d_printing/sliced.PNG

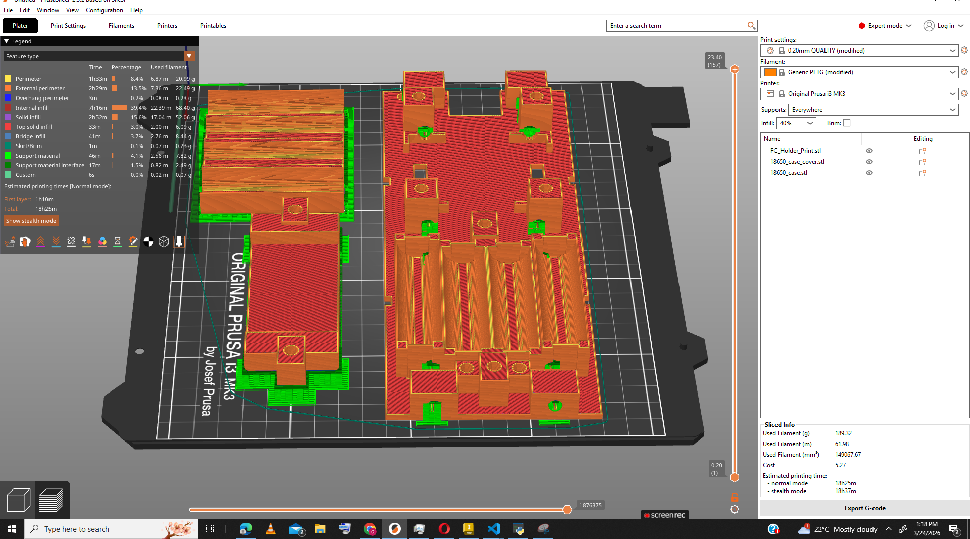
interim_report/images/3d_printing/sliced.PNG
