khanji254/FYP_2025_Recovery/interim_report/images/all/Final FC soldered circuit.jpeg

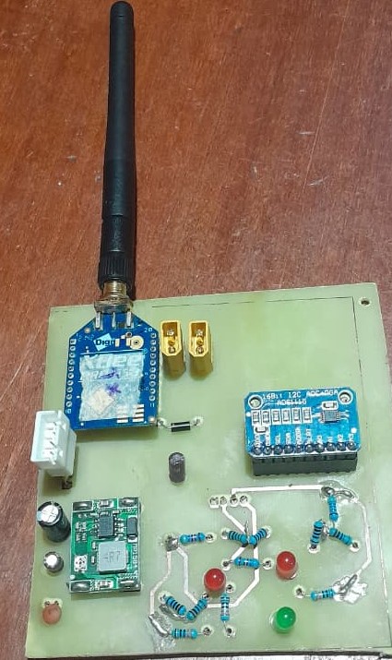
interim_report/images/all/Final FC soldered circuit.jpeg
