khanji254/FYP_2025_Recovery/interim_report/images/Battery_Monitoring_Unit_Test.PNG

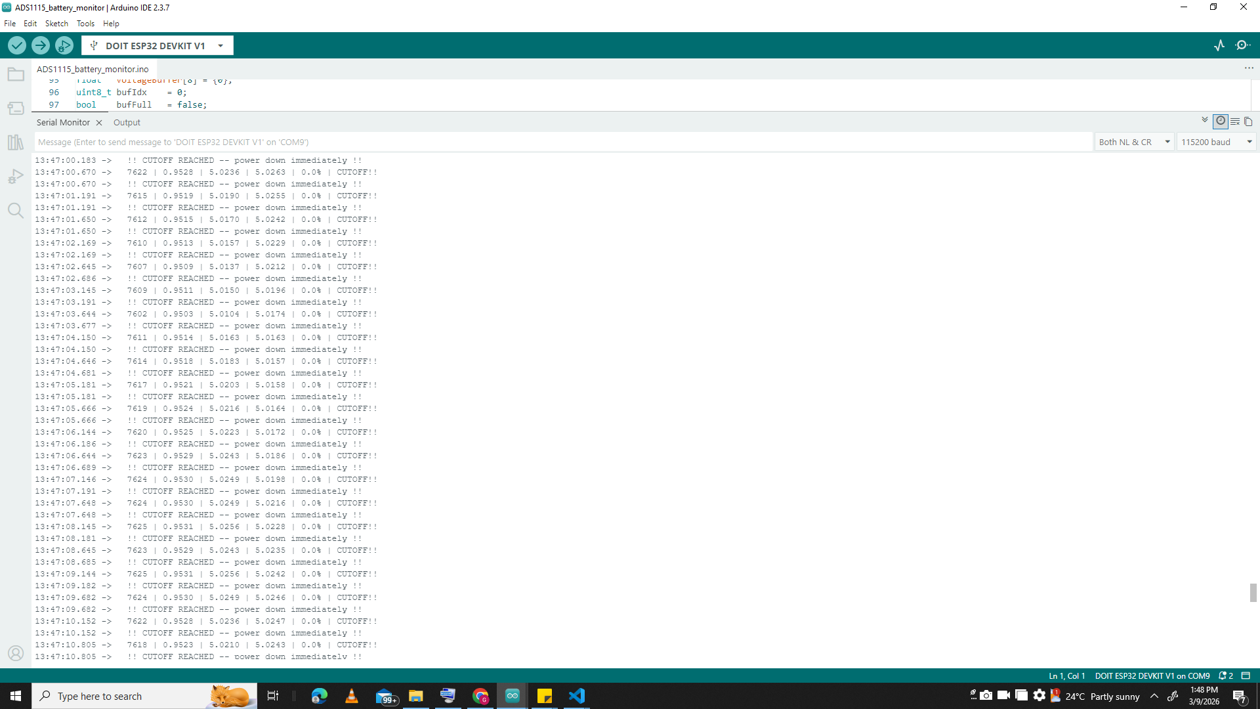
interim_report/images/Battery_Monitoring_Unit_Test.PNG
