khanji254/FYP_2025_Recovery/images/all/The Crimson Powder Problem.PNG

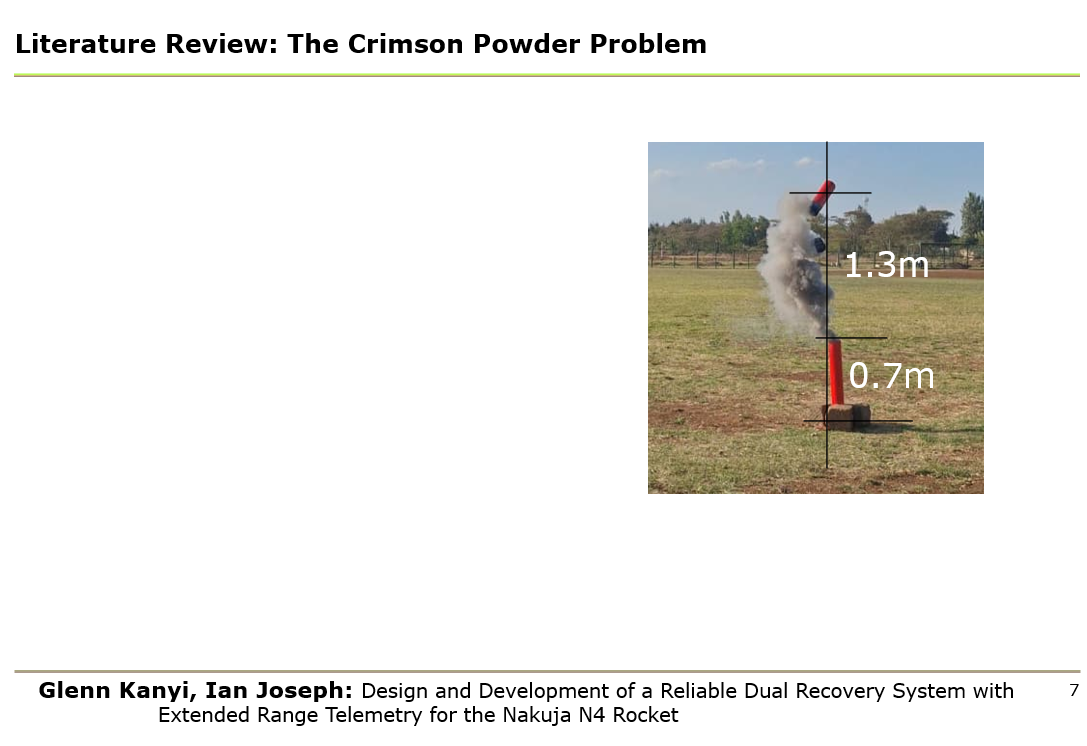
images/all/The Crimson Powder Problem.PNG
