khanji254/FYP_2025_Recovery/interim_report/images/all/Labeled/full avionics bay parts list with title block.pdf

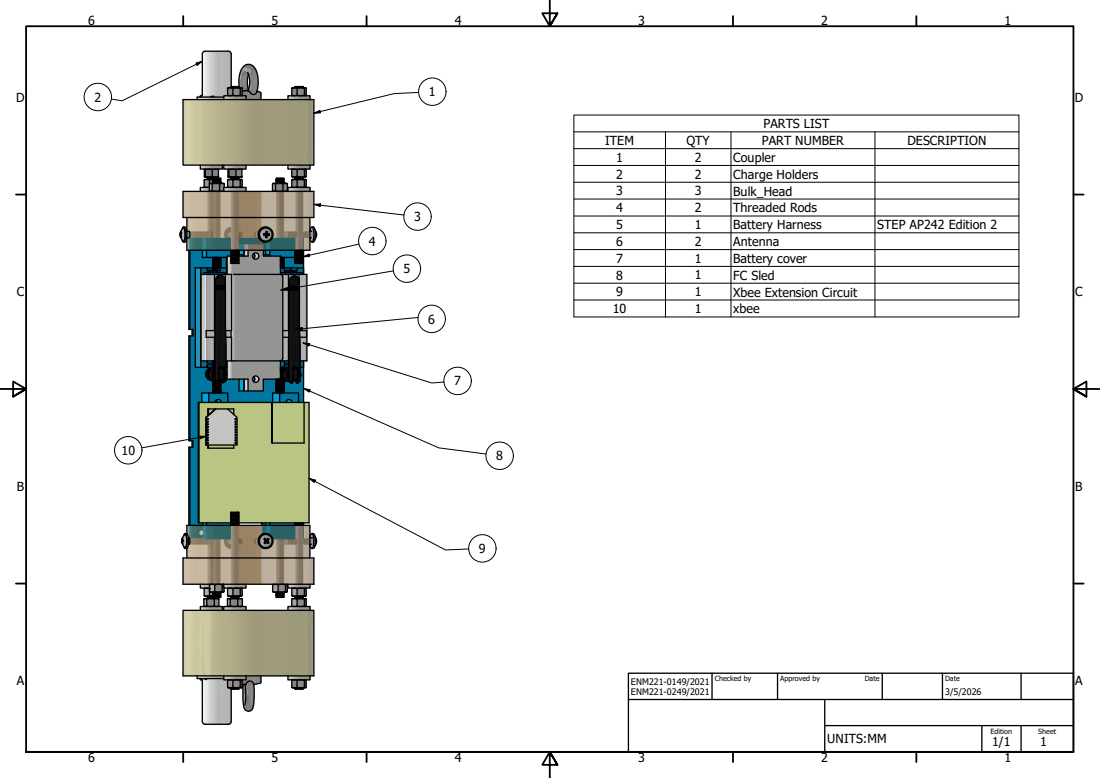
[picture p228: page 1]
PARTS LIST; Checked by; Approved by; Date

ITEM | QTY | PART NUMBER | DESCRIPTION
1 | 2 | Coupler
2 | 2 | Charge Holders
3 | 3 | Bulk_Head
4 | 2 | Threaded Rods
5 | 1 | Battery Harness | STEP AP242 Edition 2
6 | 2 | Antenna
7 | 1 | Battery cover
8 | 1 | FC Sled
9 | 1 | Xbee Extension Circuit
10 | 1 | xbee
