khanji254/FYP_2025_Recovery/images/all/mechanical/18650_case_cover.pdf

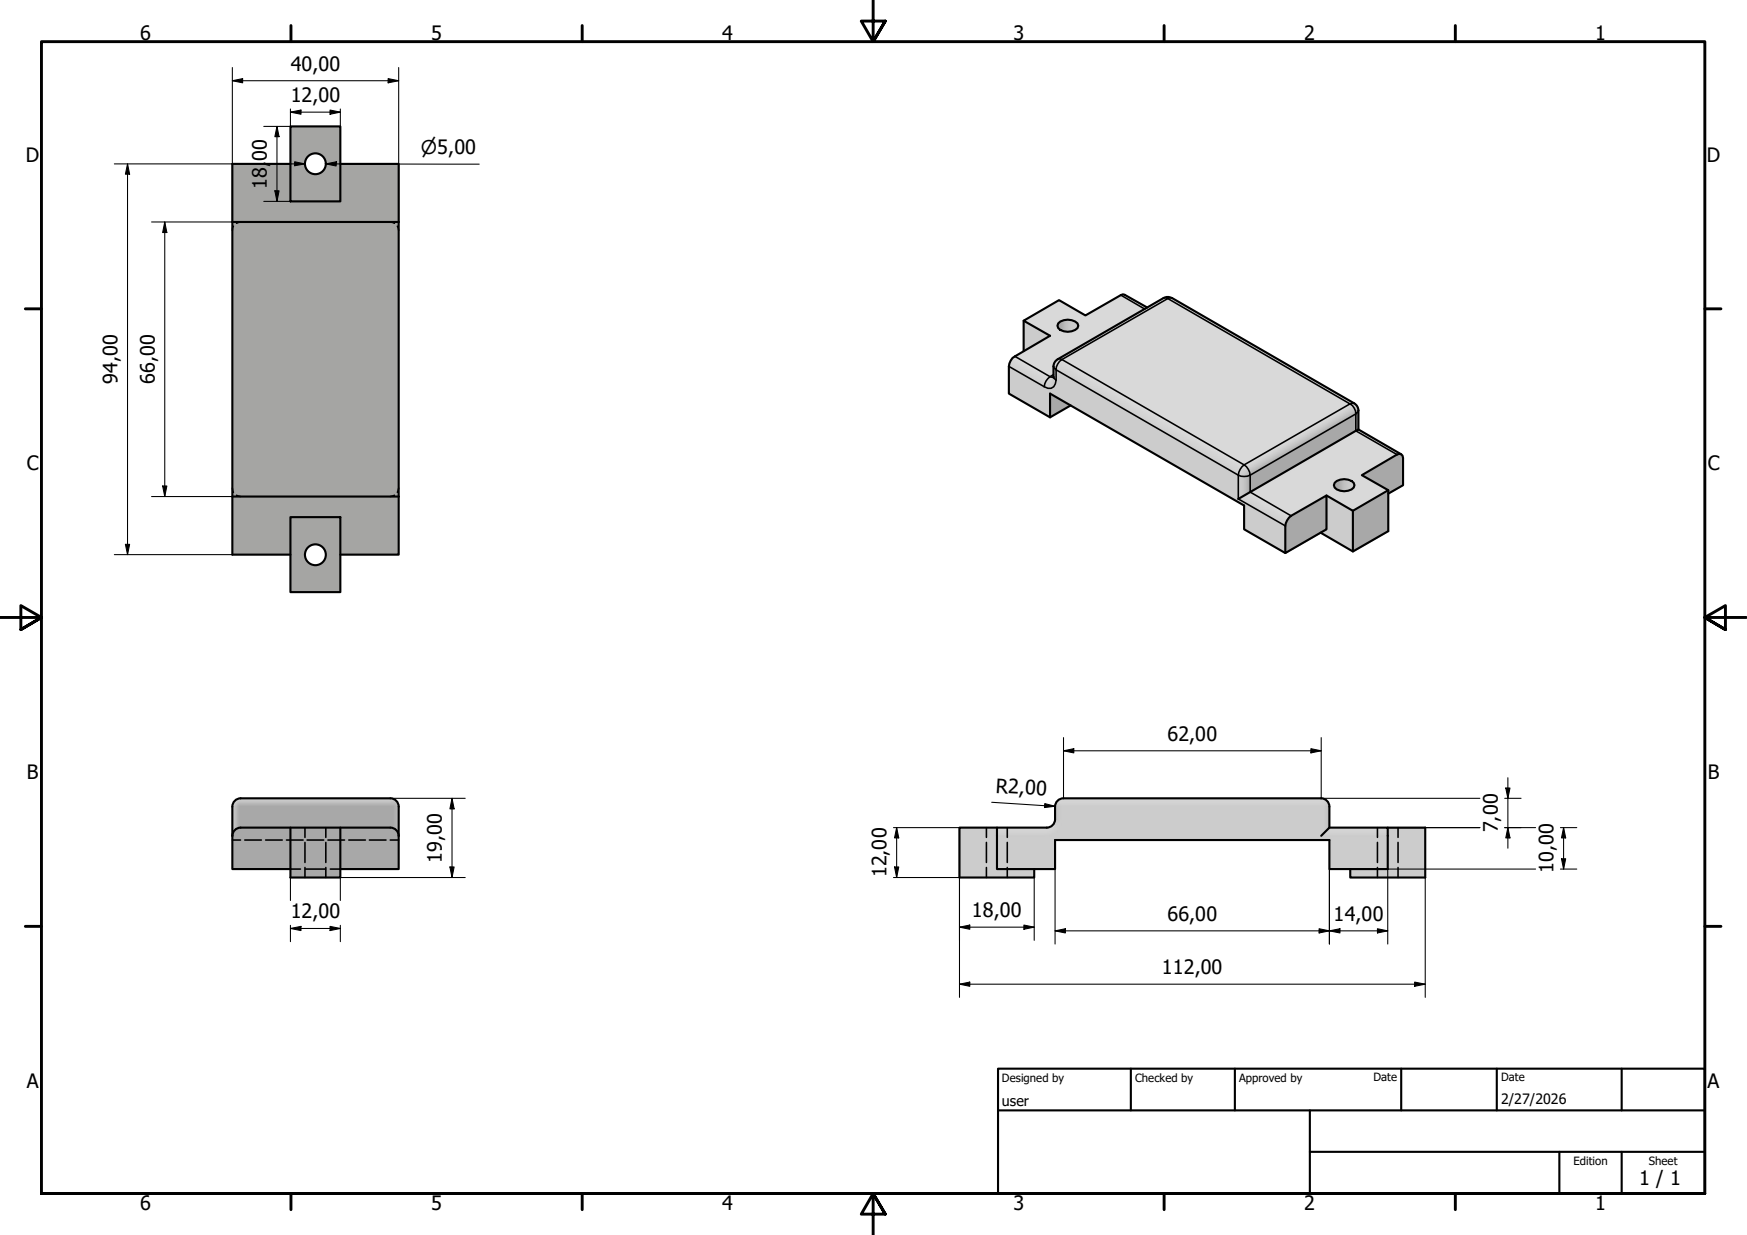
[picture p229: page 1]
Designed by; Checked by; Approved by; Date
