khanji254/FYP_2025_Recovery/images/all/mechanical/18650_case_local_backup.pdf

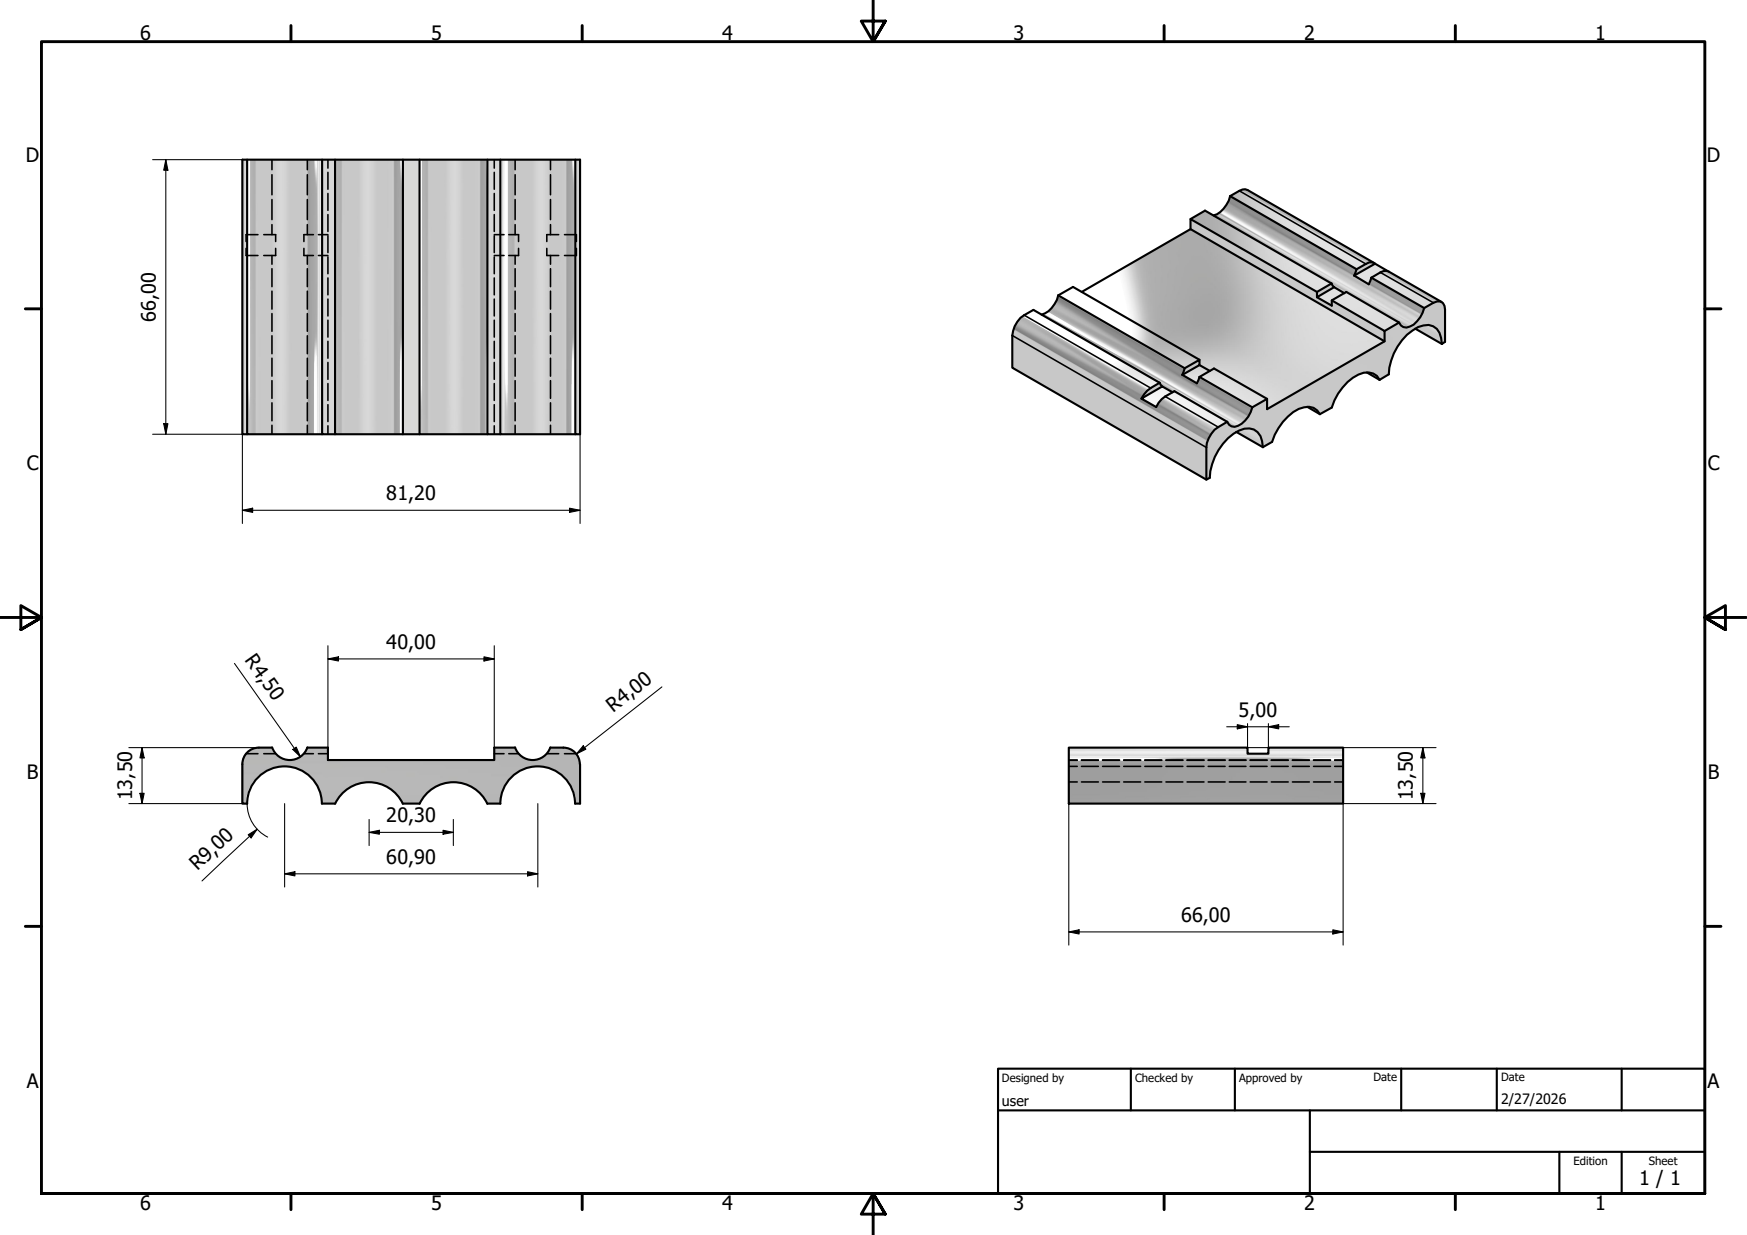
[picture p230: page 1]
Designed by; Checked by; Approved by; Date
