khanji254/FYP_2025_Recovery/images/all/mechanical/Edge_Batt.pdf

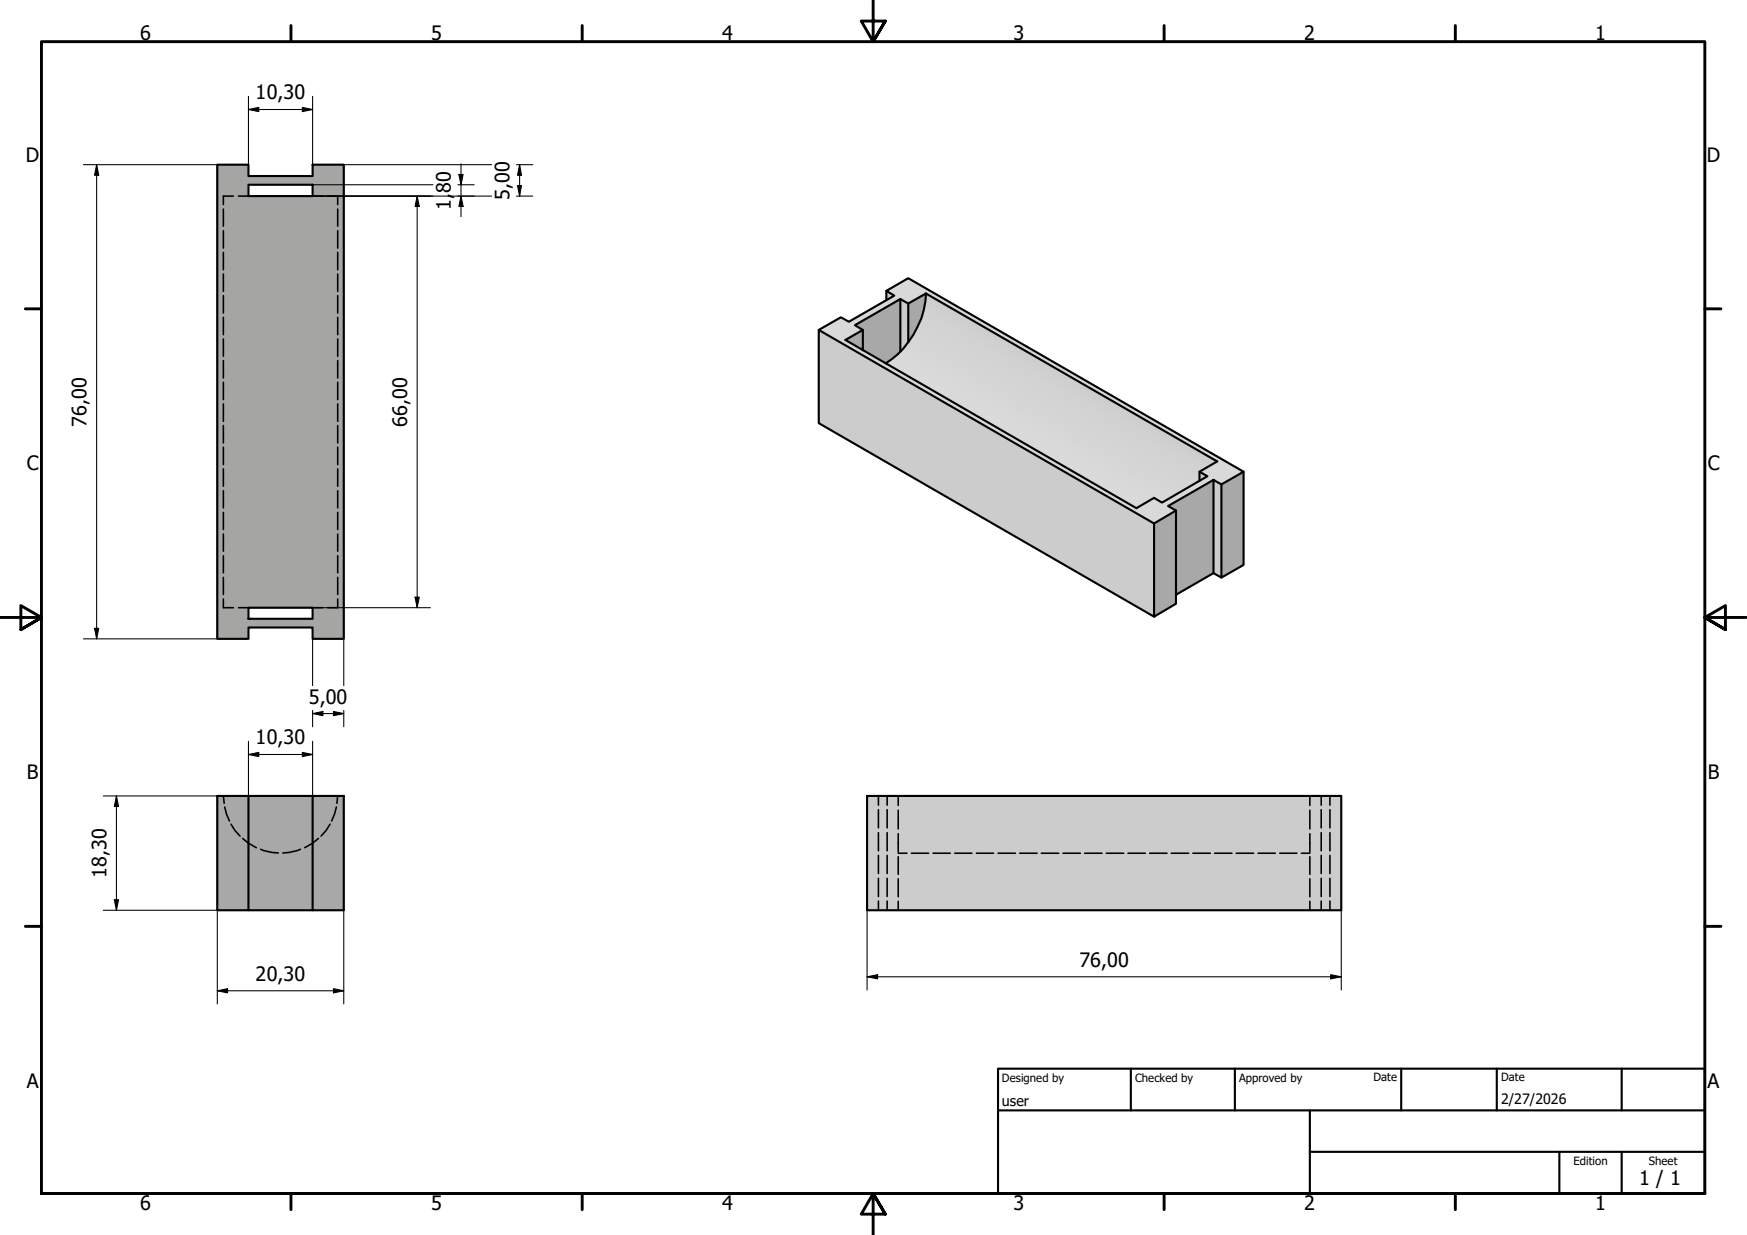
[picture p231: page 1]
Designed by; Checked by; Approved by; Date
