khanji254/FYP_2025_Recovery/images/all/mechanical/mid_Batt.pdf

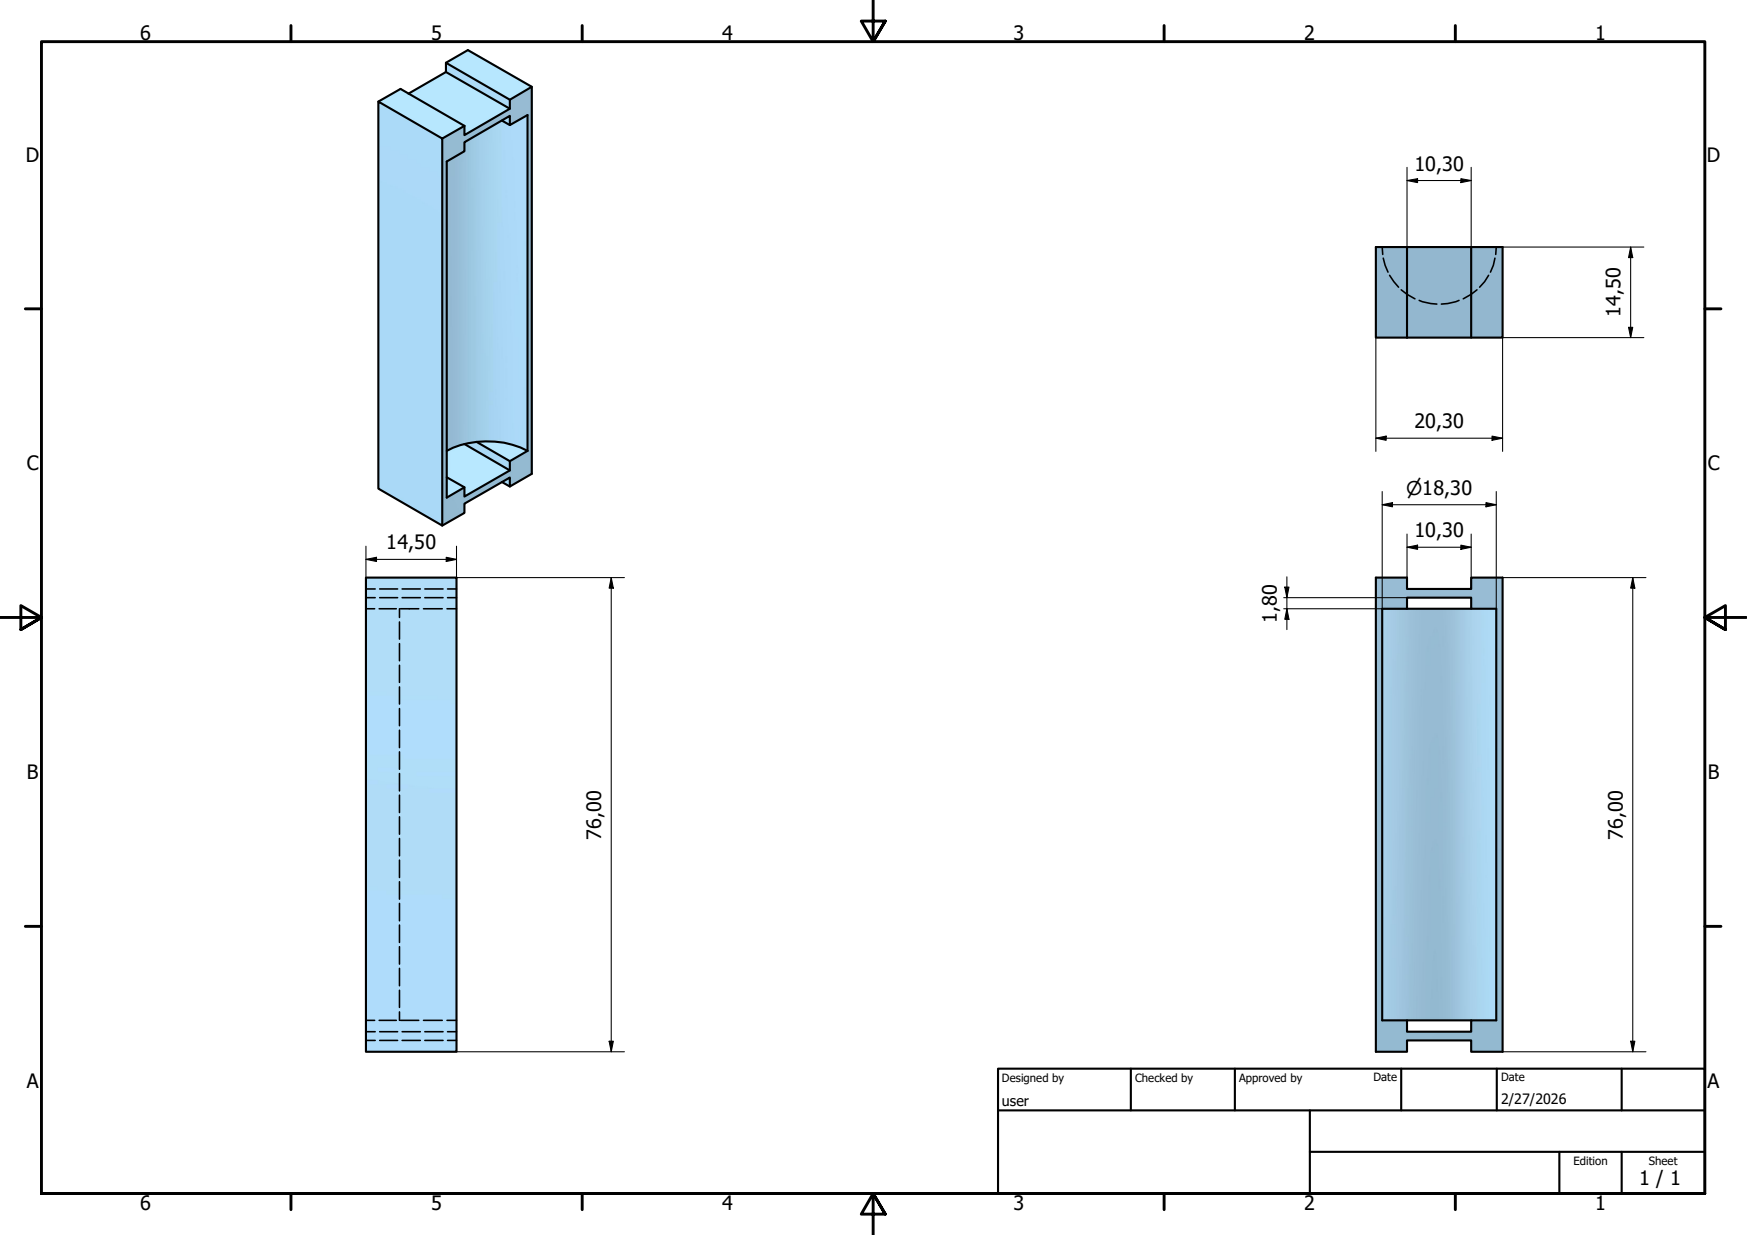
[picture p232: page 1]
Designed by; Checked by; Approved by; Date
