khanji254/FYP_2025_Recovery/(list of files, drawings)

Other design files:
project_proposal/context/Chute_Monitoring_and_Battery_Management.pdsprj
project_proposal/context/Project Backups/Chute_Monitoring_and_Battery_Management [20260216, 23-19-15].pdsprj
project_proposal/context/Project Backups/Chute_Monitoring_and_Battery_Management [20260308, 11-31-36].pdsprj
project_proposal/context/Project Backups/Chute_Monitoring_and_Battery_Management [20260308, 13-03-37].pdsprj
project_proposal/images/cad/circit.fzz
