khanji254/FYP_2025_Recovery/(commit log)

2026-01-27 Adding images
    [FC_Holder.iam]
2026-01-29 added the designs
    [Chute_Monitoring_and_Battery_Management.pdsprj]
2026-02-23 Add project proposal updates
    [Chute_Monitoring_and_Battery_Management [20260216, 23-19-15].pdsprj, Chute_Monitoring_and_Battery_Management.pdsprj]
2026-02-27 first draft for report
    [mid_Batt.dwg]
2026-03-02 sending images
    [18650_case.dwg, FC_Holder_Print.dwg, mid_Batt.dwg]
2026-03-05 Updating documentation to interim presentable report
    [circit.fzz, full avionics bay.0002.dwg, full avionics bay.dwg]
2026-04-07 added more edits
    [18650_case.dwg, Chute_Monitoring_and_Battery_Management [20260308, 11-31-36].pdsprj, Chute_Monitoring_and_Battery_Management [20260308, 13-03-37].pdsprj, Chute_Monitoring_and_Battery_Management.pdsprj, FC_Holder_Print.dwg, full avionics bay.0002.dwg, full avionics bay.dwg, full avionics bay.ipn]
